coderlazar/Metta-Pet/Tervrajzok/3D összes/préselő mozgatás.png

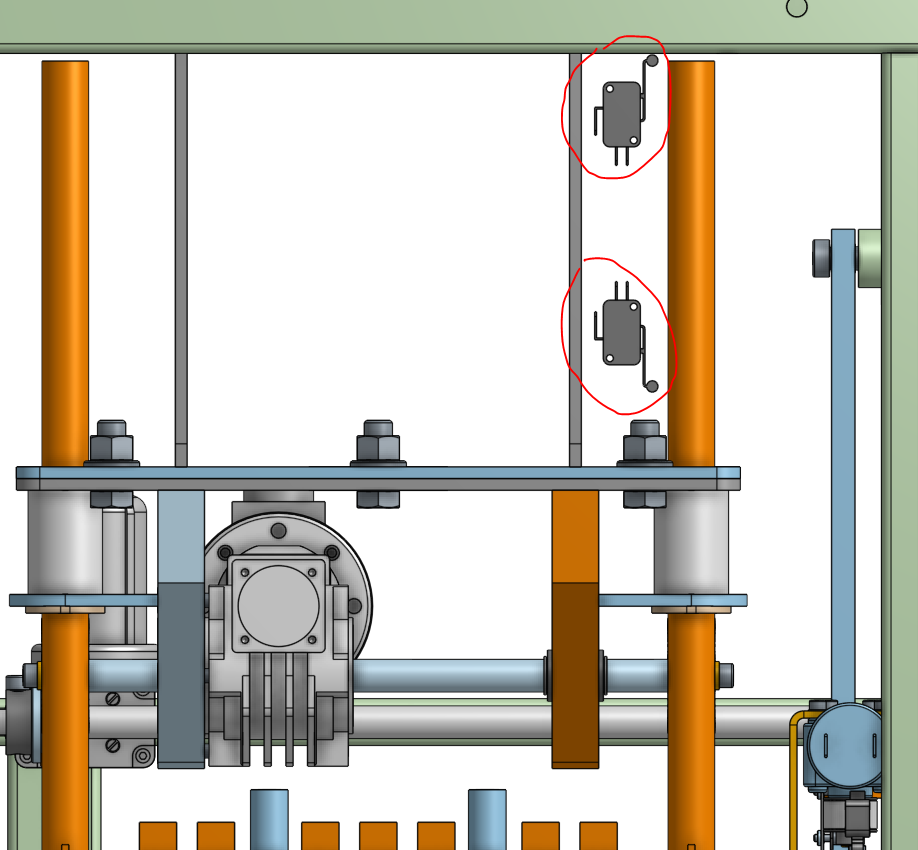
Tervrajzok/3D összes/préselő mozgatás.png
