coderlazar/Metta-Pet/Tervrajzok/külső desygn, animáció/Terv digitális modell.jpg

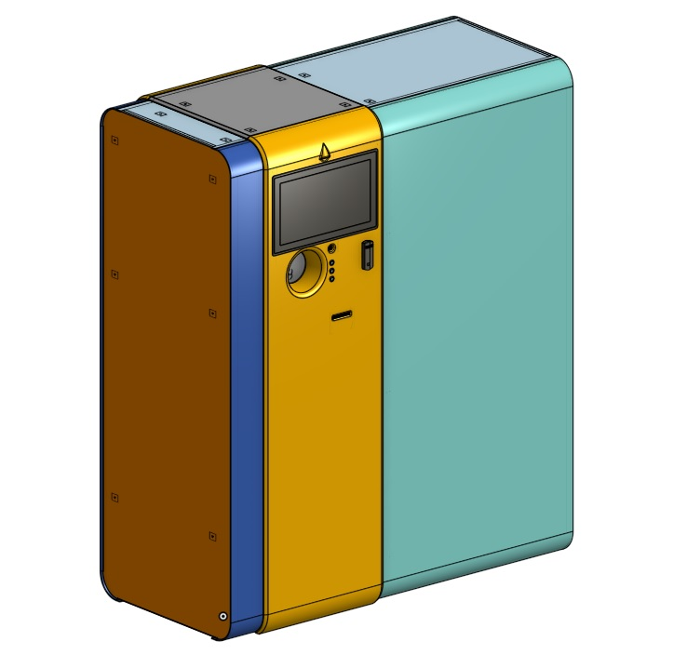
Tervrajzok/külső desygn, animáció/Terv digitális modell.jpg
