coderlazar/Metta-Pet/Tervrajzok/3D összes/petpalackátvevő berendezés digitális terv.docx

https://cad.onshape.com/documents/b69a13354509ceb9c475daa1/v/0fe93e5b4b65e45215f86a12/e/35e4c57dc199d21a8d1f46de
