coderlazar/Metta-Pet/Tervrajzok/módositások/prés perselyezés átdolgozás.pdf

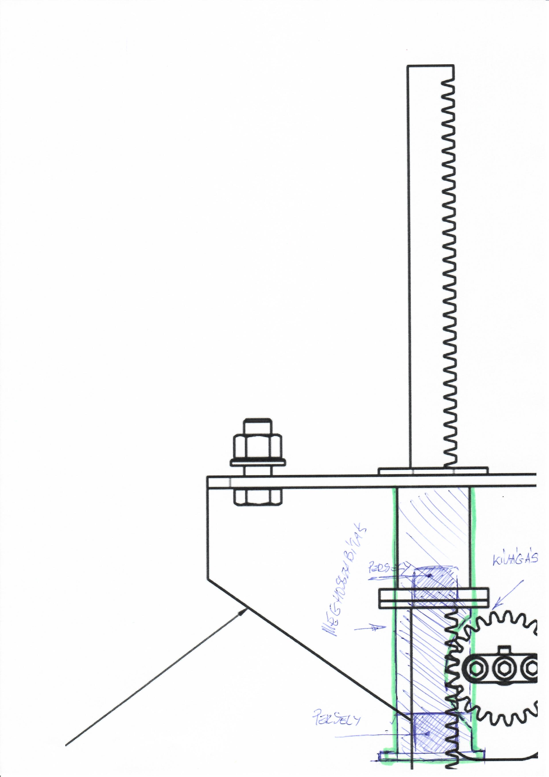
[picture p4: page 1]
