coderlazar/Metta-Pet/Tervrajzok/külső desygn, animáció/külső méretek lárványtervhez.pdf

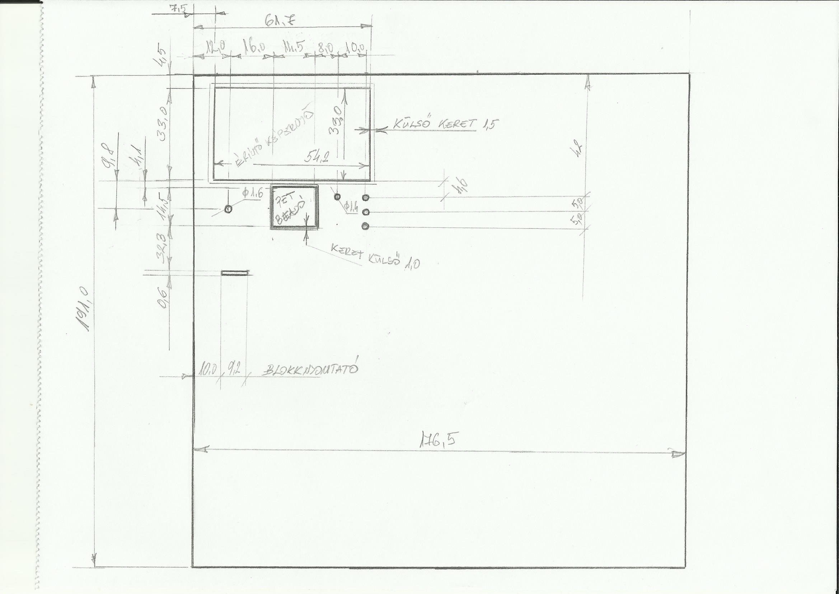
[picture p5: page 1]
