coderlazar/Metta-Pet/Tervrajzok/külső desygn, animáció/mettapet_valtozatok logo és gépmegjelenés.pdf

# METTA PET

# logo + grakai megjelenés

# logo változat 01

metta pet | metta pet | metta pet

metta pet | metta pet | metta pet

metta pet | metta pet | metta pet

# metta p e t

# metta p e t

# metta p e t

e | e | e | e | e | e

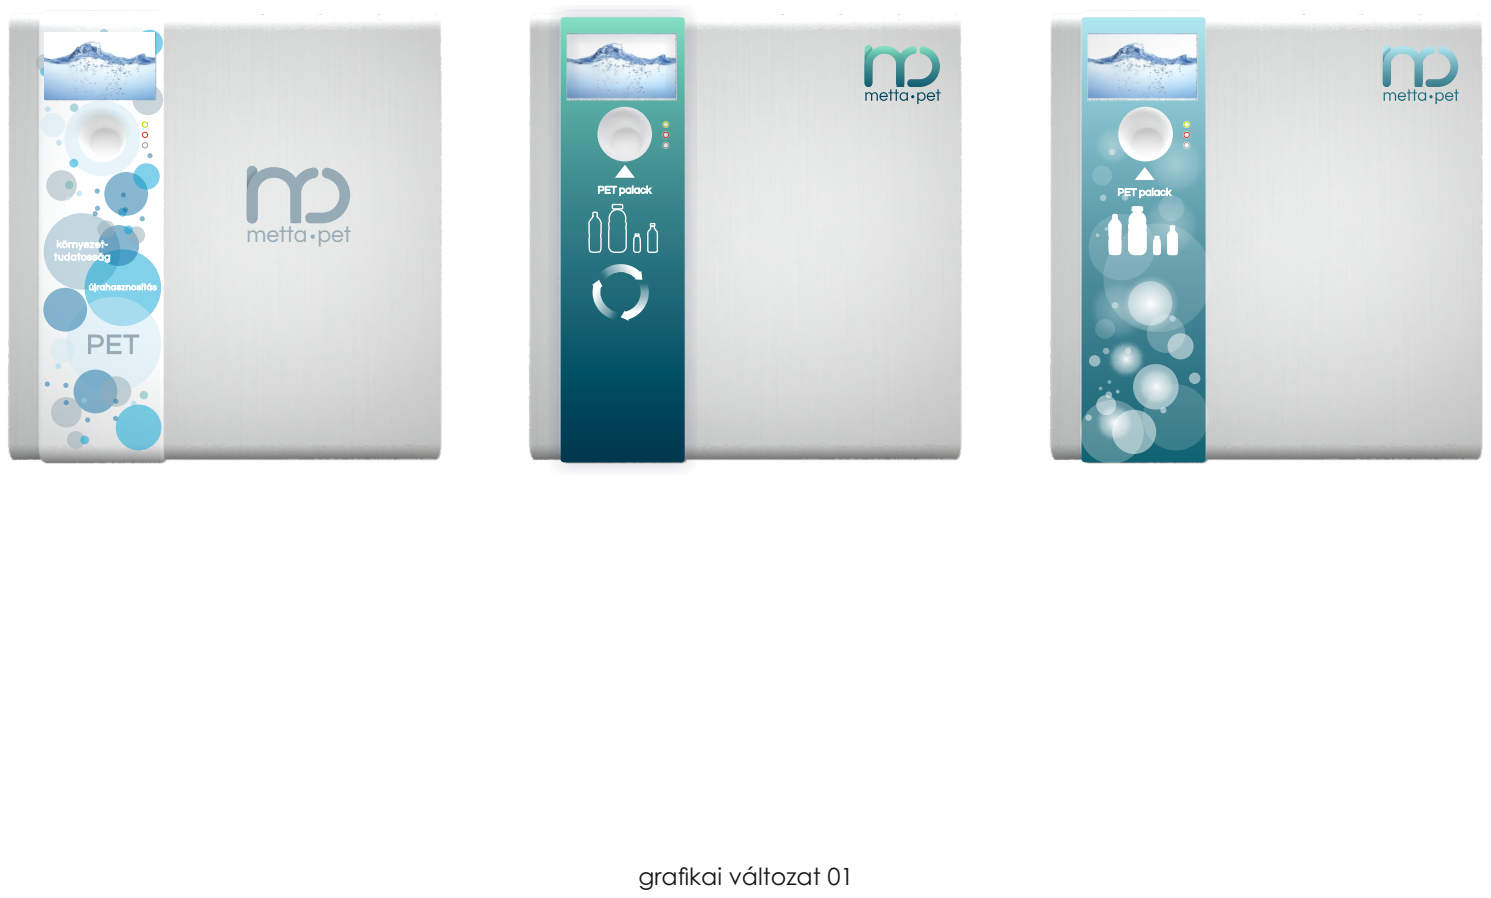
[picture p6: page 7]
PET palack; újrahasznosítás; PET; környezet- tudatosság; metta pet

grakai változat 01

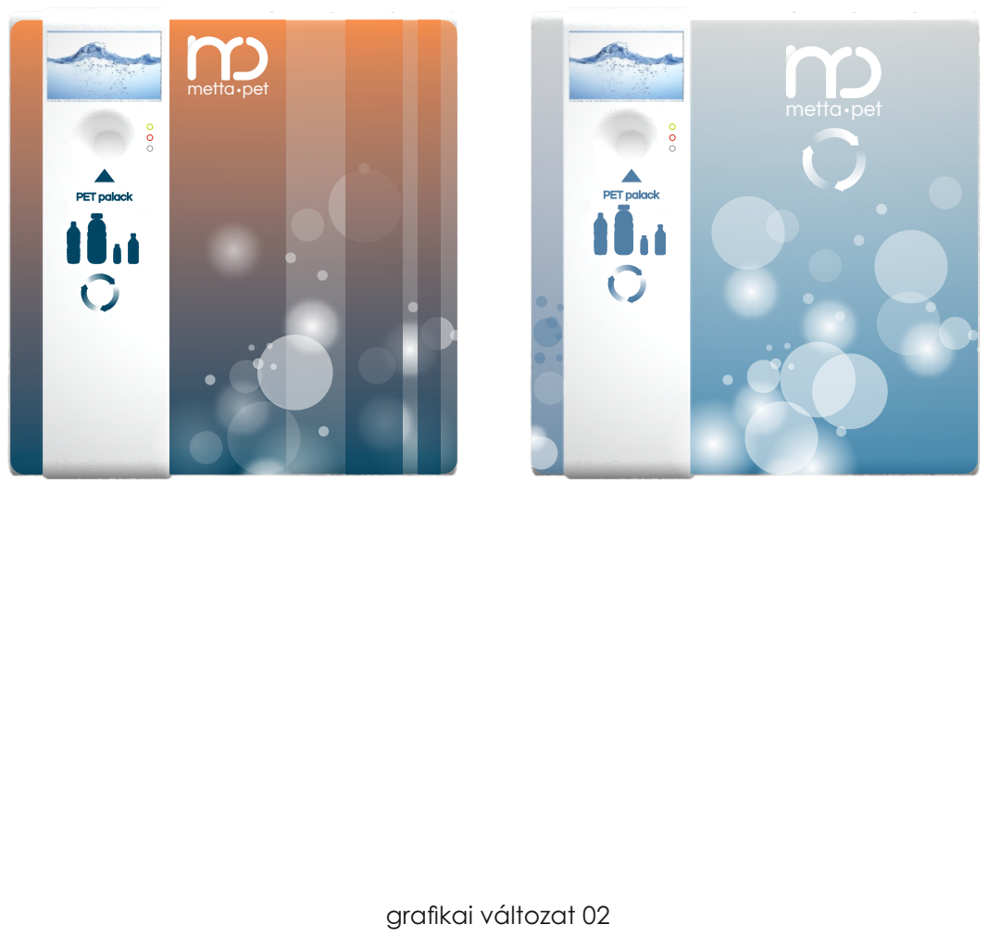
[picture p7: page 8]
PET palack; metta pet

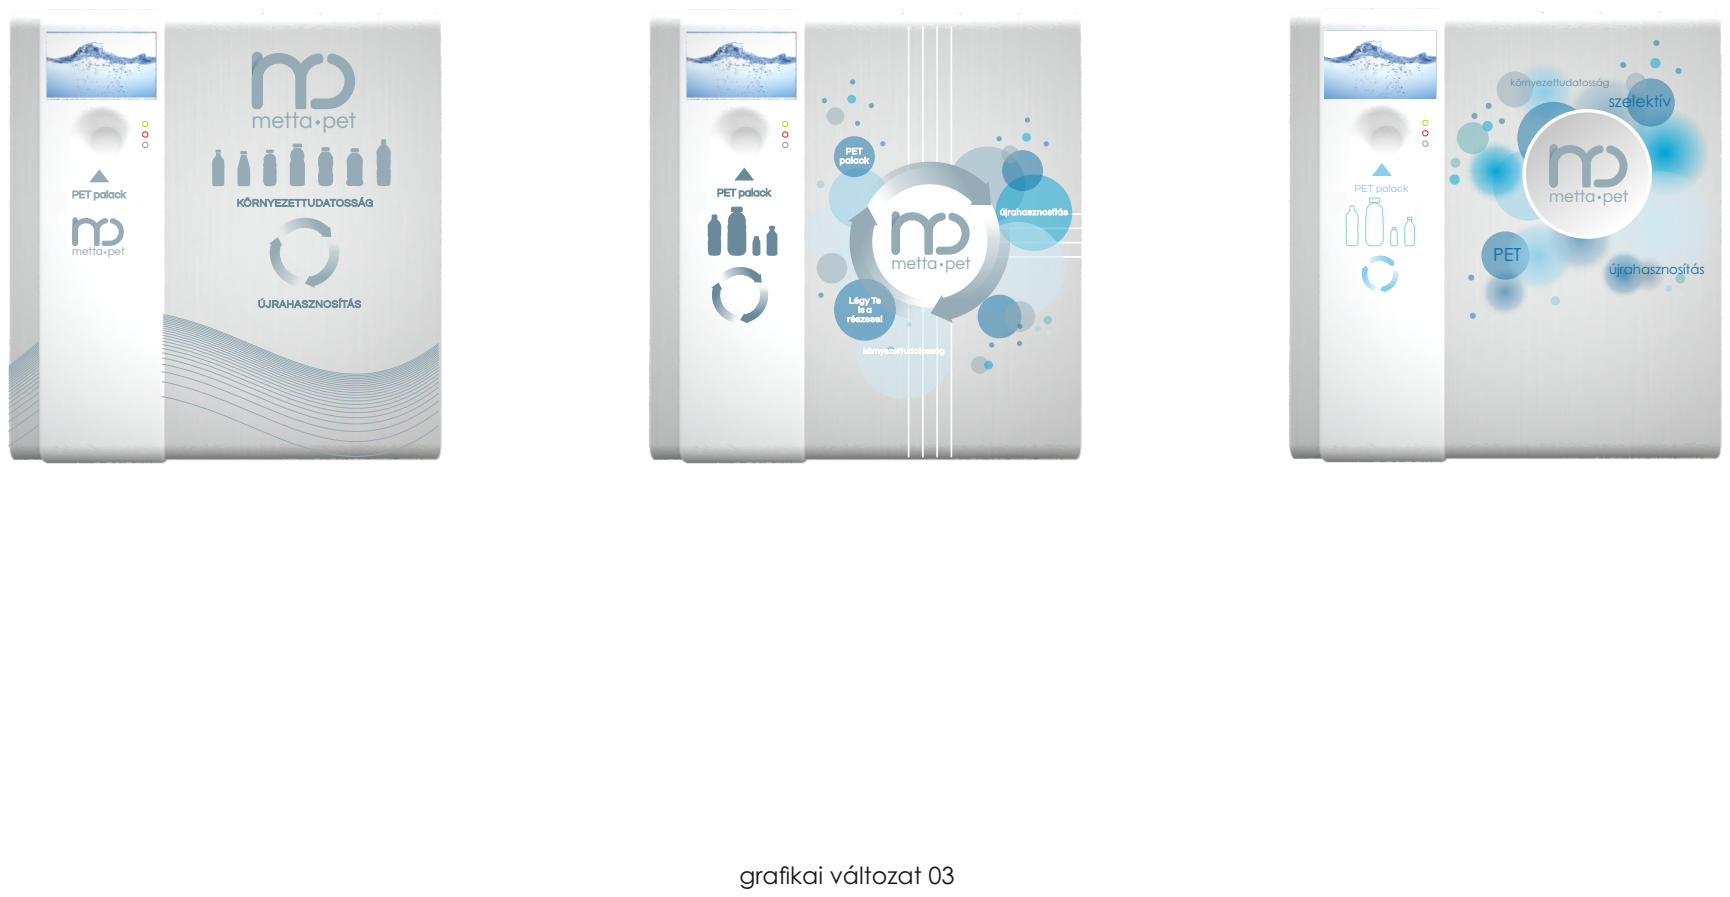
[picture p8: page 9]
KÖRNYEZETTUDATOSSÁG; ÚJRAHASZNOSÍTÁS; metta pet; PET palack; újrahasznosítás; környezettudatosság; Légy Te is a részese!; metta; pet; PET; környezettudatosság szelektív

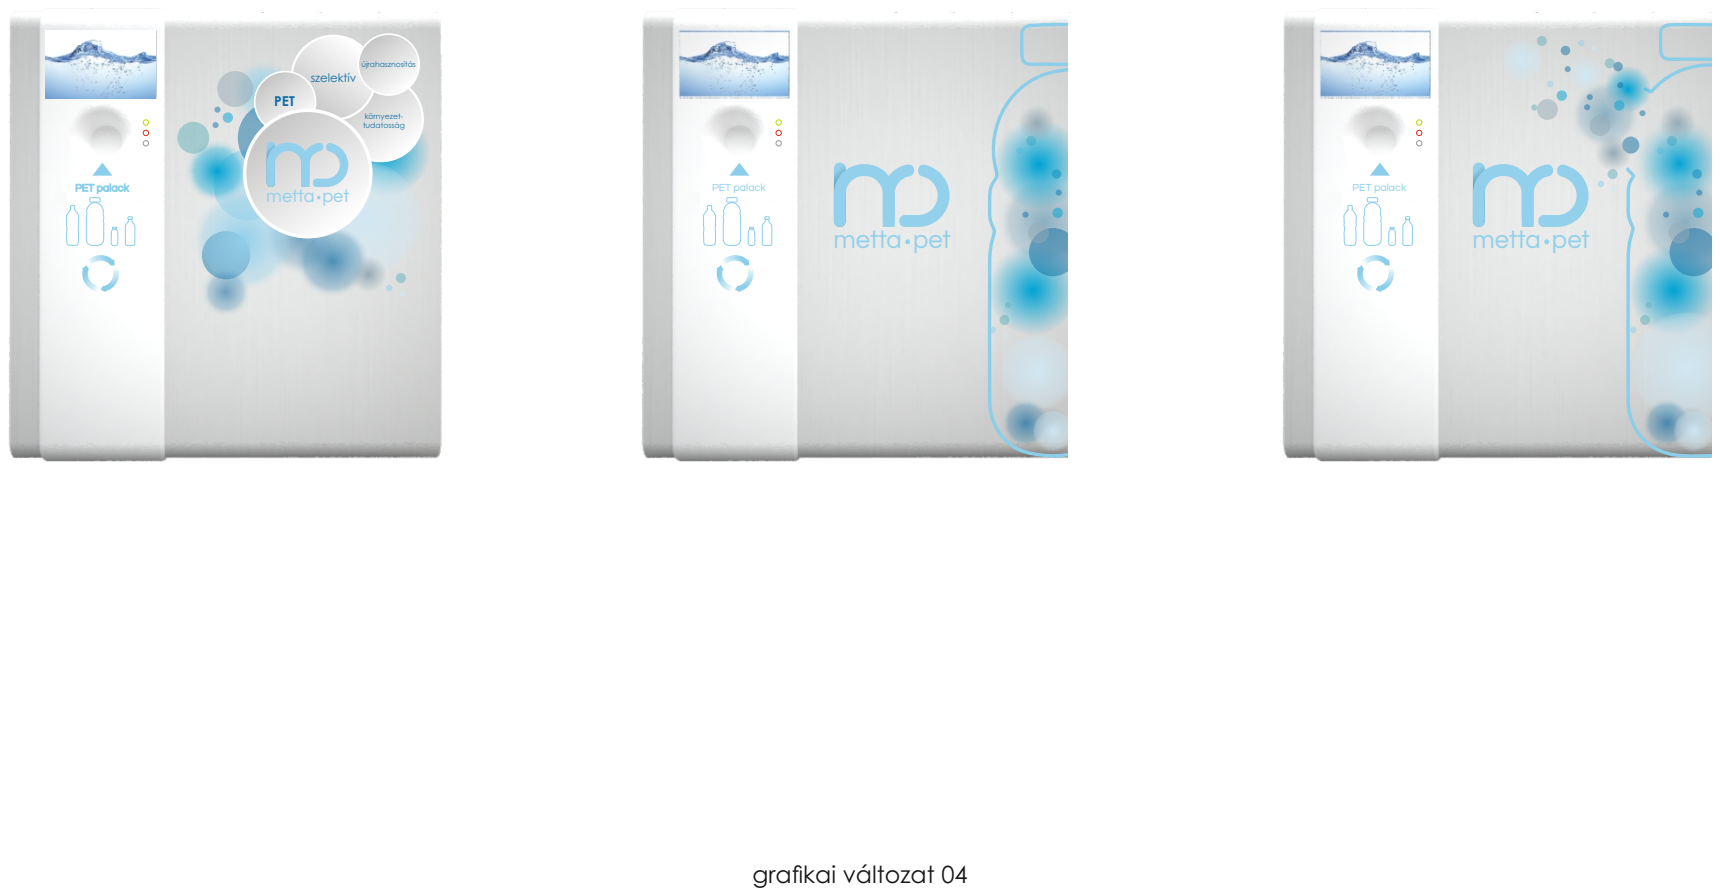
[picture p9: page 10]
PET palack; metta pet; újrahasznosítás; PET; környezet- tudatosság; szelektív

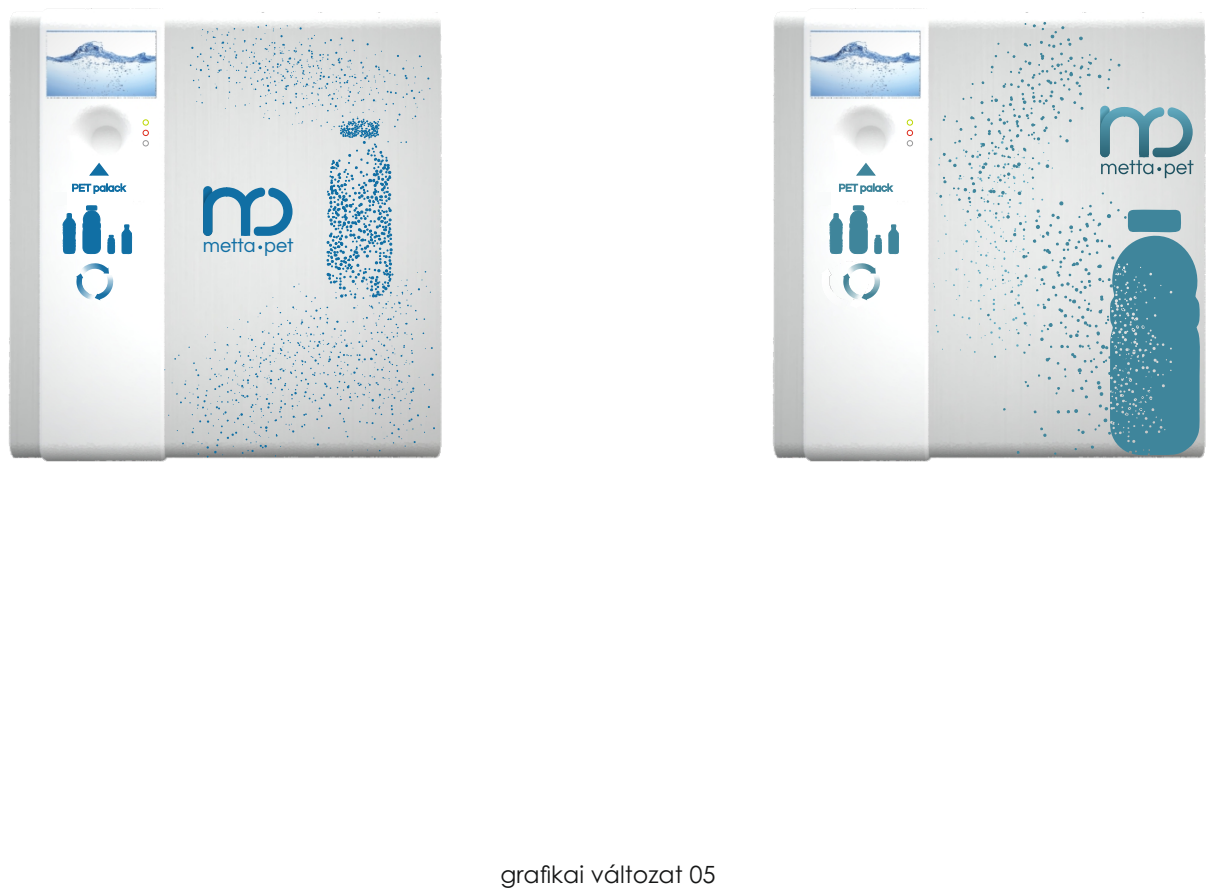
[picture p10: page 11]
metta pet; PET palack
