coderlazar/Metta-Pet/Tervrajzok/00 tervrajzok burkolatok/minta_gepuzemnaplo.png

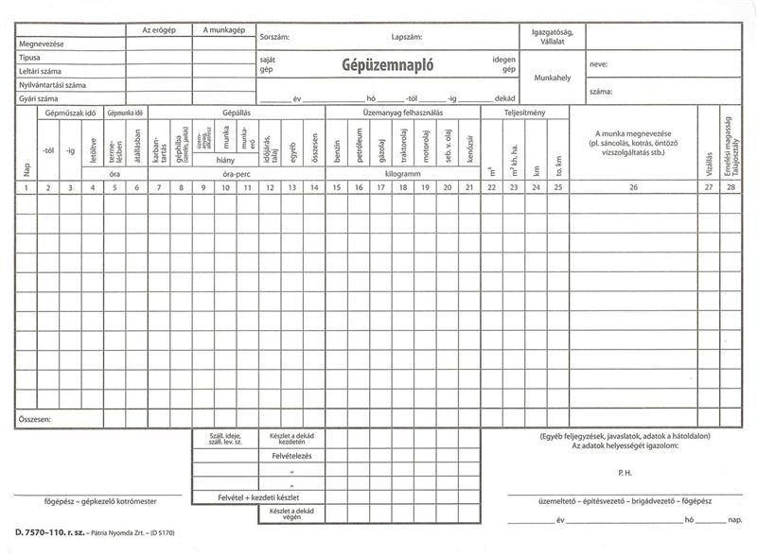
Tervrajzok/00 tervrajzok burkolatok/minta_gepuzemnaplo.png
