coderlazar/Metta-Pet/Tervrajzok/3D összes/A préselő talp ellenállásait így kellene elosztani a felületen.png

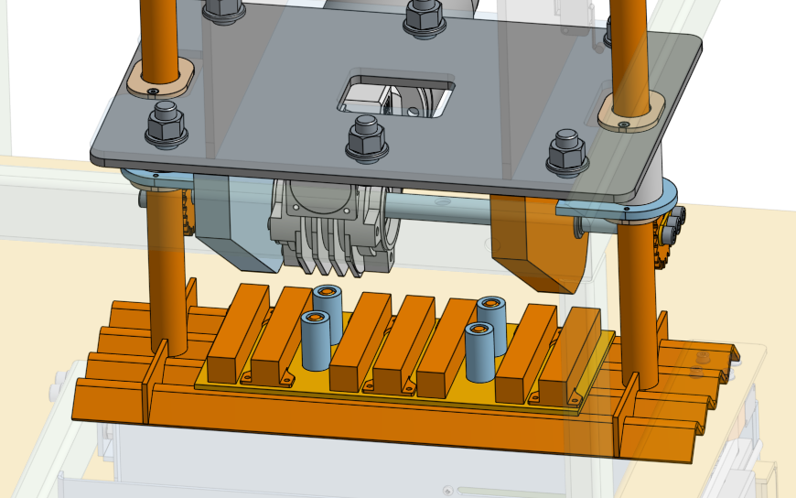
Tervrajzok/3D összes/A préselő talp ellenállásait így kellene elosztani a felületen.png
