coderlazar/Metta-Pet/Tervrajzok/3D összes/ajtó mozgatás.png

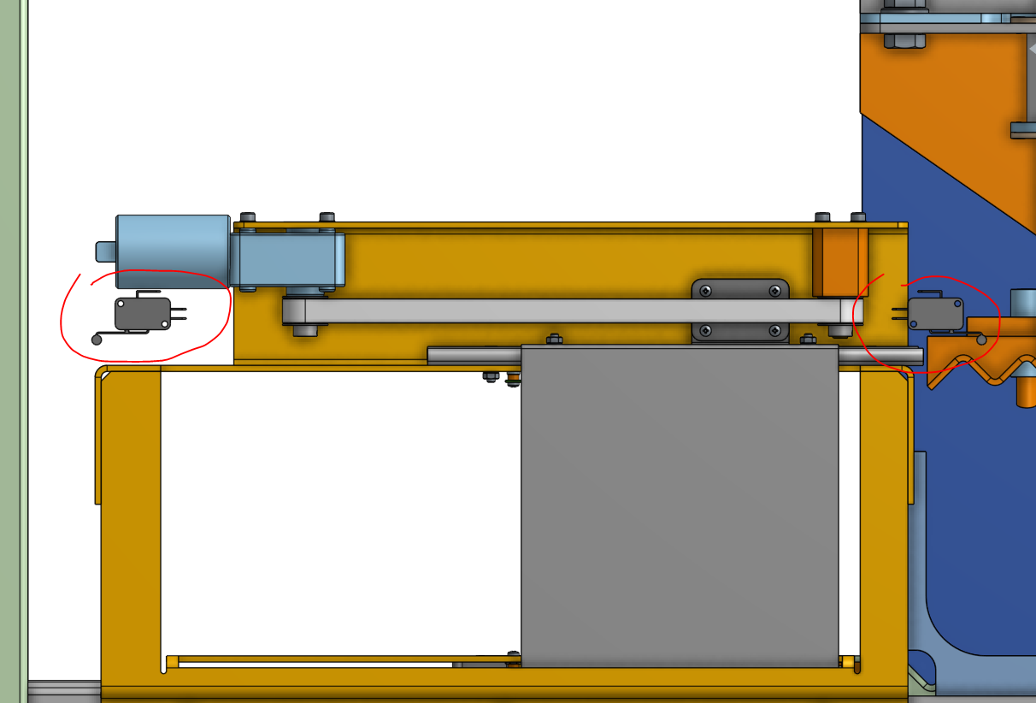
Tervrajzok/3D összes/ajtó mozgatás.png
