coderlazar/Metta-Pet/Tervrajzok/3D összes/beadó ajtó körüli végálláskapcsolós konzol.png

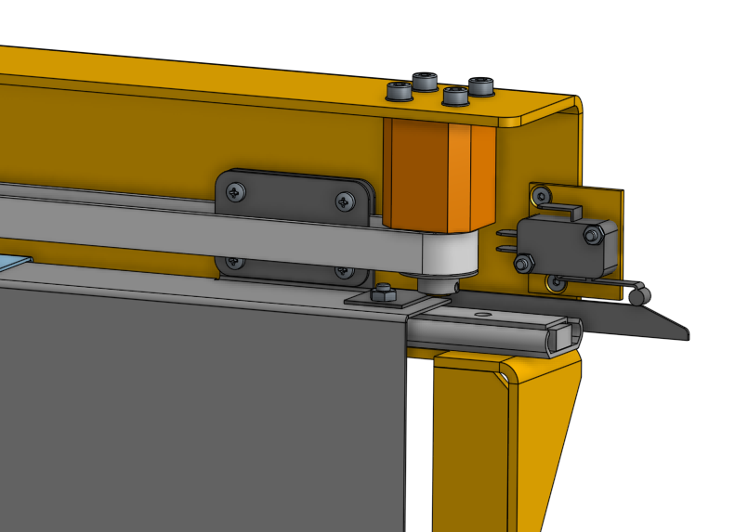
Tervrajzok/3D összes/beadó ajtó körüli végálláskapcsolós konzol.png
