coderlazar/Metta-Pet/Tervrajzok/3D összes/mikrokapcsolók elhelyezése.png

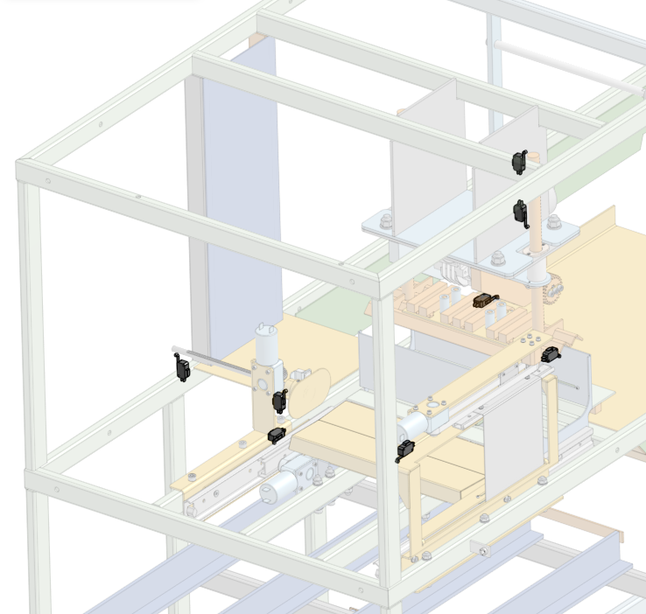
Tervrajzok/3D összes/mikrokapcsolók elhelyezése.png
