coderlazar/Metta-Pet/Tervrajzok/3D összes/palack hossz és sulymérő.png

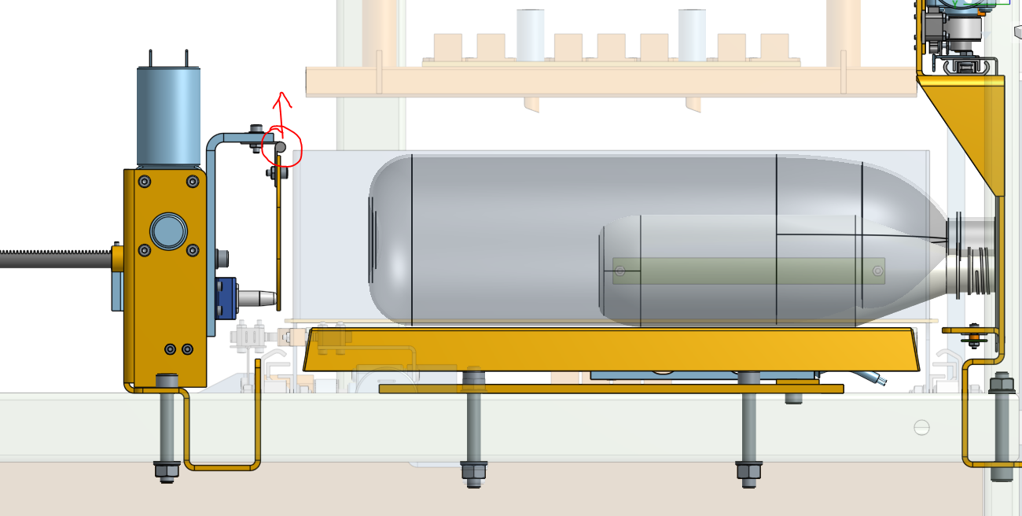
Tervrajzok/3D összes/palack hossz és sulymérő.png
