coderlazar/Metta-Pet/Tervrajzok/3D összes/palack mozgató kocsi előlnézet.png

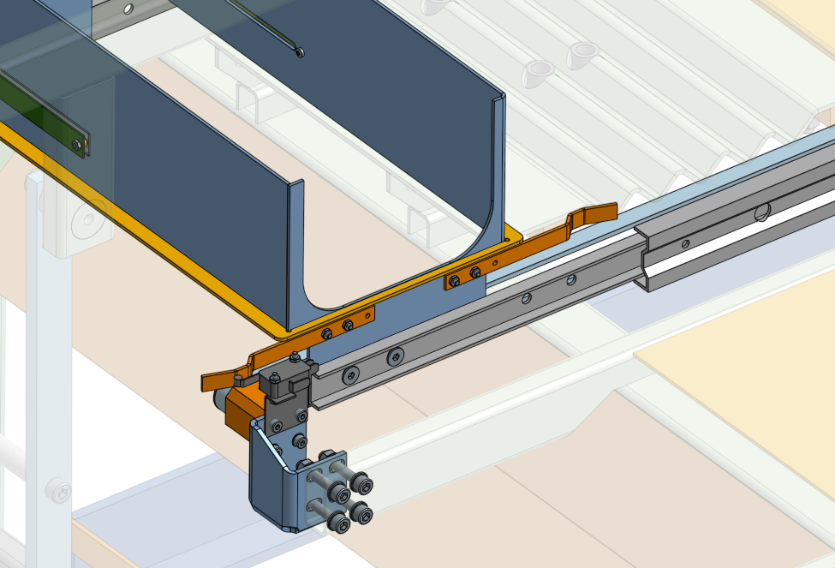
Tervrajzok/3D összes/palack mozgató kocsi előlnézet.png
