coderlazar/Metta-Pet/Tervrajzok/3D összes/palack mozgató kocsi sinek kialakítása.png

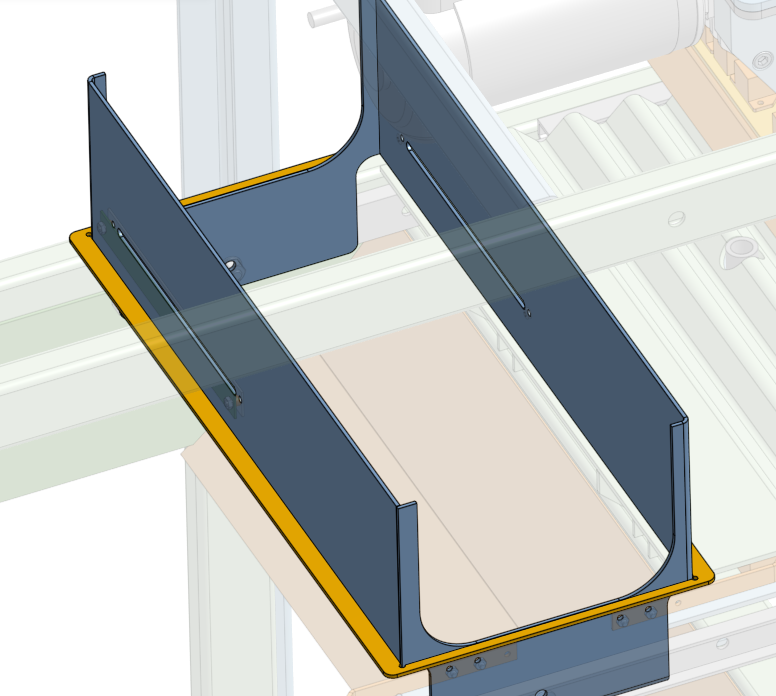
Tervrajzok/3D összes/palack mozgató kocsi sinek kialakítása.png
