coderlazar/Metta-Pet/Tervrajzok/3D összes/palack mozgató kocsi.png

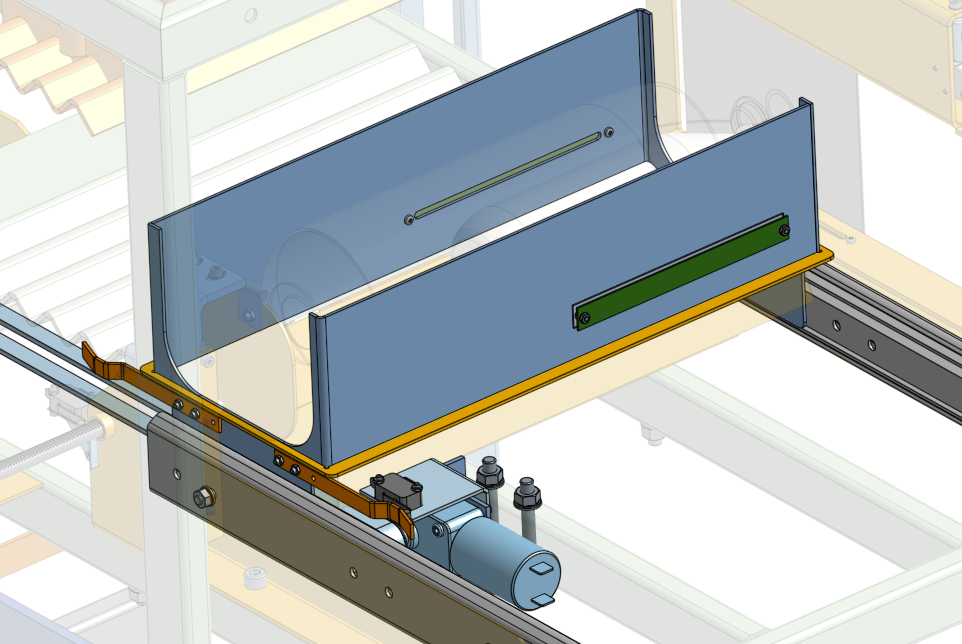
Tervrajzok/3D összes/palack mozgató kocsi.png
