coderlazar/Metta-Pet/Tervrajzok/3D összes/palackhossz mérés mozgatás.png

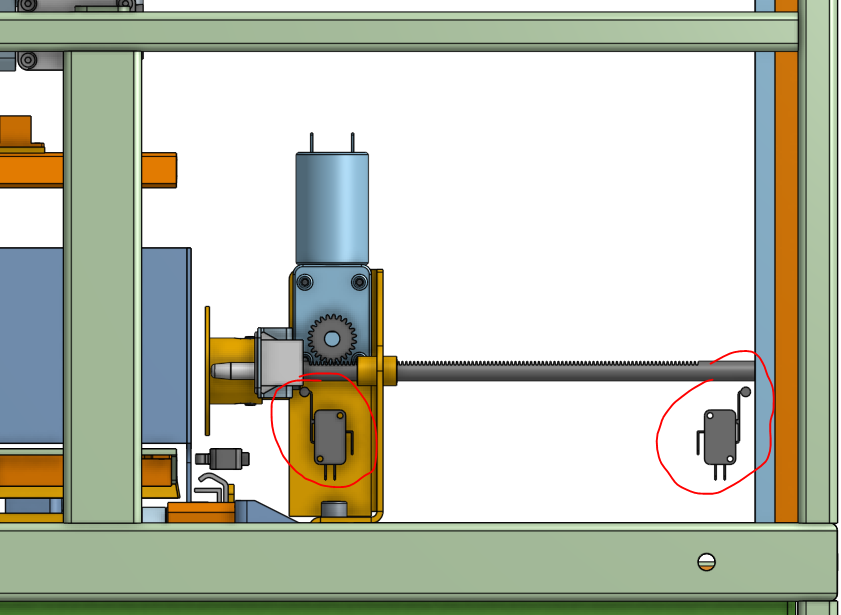
Tervrajzok/3D összes/palackhossz mérés mozgatás.png
