coderlazar/Metta-Pet/Tervrajzok/3D összes/palackhossz mérő egység.png

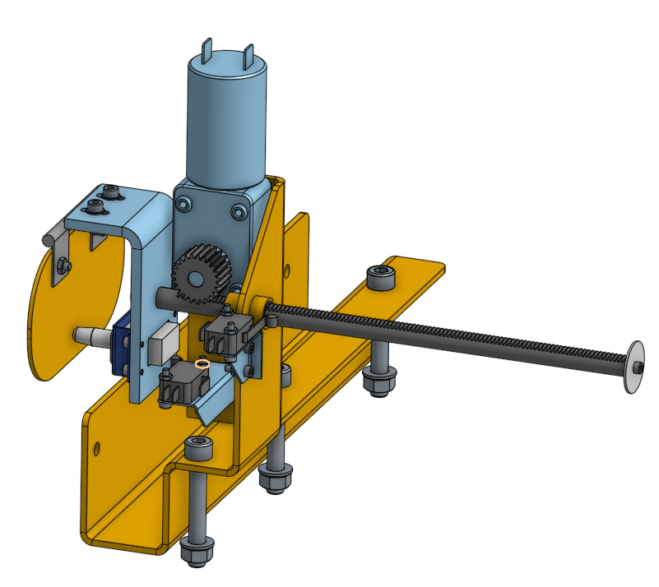
Tervrajzok/3D összes/palackhossz mérő egység.png
