coderlazar/Metta-Pet/Tervrajzok/3D összes/préselő egységhez szükséges végálláskapcsolók konzolját.png

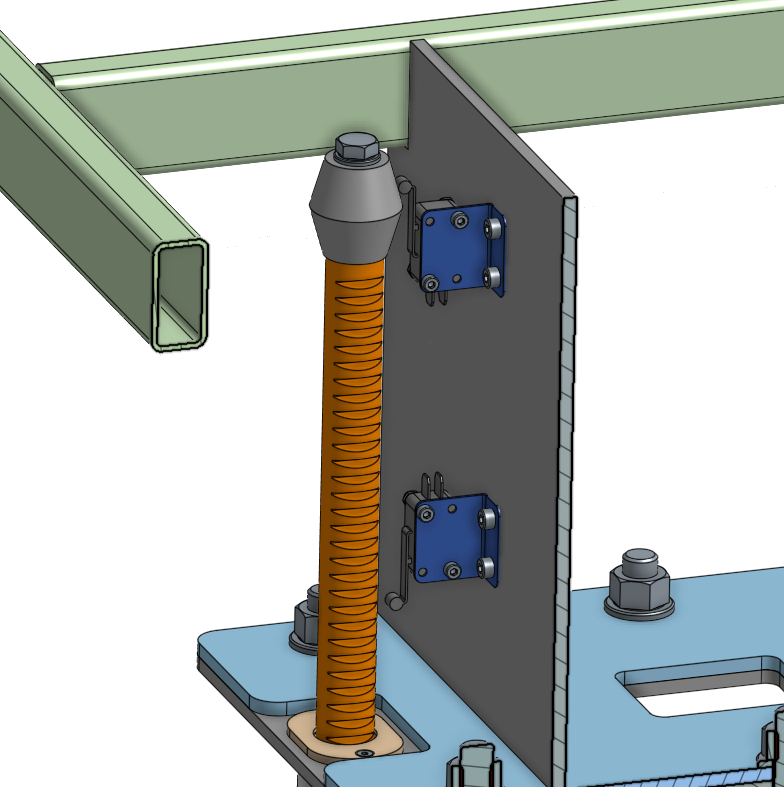
Tervrajzok/3D összes/préselő egységhez szükséges végálláskapcsolók konzolját.png
