coderlazar/Metta-Pet/Tervrajzok/3D összes/tálca mozgatás.png

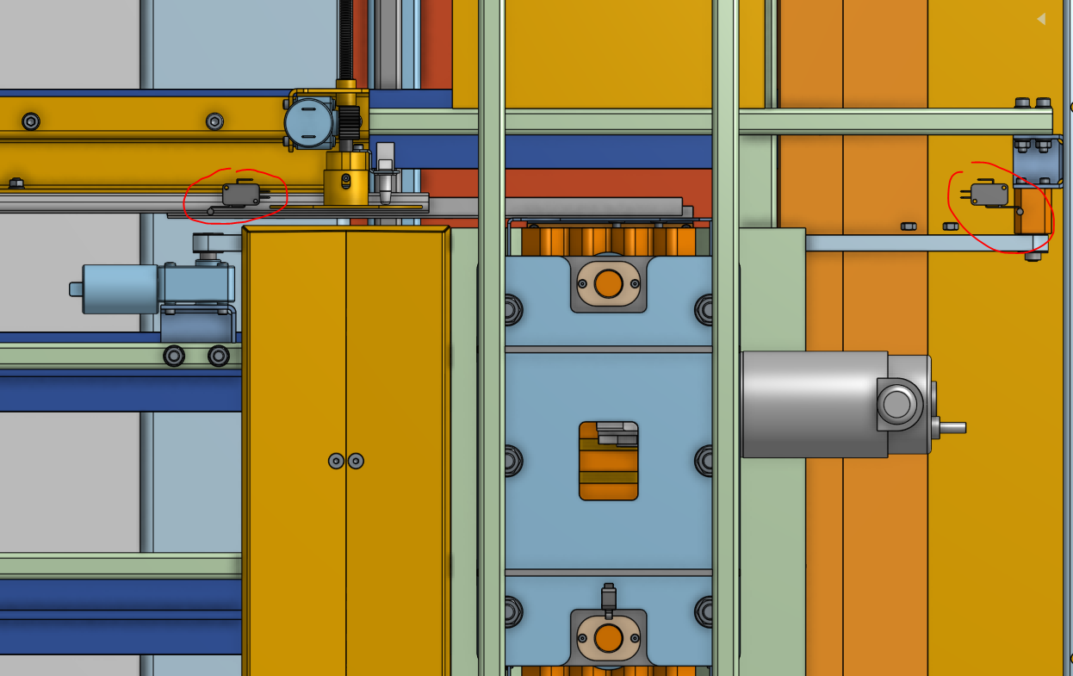
Tervrajzok/3D összes/tálca mozgatás.png
