coderlazar/Metta-Pet/Tervrajzok/külső desygn, animáció/mevalósult kinézet külső váz.jpg

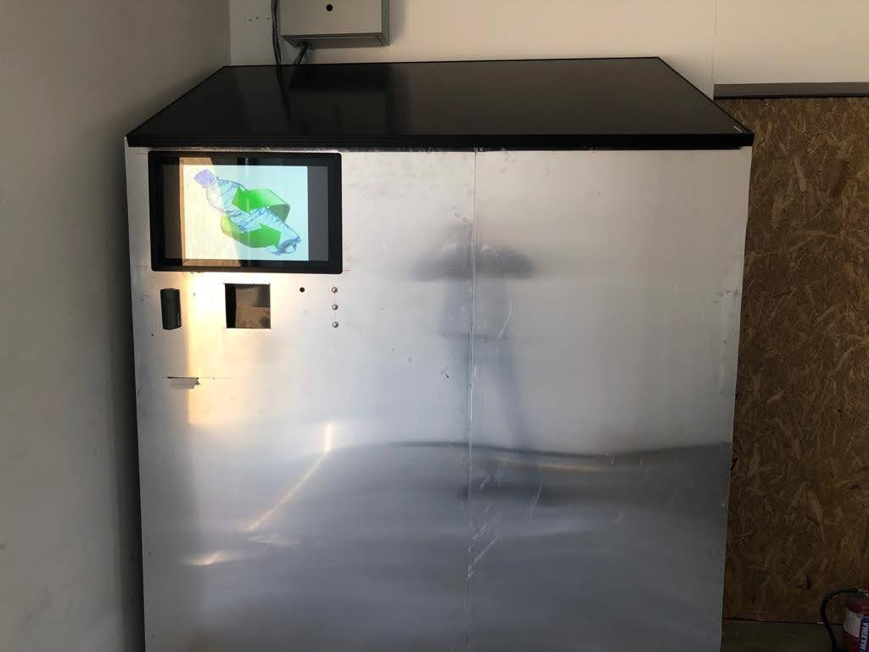
Tervrajzok/külső desygn, animáció/mevalósult kinézet külső váz.jpg
