coderlazar/Metta-Pet/Tervrajzok/külső desygn, animáció/Terv digitális előnézet.jpg

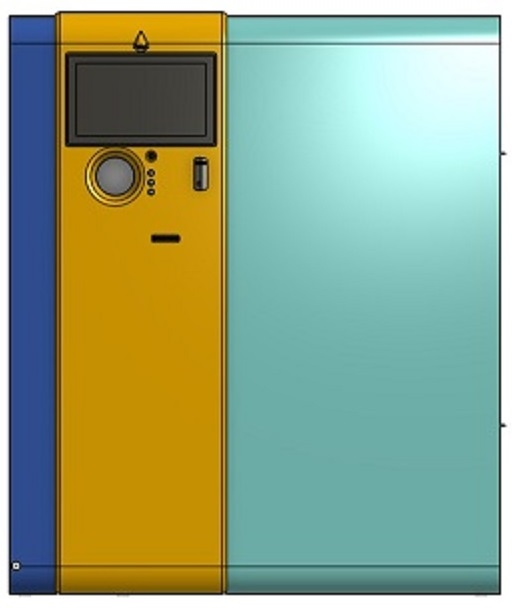
Tervrajzok/külső desygn, animáció/Terv digitális előnézet.jpg
