coderlazar/Metta-Pet/Tervrajzok/elhajlított alkatrészek/P18101-1120-001_hossz_ellenorzo_konzol_lemez.pdf

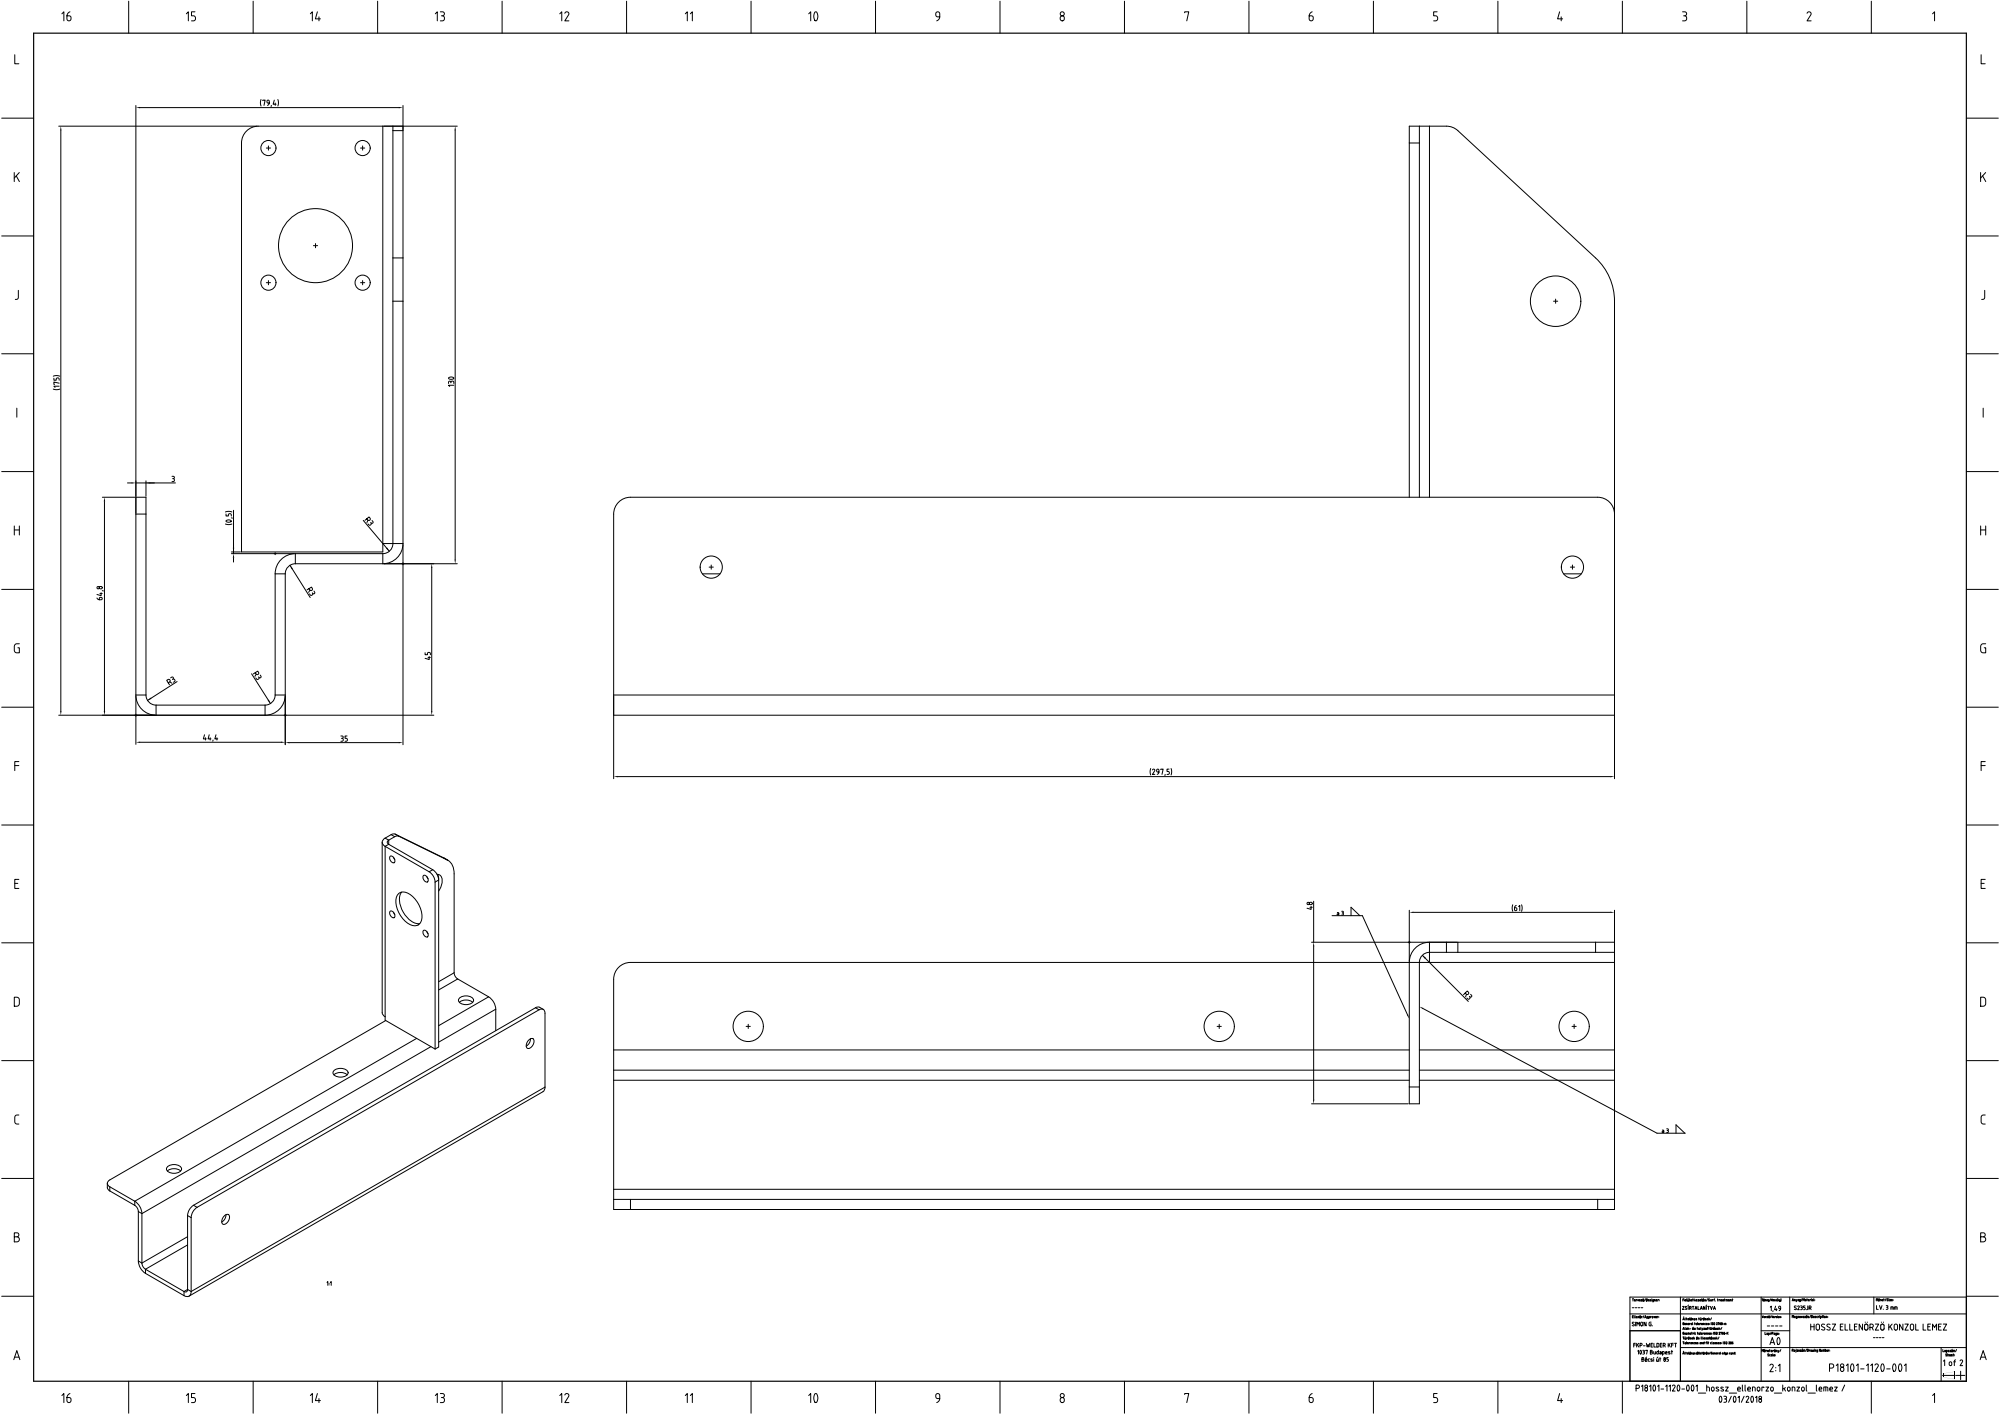
[picture p28: page 1]
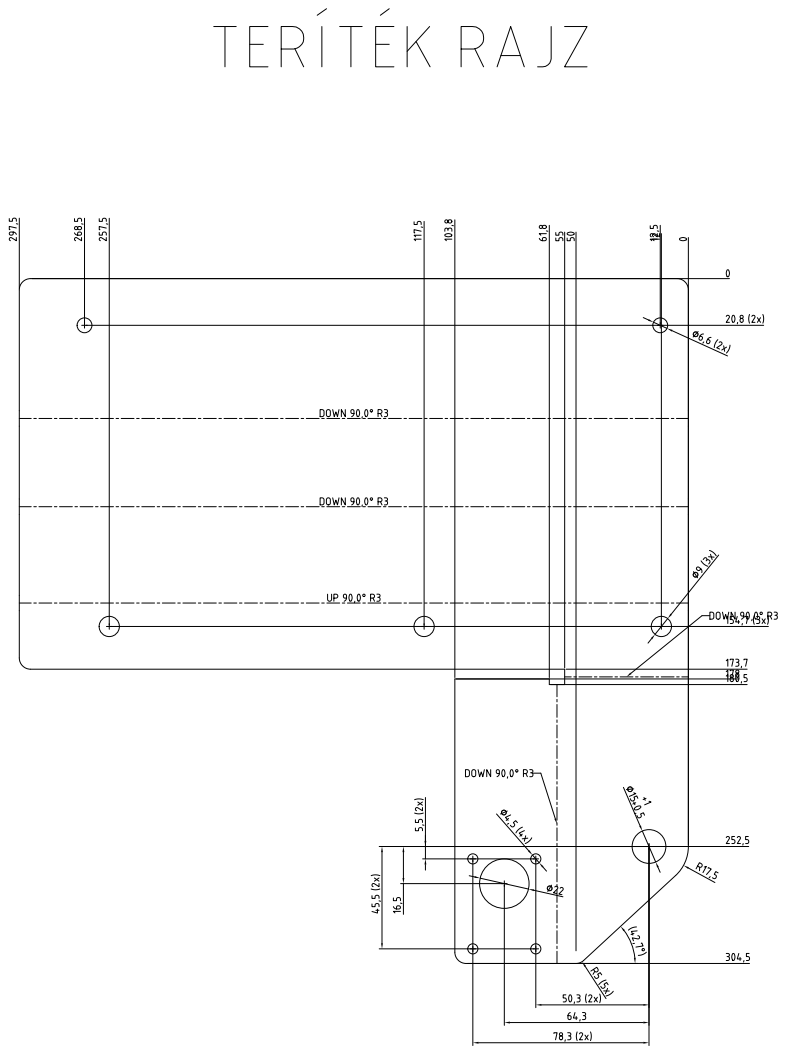
[picture p29: page 2]
