coderlazar/Metta-Pet/Tervrajzok/elhajlított alkatrészek/P18101-1310-001_beado_nyilas_also_resz.pdf

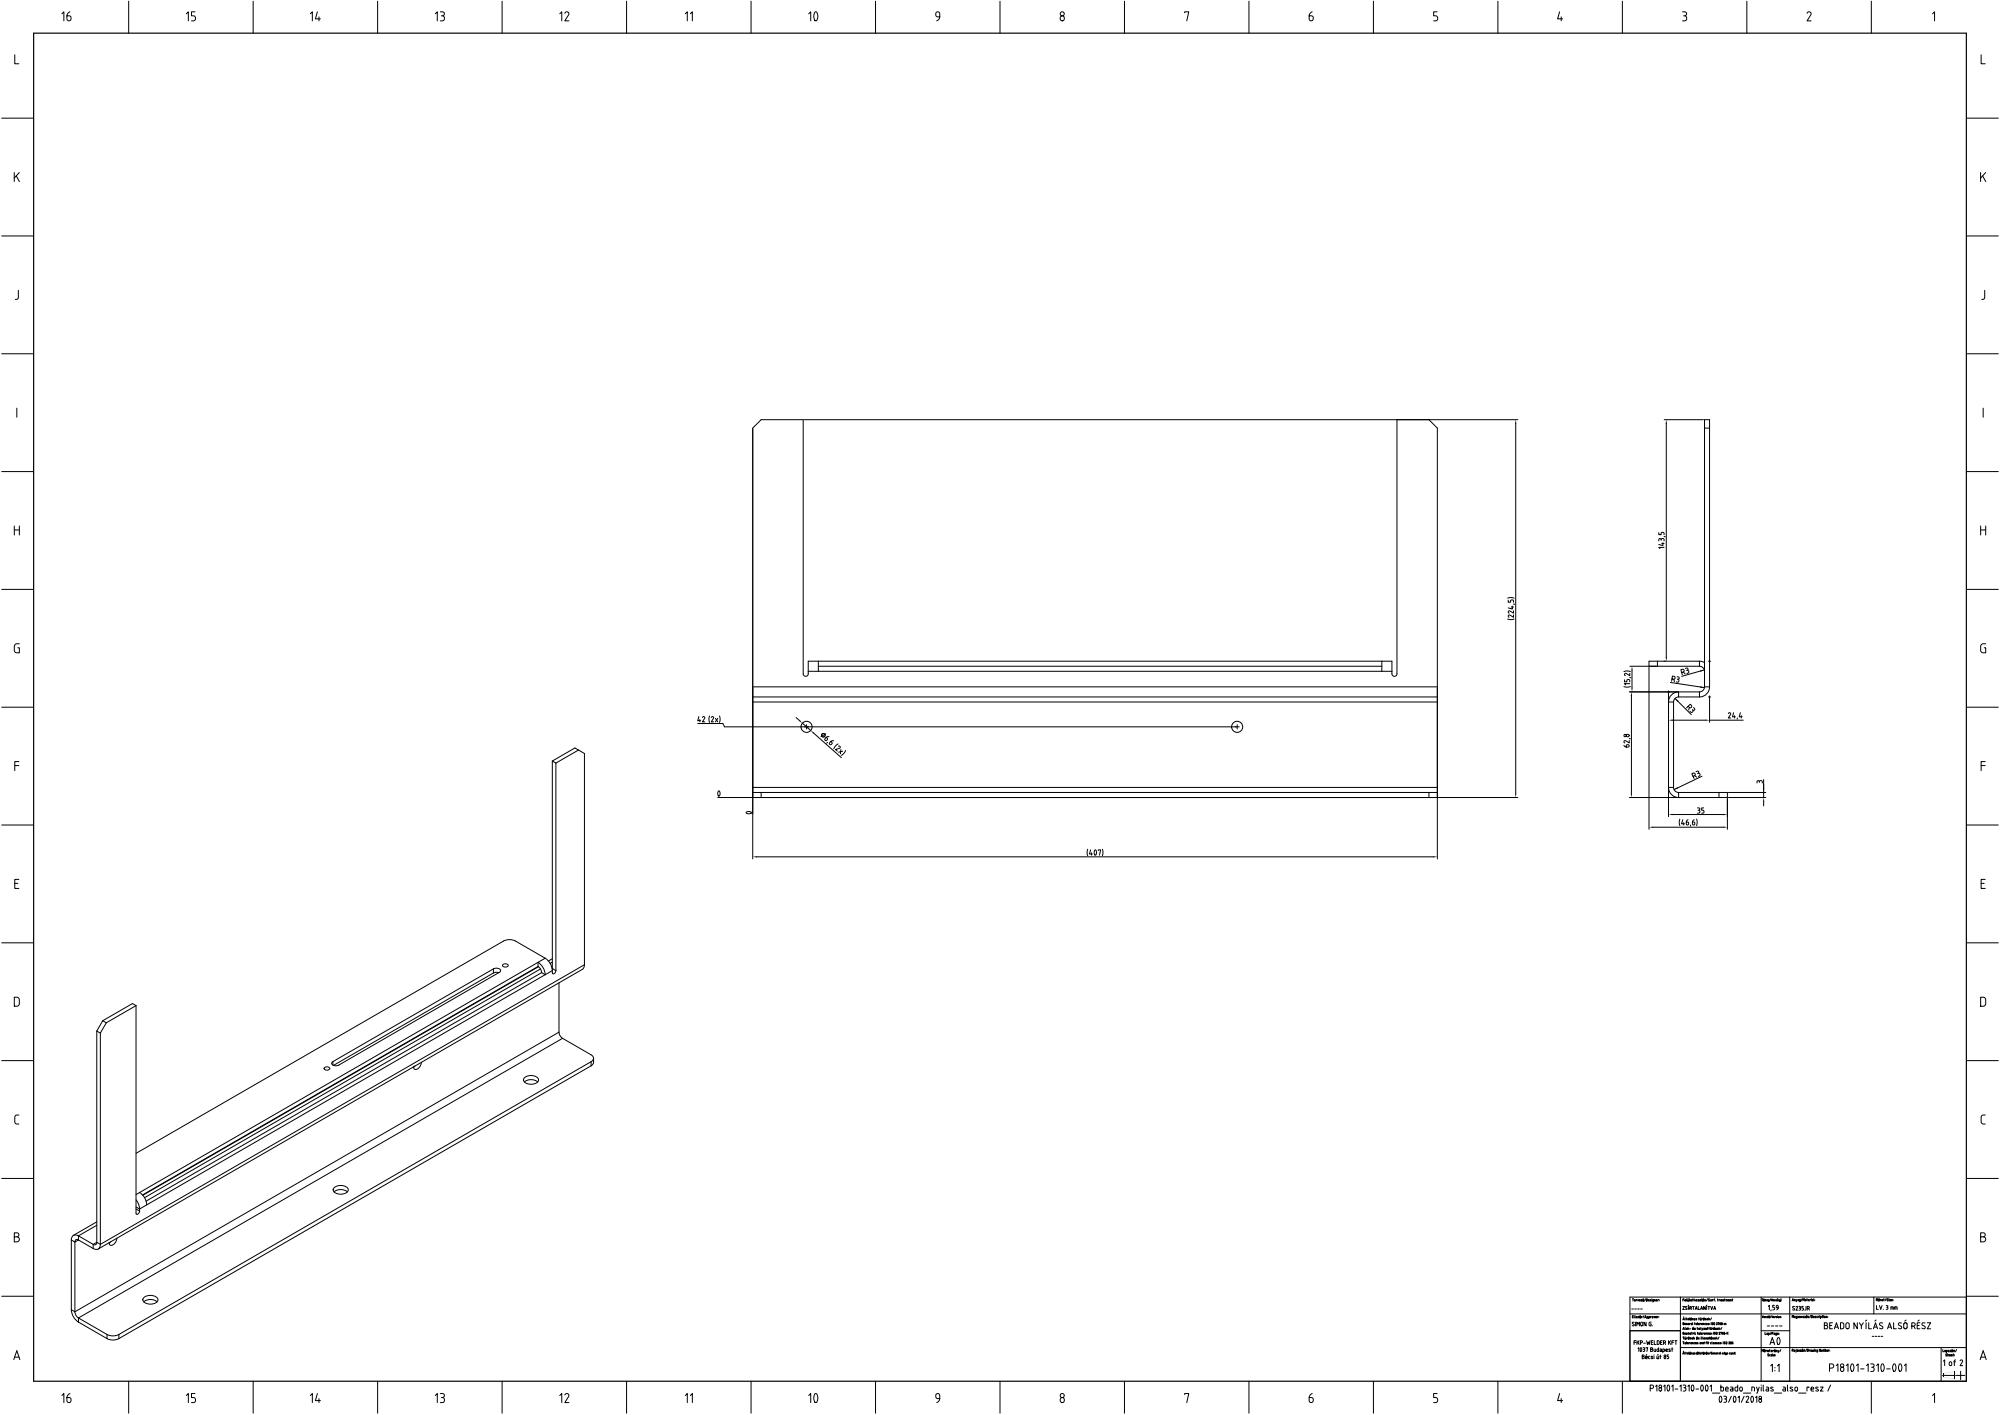
[picture p30: page 1]
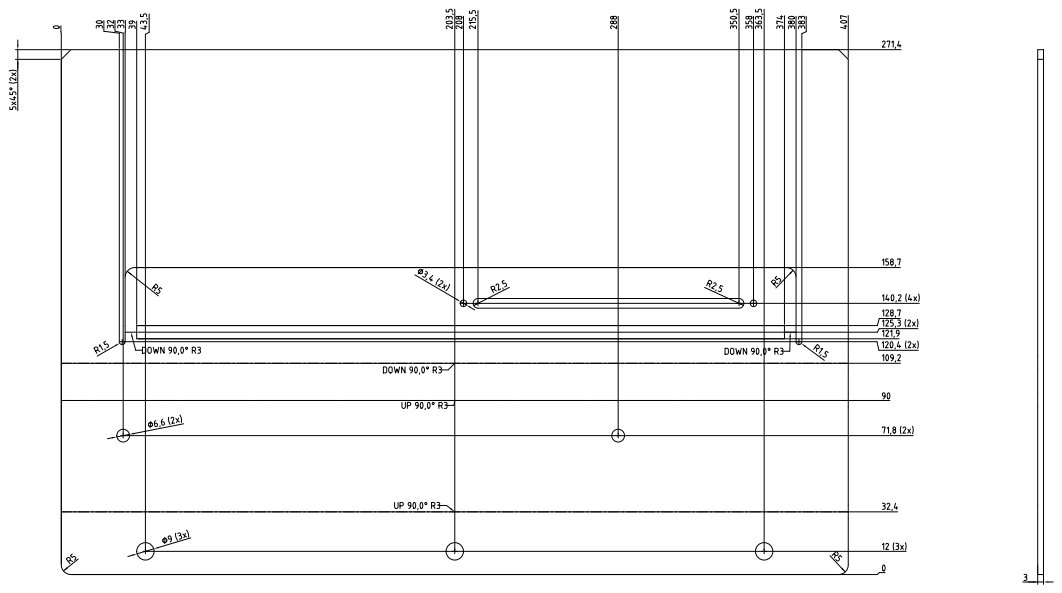
[picture p31: page 2]
