coderlazar/Metta-Pet/Tervrajzok/elhajlított alkatrészek/P18101-1310-002_beado_nyilas_felso_resz.pdf

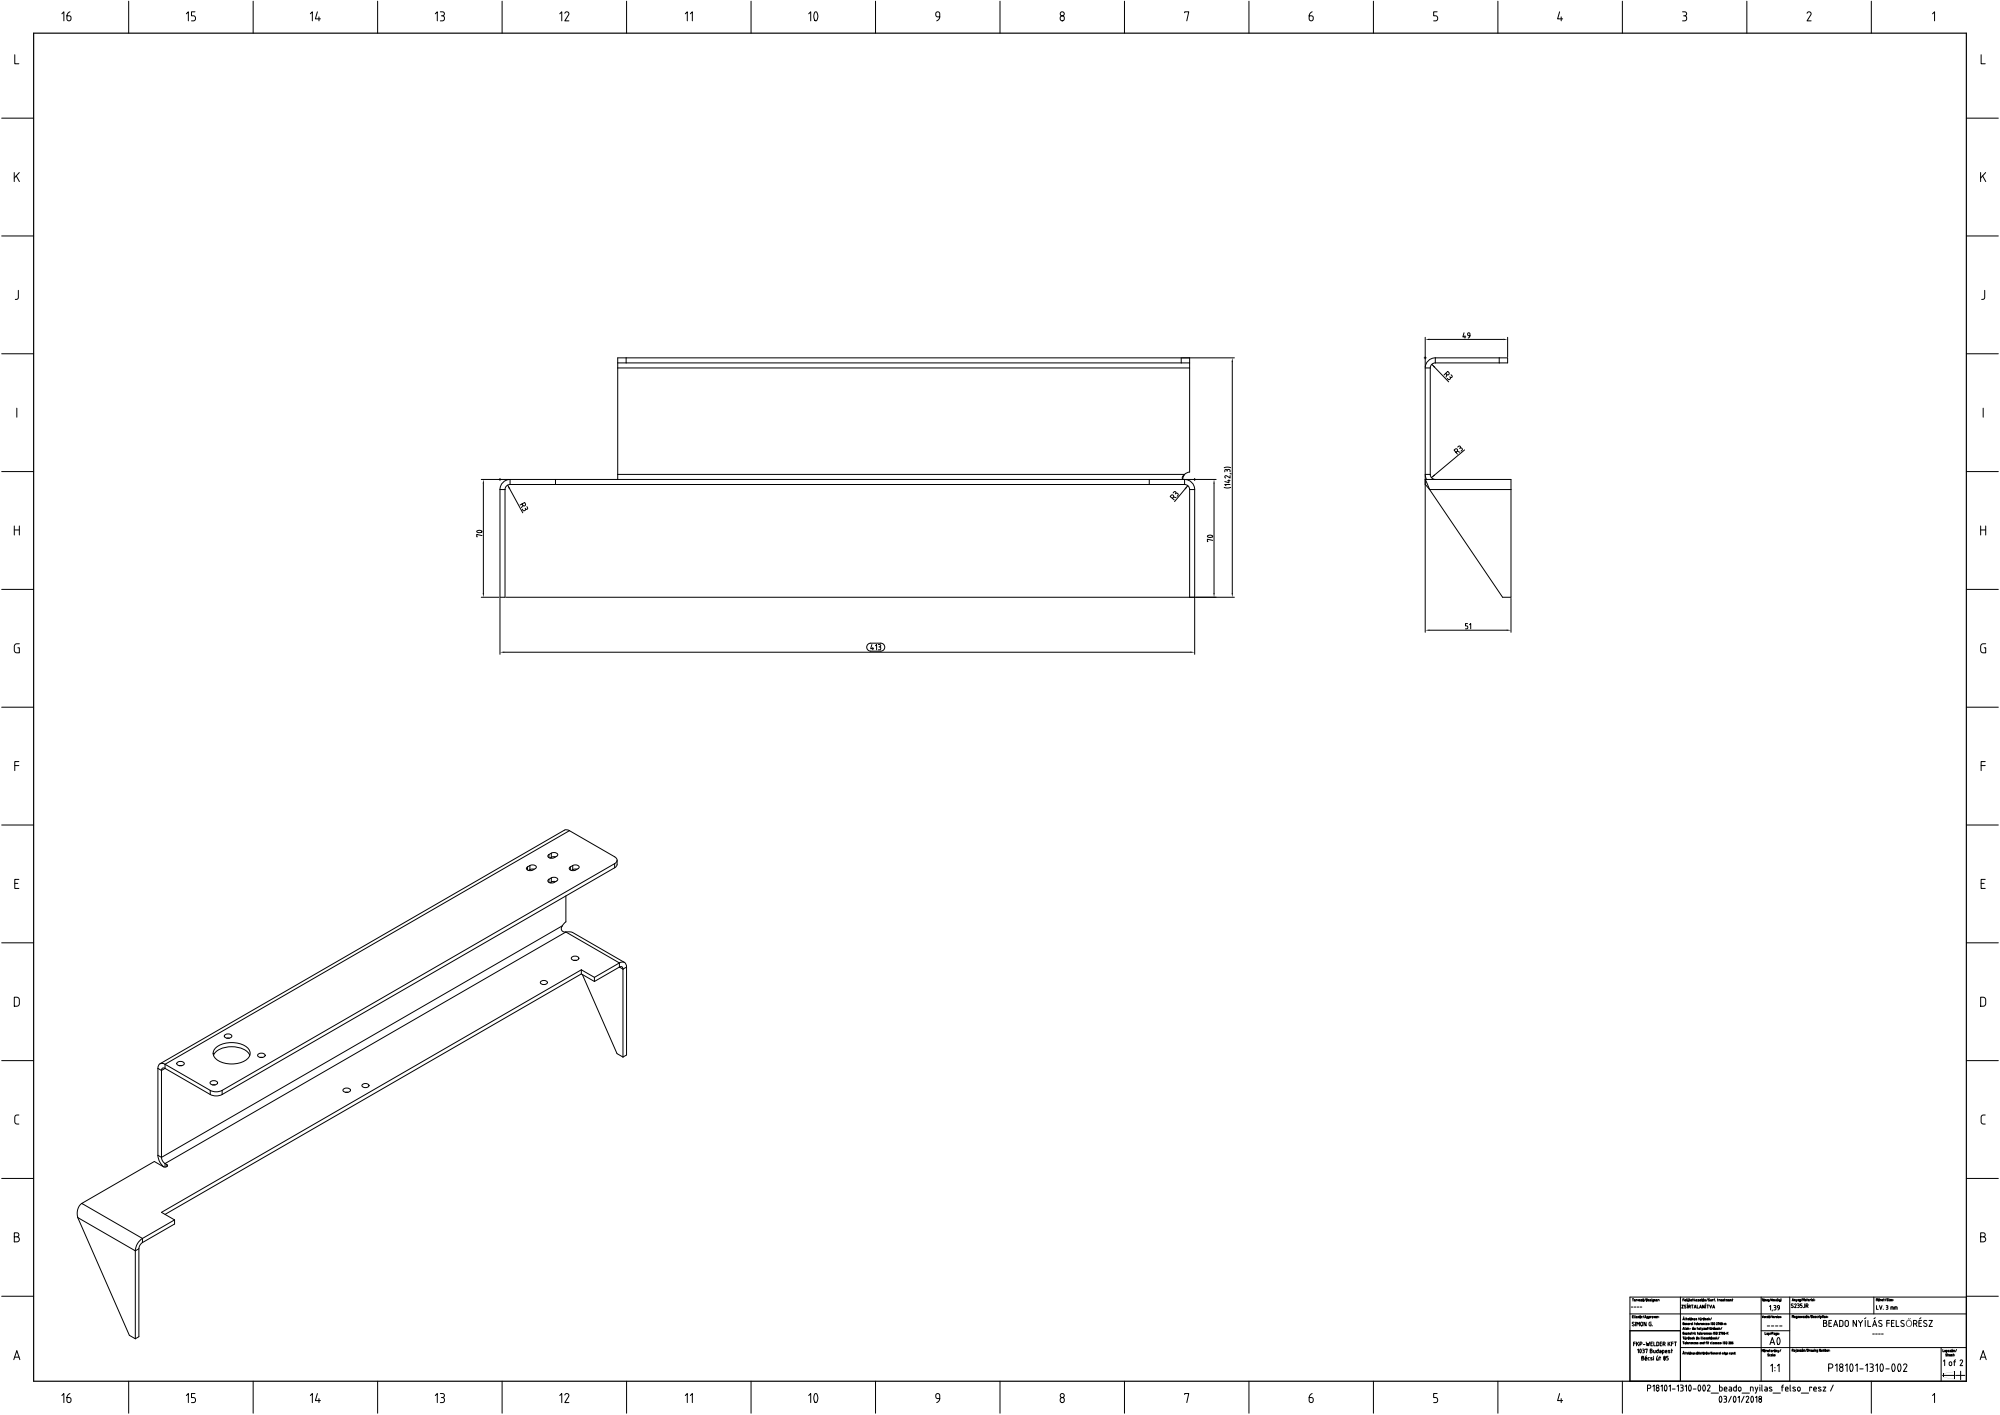
[picture p32: page 1]
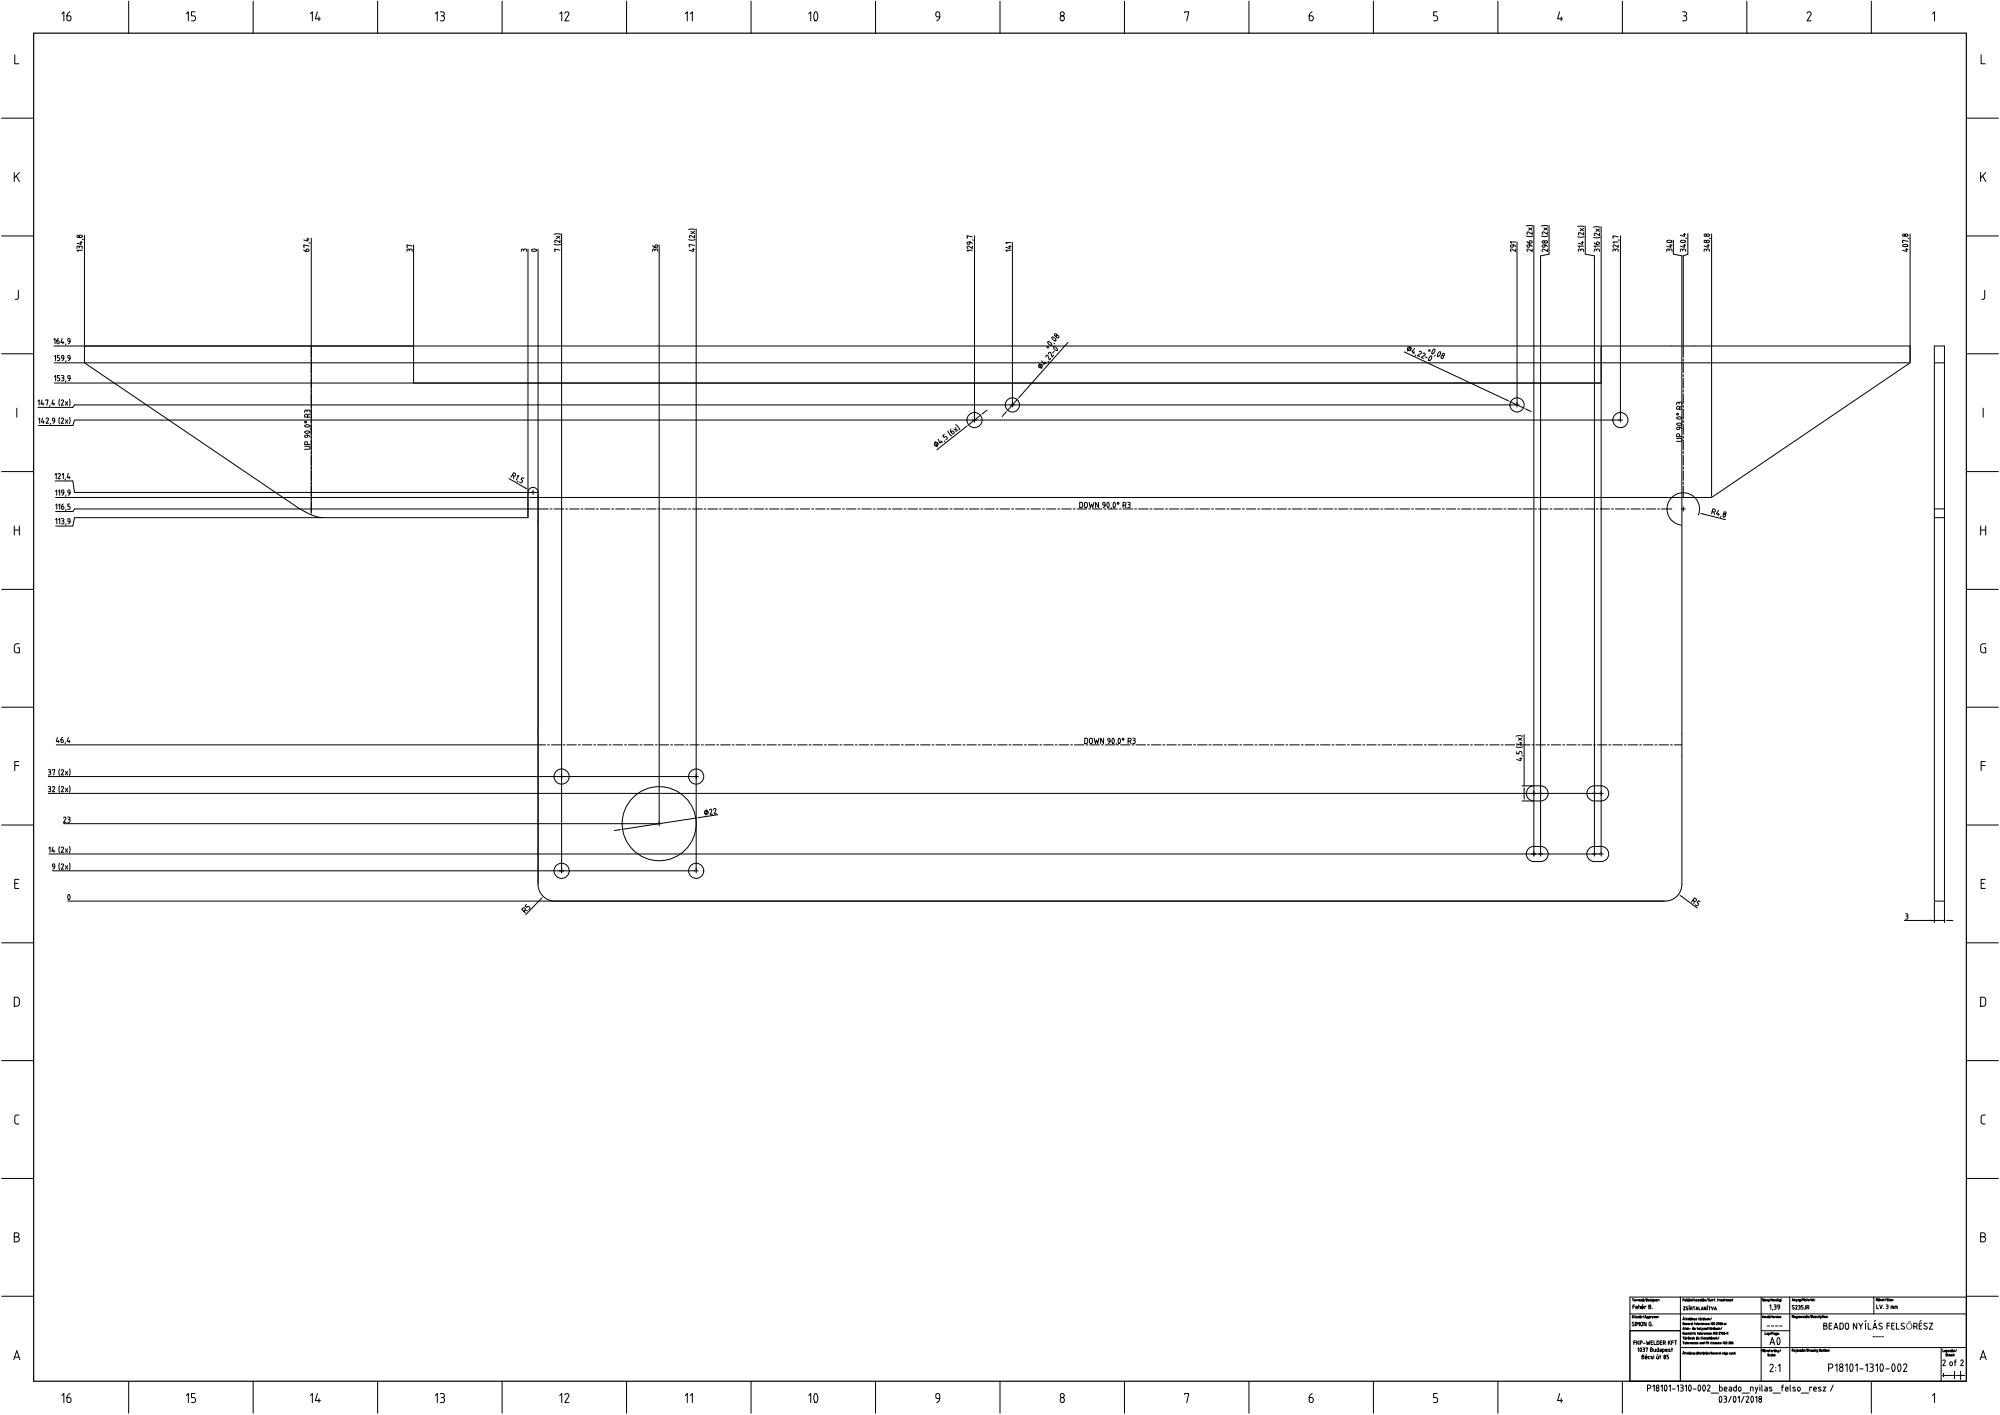
[picture p33: page 2]
