coderlazar/Metta-Pet/Tervrajzok/elhajlított alkatrészek/P18101-4200-005_Ledobo_tálca.pdf

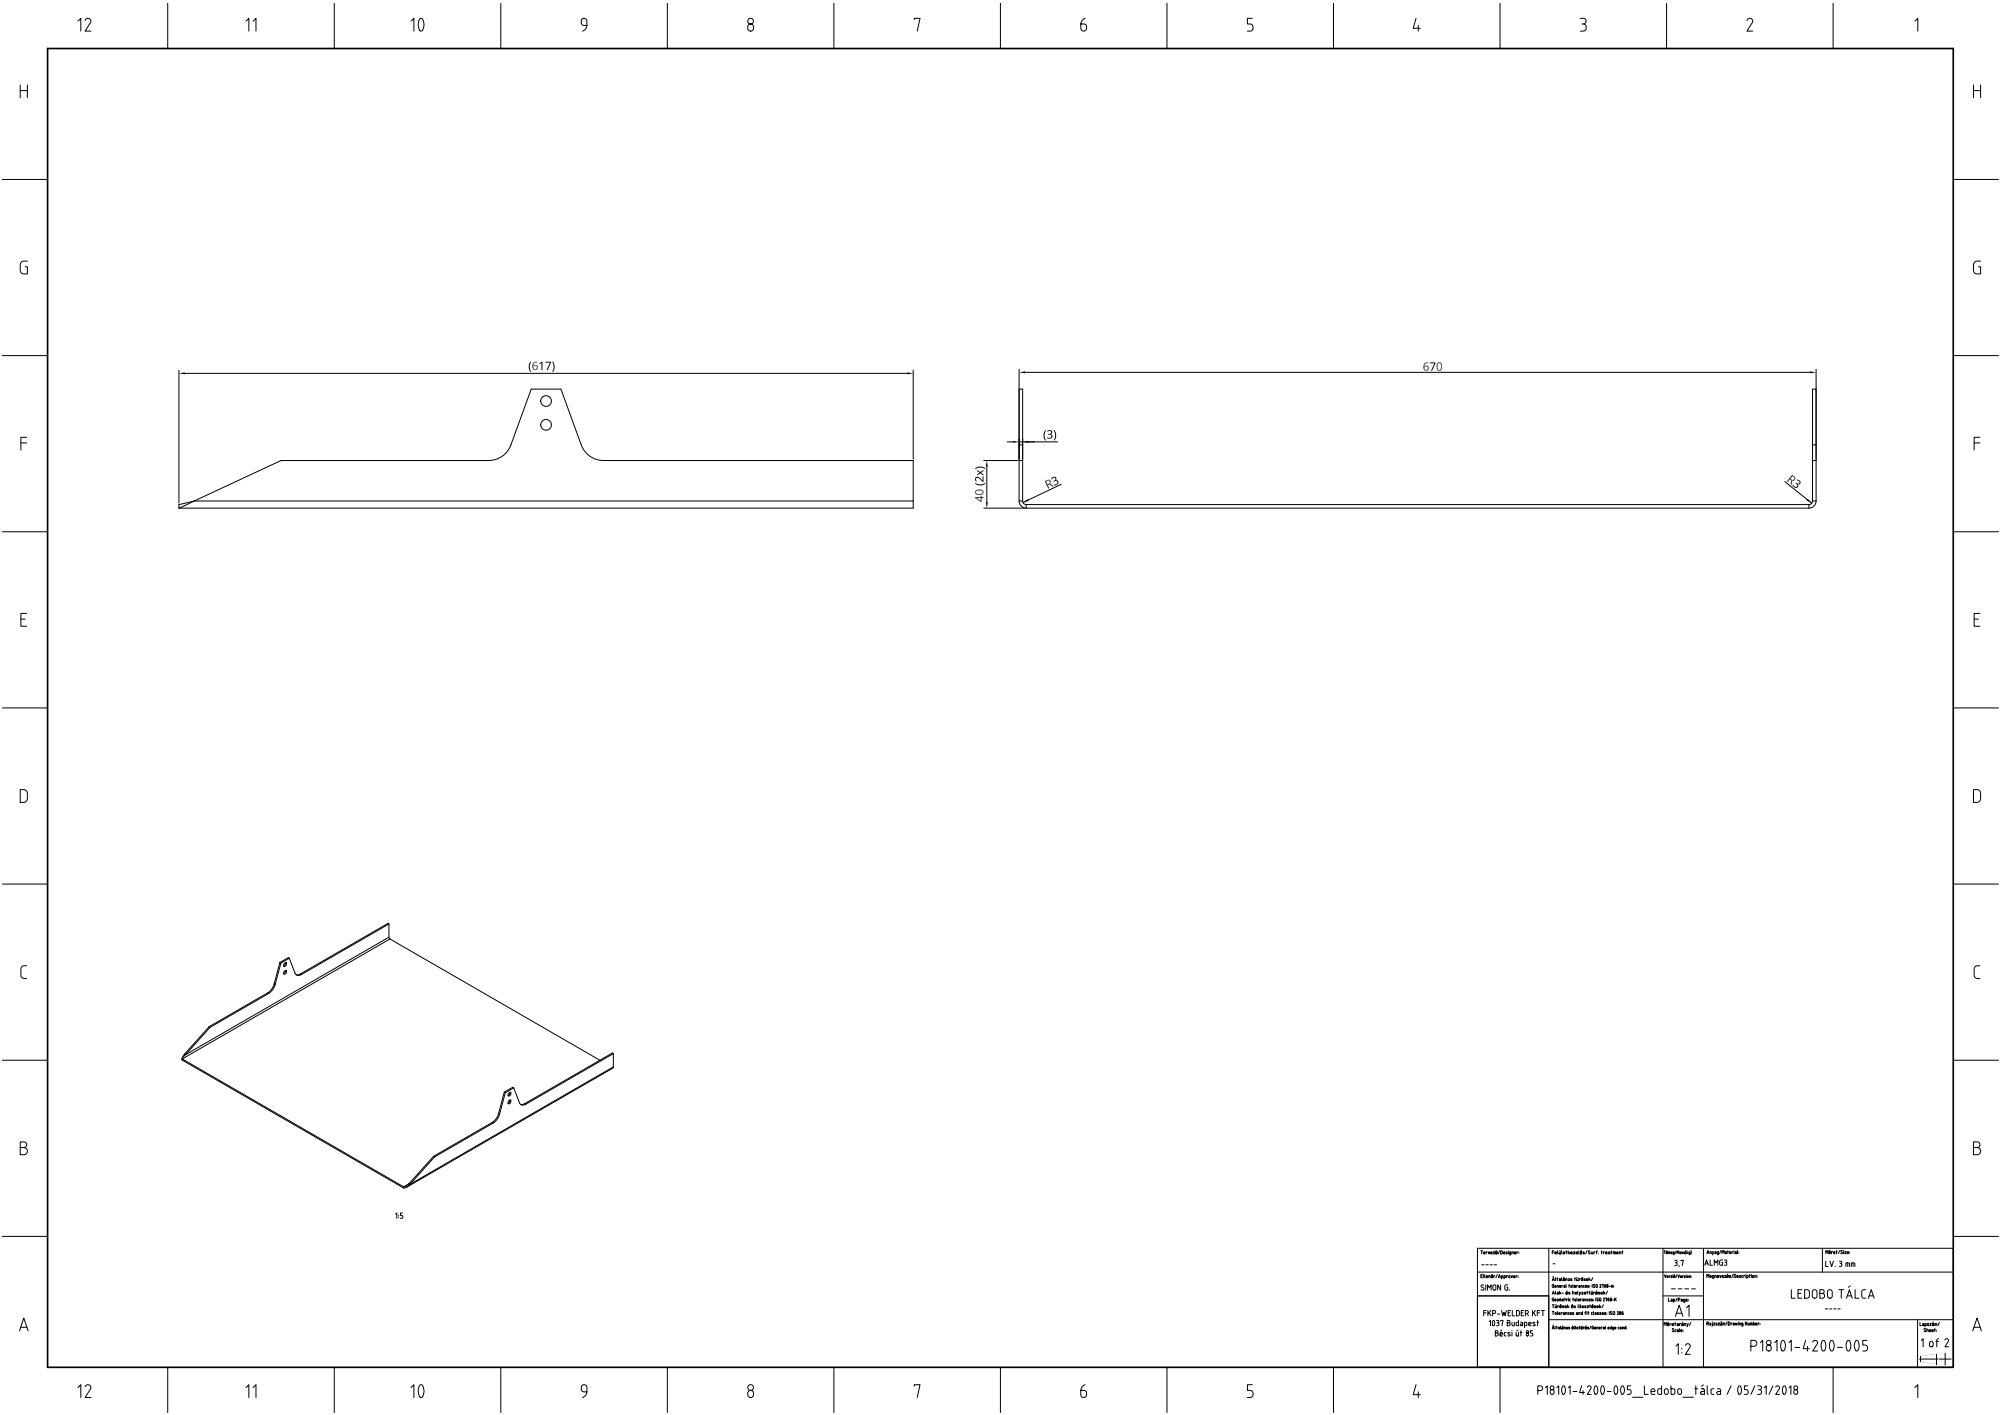
[picture p34: page 1]
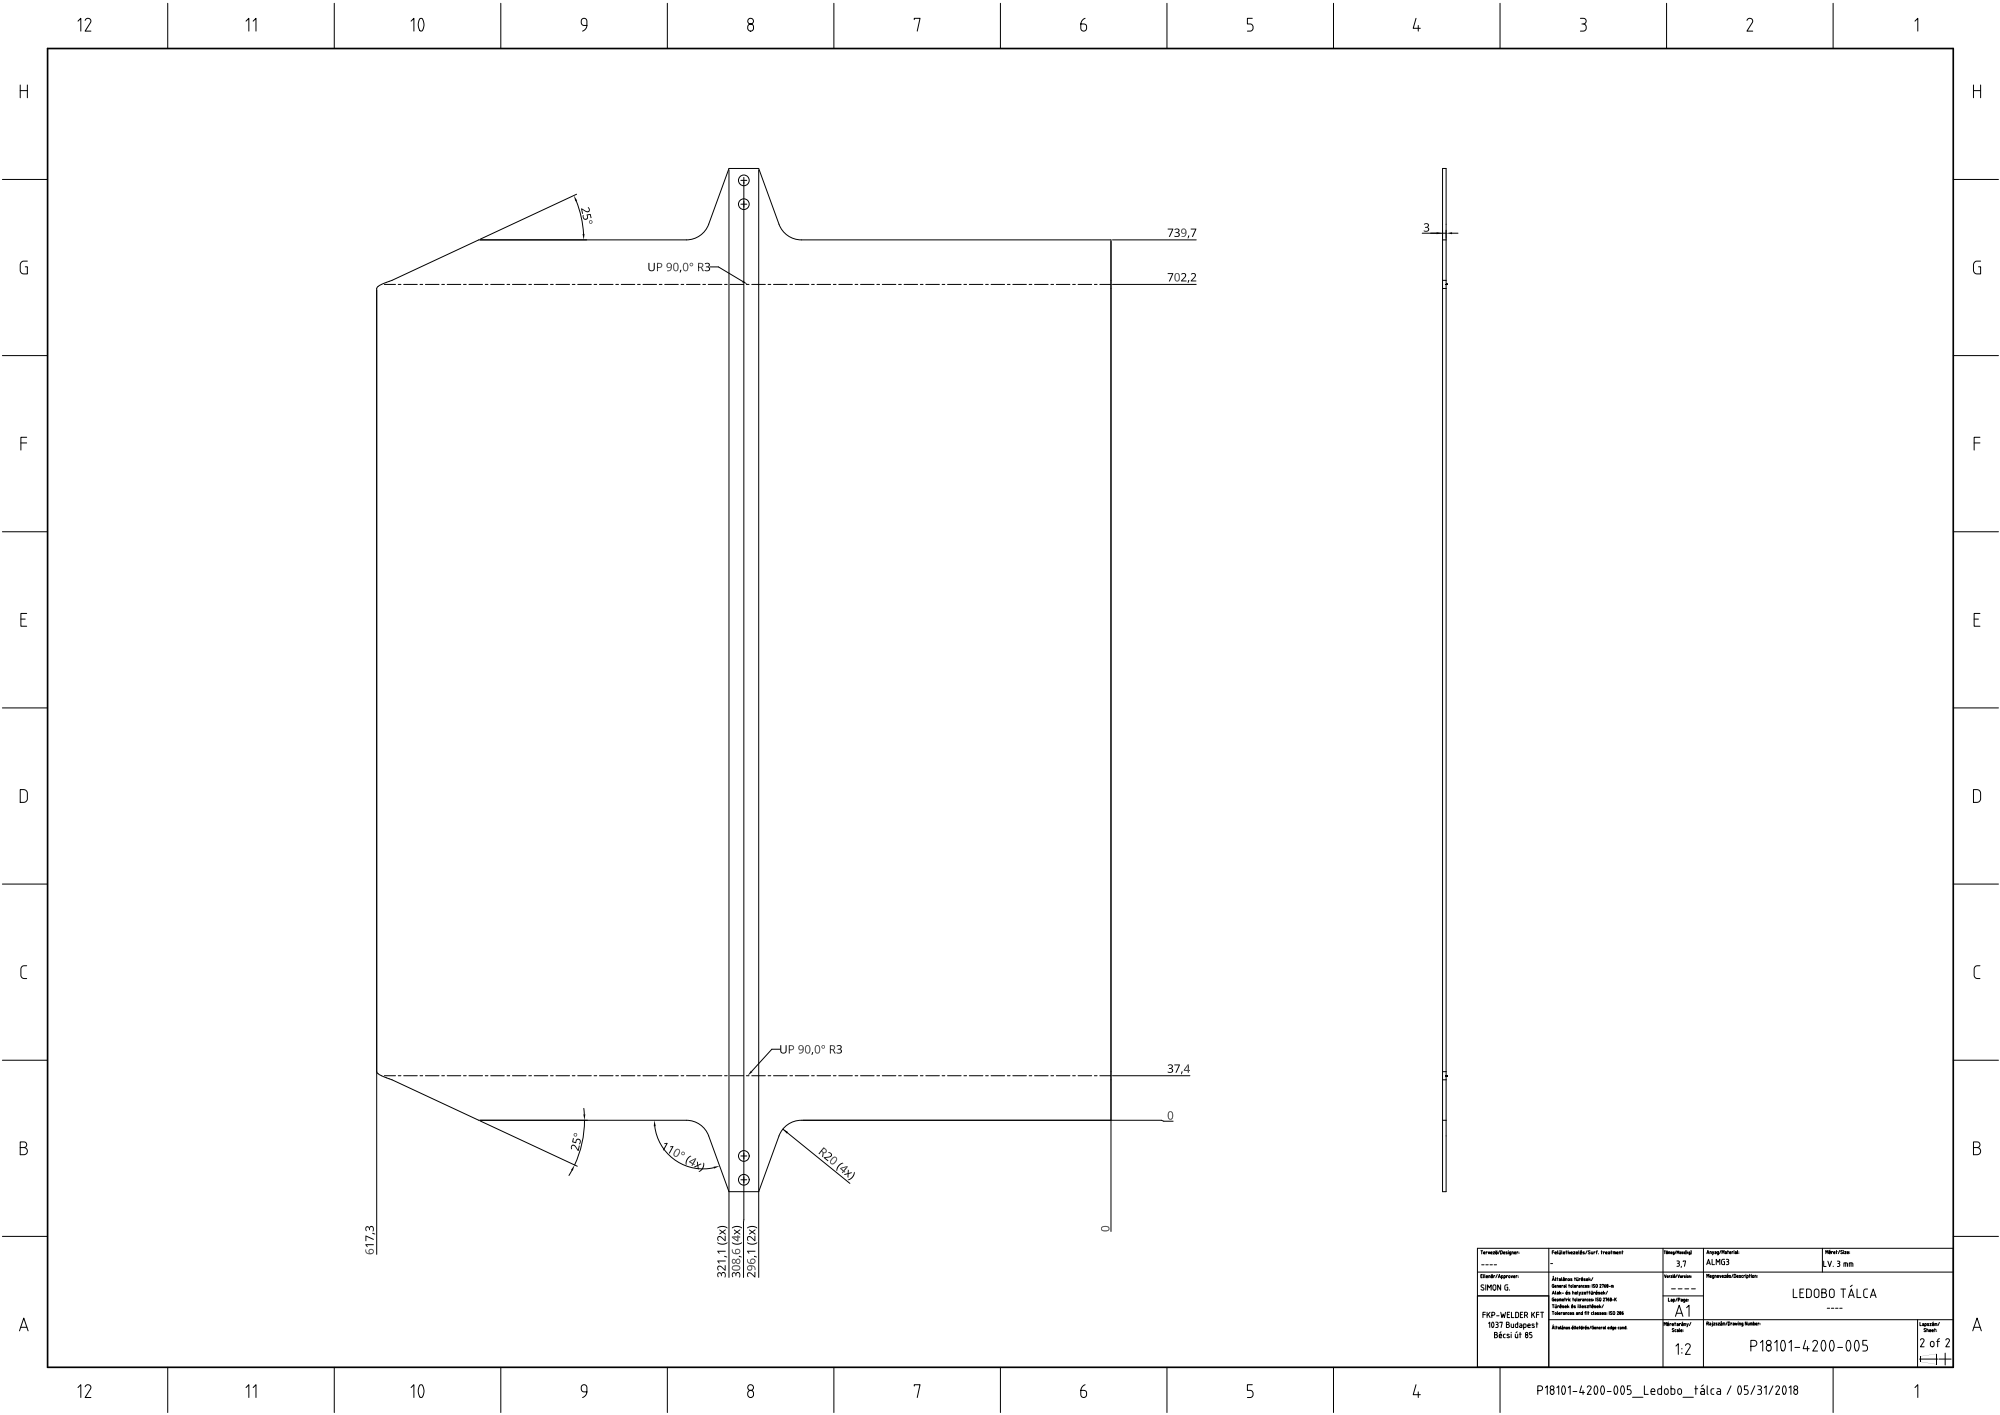
[picture p35: page 2]
