coderlazar/Metta-Pet/Tervrajzok/elhajlított alkatrészek/P18101-5000-013_Ledobás terelö lejtö.pdf

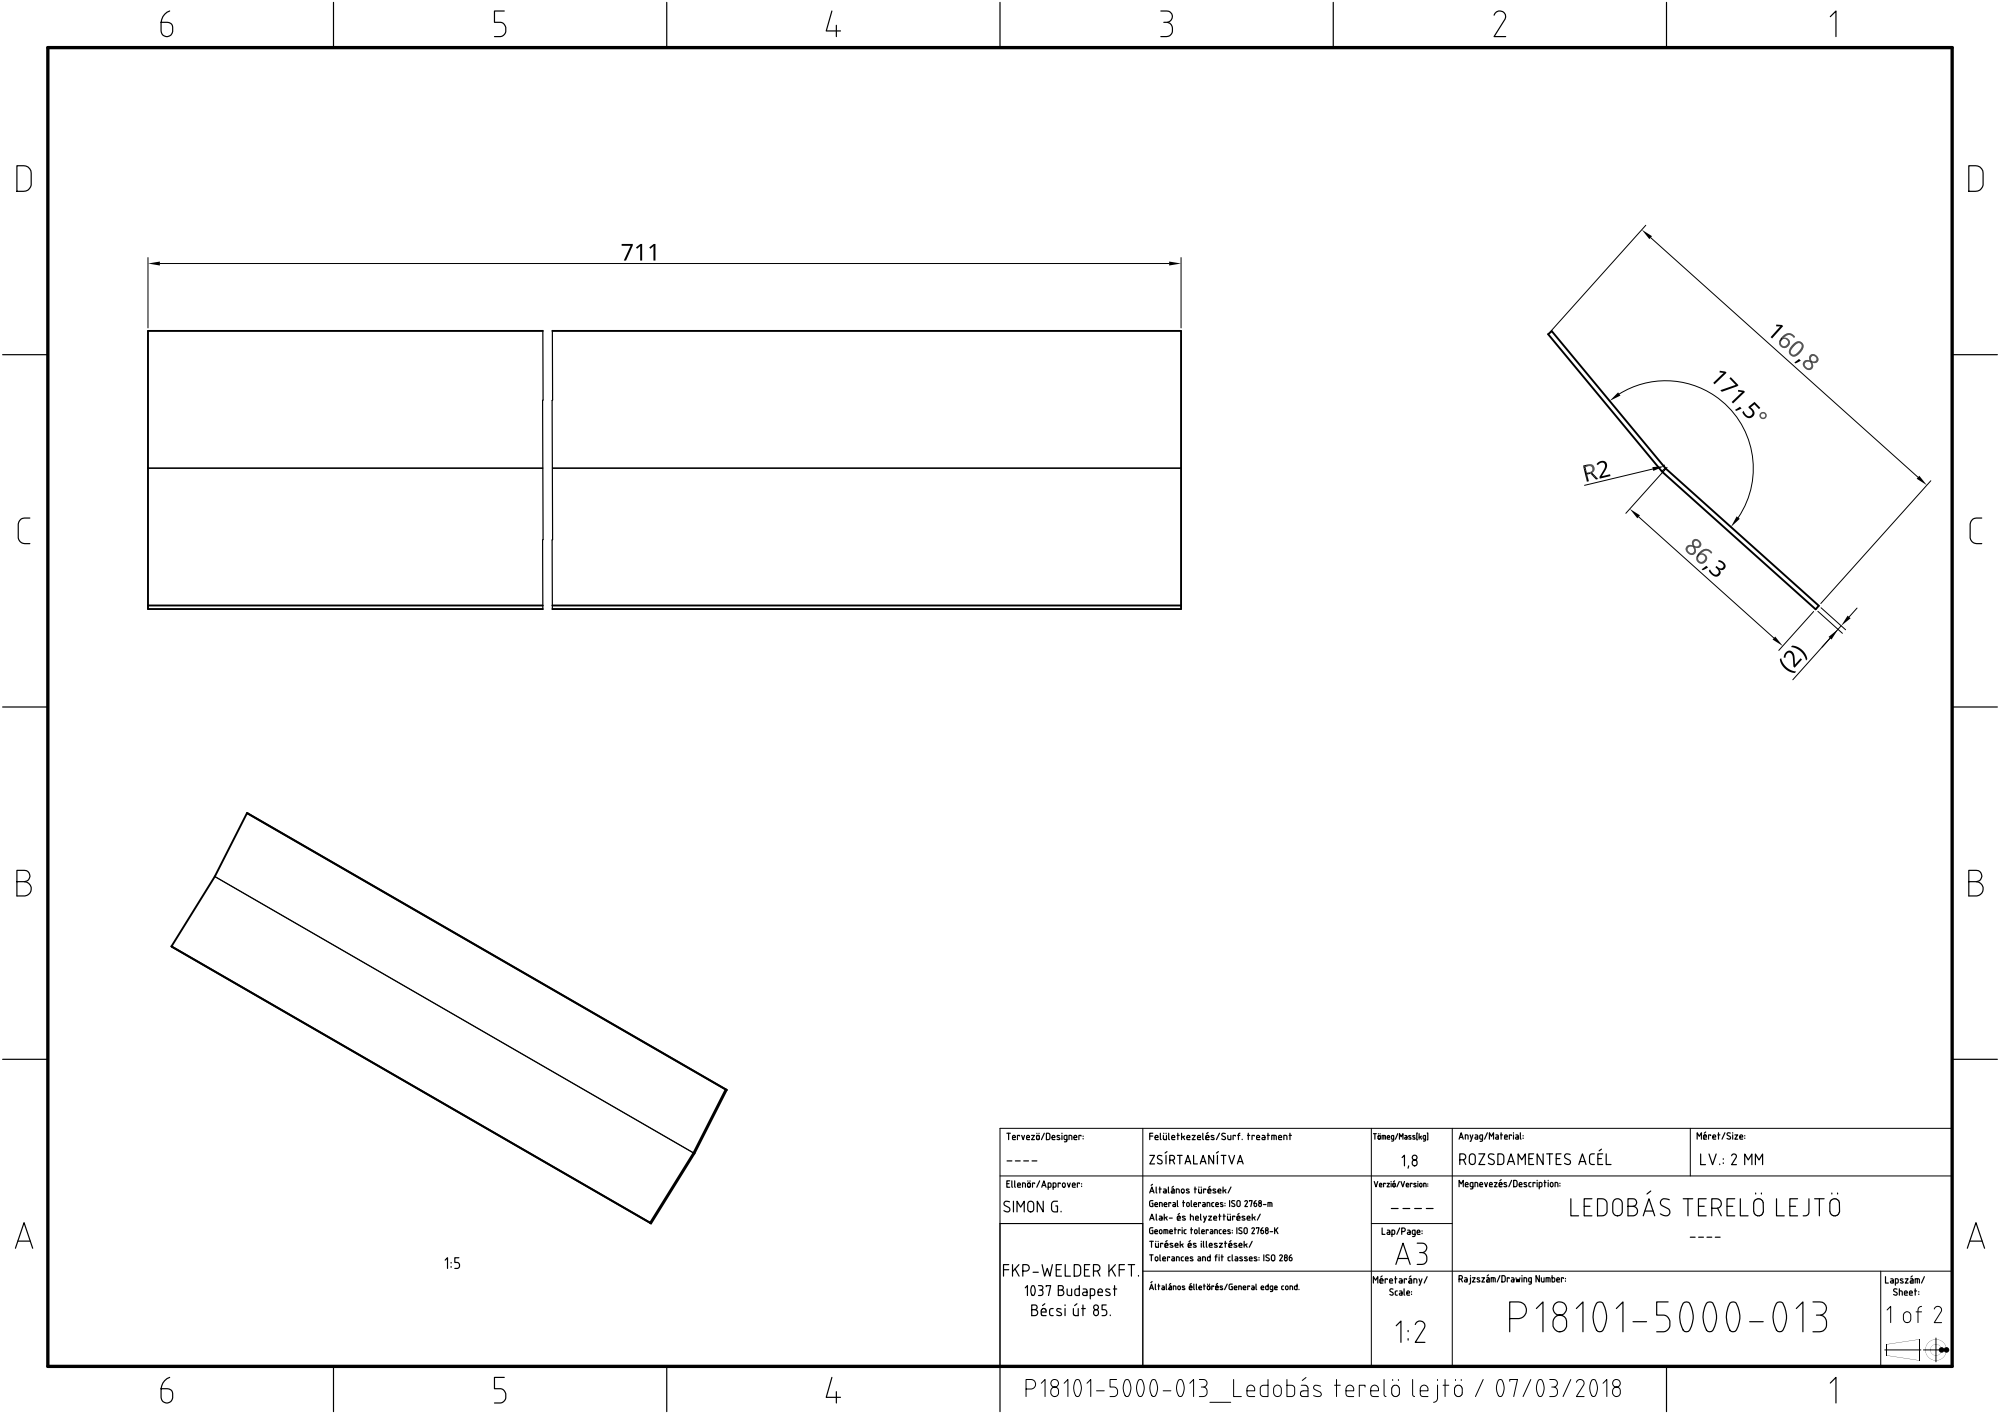
[picture p36: page 1]
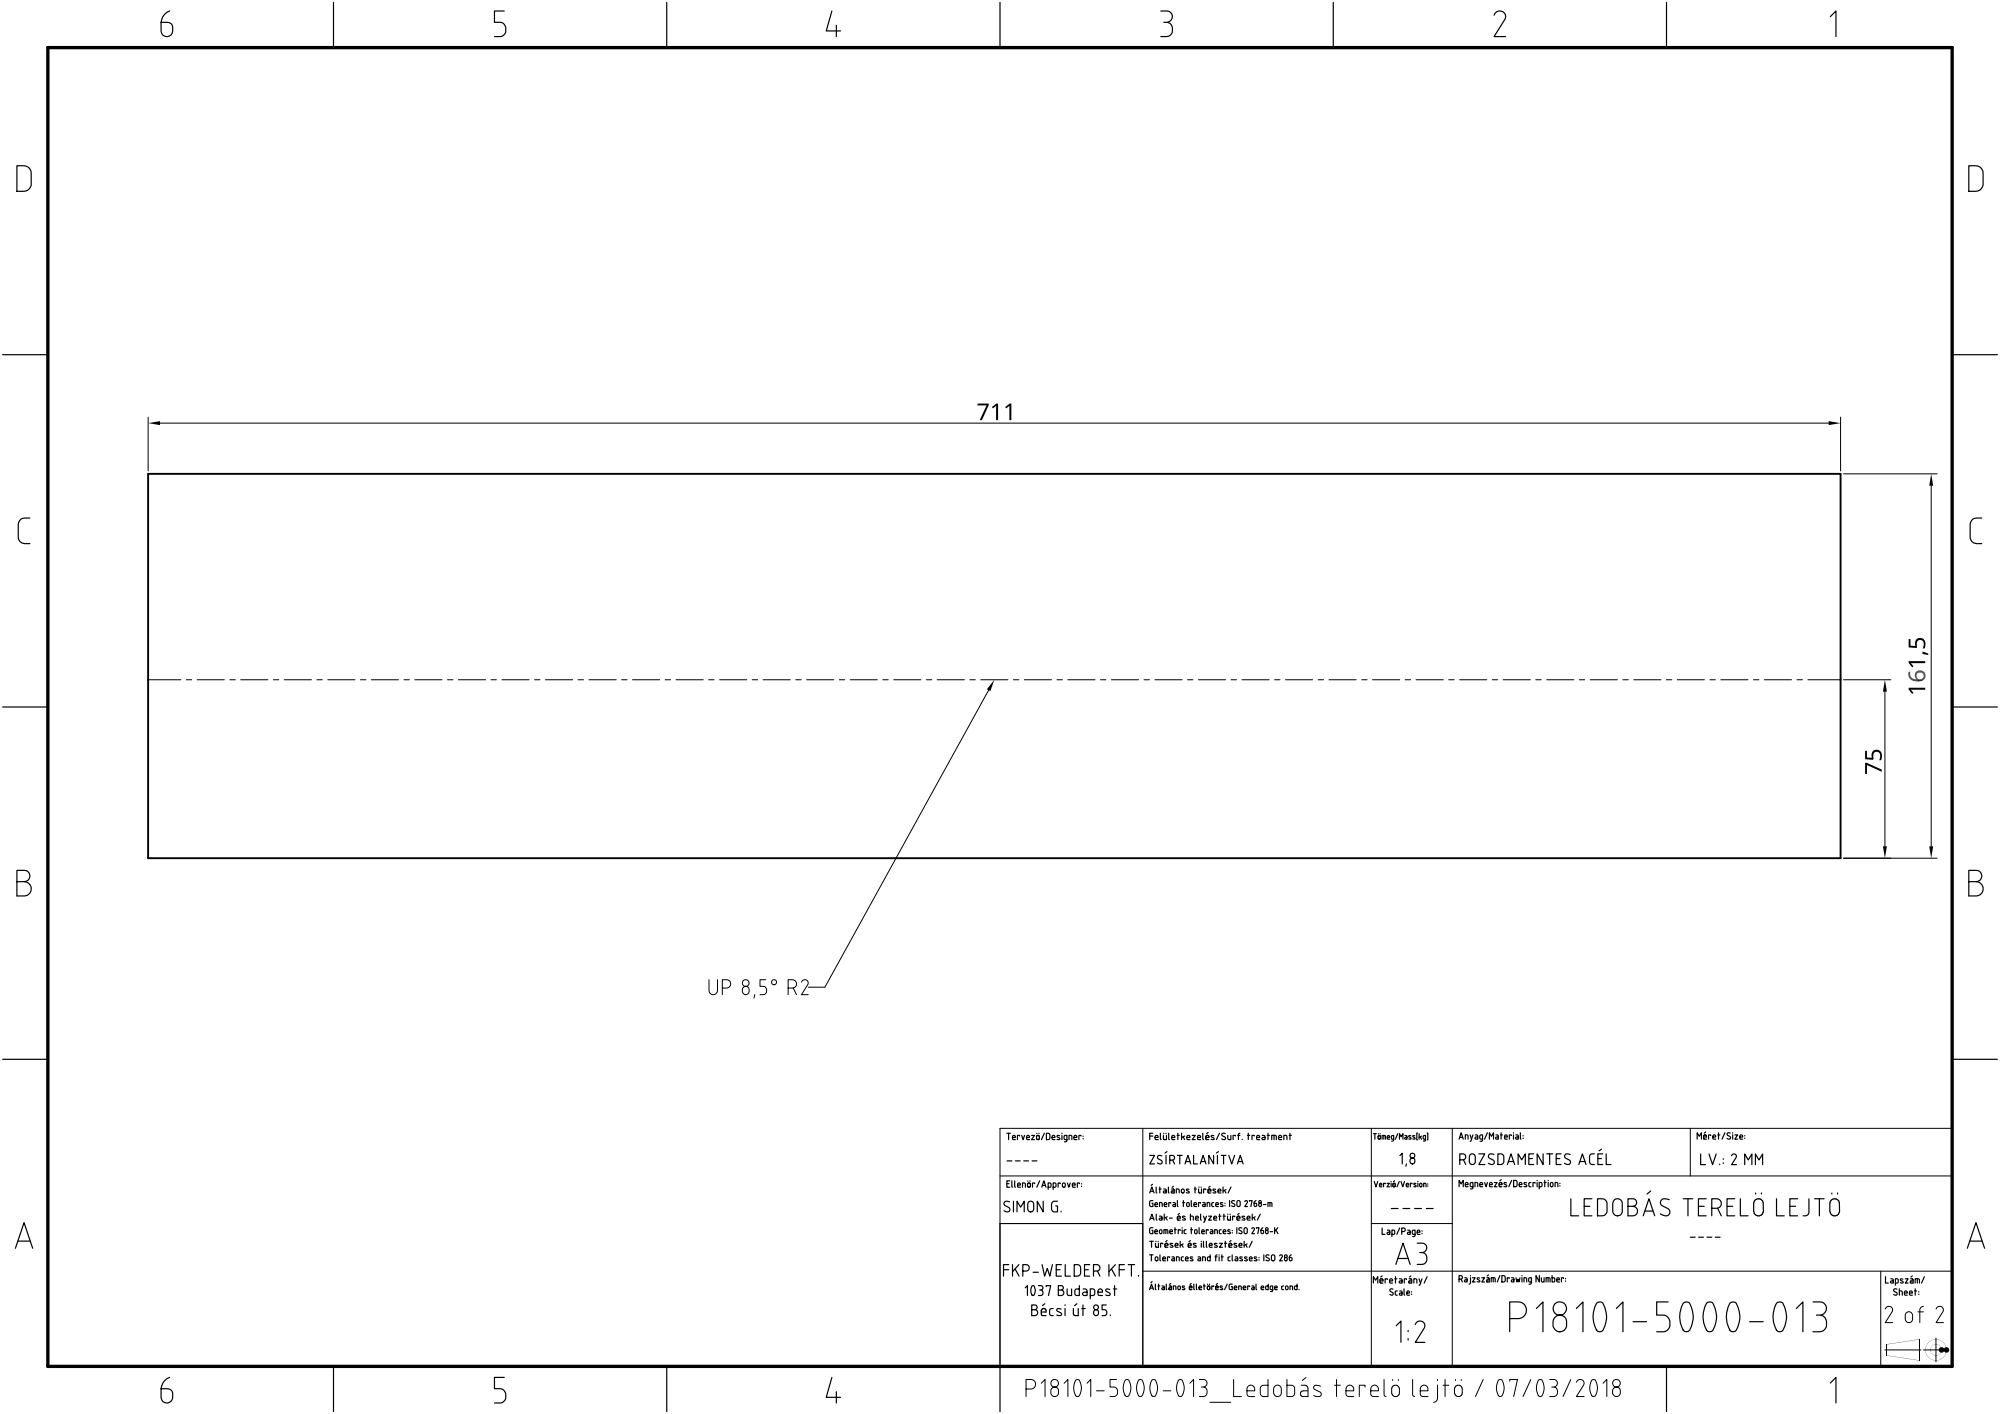
[picture p37: page 2]
