coderlazar/Metta-Pet/Tervrajzok/elhajlított alkatrészek/P18101-6100-001_kijelzö_tartó_konzol.pdf

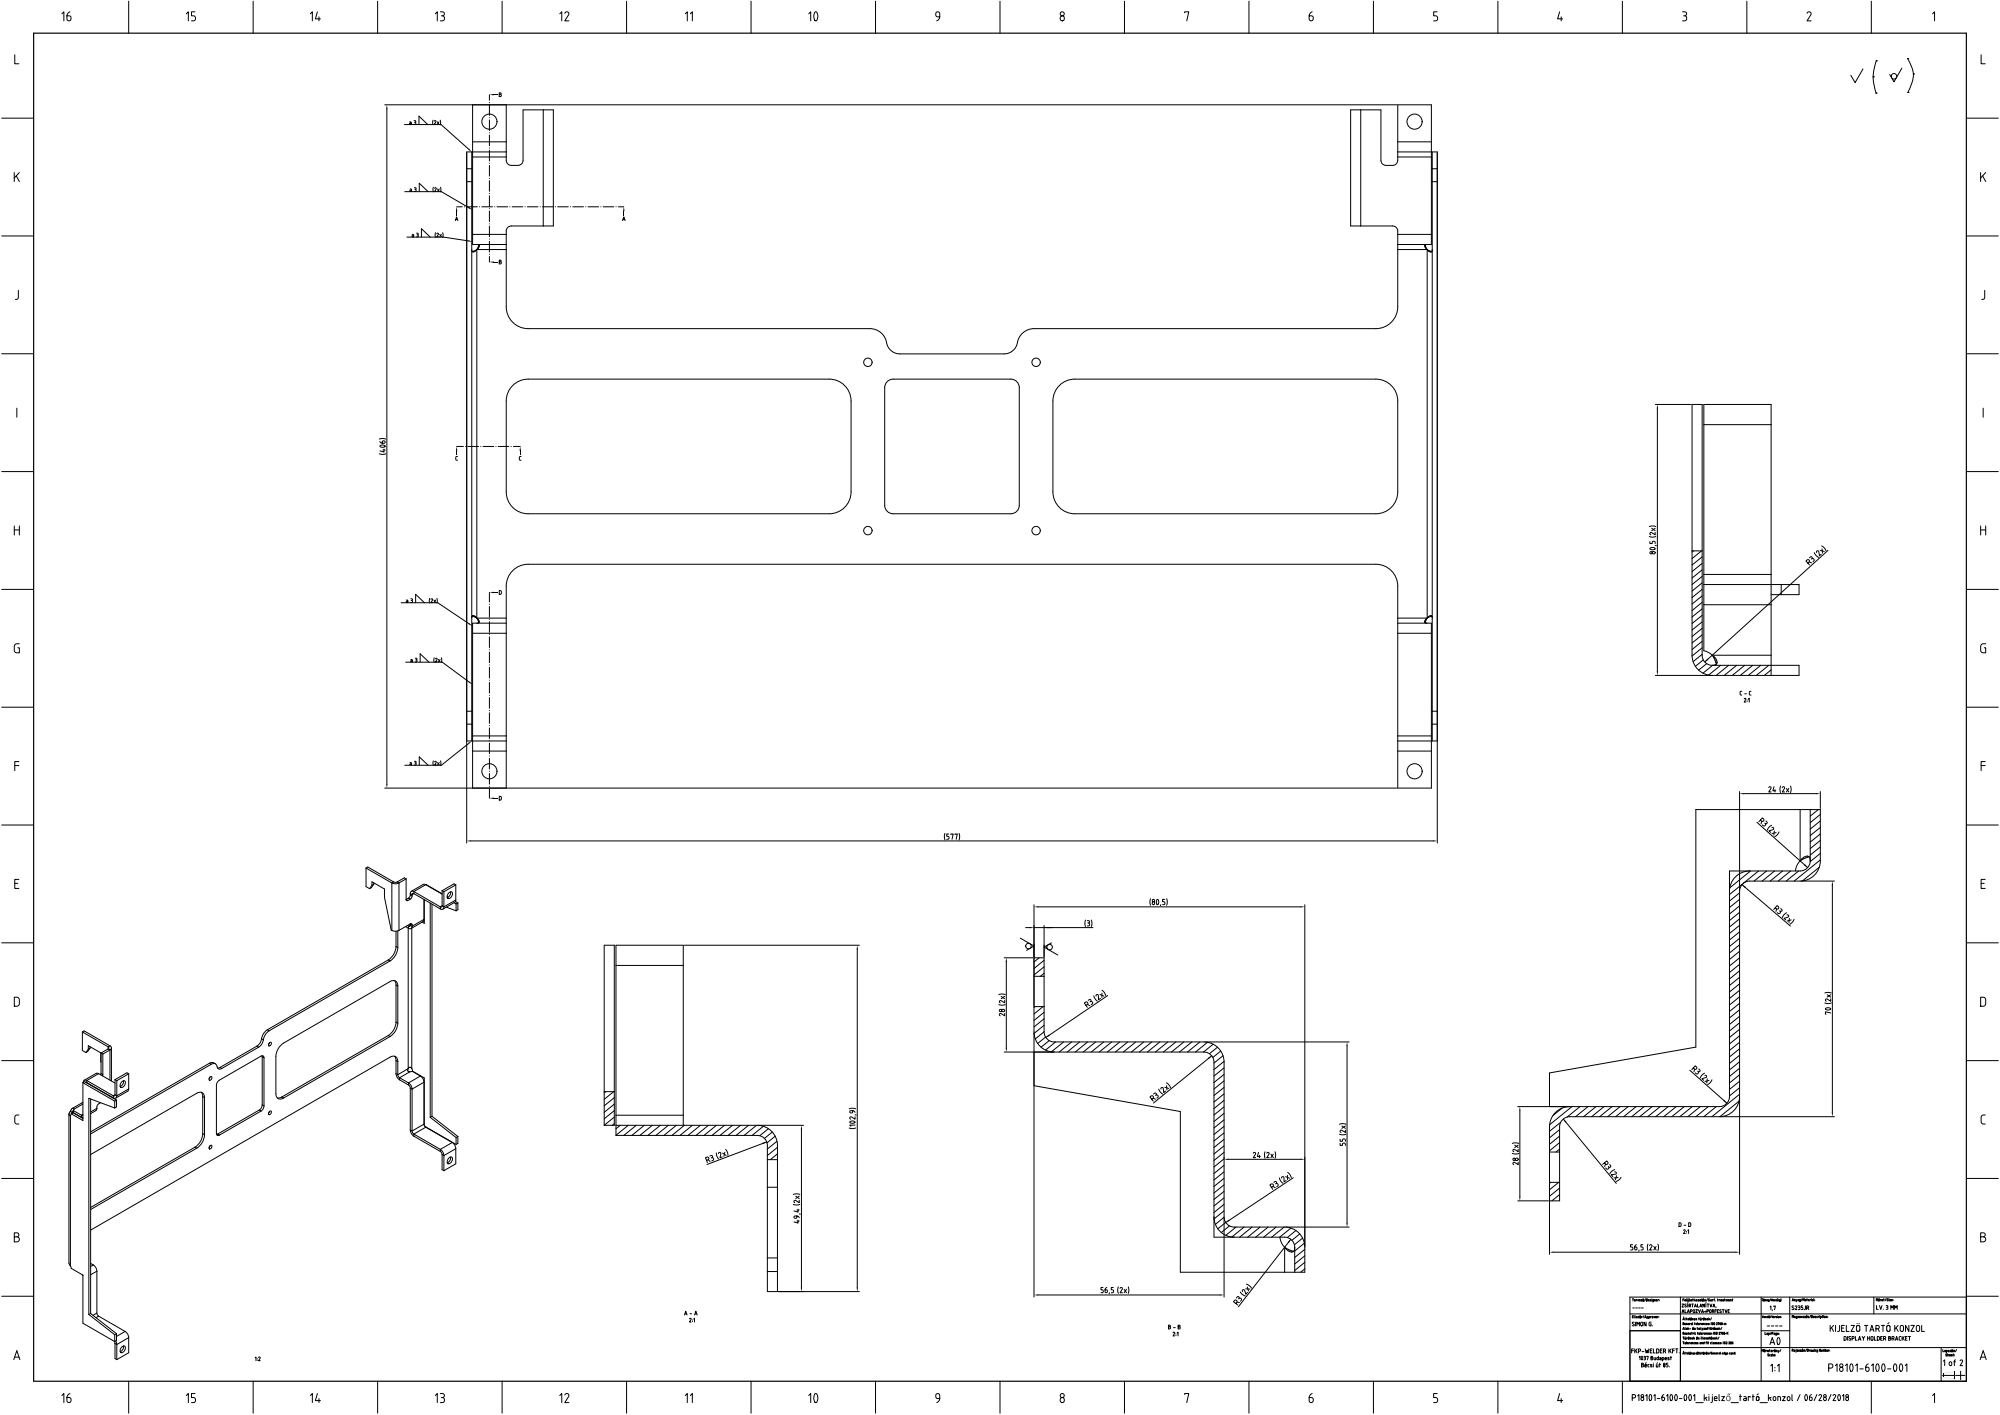
[picture p38: page 1]
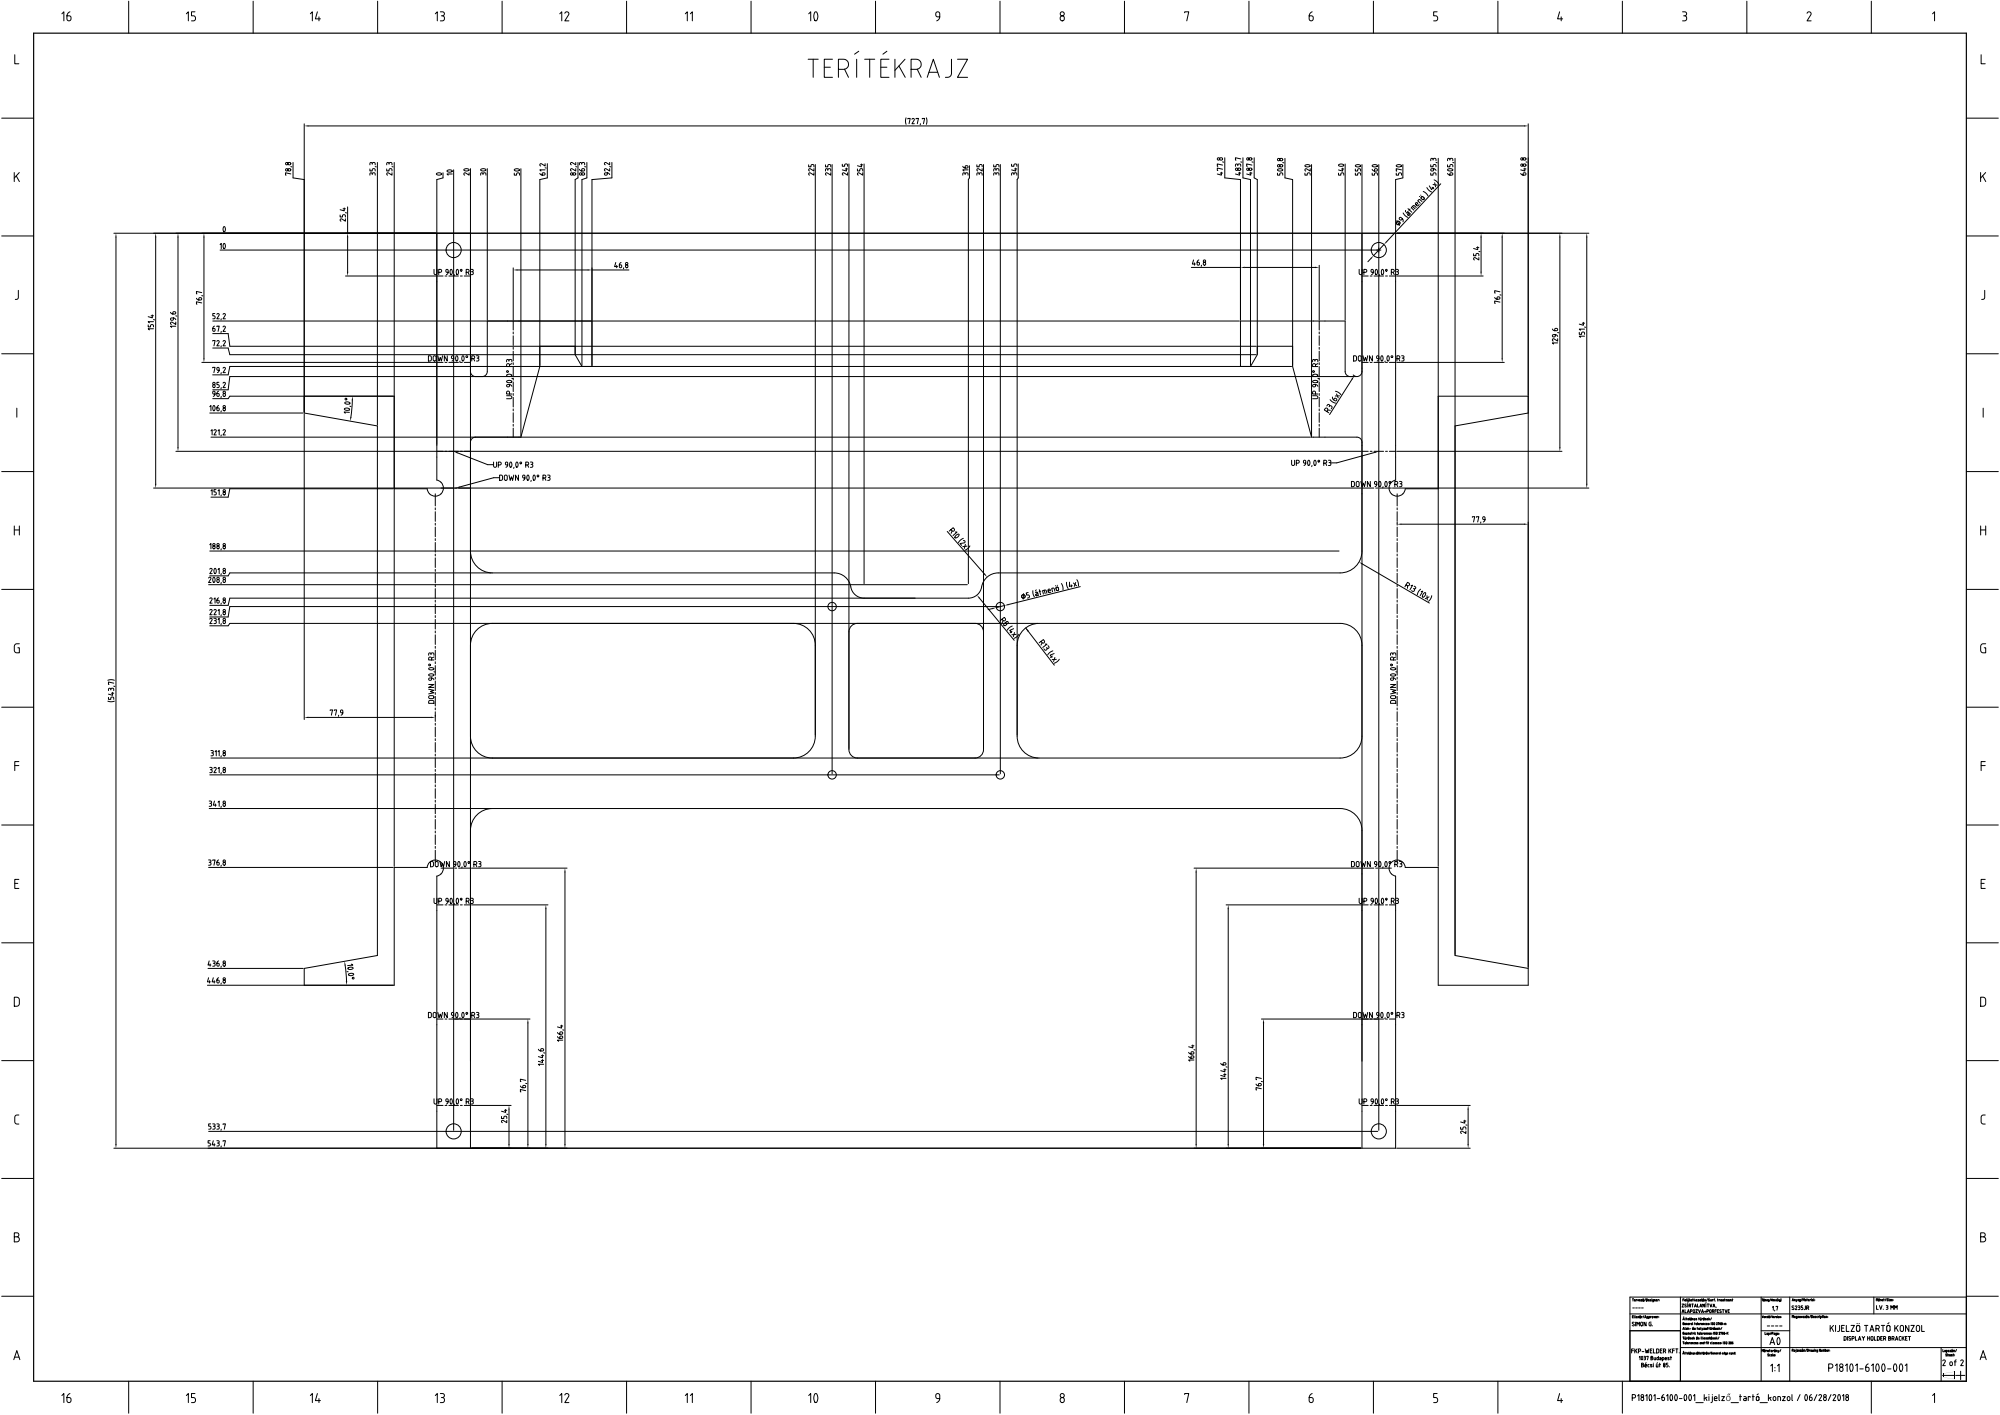
[picture p39: page 2]
