coderlazar/Metta-Pet/Tervrajzok/elhajlított alkatrészek/P18101-6100-003_kamera_konzol.pdf

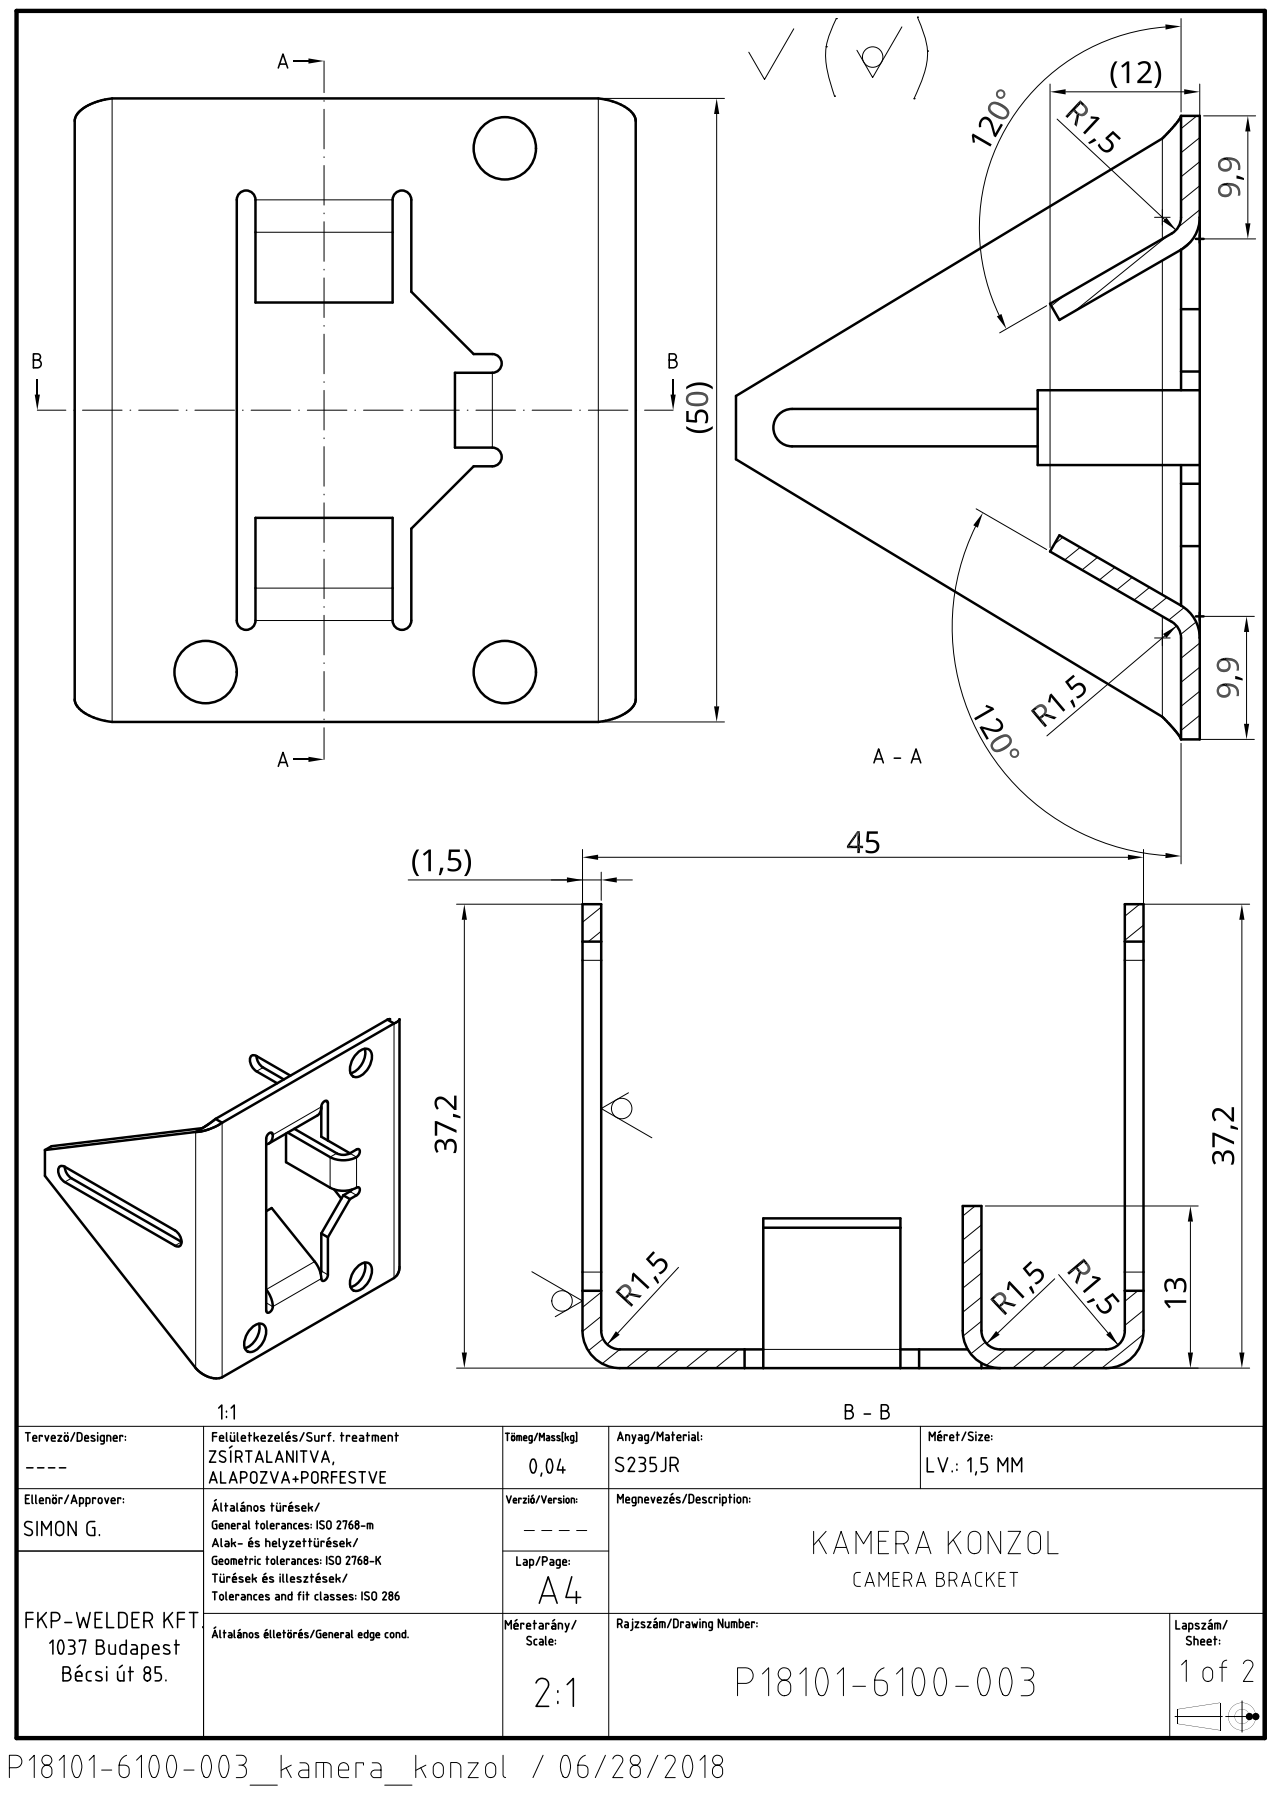
[picture p40: page 1]
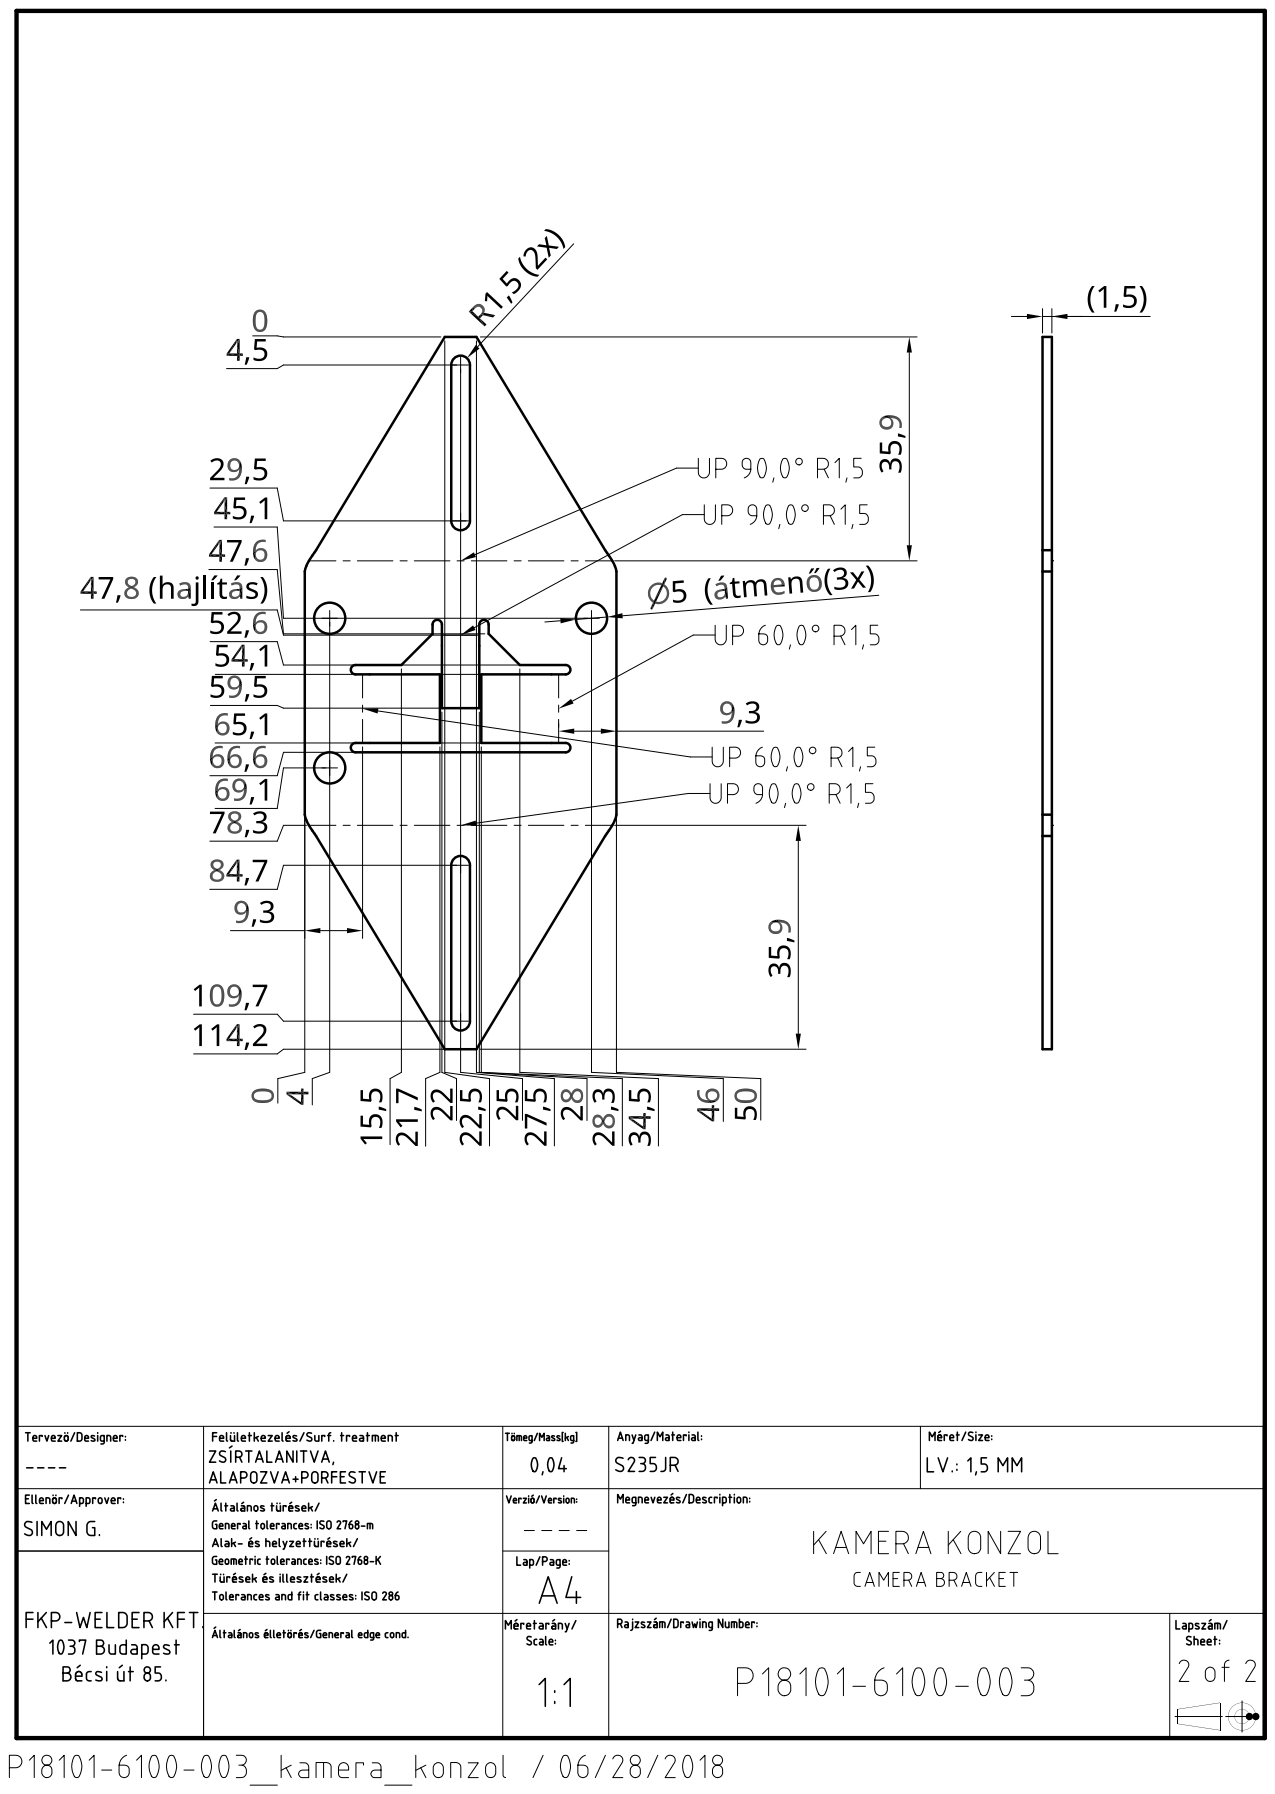
[picture p41: page 2]
