coderlazar/Metta-Pet/Tervrajzok/elhajlított alkatrészek/P18101-6110-002_Elsö_középsö_burkolat_konzol.pdf

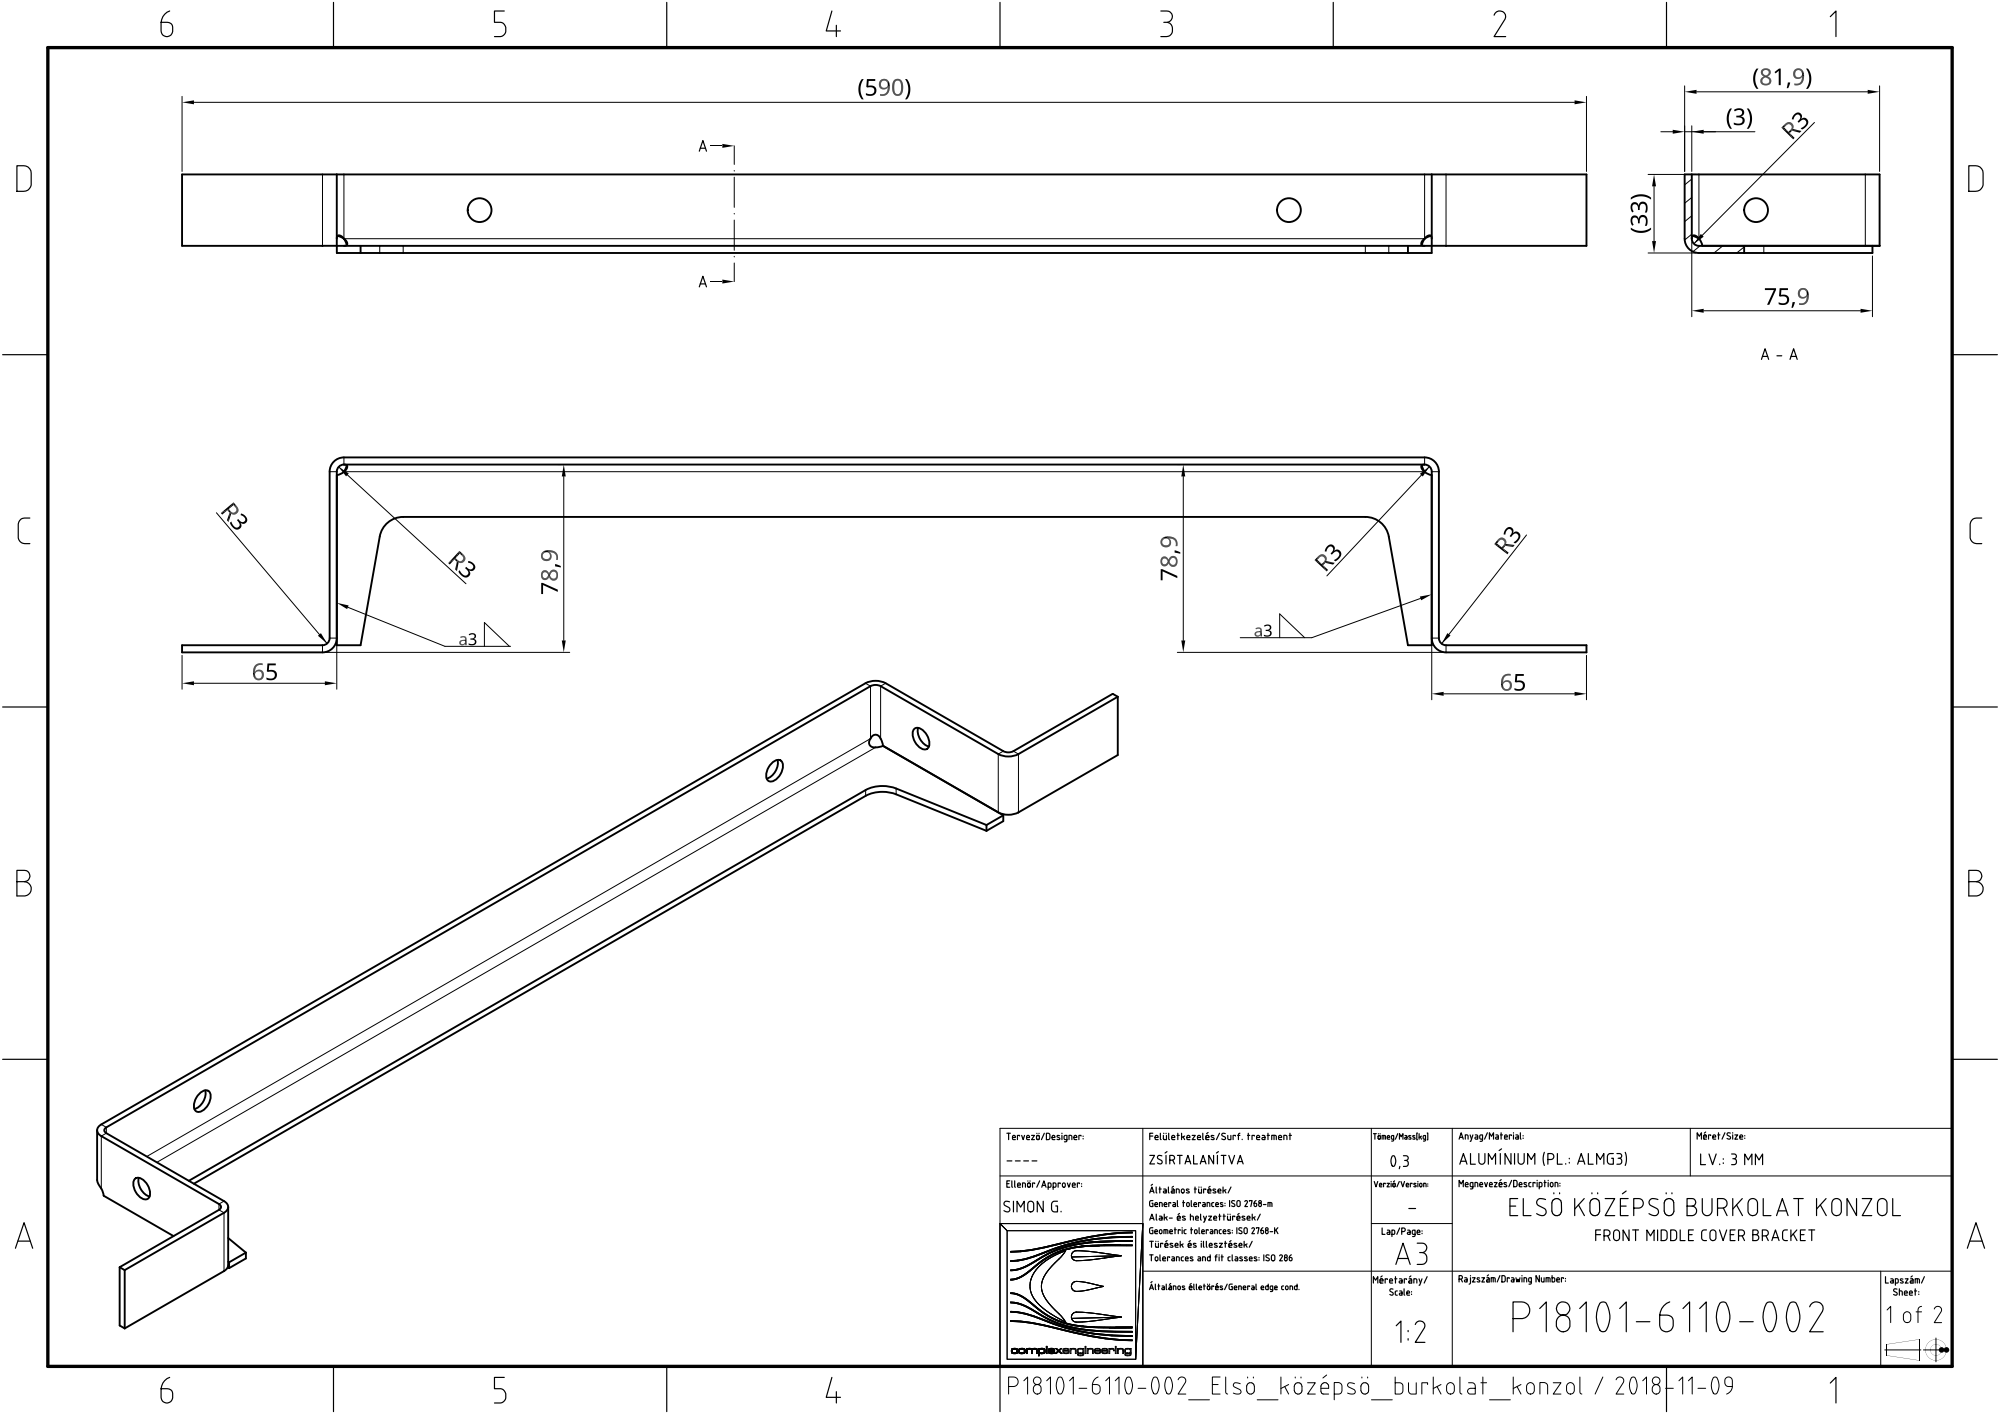
[picture p42: page 1]
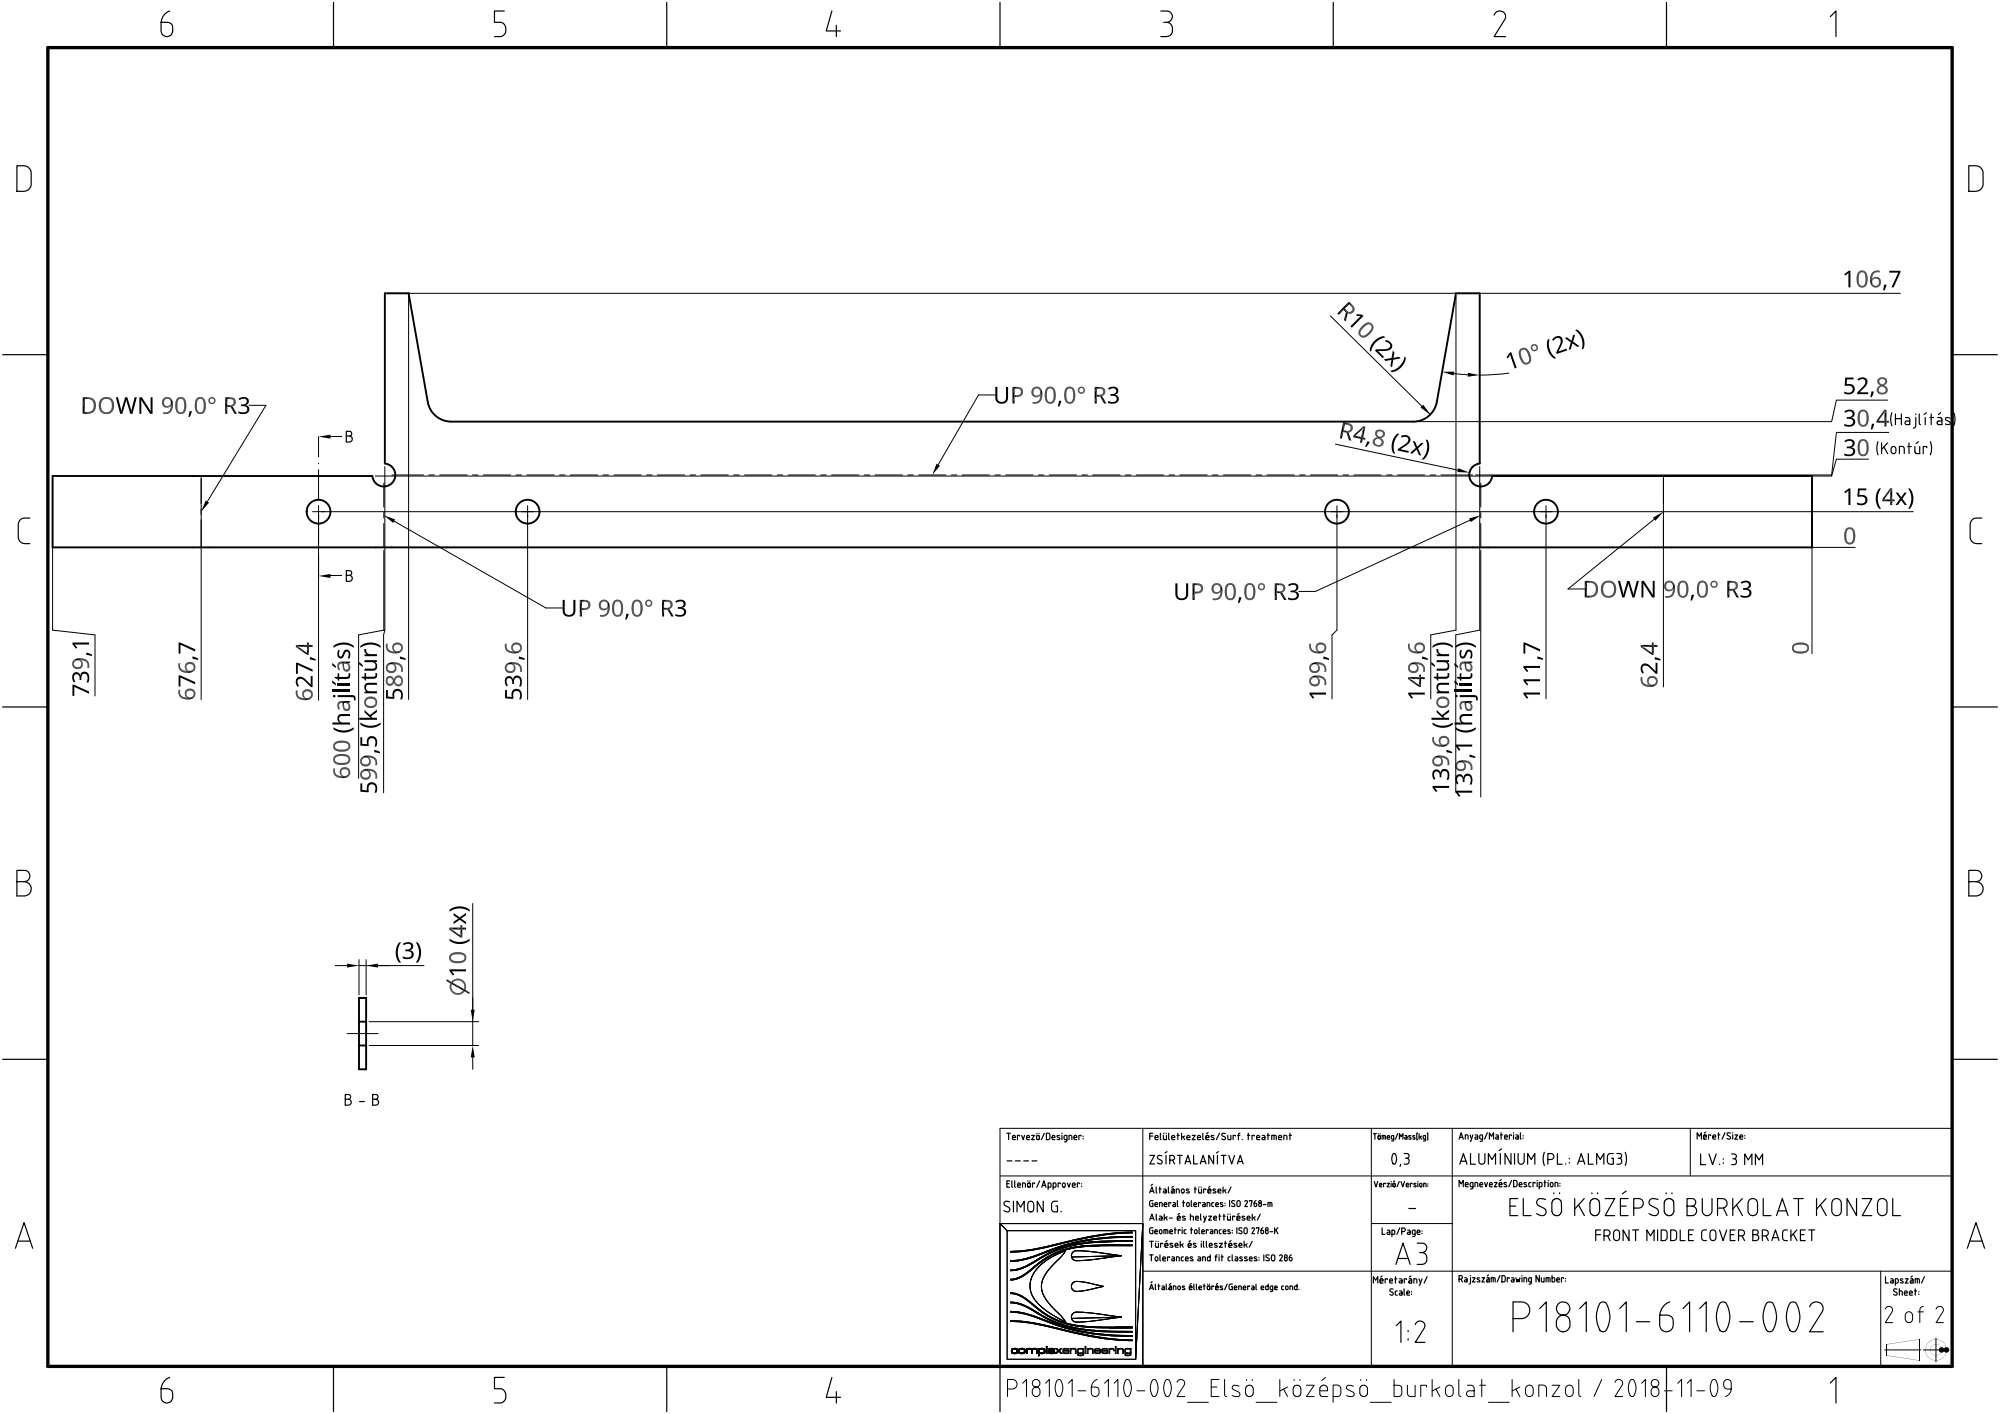
[picture p43: page 2]
