coderlazar/Metta-Pet/Tervrajzok/elhajlított alkatrészek/P18101-6110-008_Mozgásérzékelö szenzor konzol.pdf

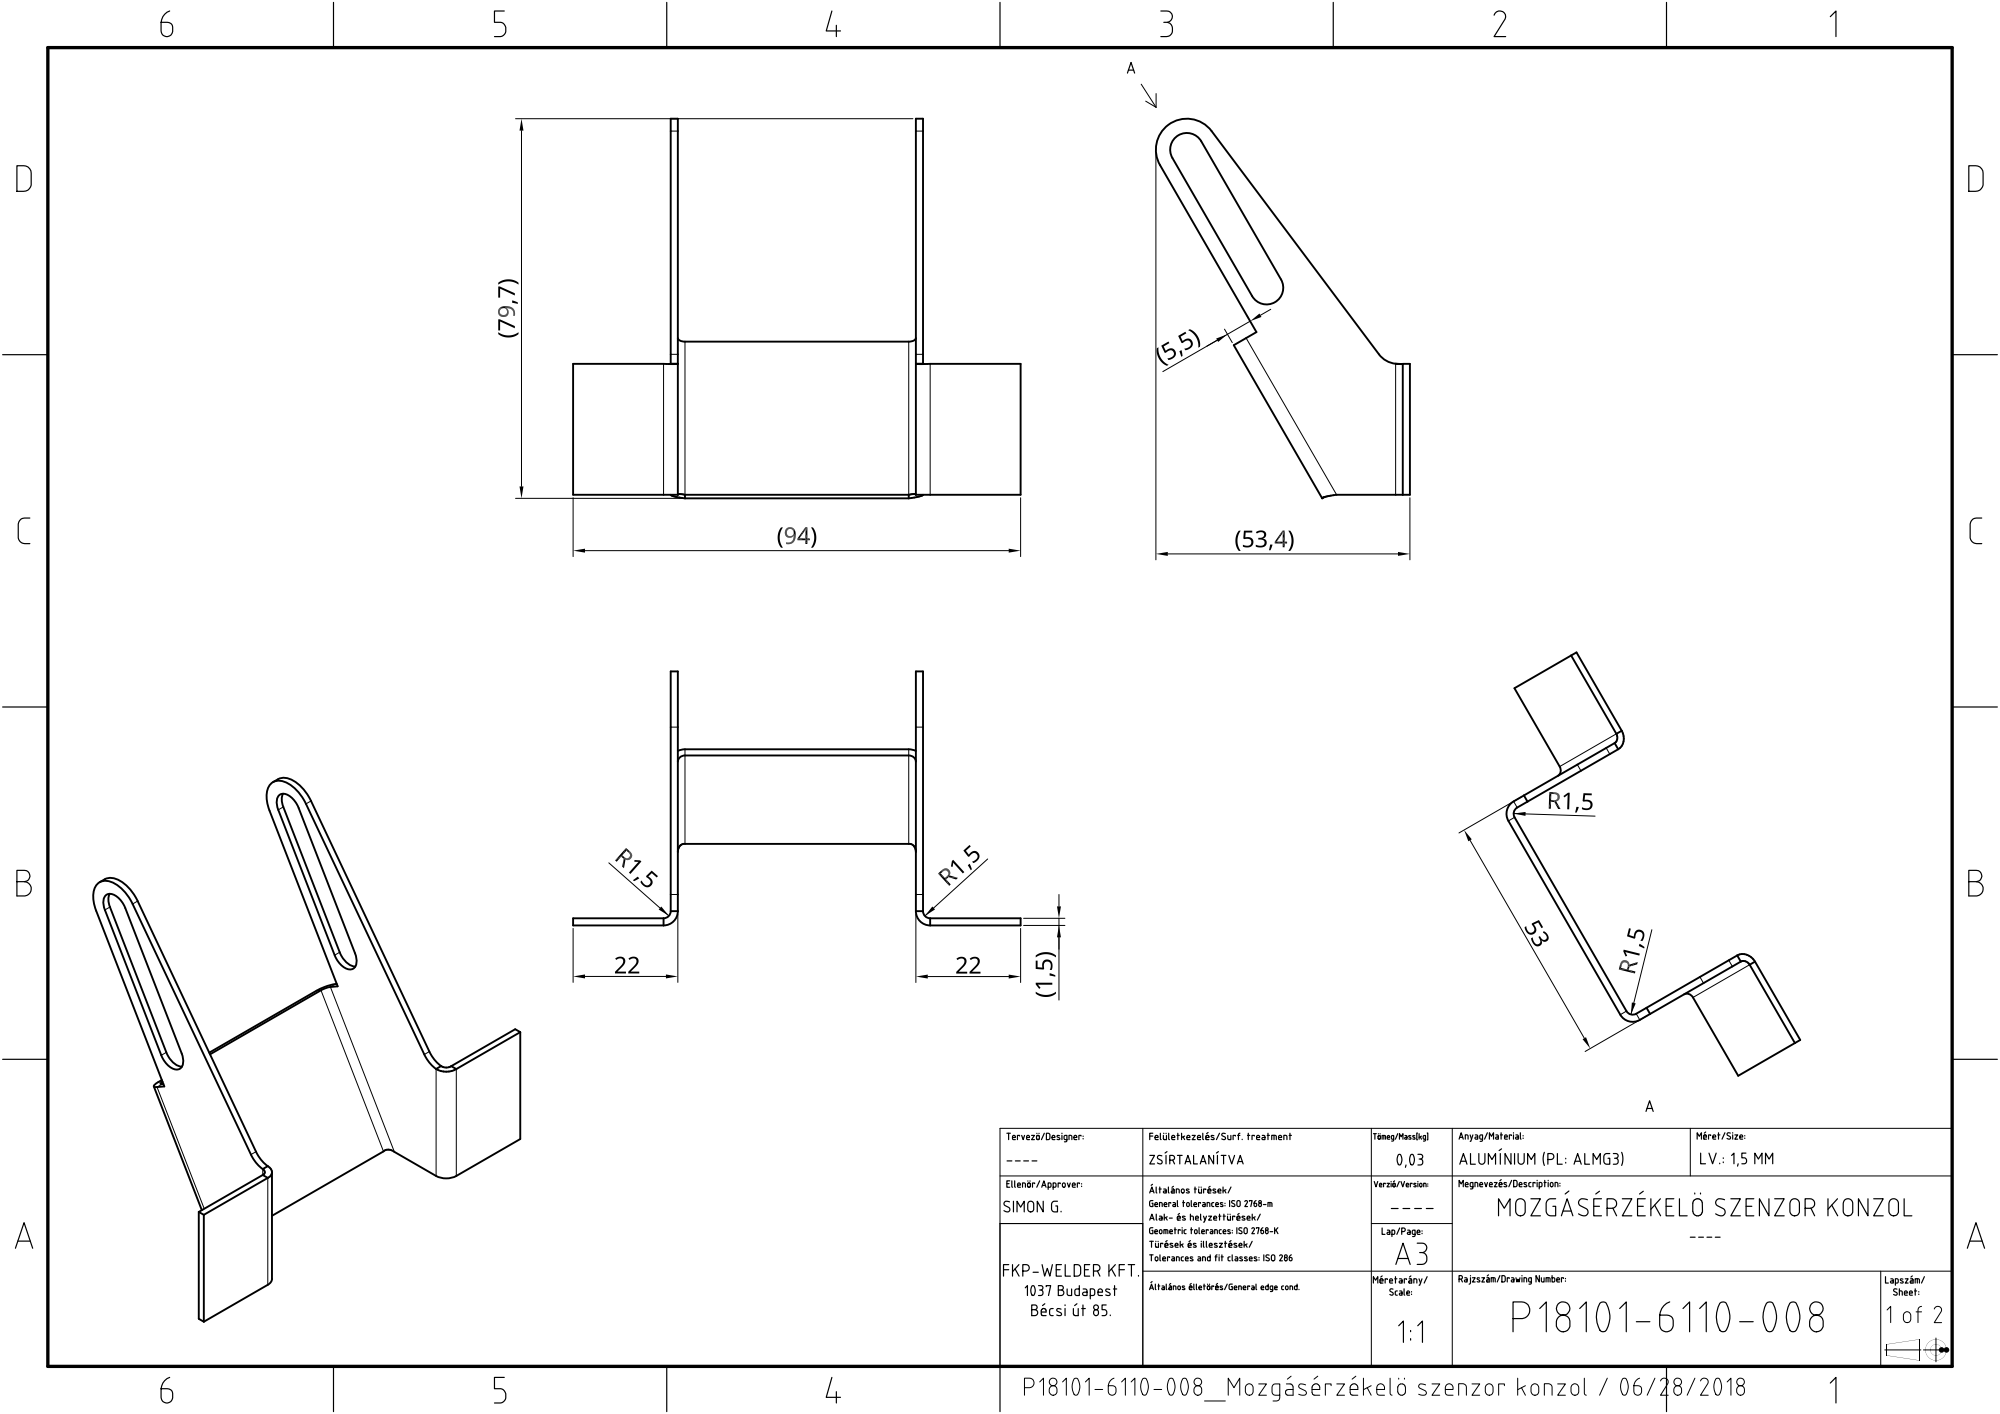
[picture p44: page 1]
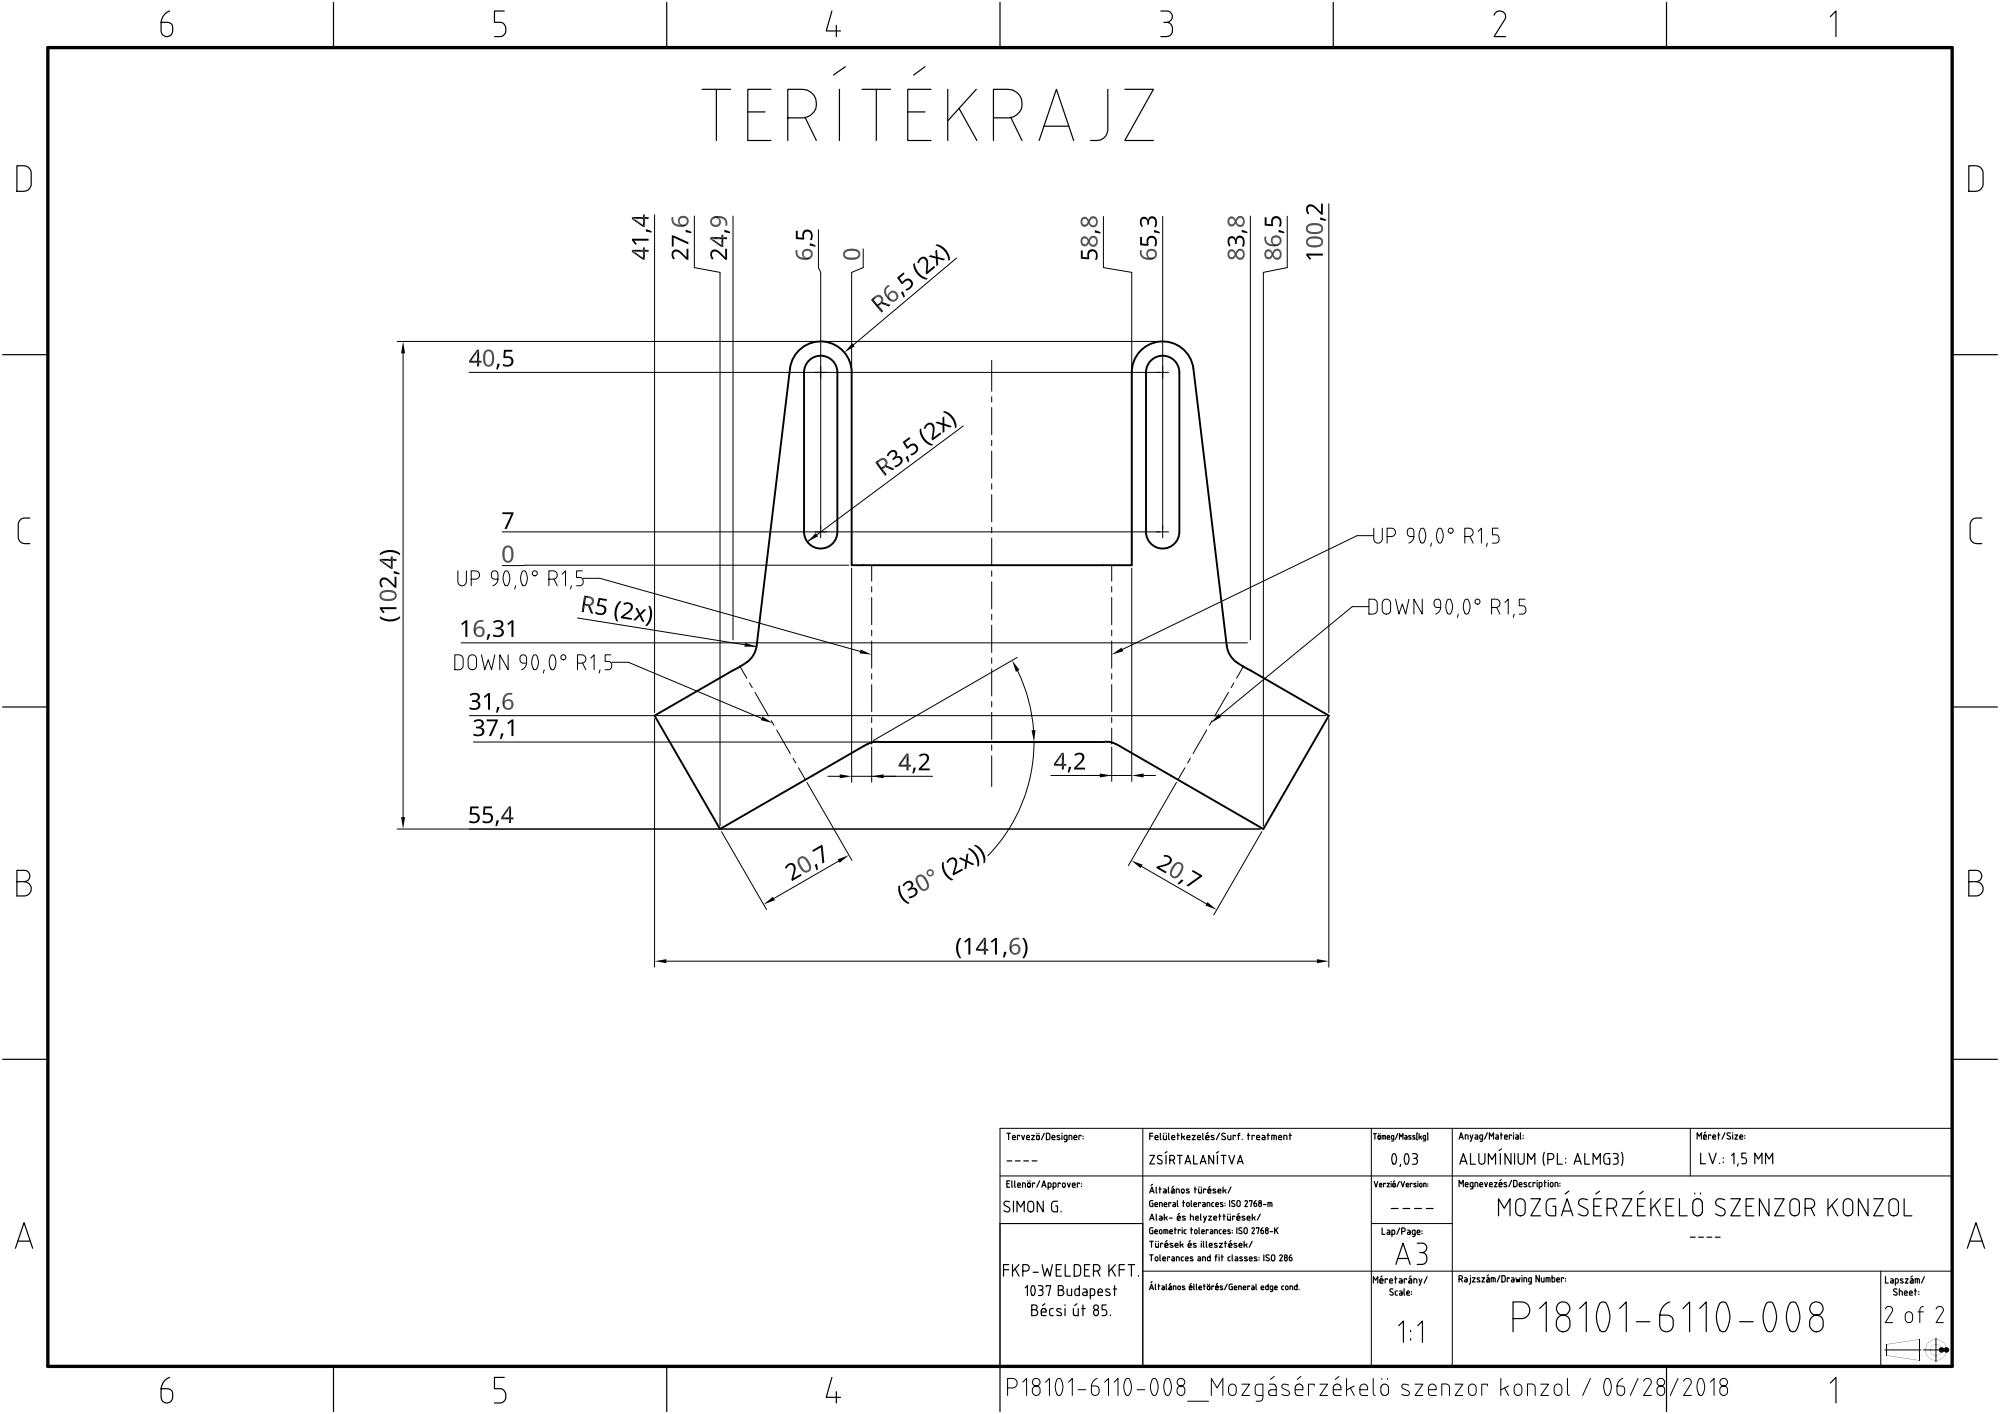
[picture p45: page 2]
