coderlazar/Metta-Pet/Tervrajzok/elhajlított alkatrészek/P18101-6210-001_Középsö felsö burkolat.pdf

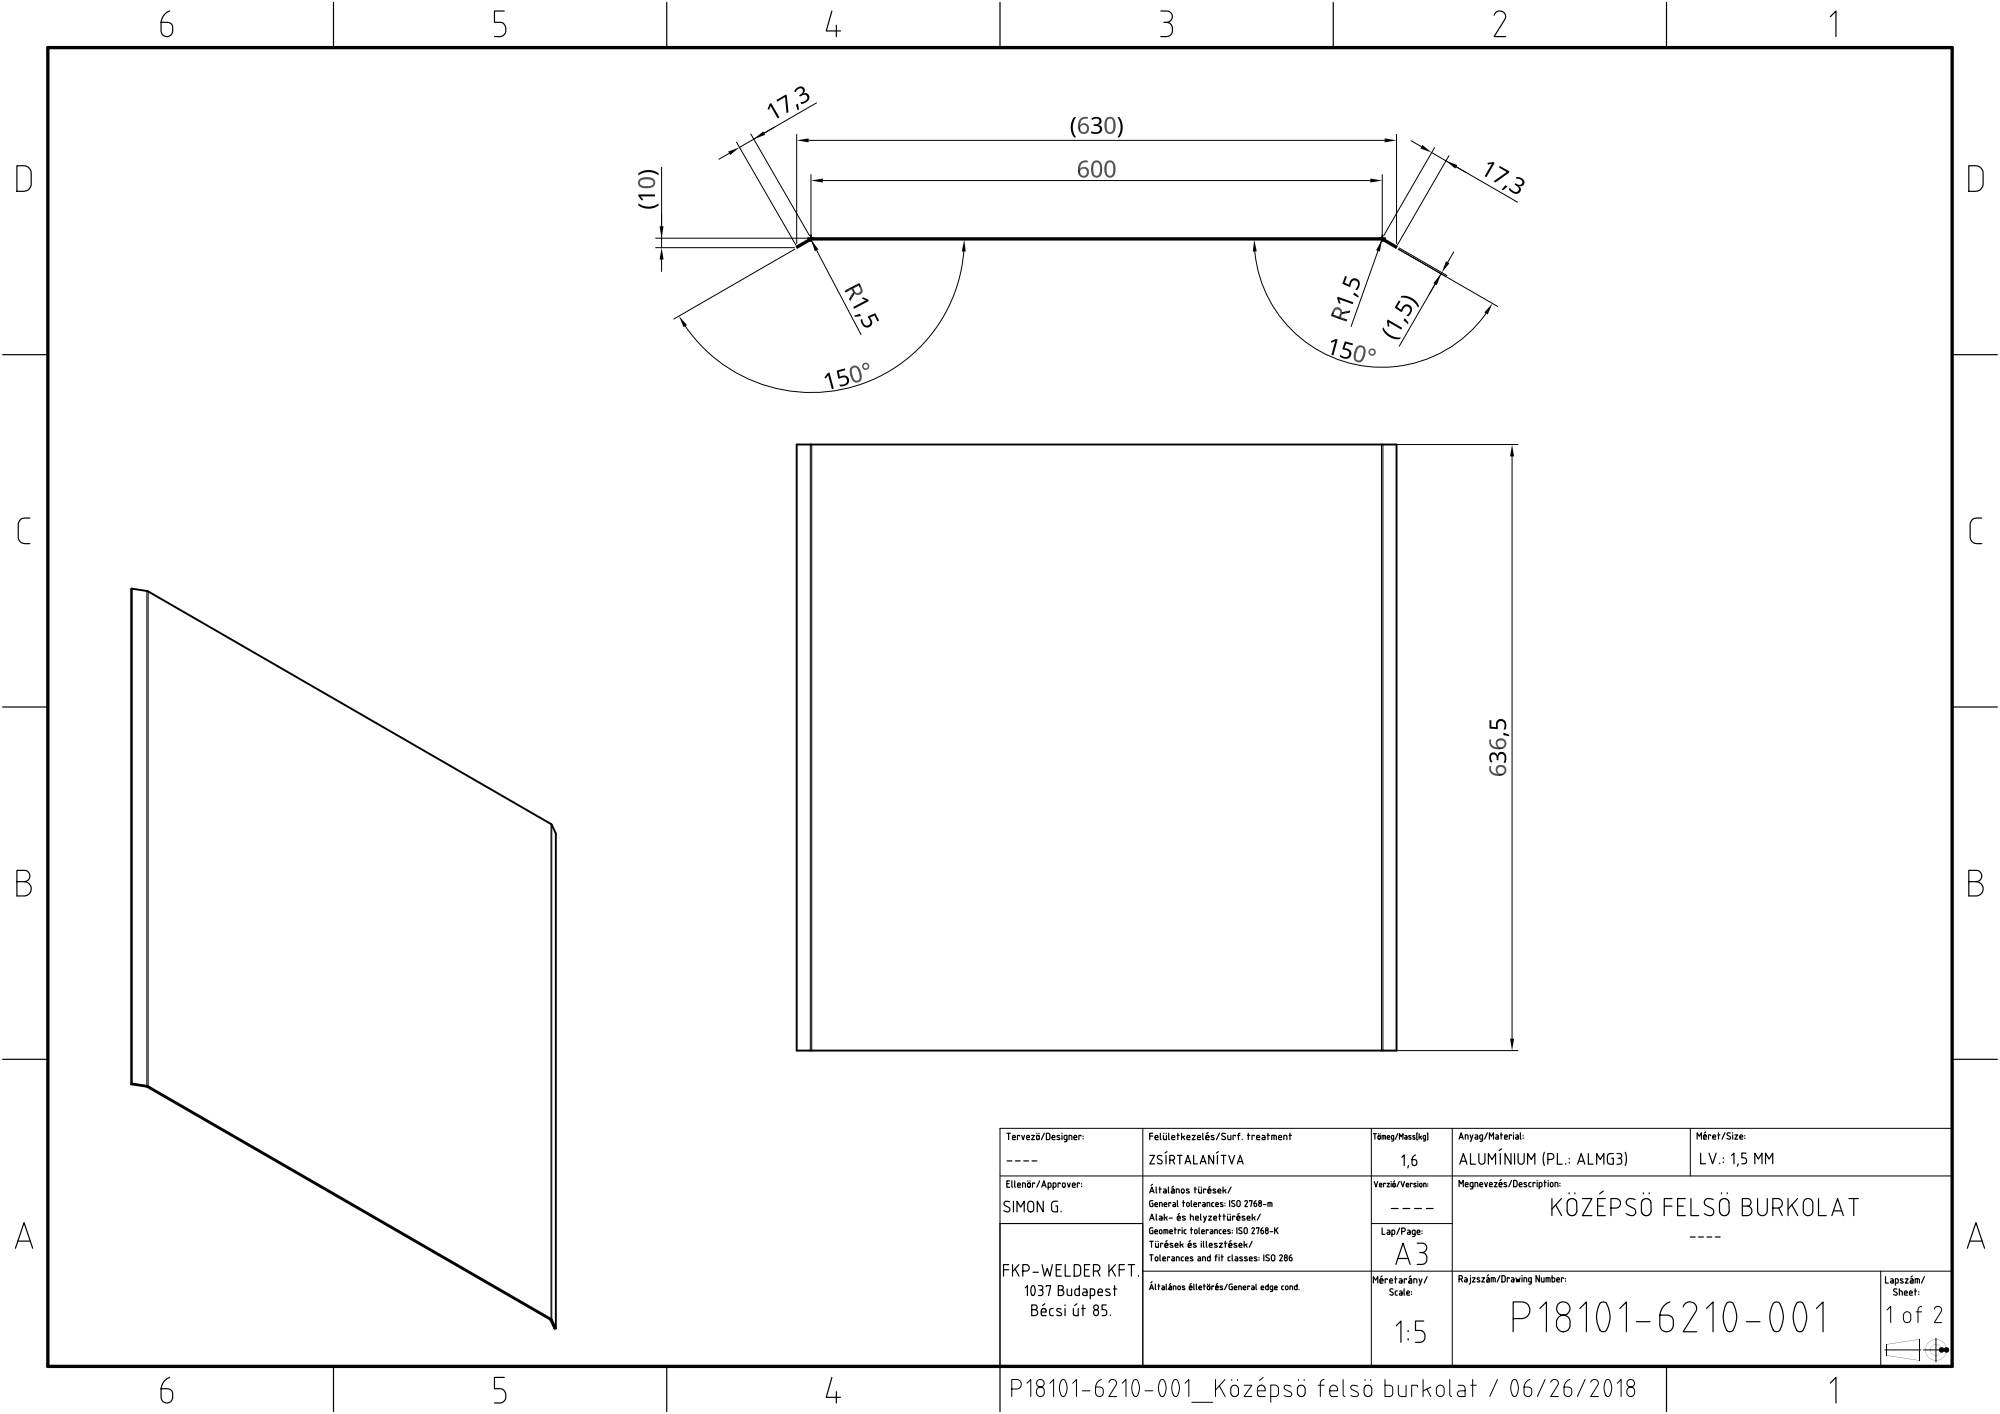
[picture p46: page 1]
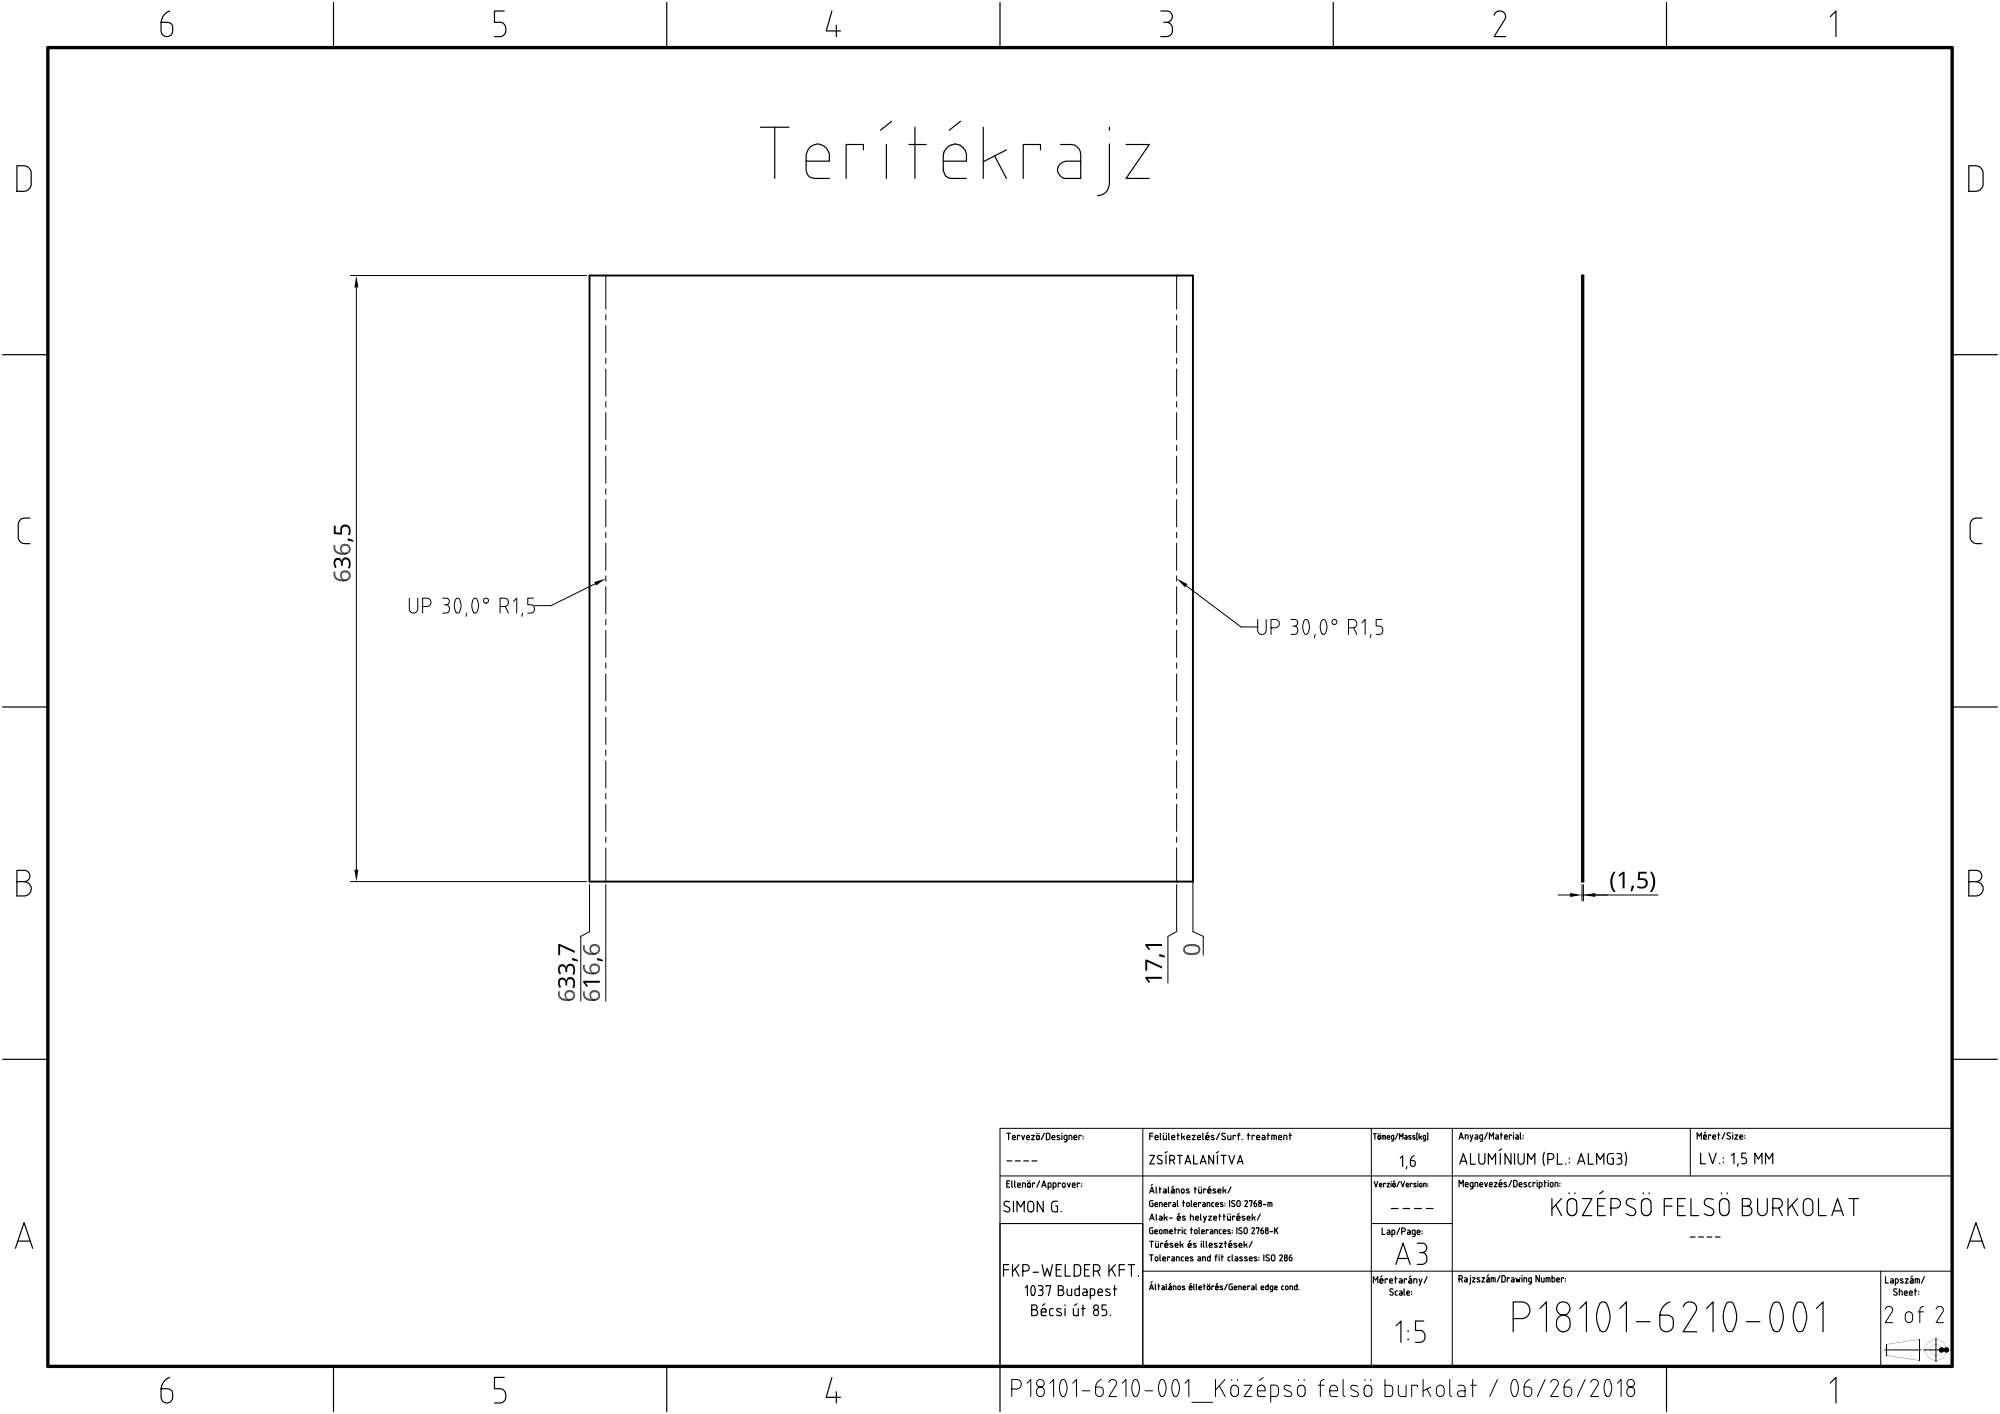
[picture p47: page 2]
