coderlazar/Metta-Pet/Tervrajzok/elhajlított alkatrészek/P18101-6300-002_Ajtó oldal lemez.pdf

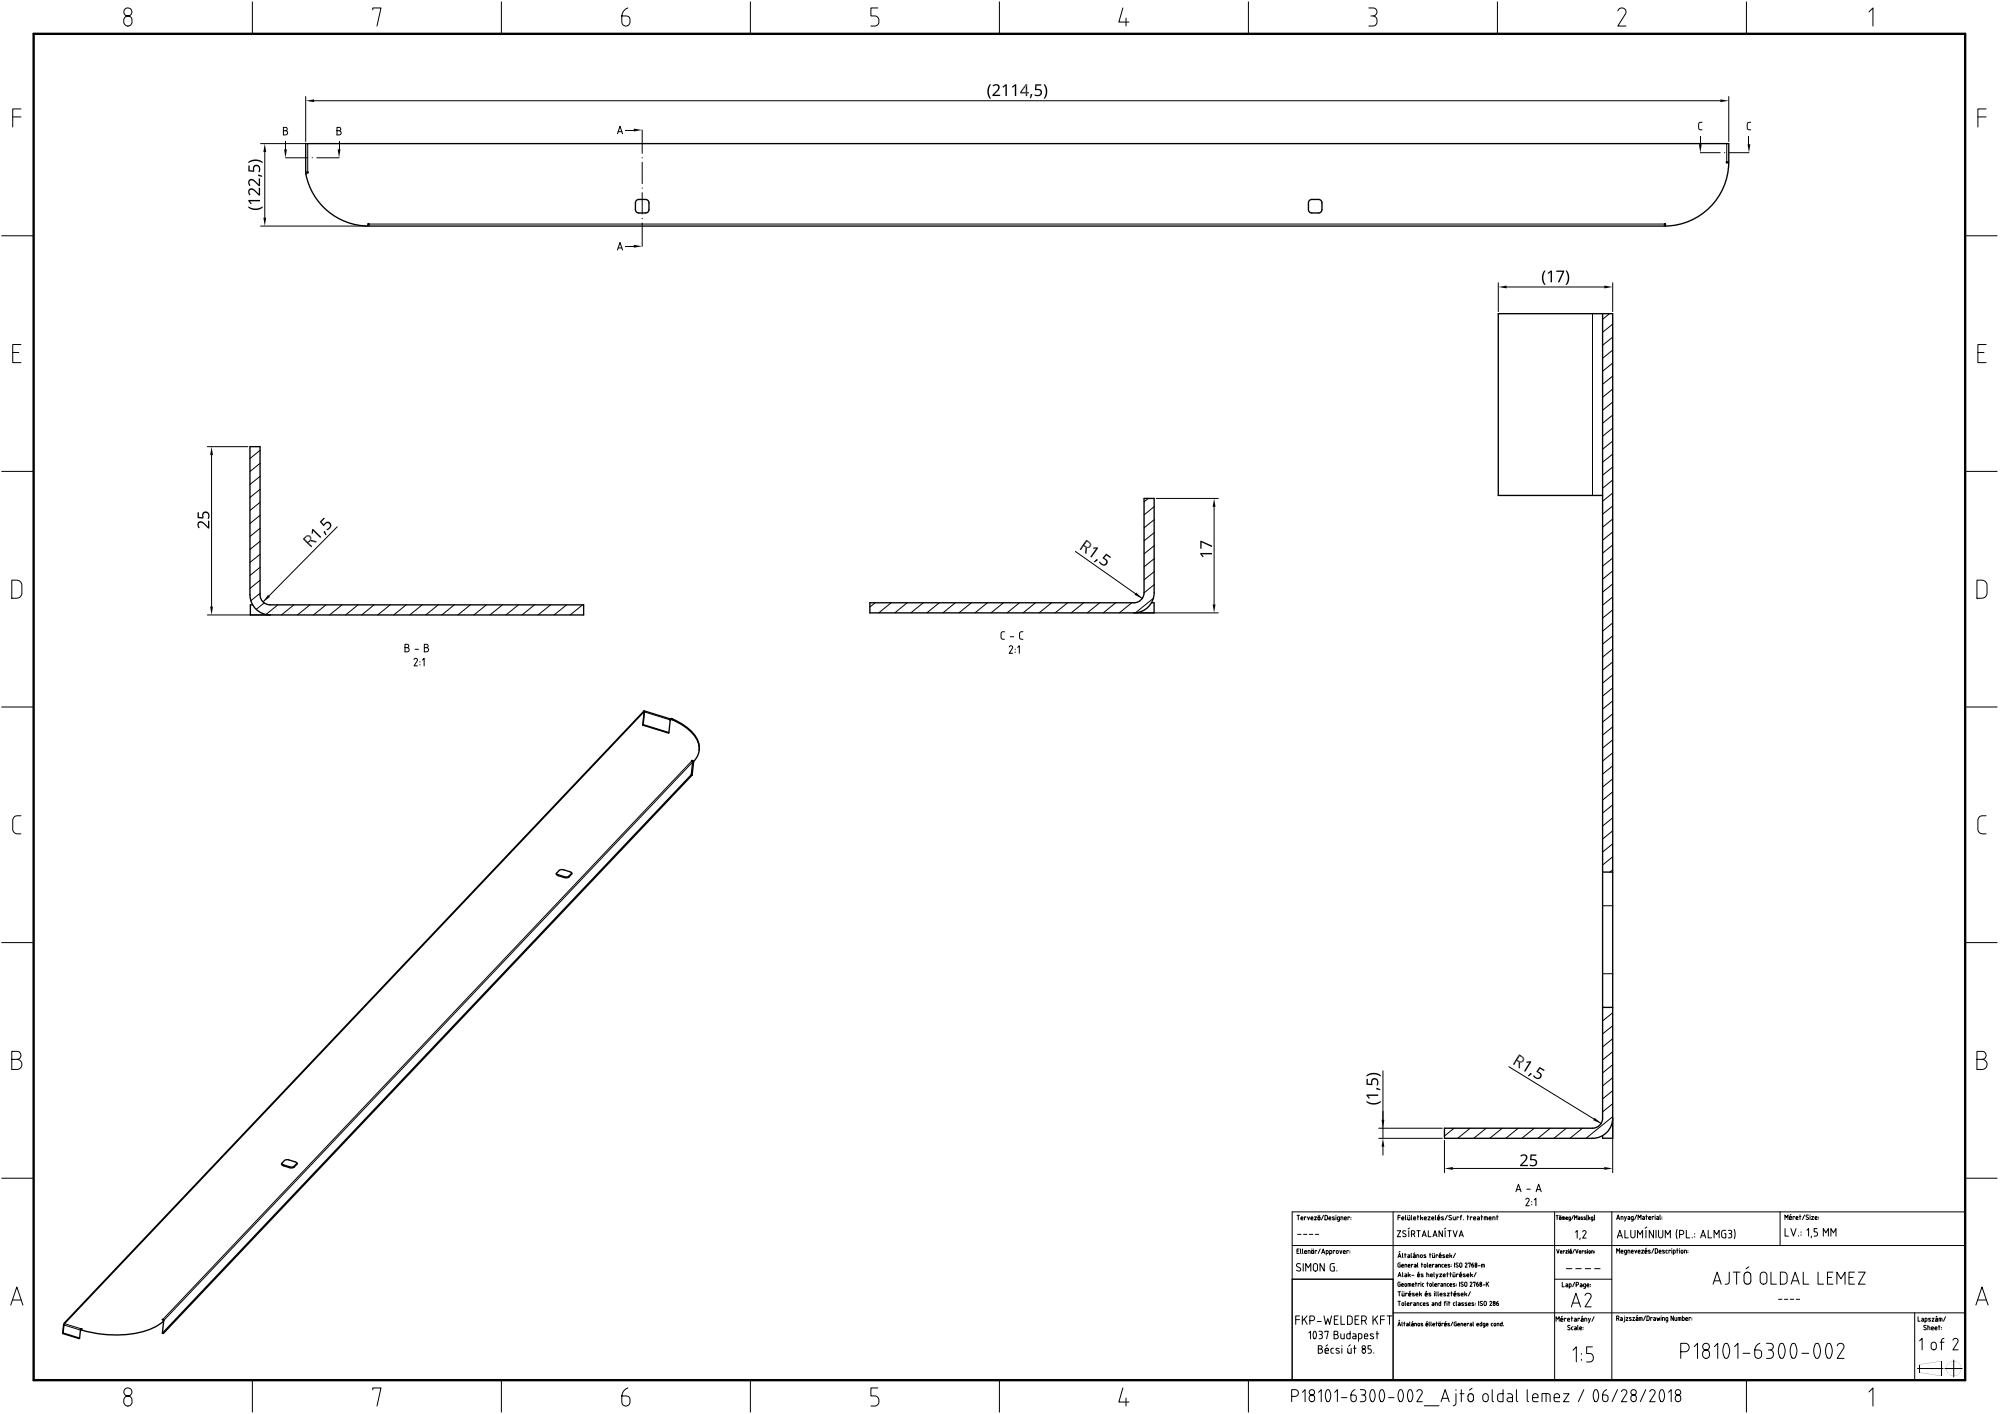
[picture p48: page 1]
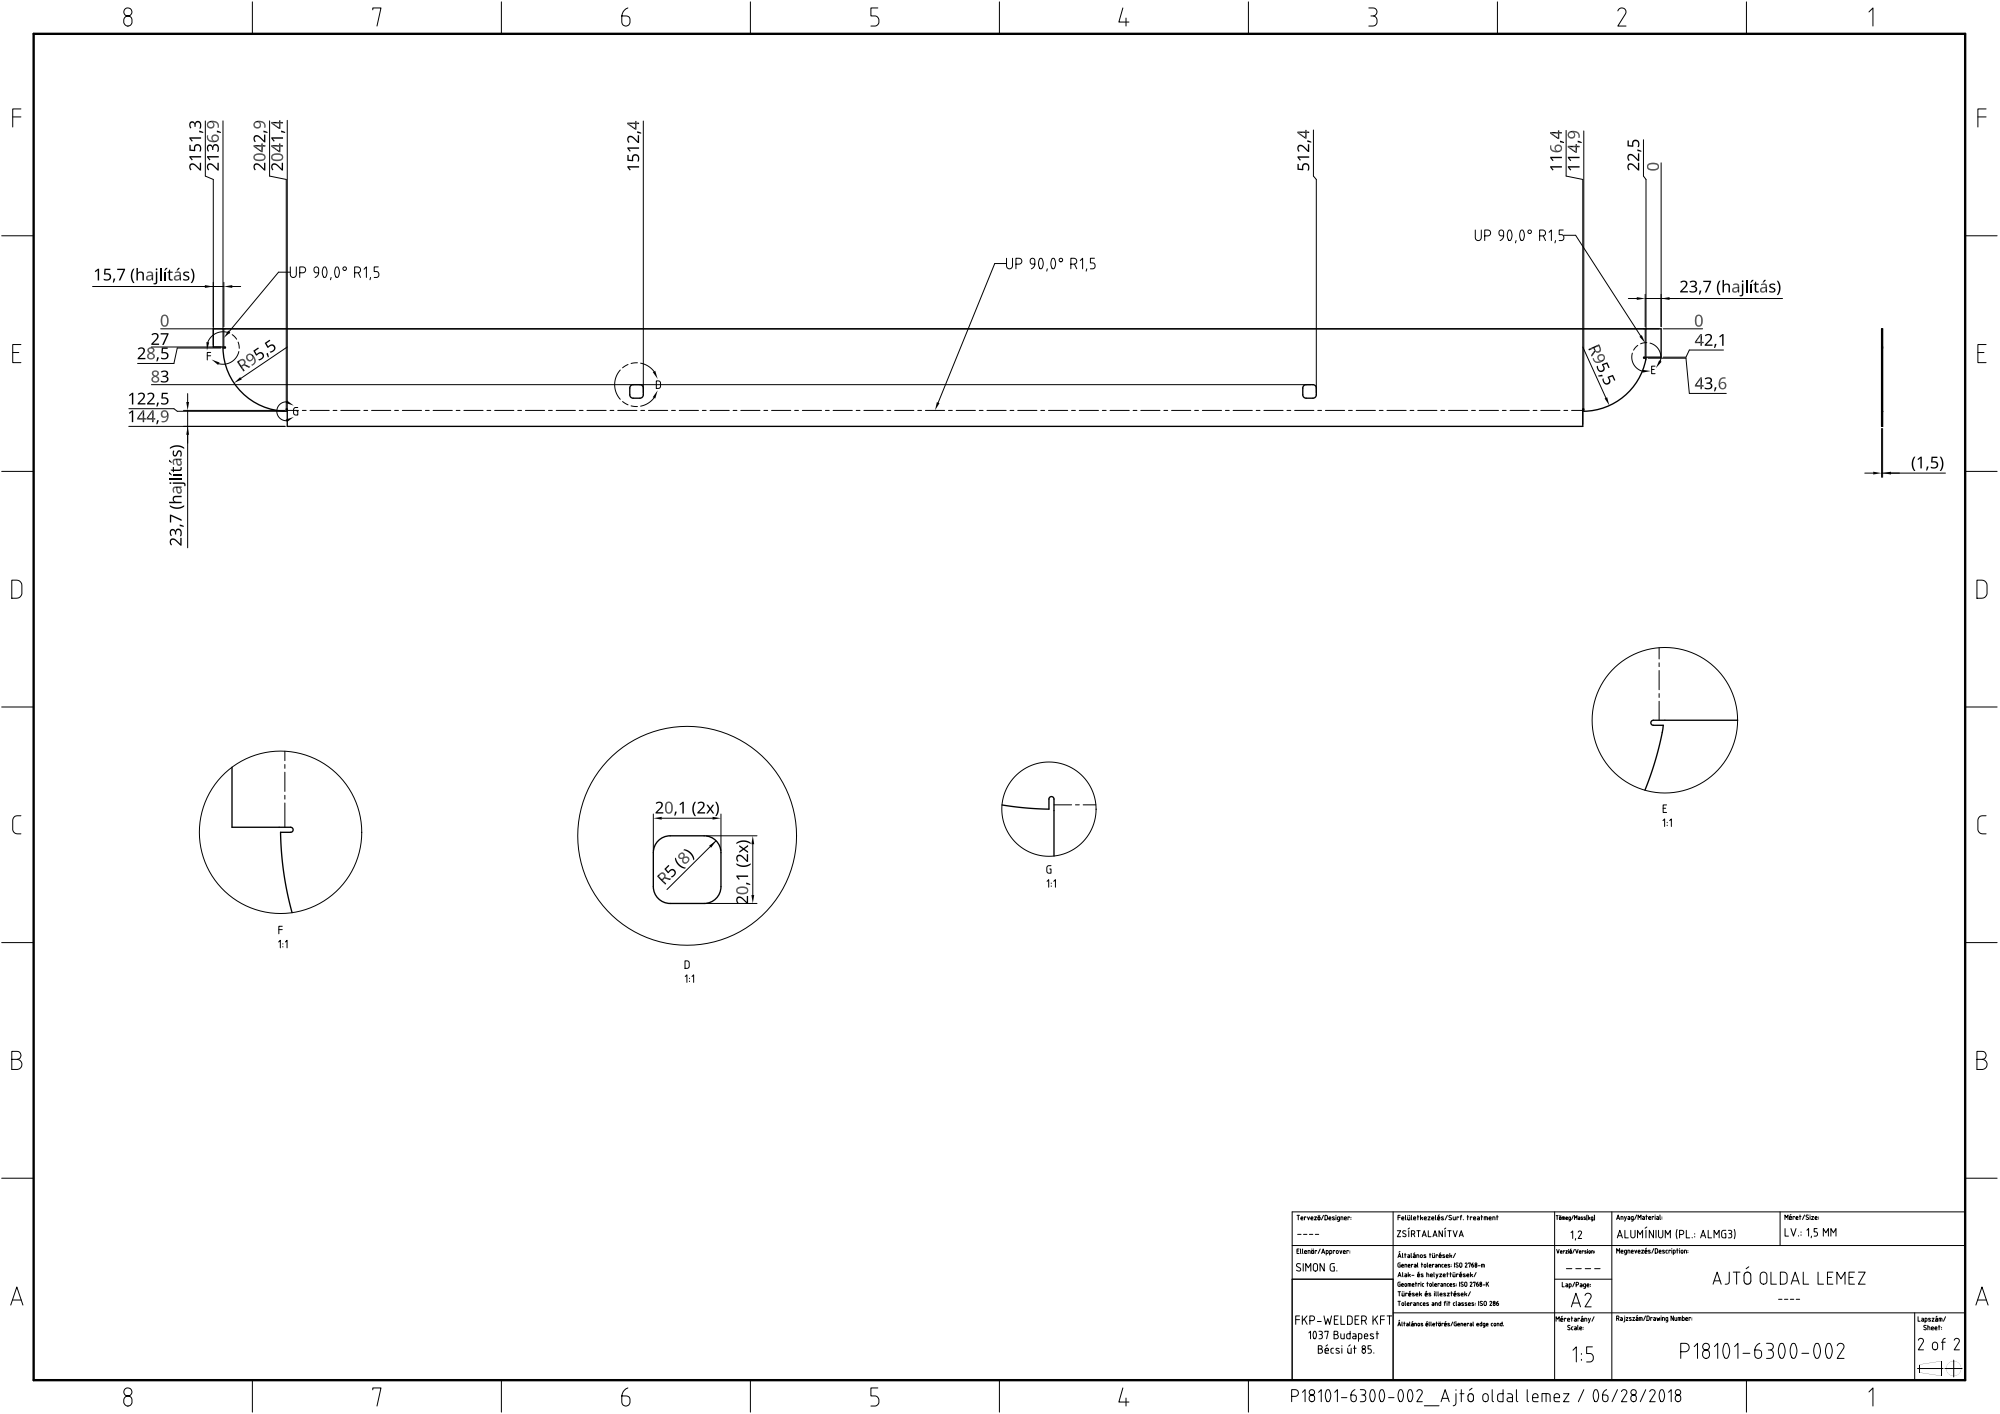
[picture p49: page 2]
