coderlazar/Metta-Pet/Tervrajzok/elhajlított alkatrészek/P18101-6410-001_Bal oldal lemez burkolat.pdf

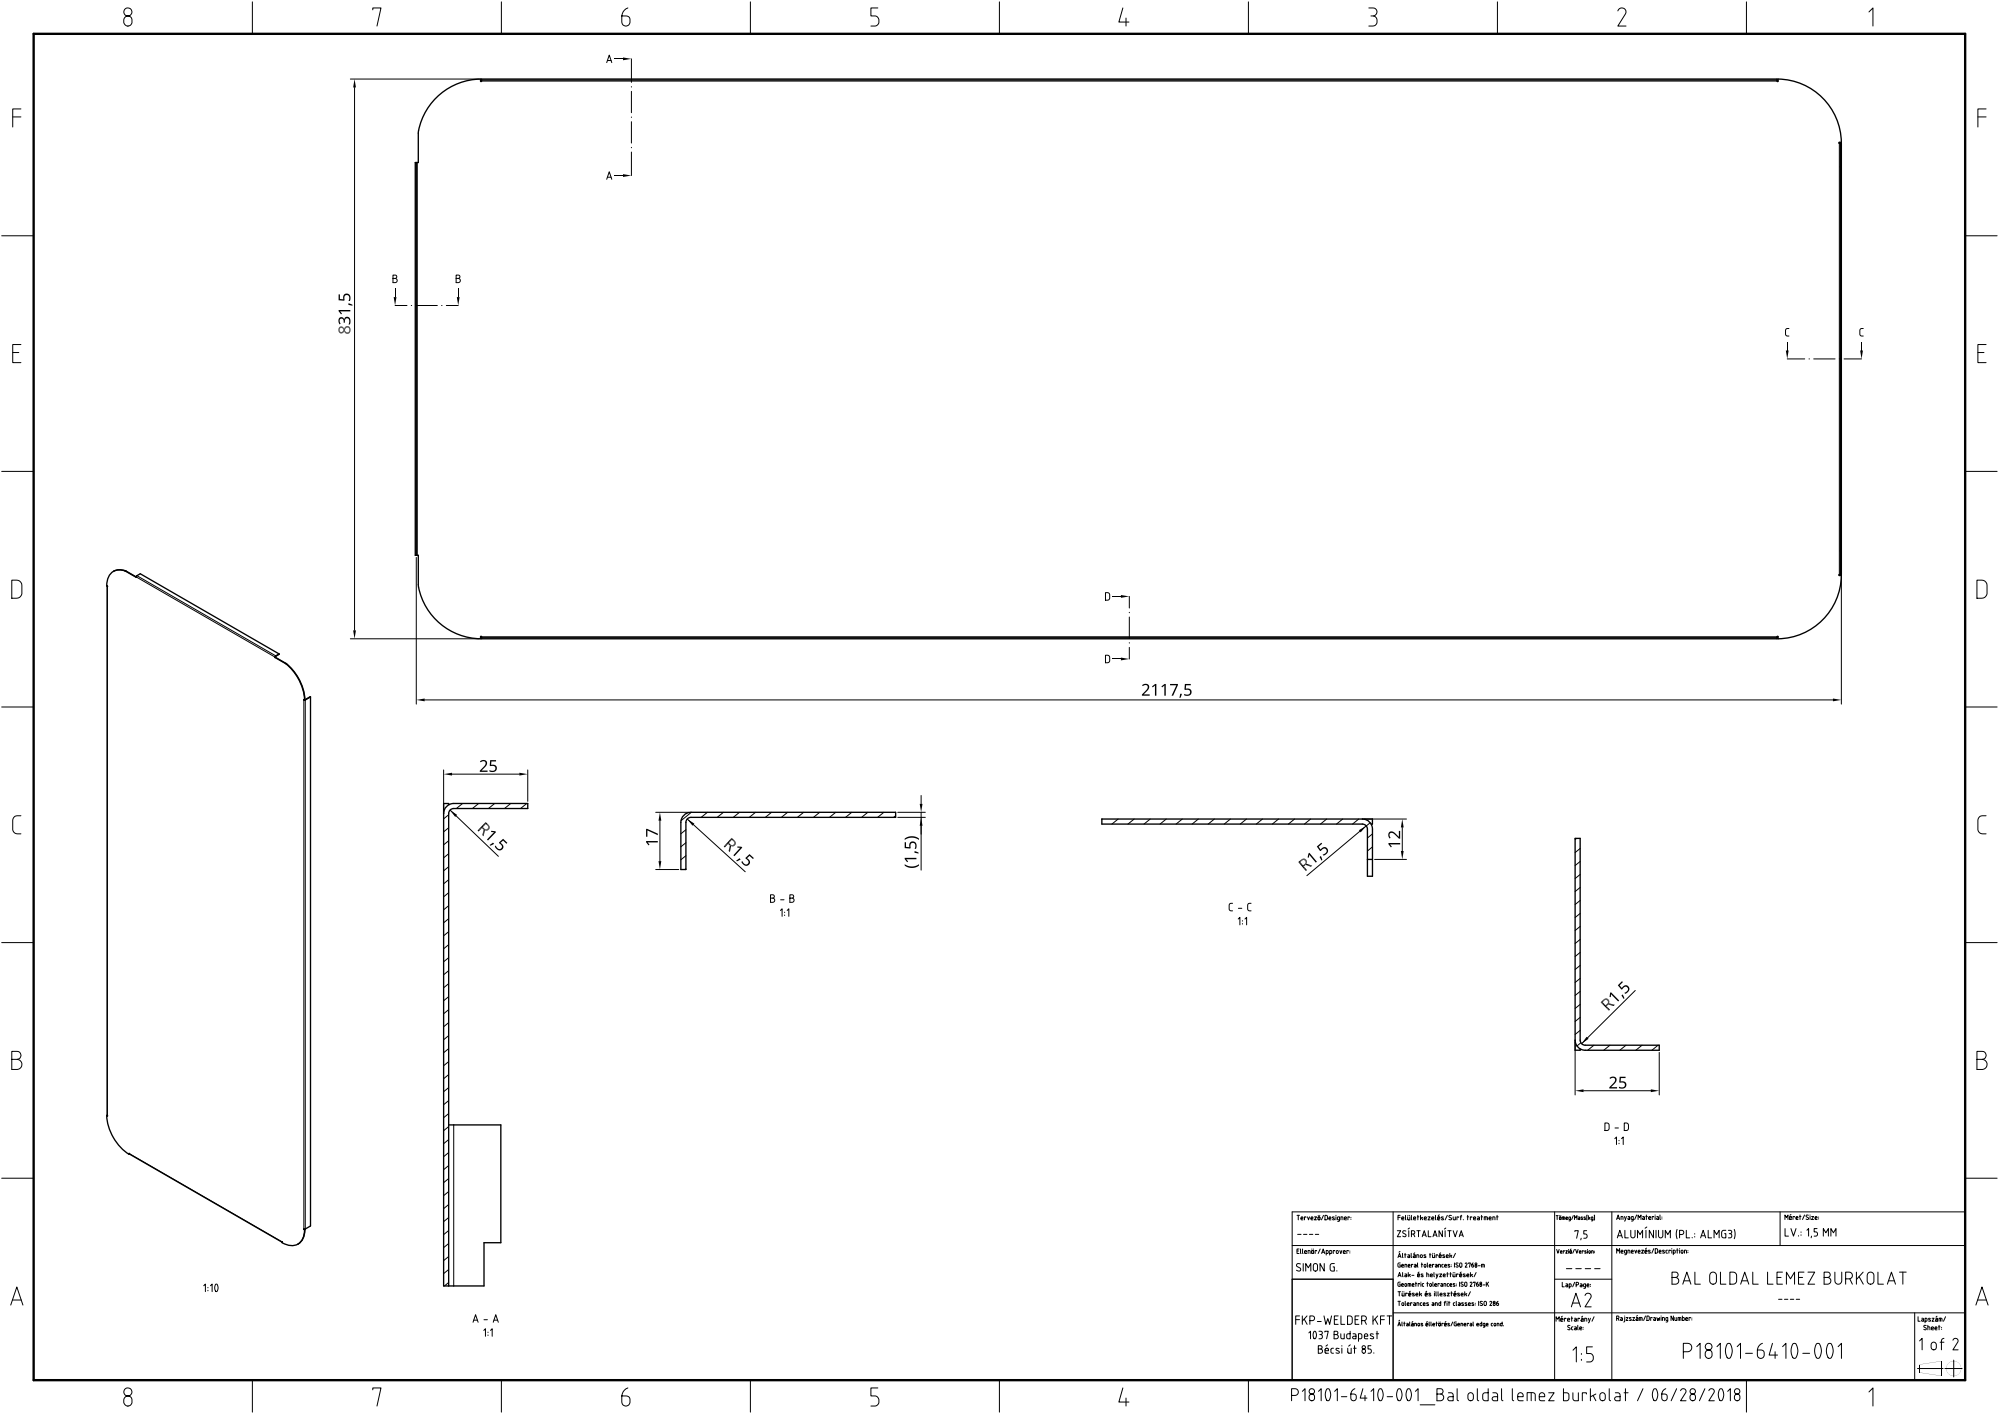
[picture p50: page 1]
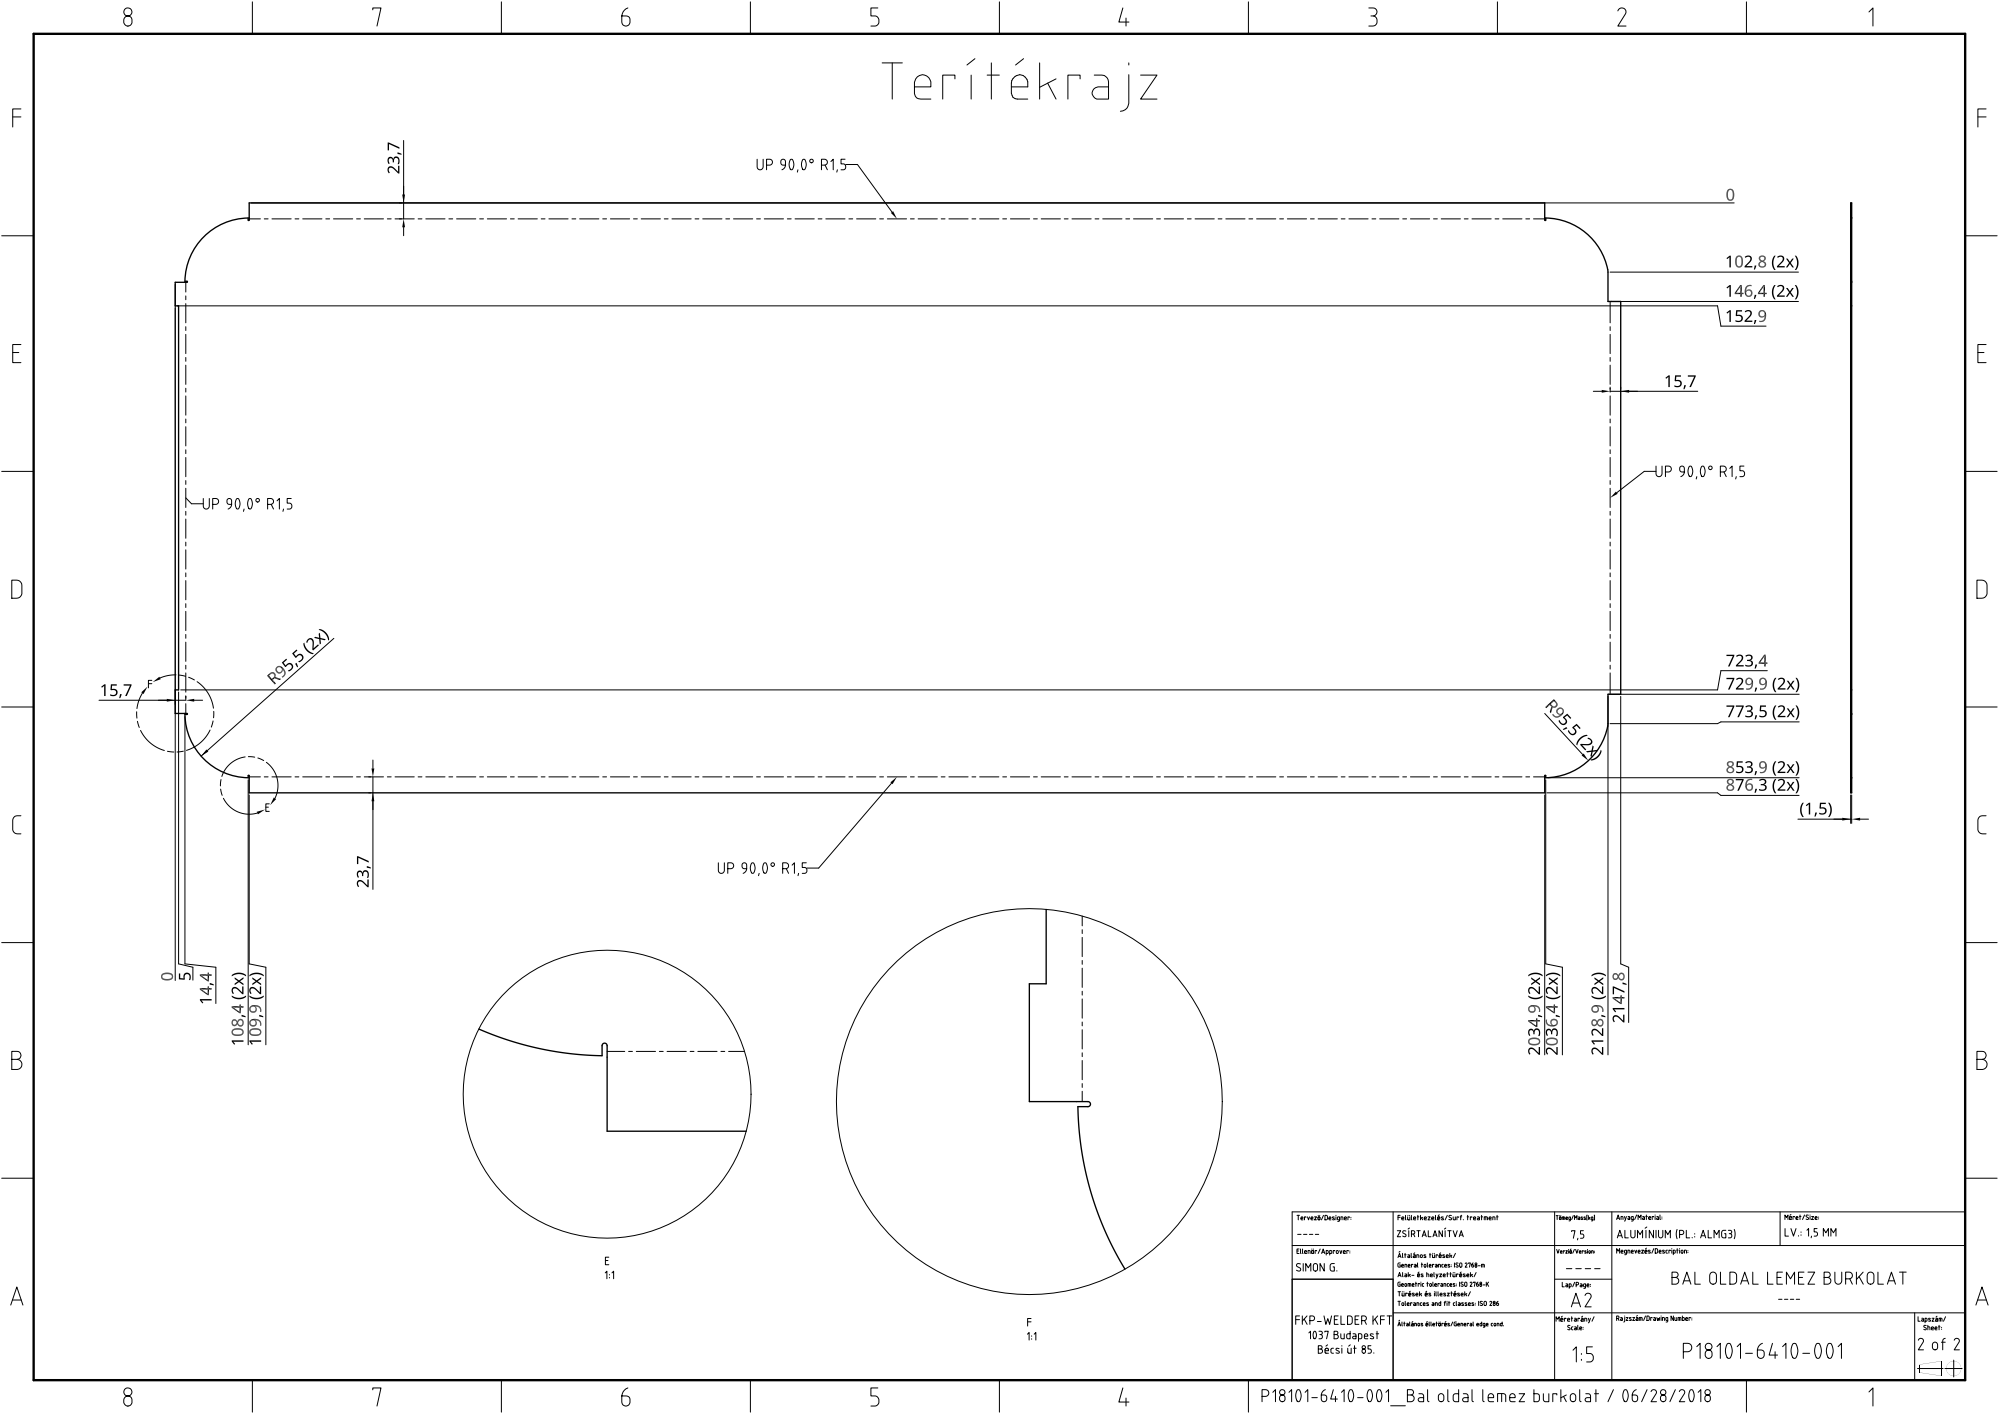
[picture p51: page 2]
