coderlazar/Metta-Pet/Tervrajzok/forgácsolt alkatrészek/P18101-1100-004_fogasrúd.pdf

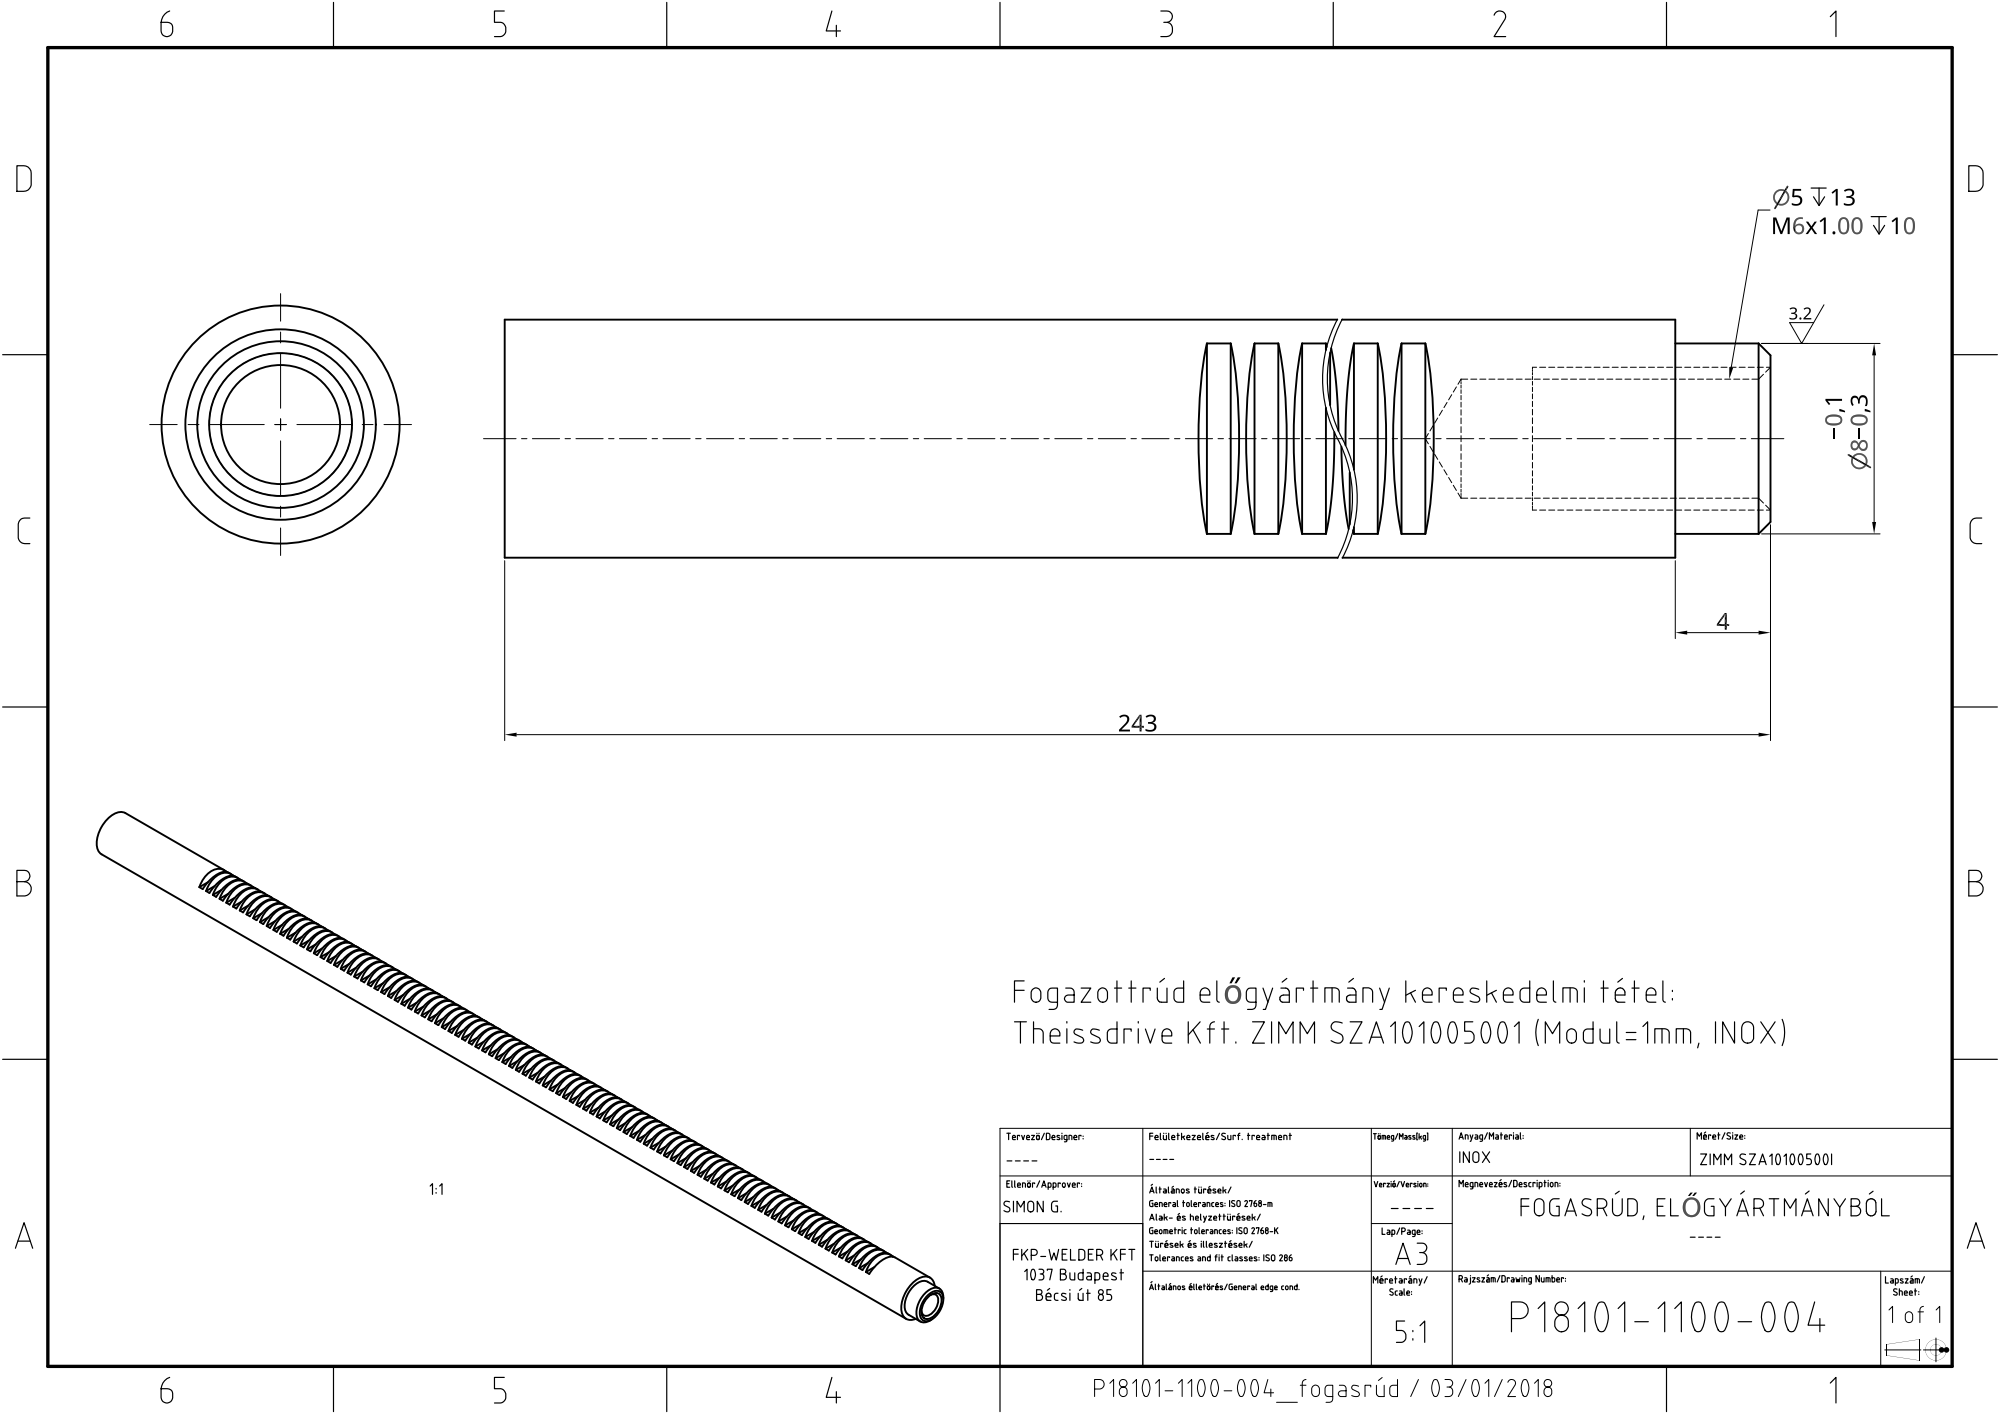
[picture p52: page 1]
