coderlazar/Metta-Pet/Tervrajzok/forgácsolt alkatrészek/P18101-4200-002_Ledobo_aktuátor_rögzitö_szem.pdf

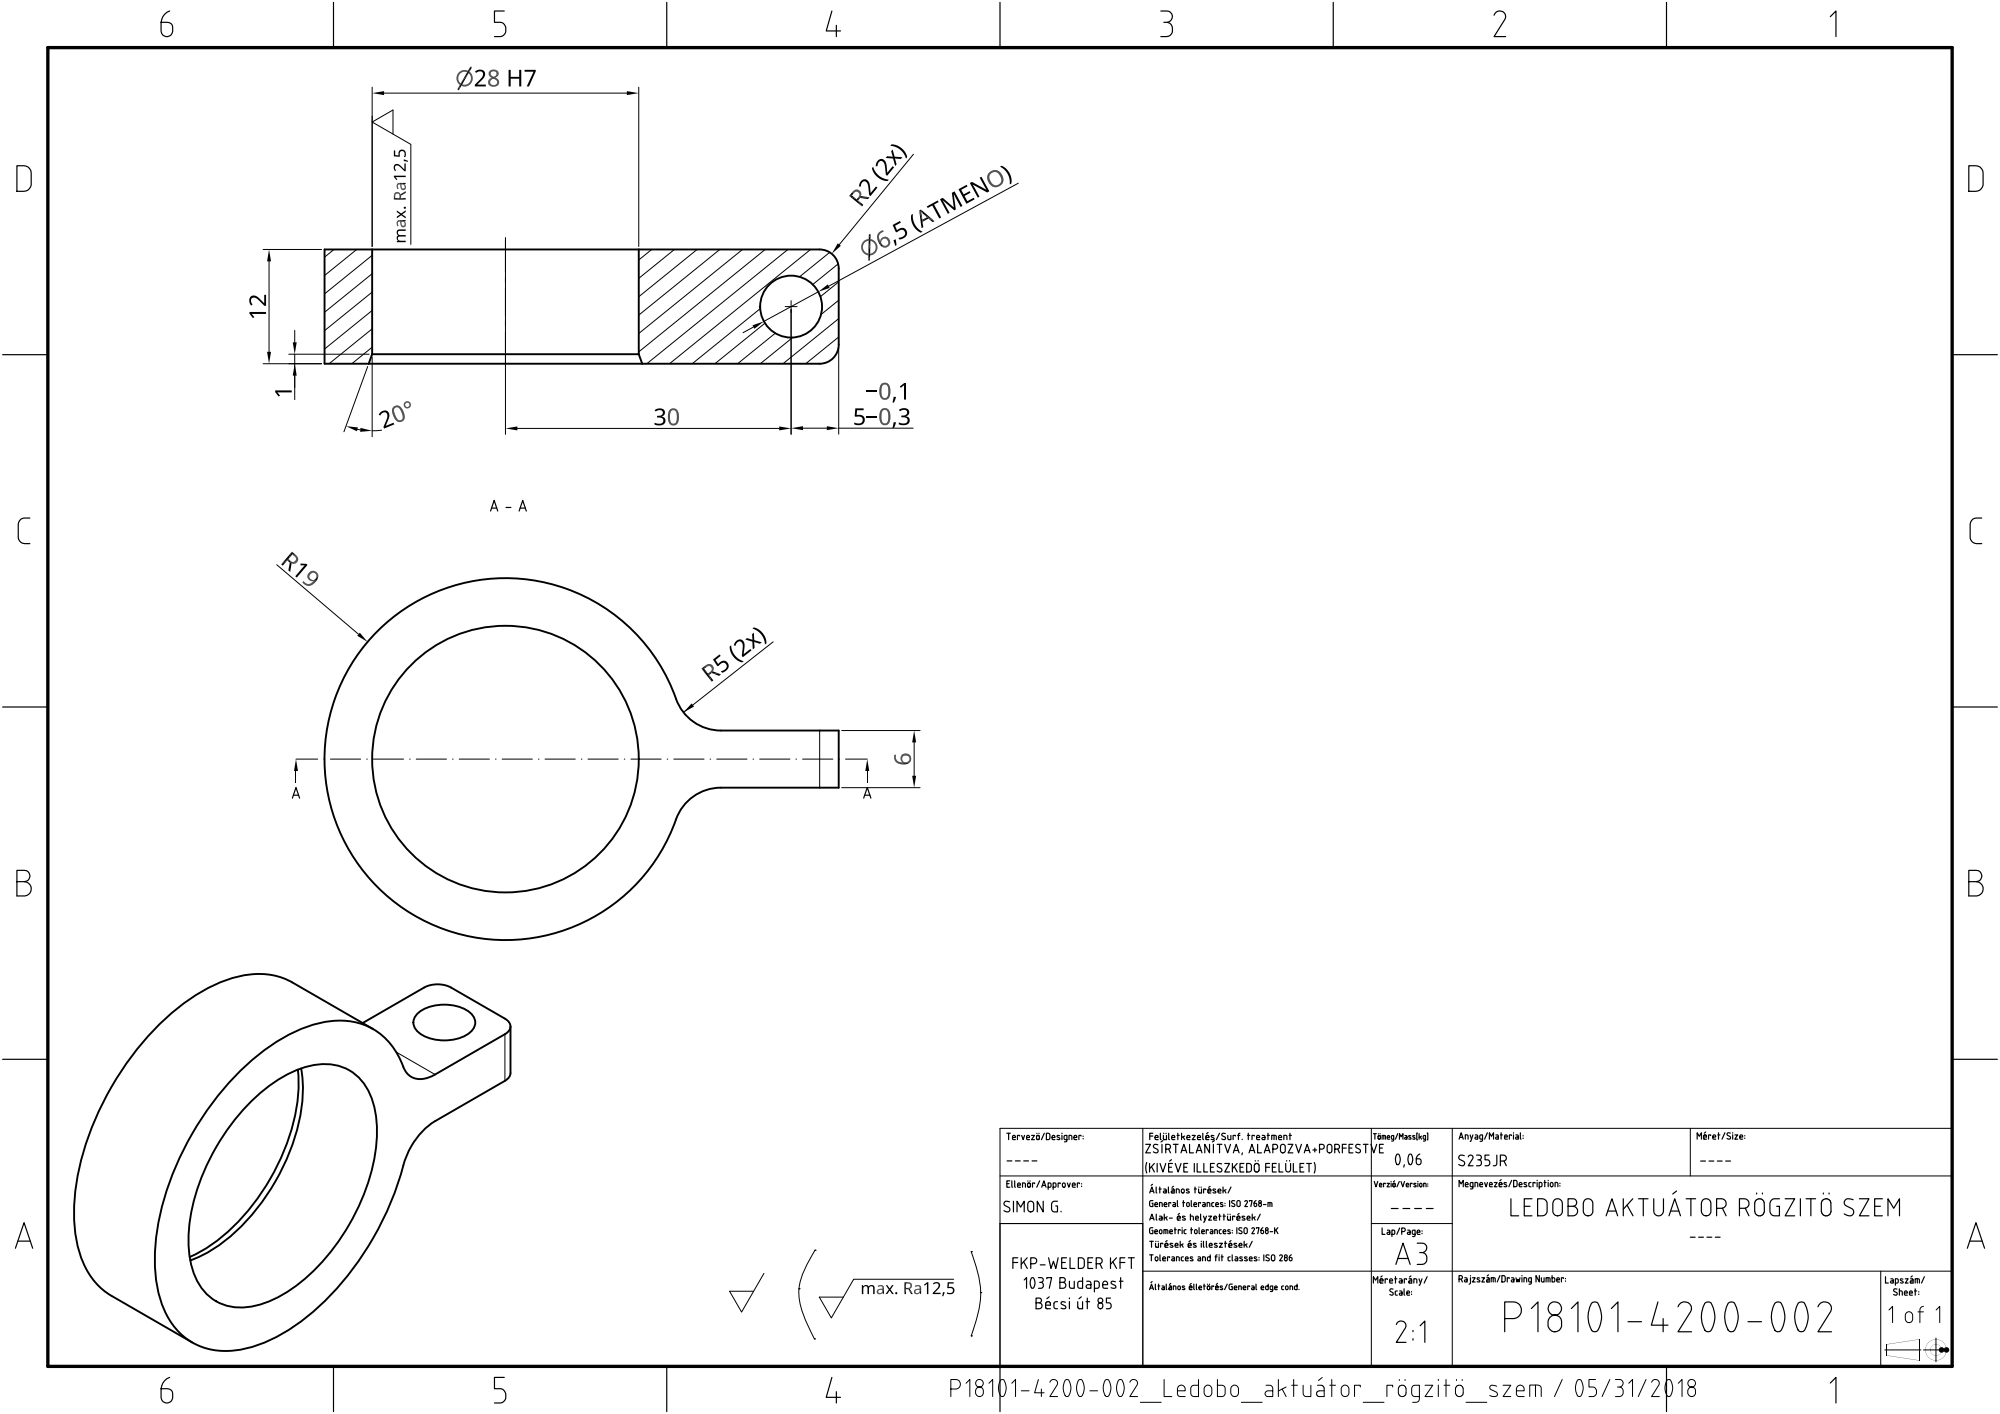
[picture p53: page 1]
