coderlazar/Metta-Pet/Tervrajzok/forgácsolt alkatrészek/P18101-4200-003_Ledobo_összekötö_rud.pdf

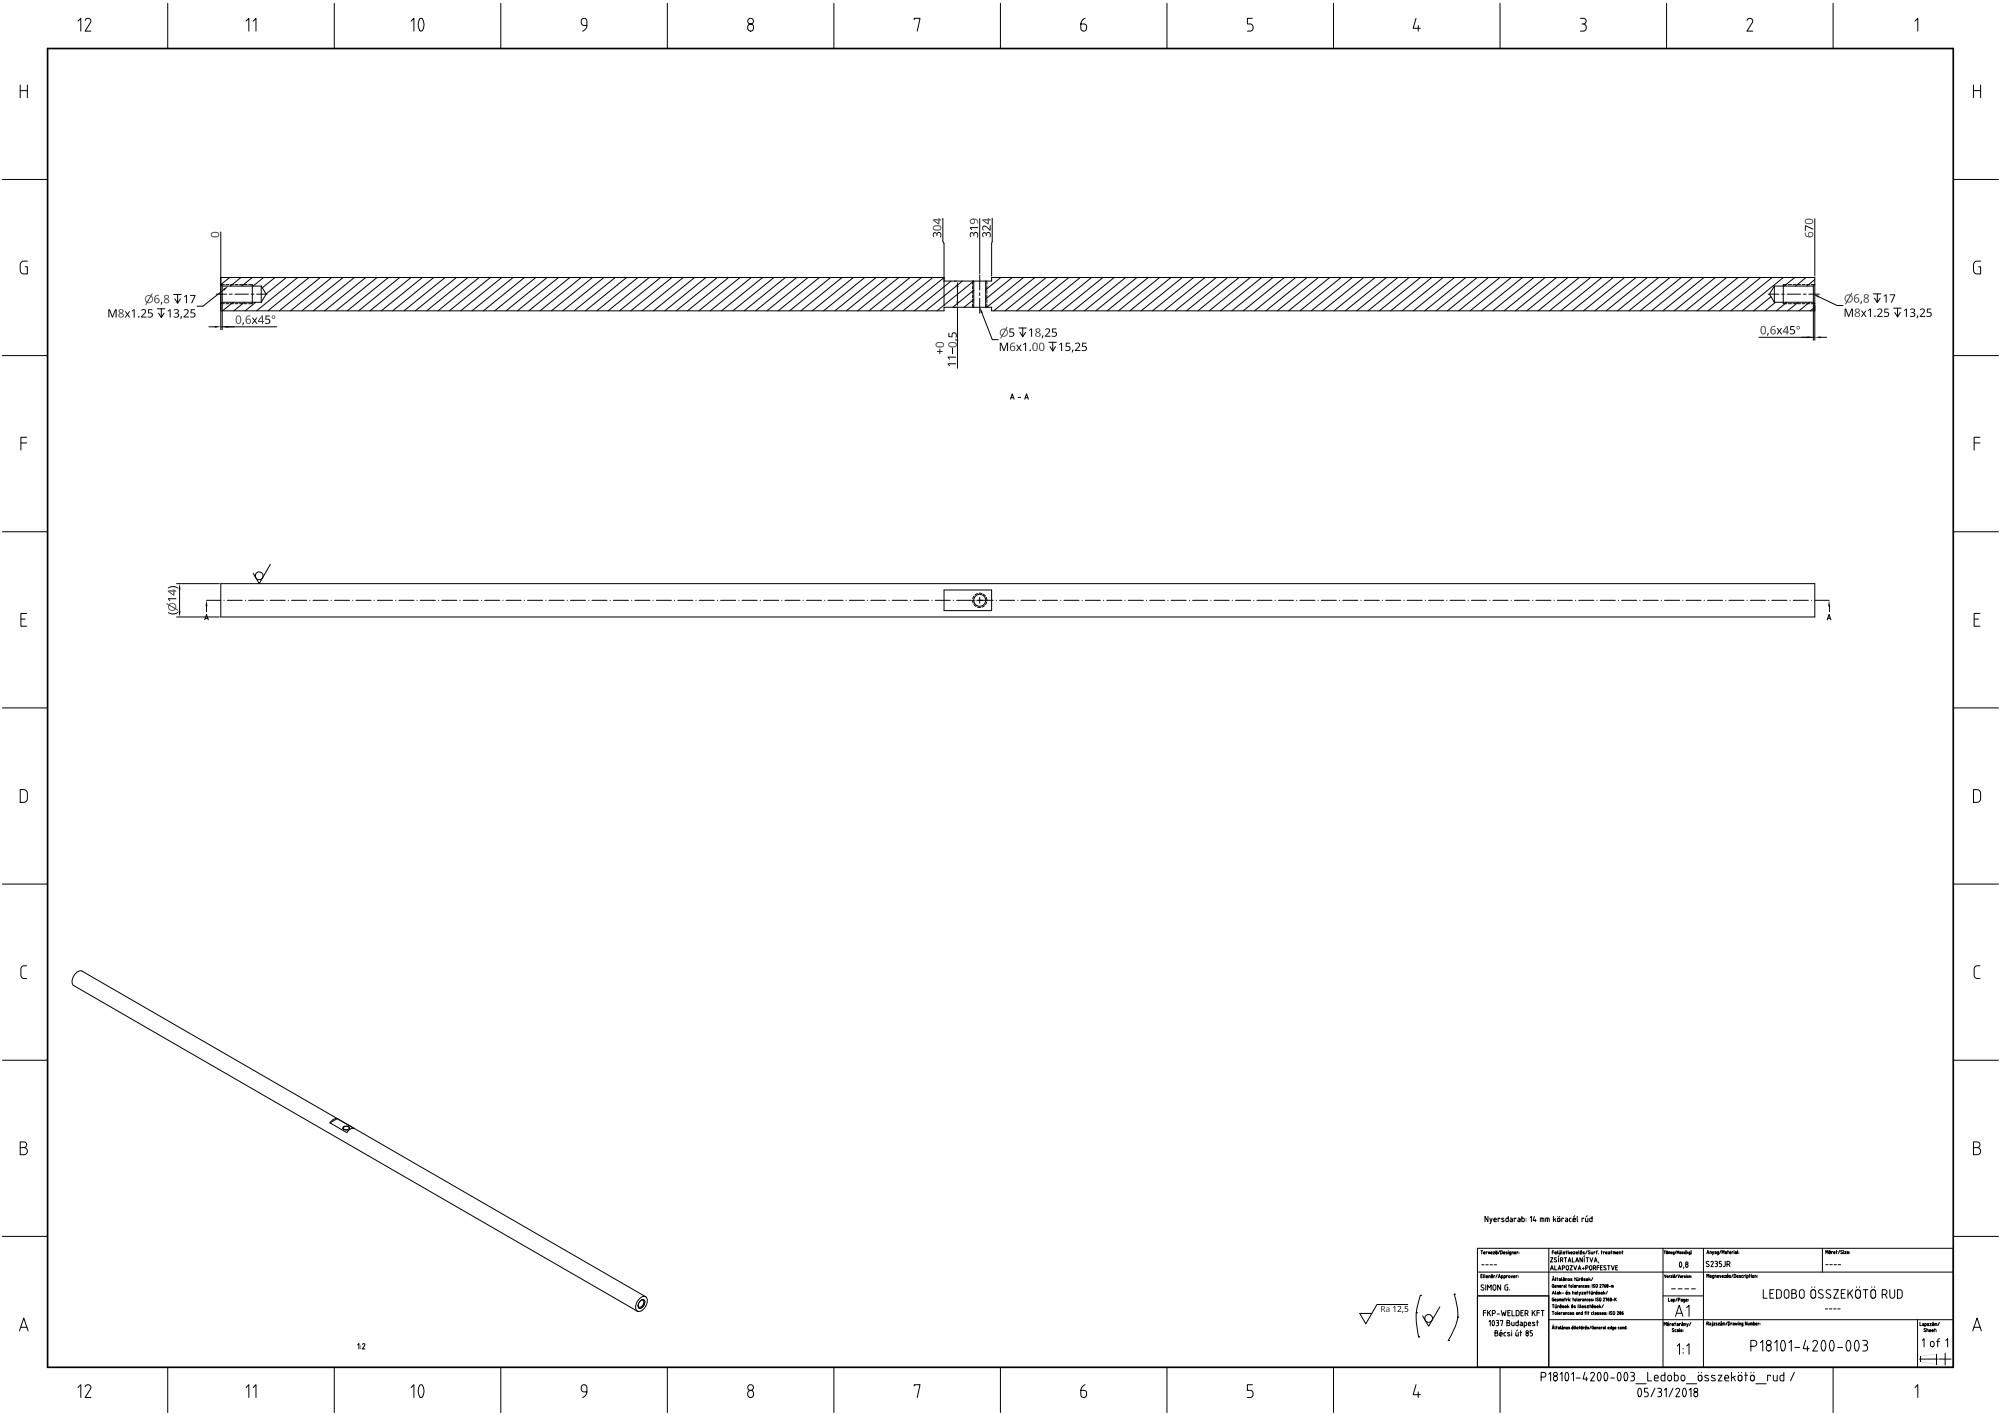
[picture p54: page 1]
