coderlazar/Metta-Pet/Tervrajzok/forgácsolt alkatrészek/P18101-4200-004_Ledobo_hüvely.pdf

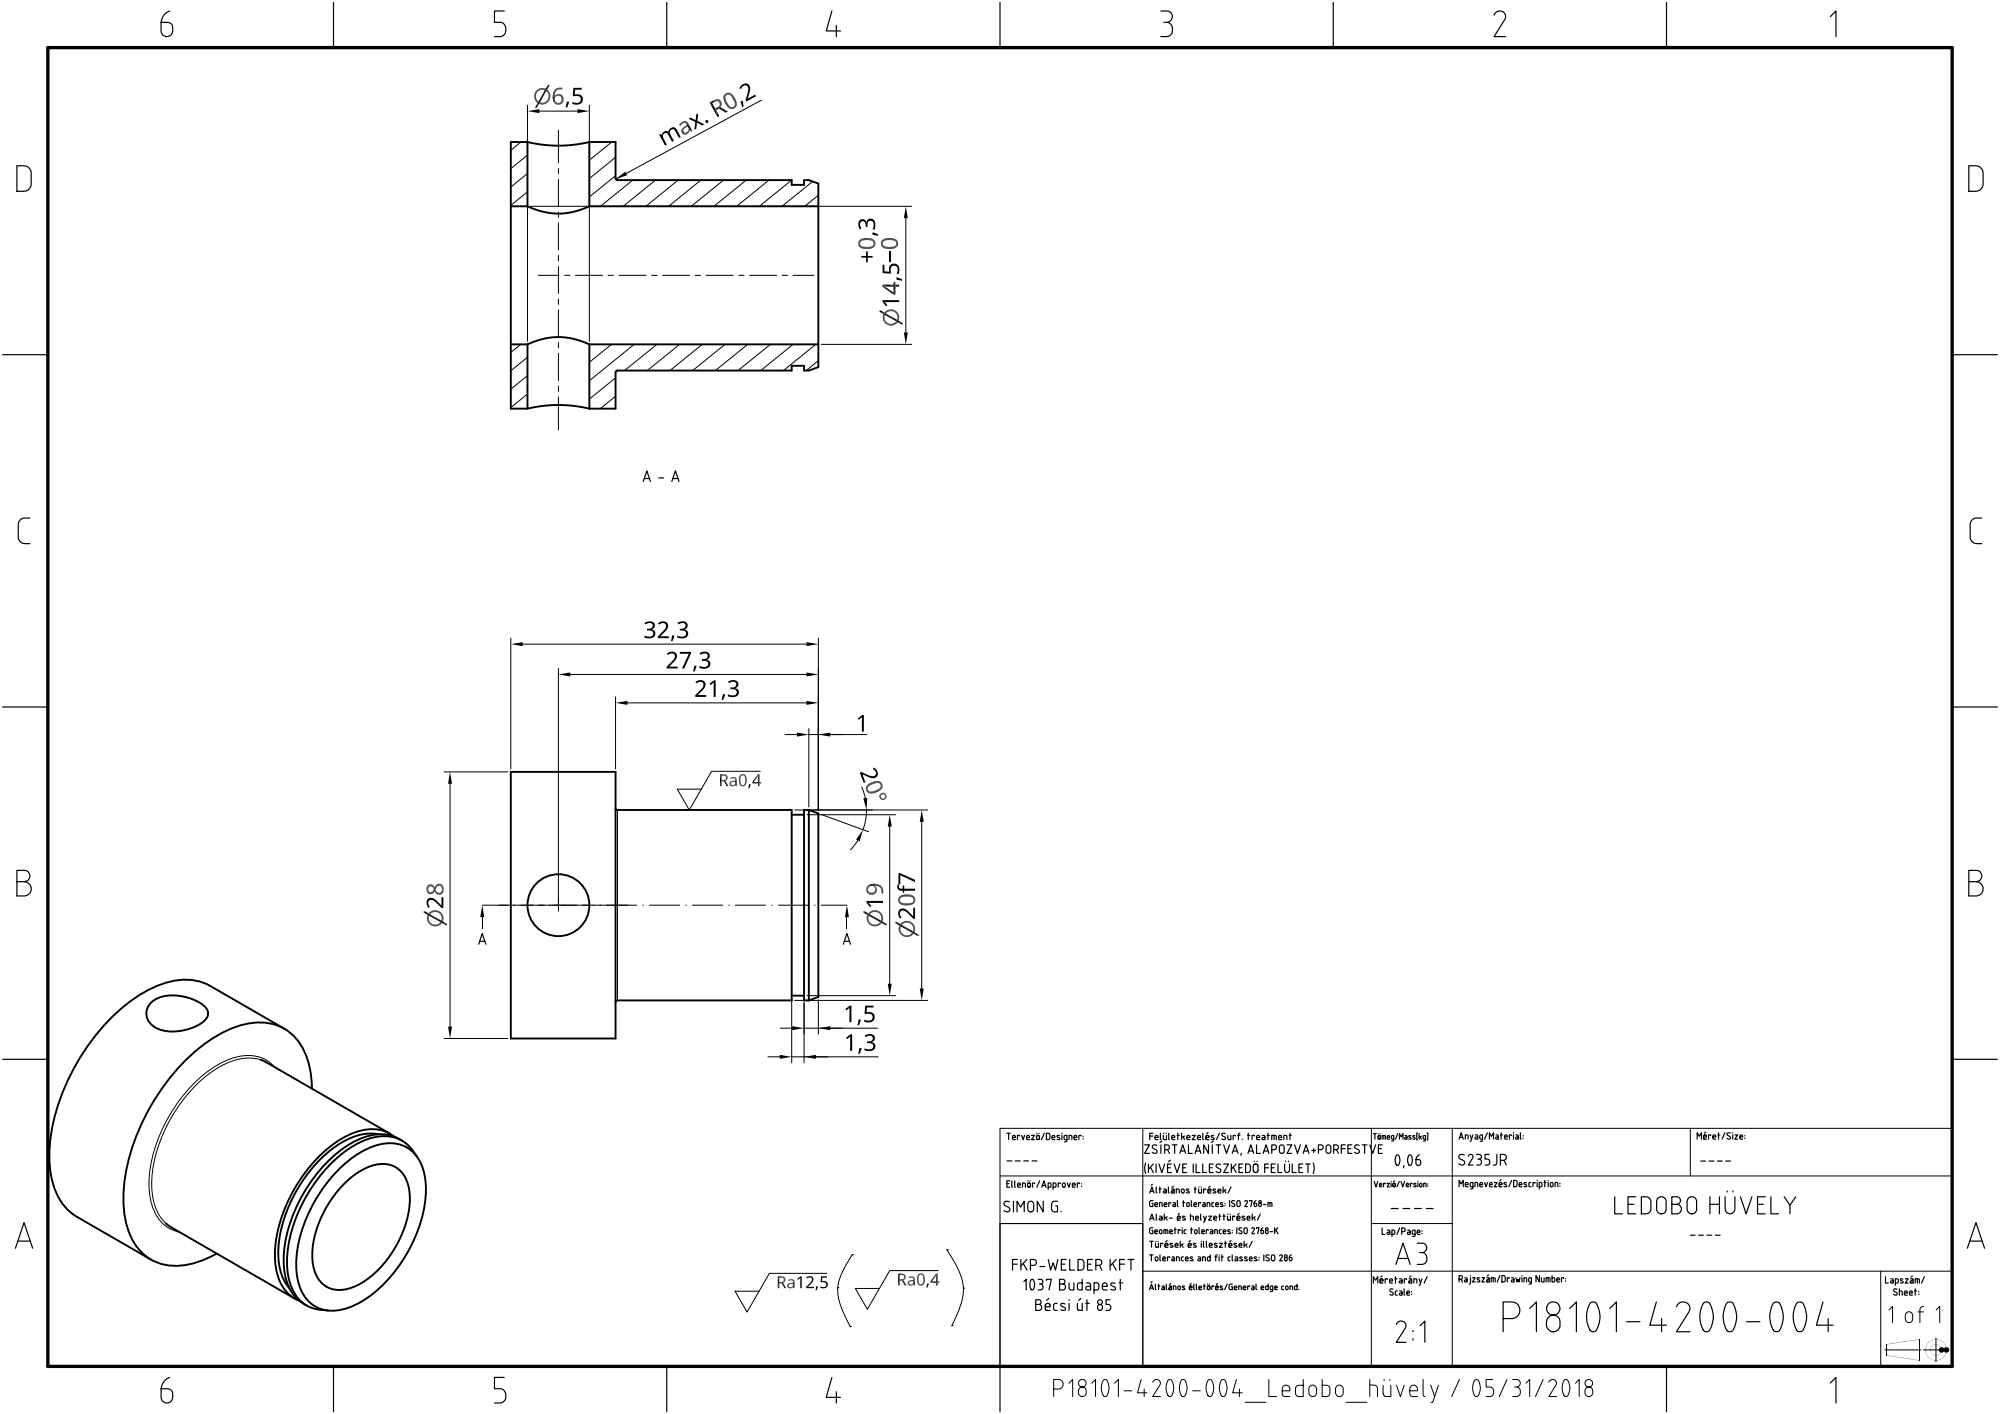
[picture p55: page 1]
