coderlazar/Metta-Pet/Tervrajzok/külső desygn, animáció/Külső megjelenés látványterv.pdf

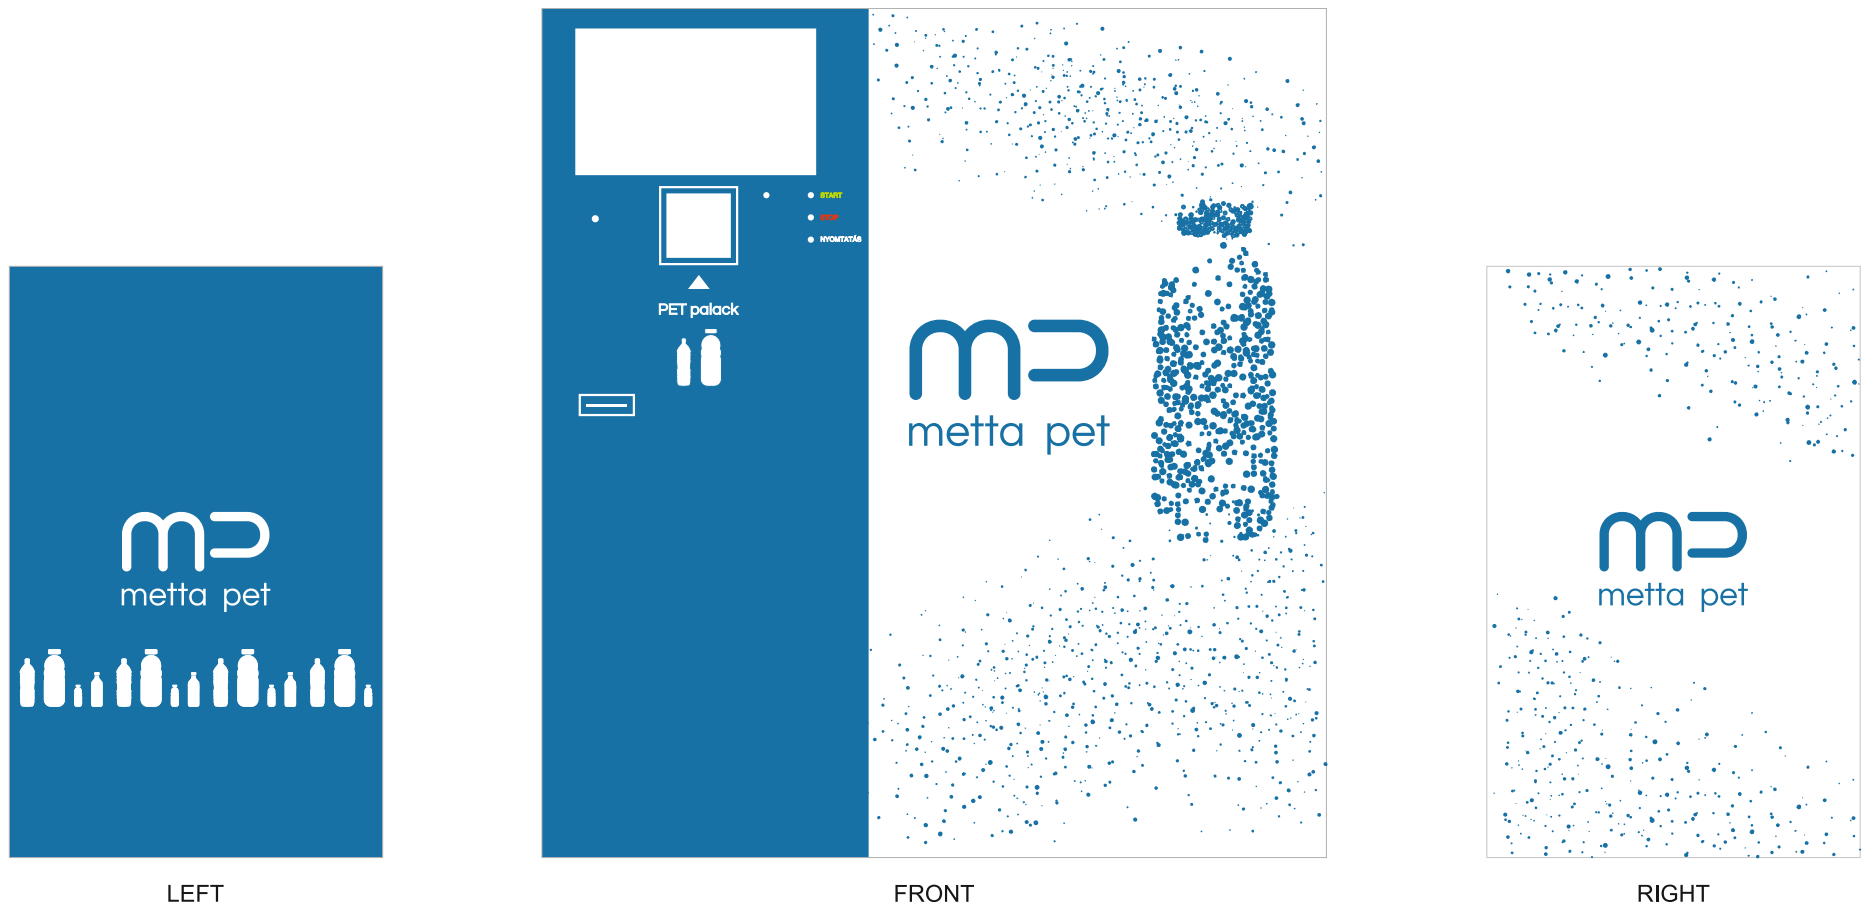
[picture p56: page 1]
