coderlazar/Metta-Pet/Tervrajzok/külső desygn, animáció/metta_pet_matrica_v2_kek módosítás.pdf

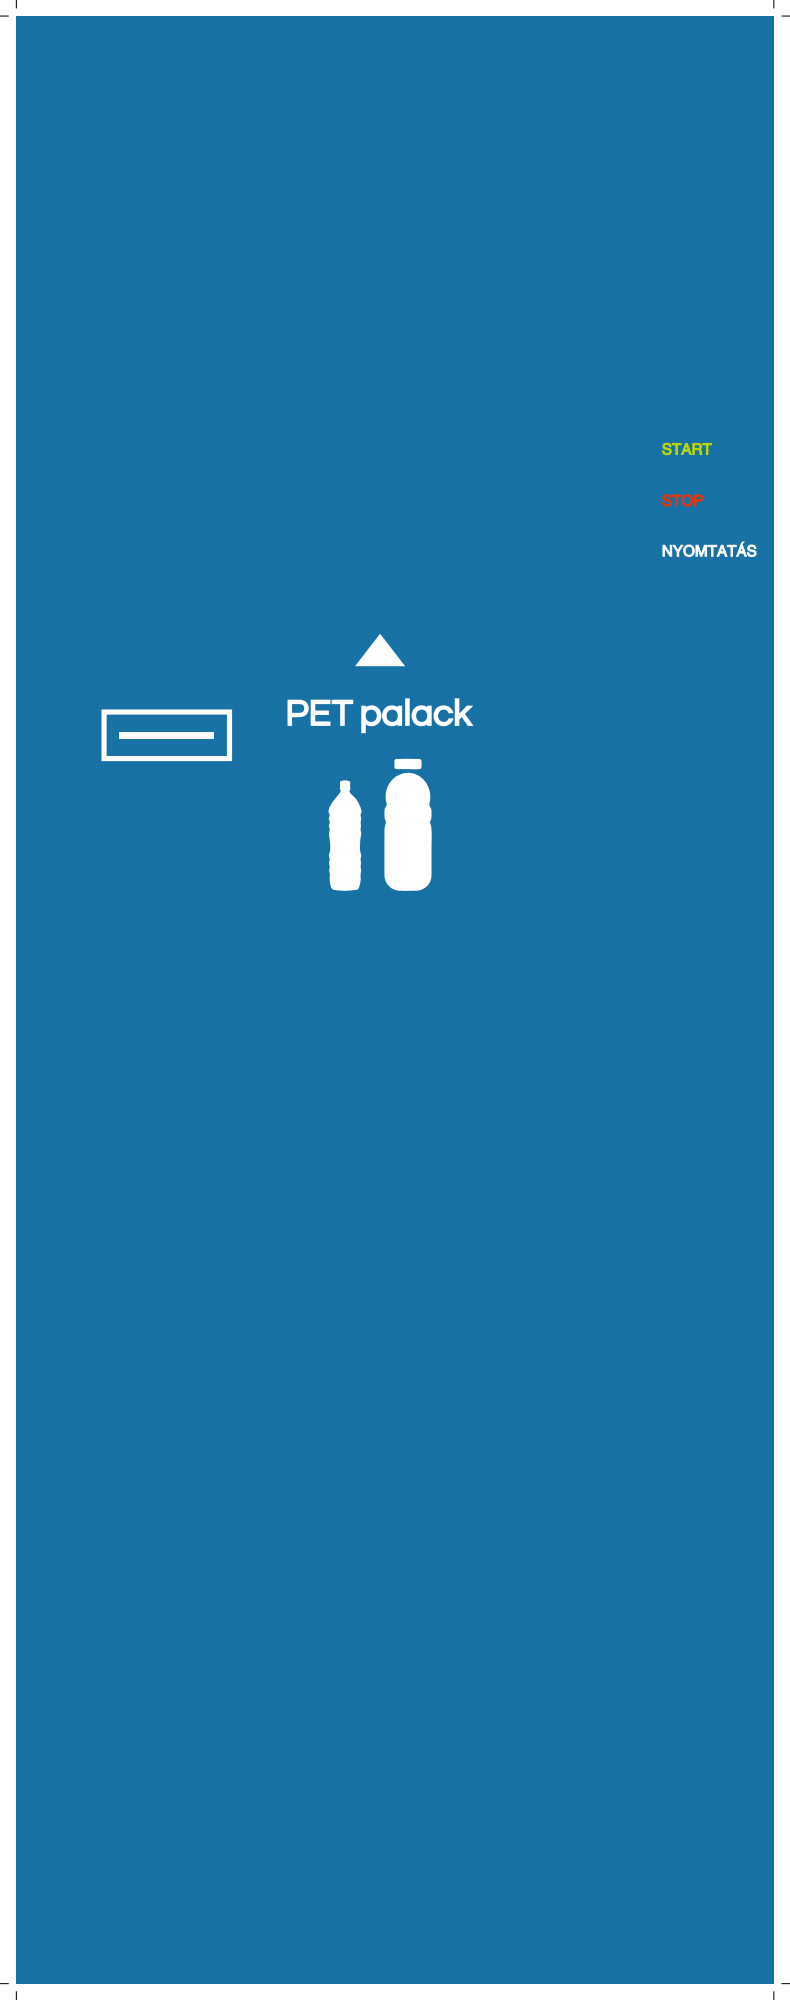
[picture p57: page 1]
