coderlazar/Metta-Pet/Tervrajzok/5000 - váz/P18101-5000-000_Váz egység.pdf

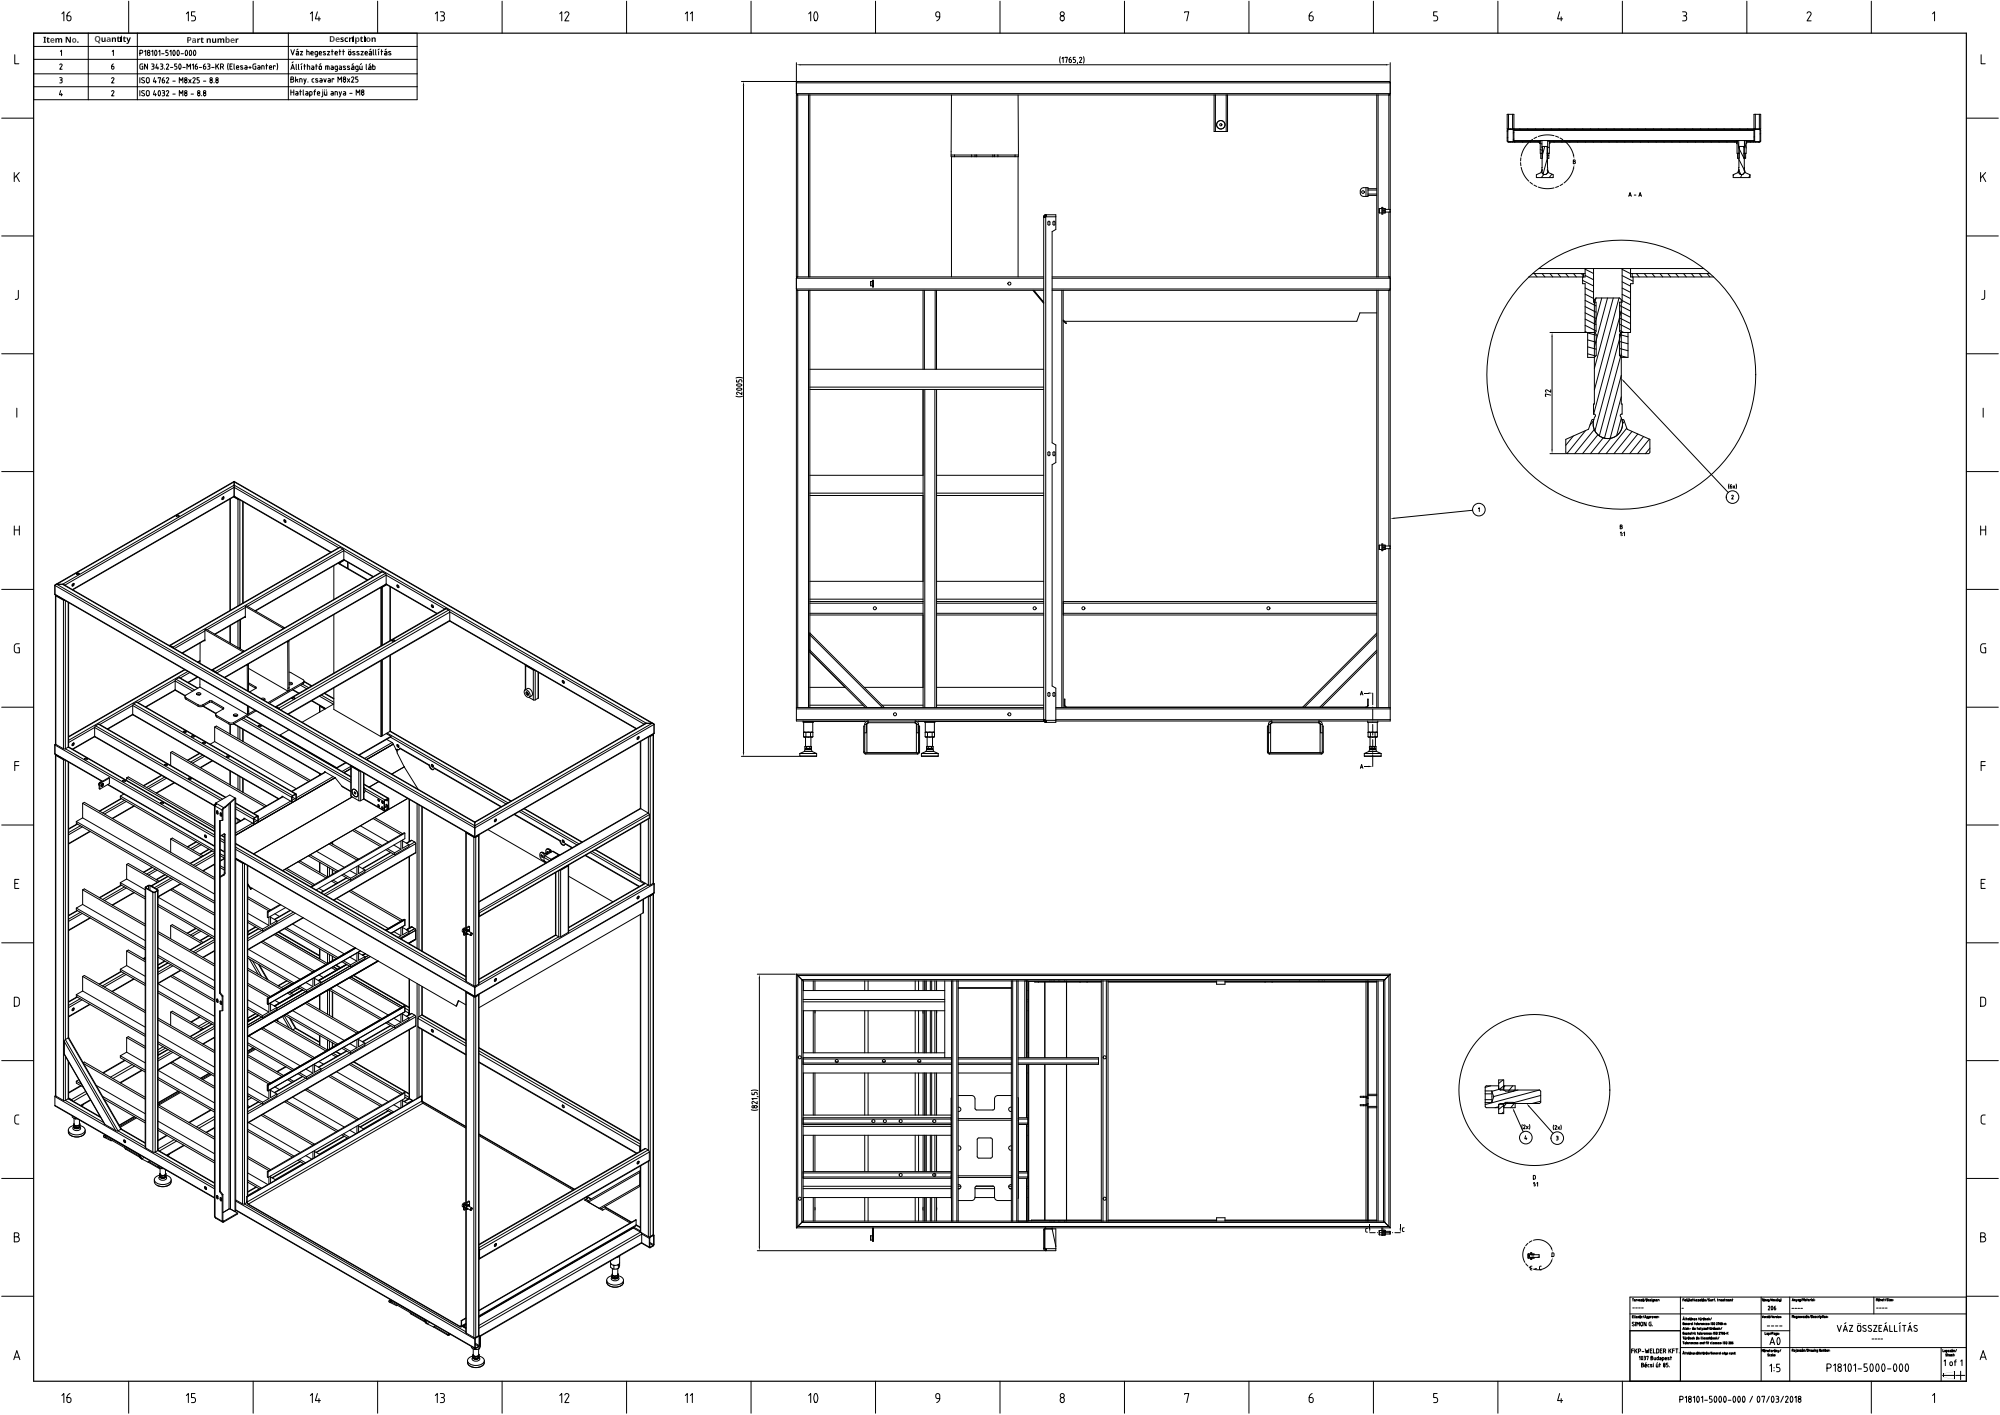
[picture p58: page 1]
