coderlazar/Metta-Pet/Tervrajzok/5000 - váz/P18101-5000-001_Emelö papucs elsö merevitöFLAT.pdf

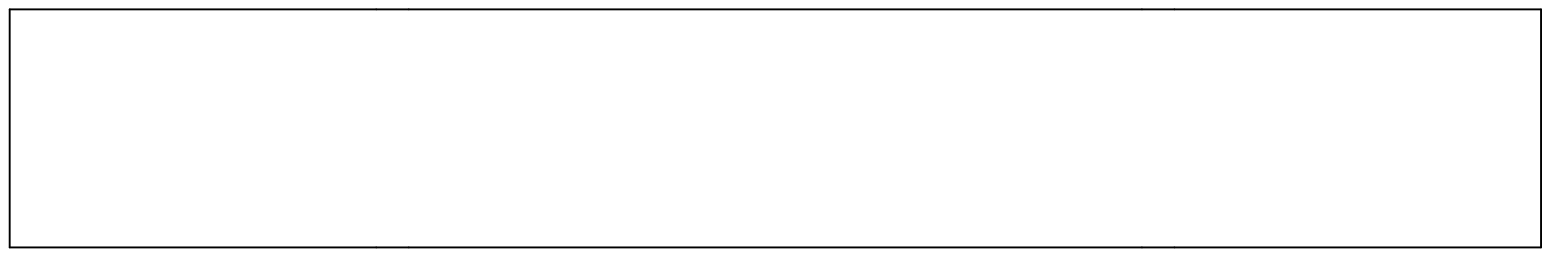
[picture p59: page 1]
