coderlazar/Metta-Pet/Tervrajzok/5000 - váz/P18101-5000-002_Emelö papucs hátsó merevitöFLAT.pdf

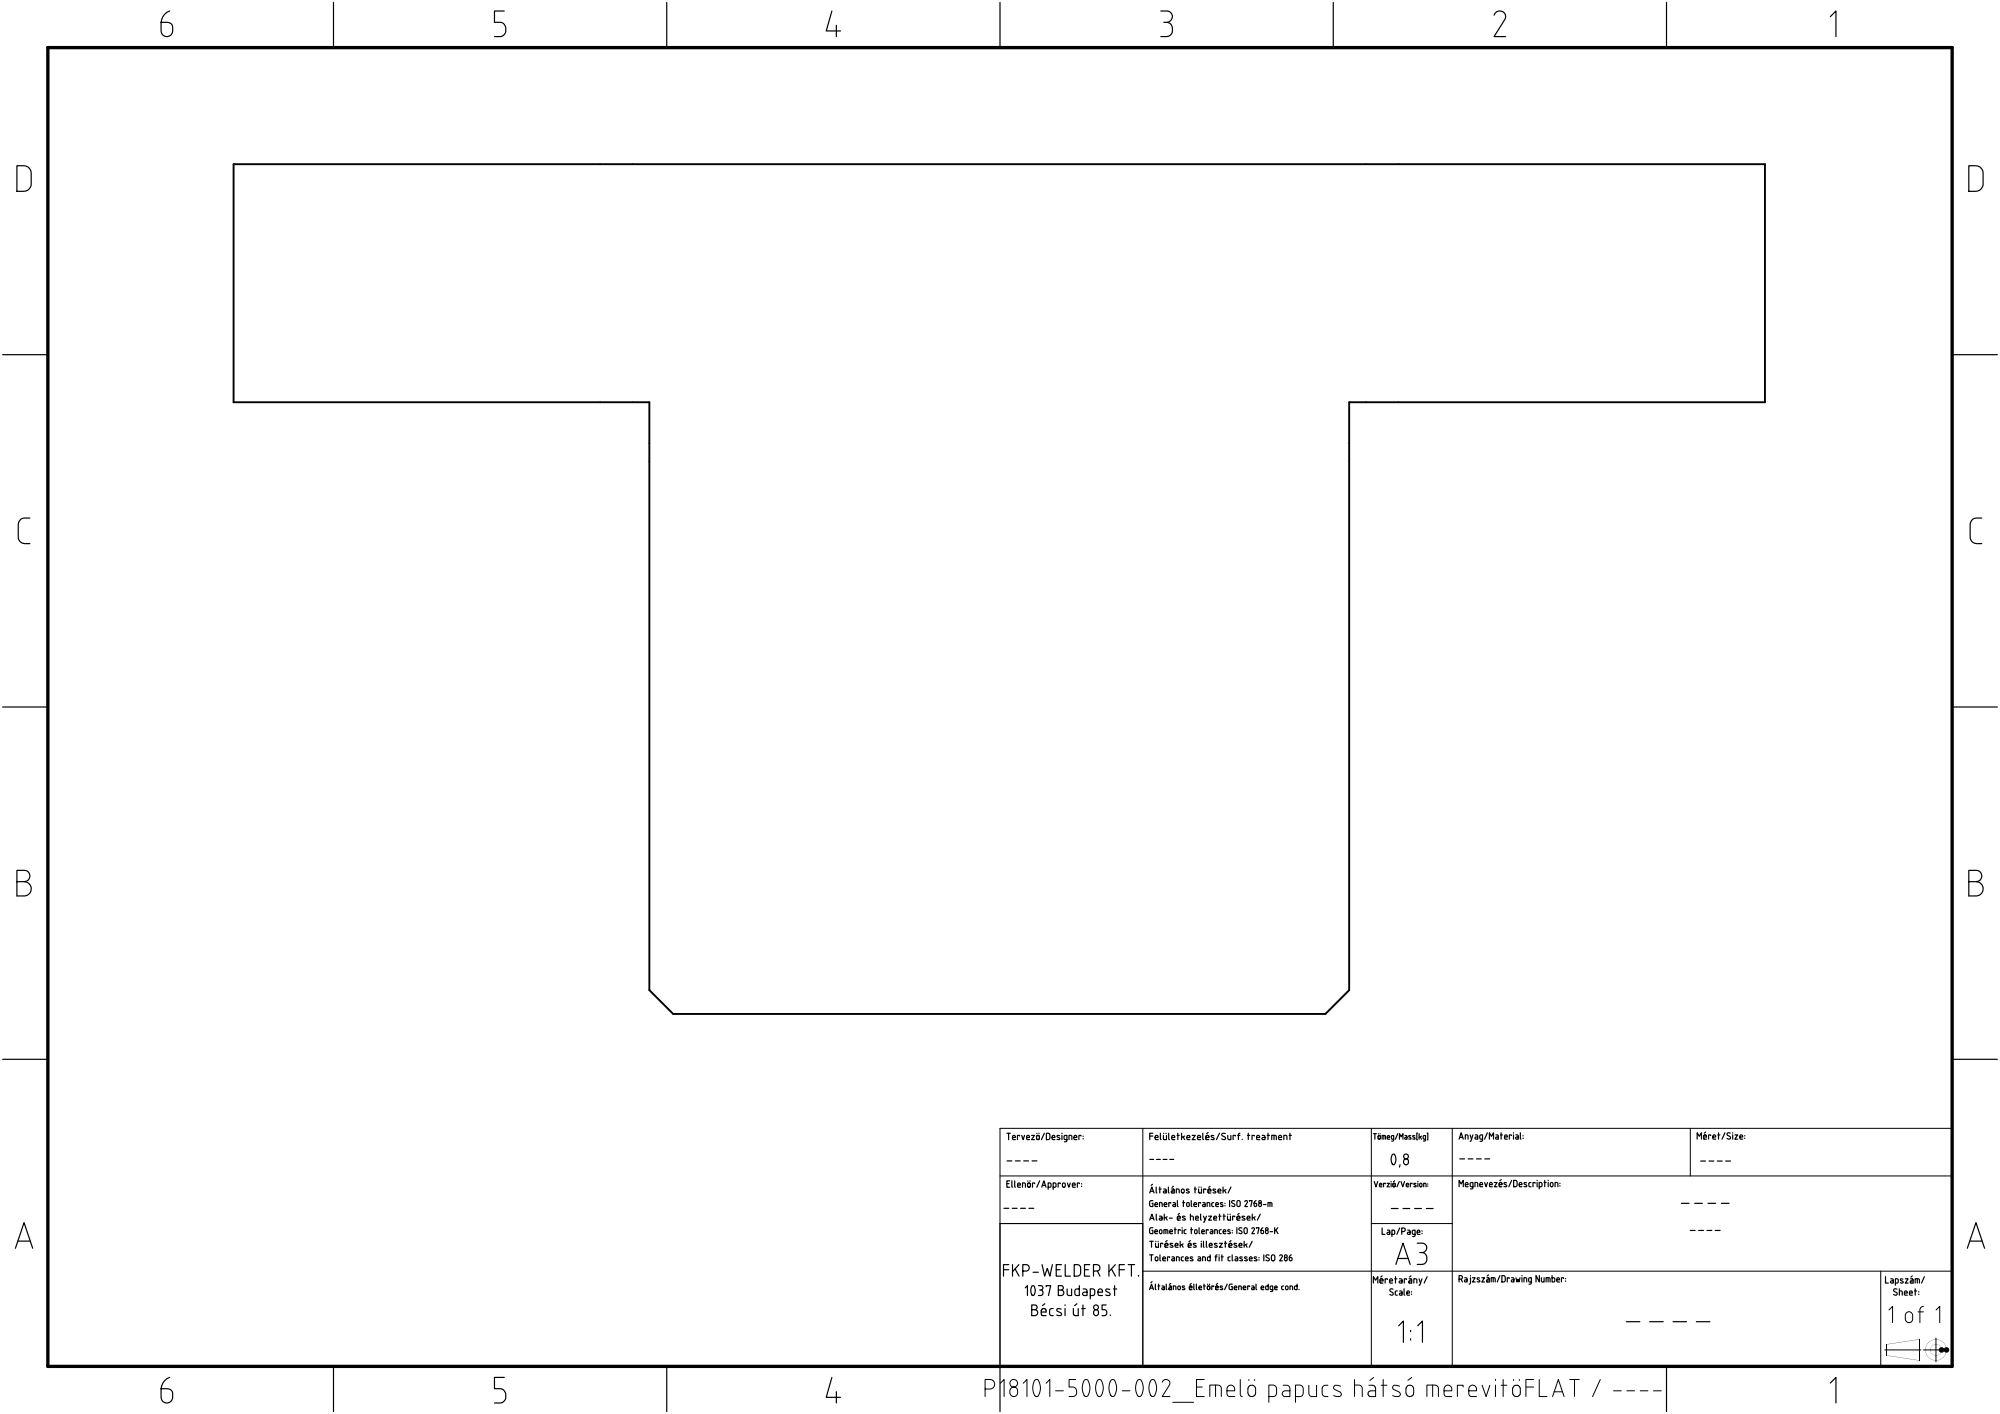
[picture p60: page 1]
