coderlazar/Metta-Pet/Tervrajzok/5000 - váz/P18101-5000-003_Padló lemez bal.pdf

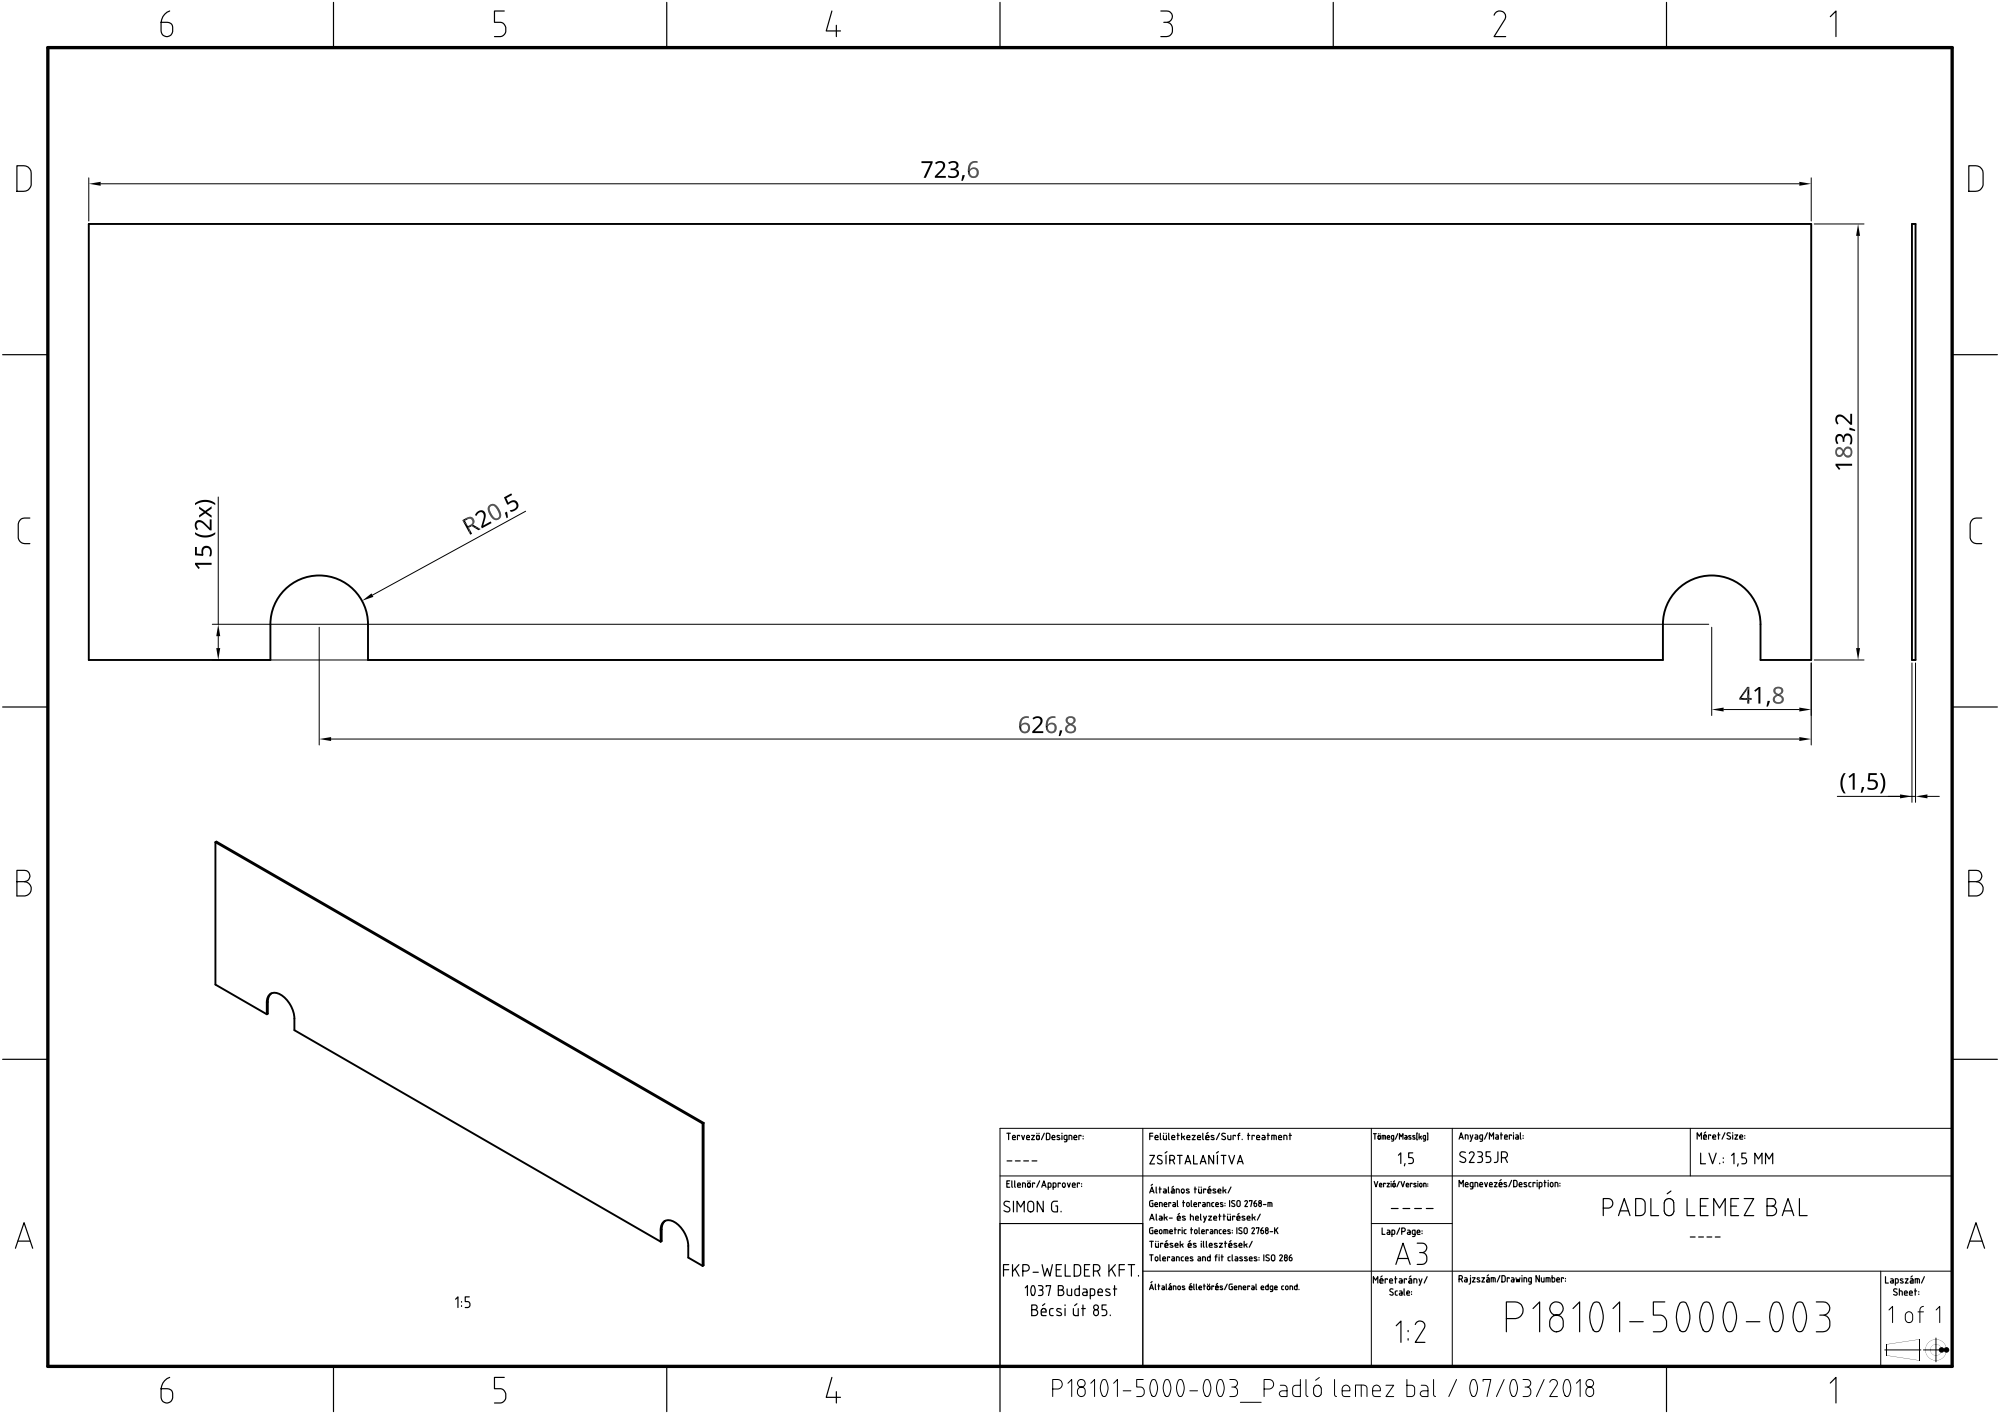
[picture p61: page 1]
