coderlazar/Metta-Pet/Tervrajzok/5000 - váz/P18101-5000-003_Padló lemez balFLAT.pdf

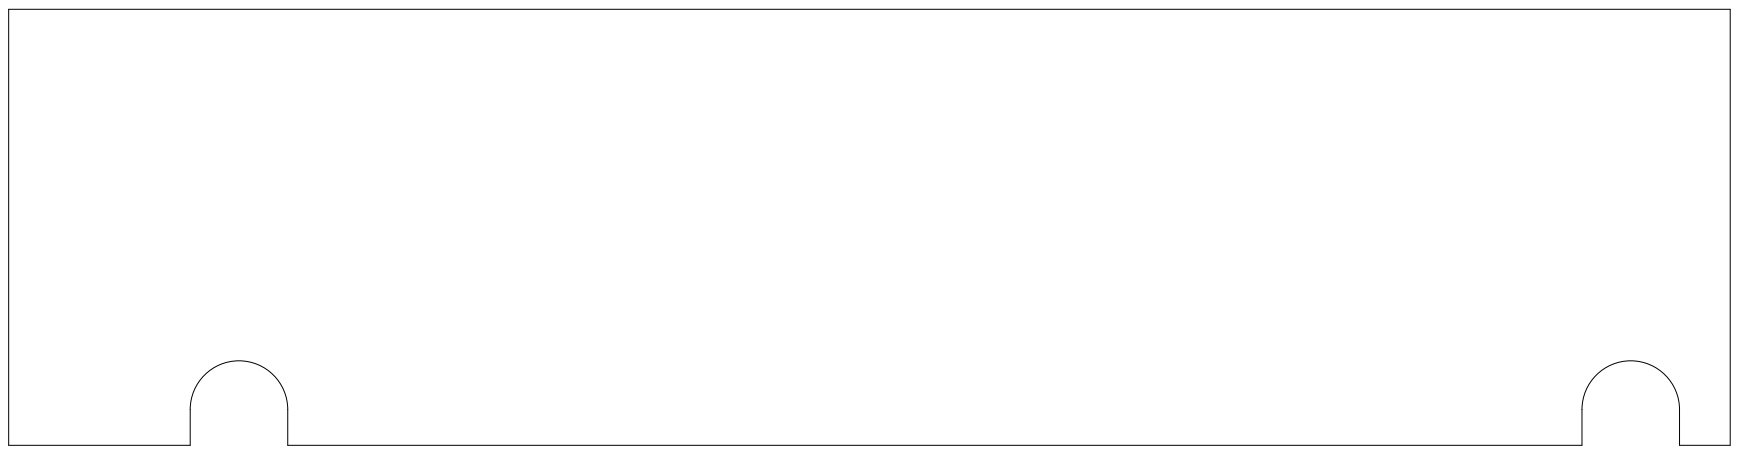
[picture p62: page 1]
