coderlazar/Metta-Pet/Tervrajzok/5000 - váz/P18101-5000-004_Padló lemez jobbFLAT.pdf

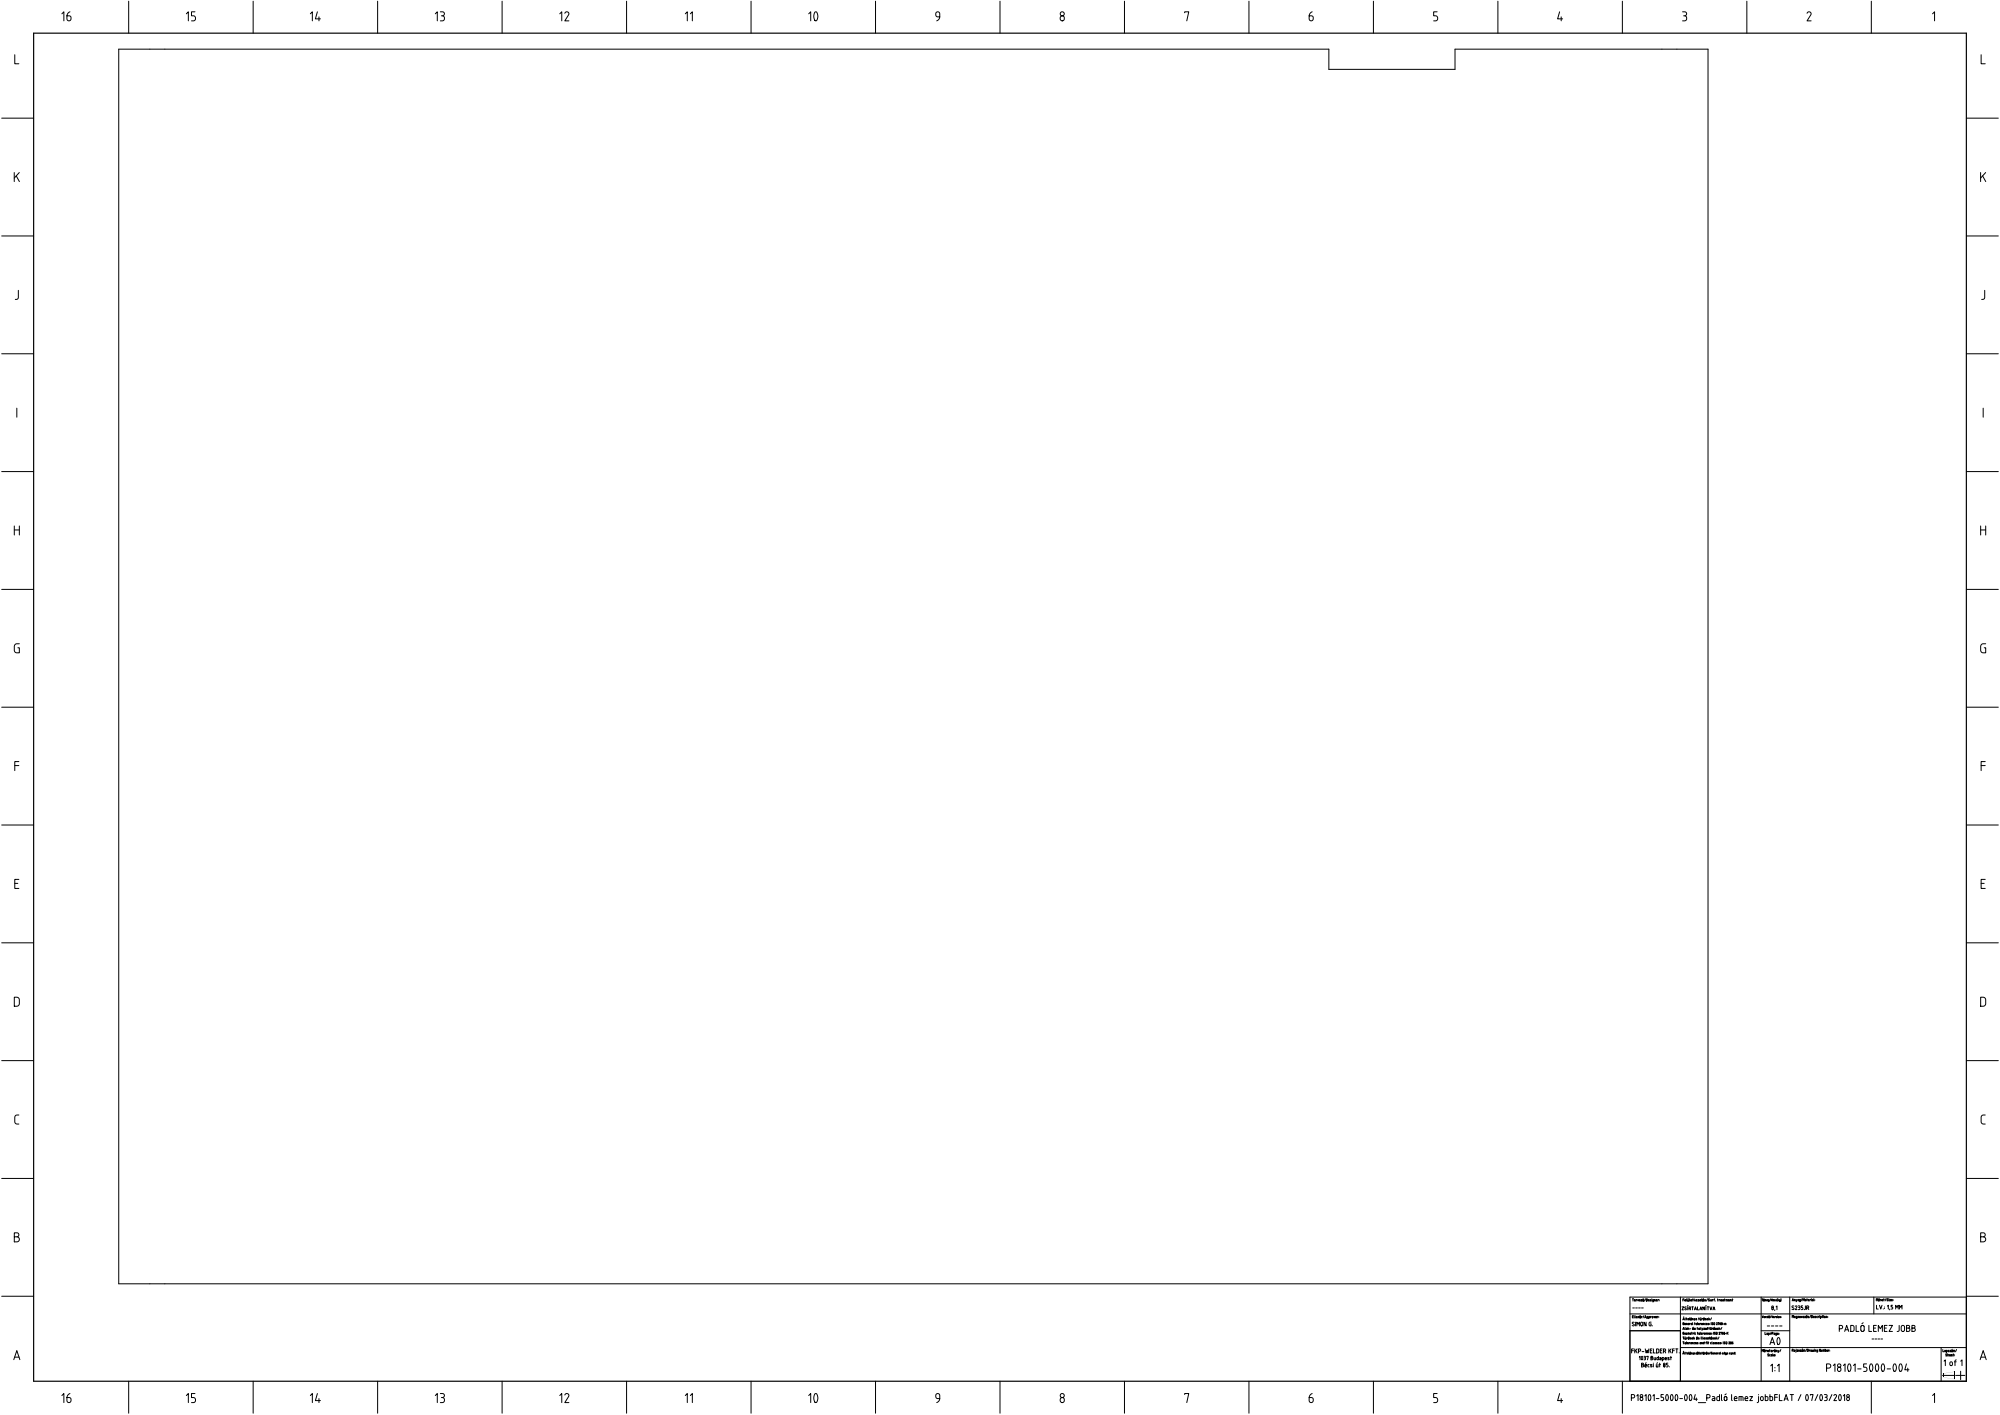
[picture p63: page 1]
