coderlazar/Metta-Pet/Tervrajzok/5000 - váz/P18101-5000-006_Emelö papucsFLAT.pdf

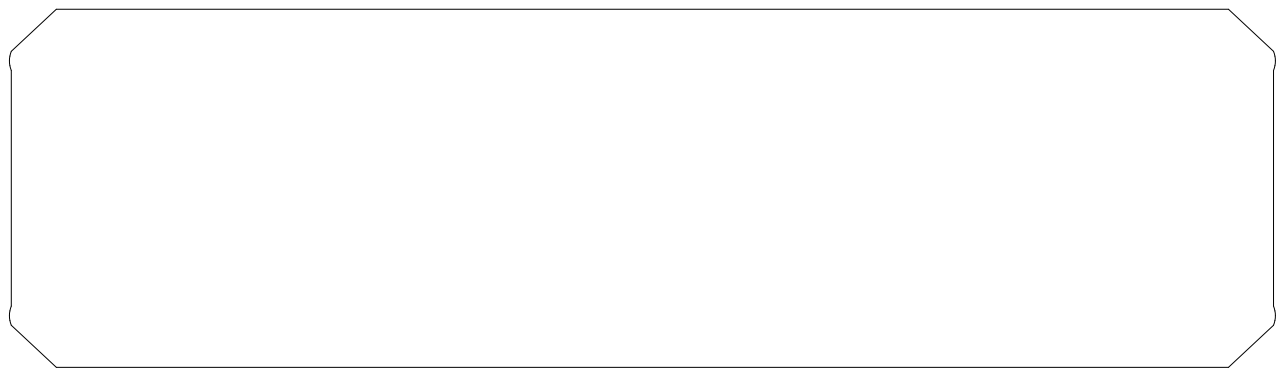
[picture p64: page 1]
