coderlazar/Metta-Pet/Tervrajzok/5000 - váz/P18101-5000-007_Padló lemez középsö.pdf

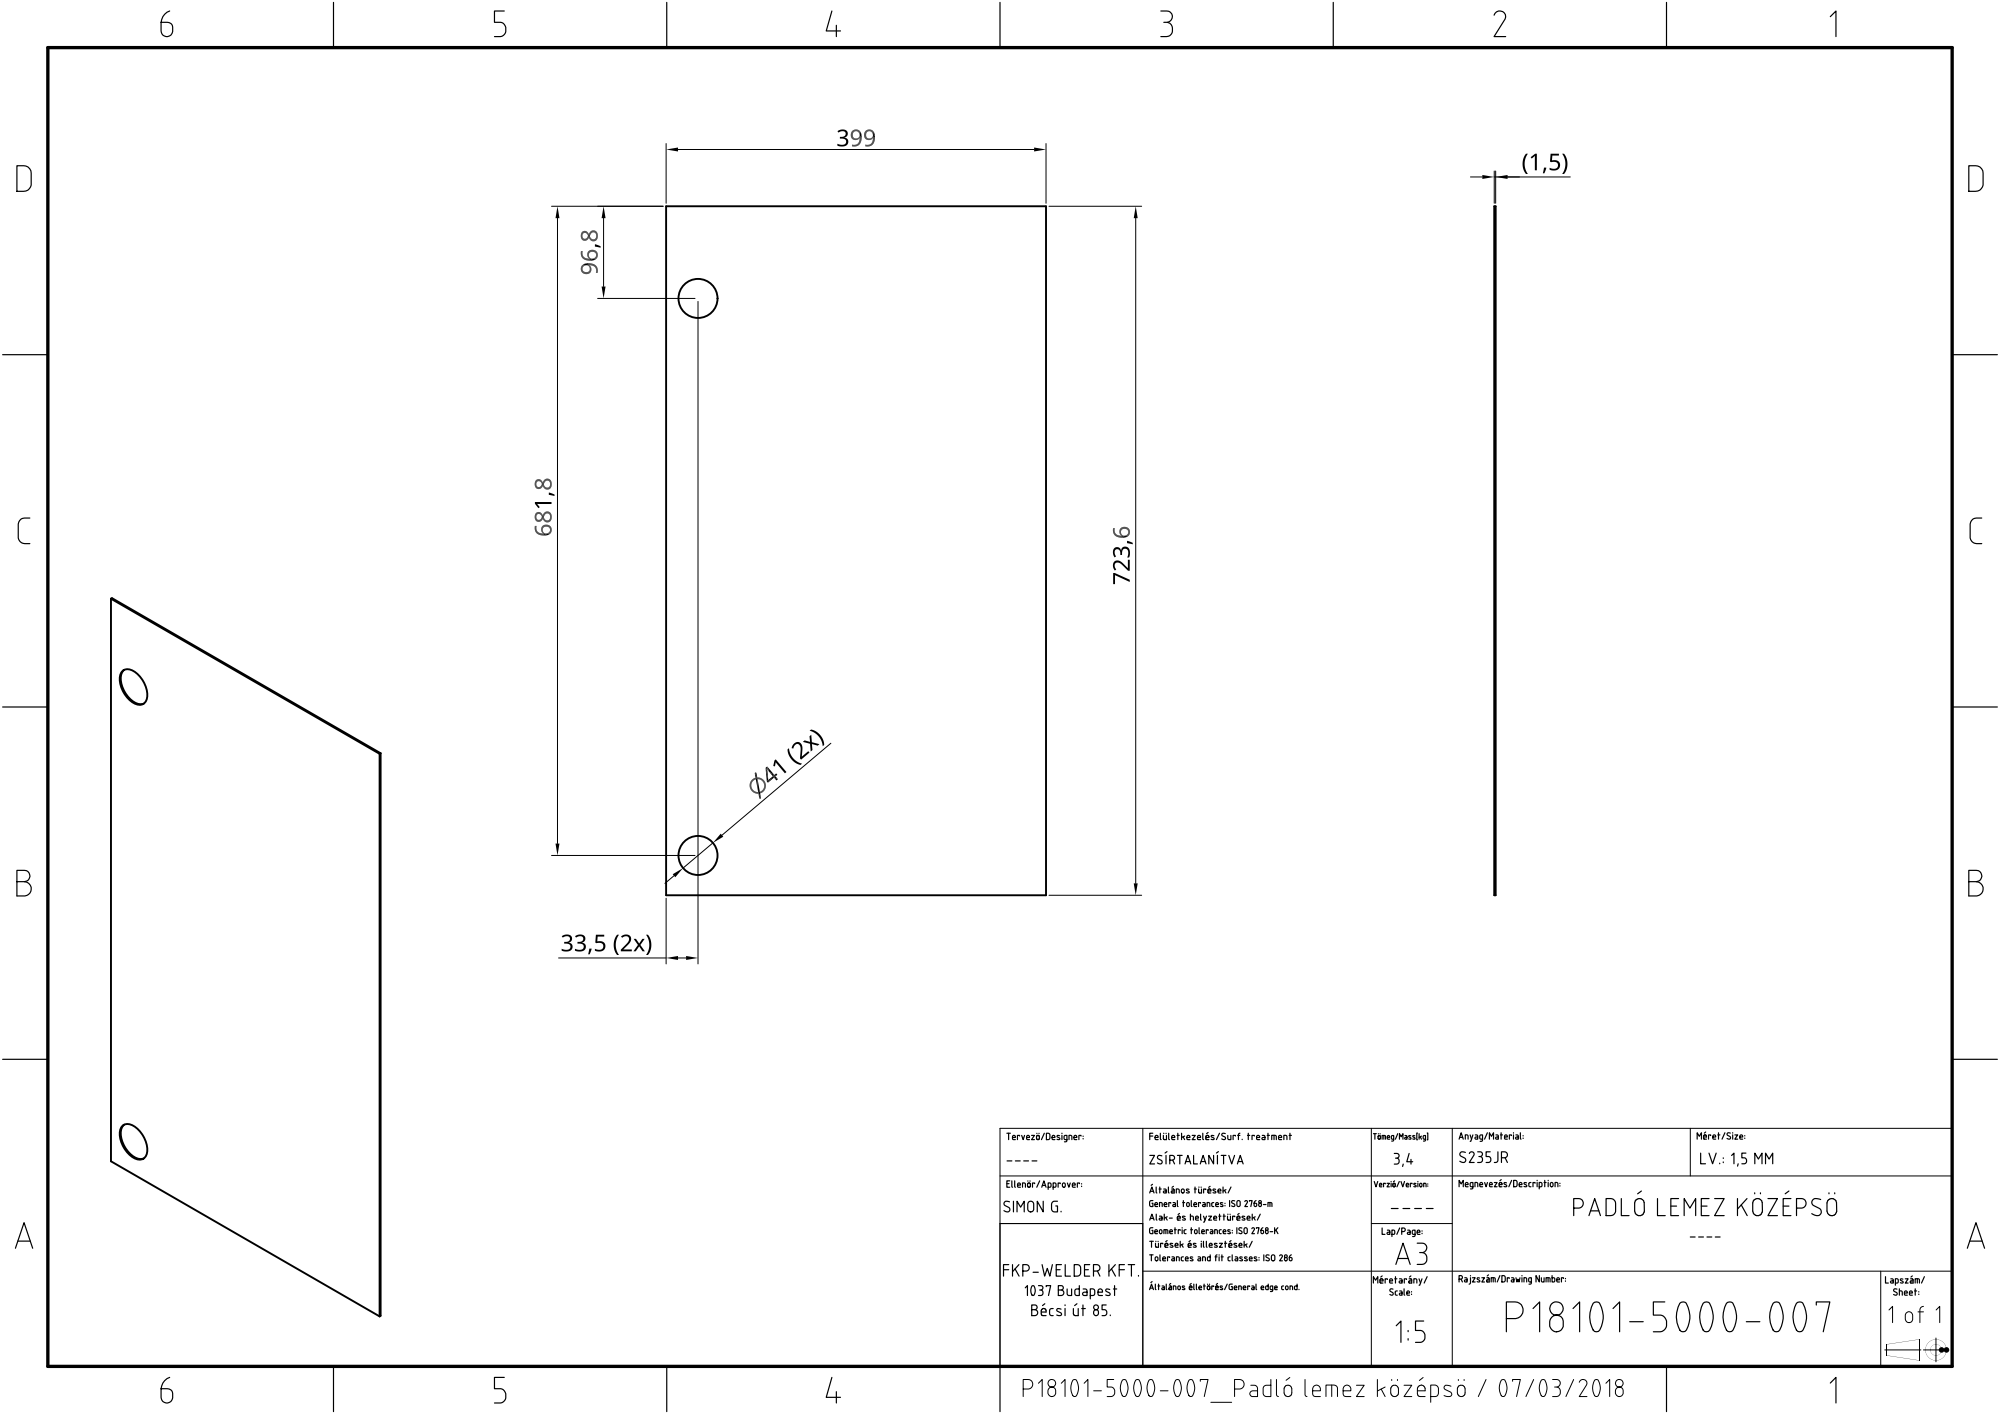
[picture p65: page 1]
