coderlazar/Metta-Pet/Tervrajzok/5000 - váz/P18101-5000-007_Préselö egység merevítö.pdf

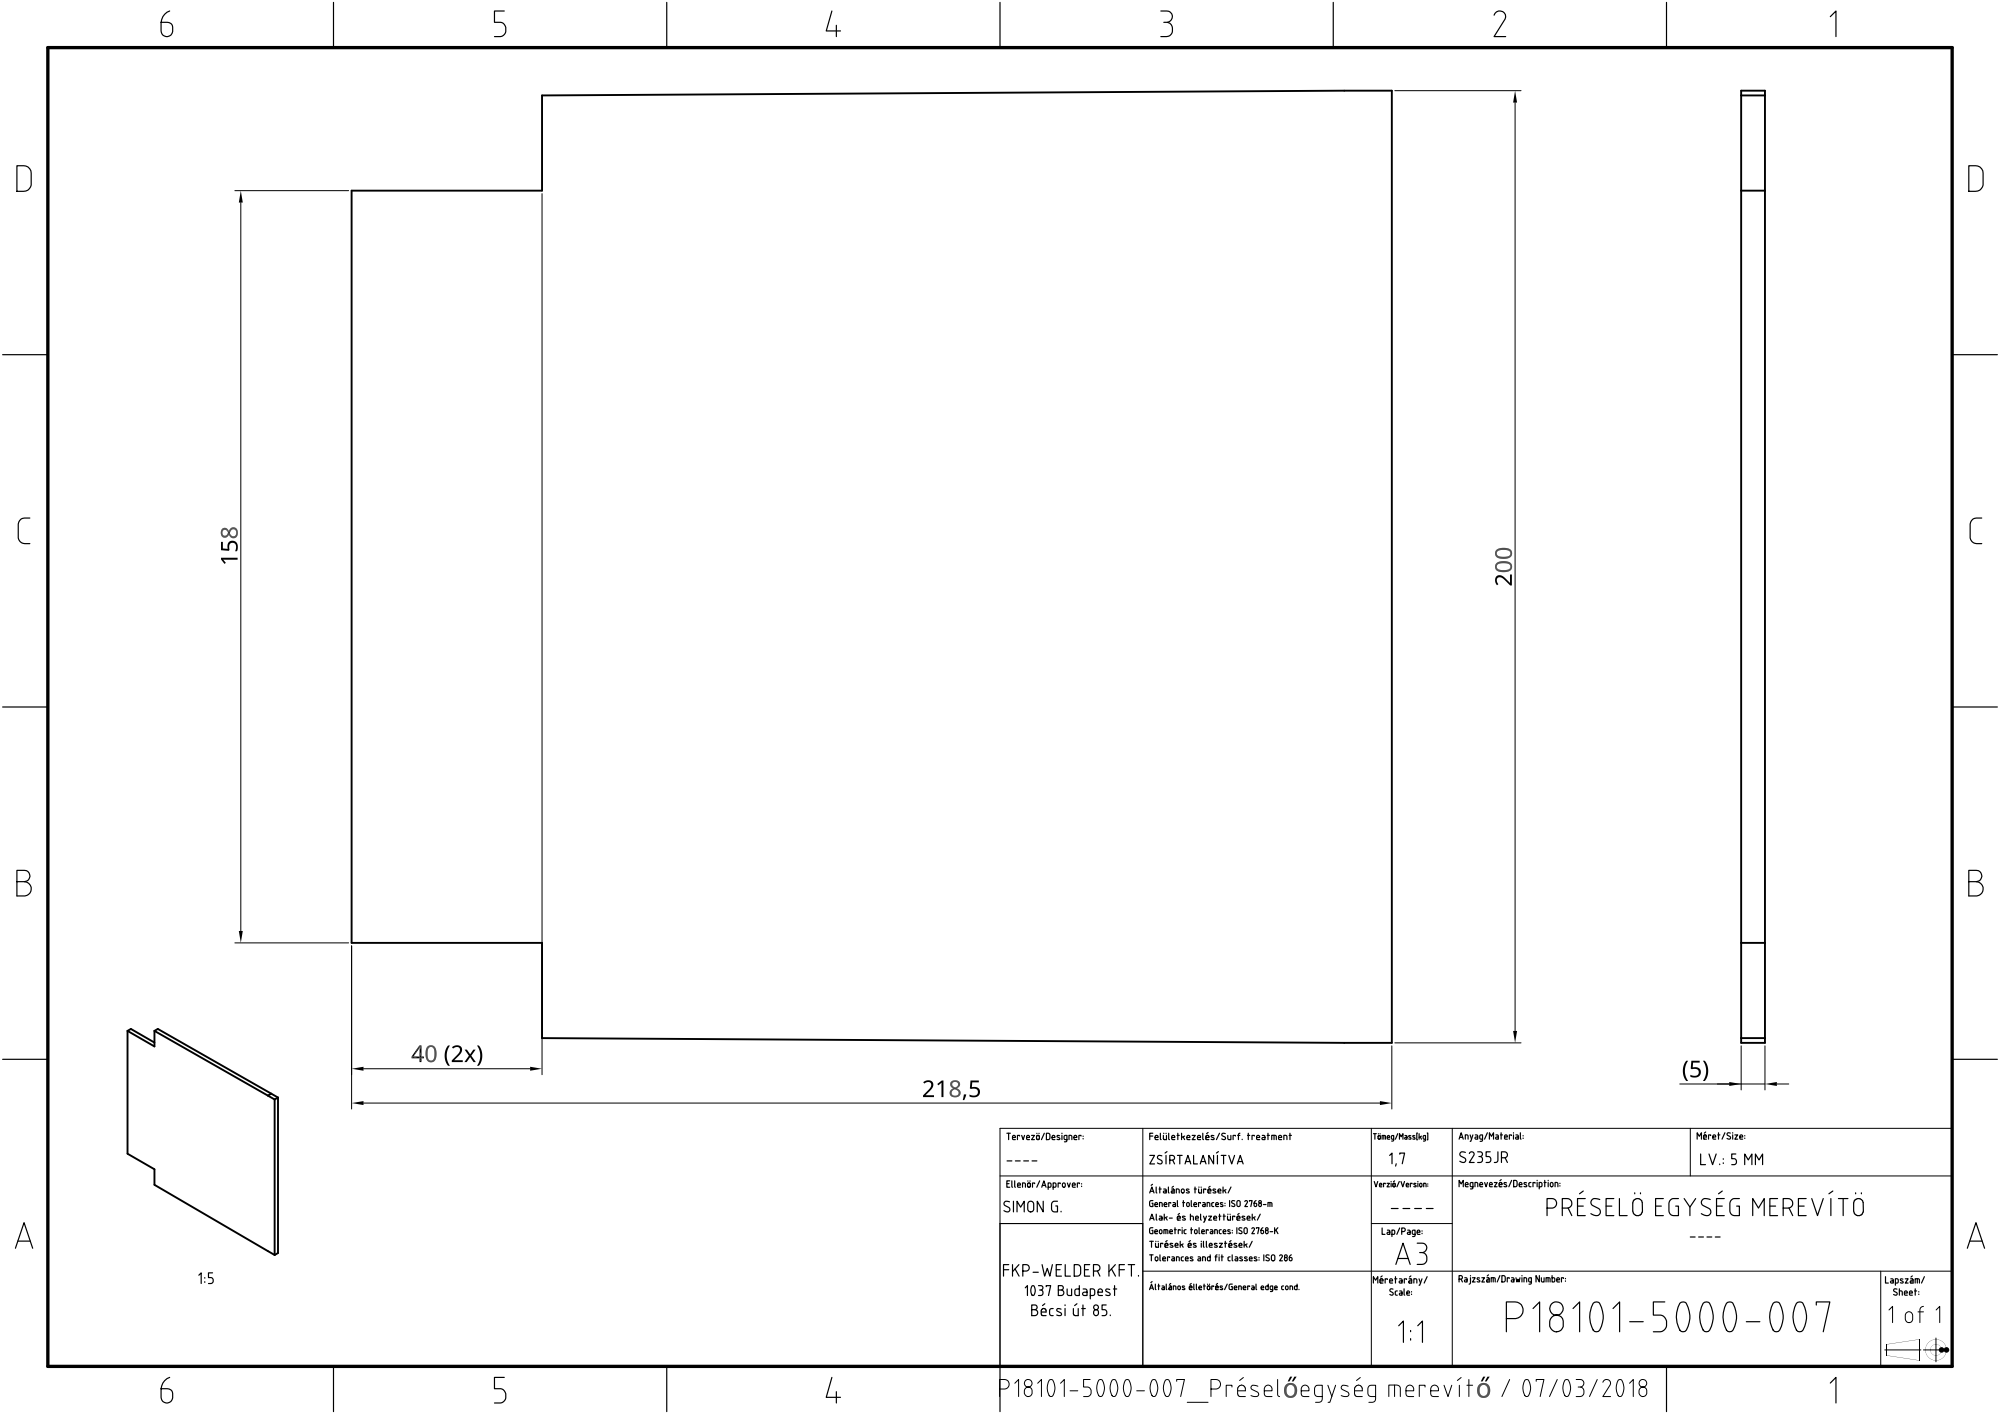
[picture p66: page 1]
