coderlazar/Metta-Pet/Tervrajzok/5000 - váz/P18101-5000-007_Préselö egység merevítöFLAT.pdf

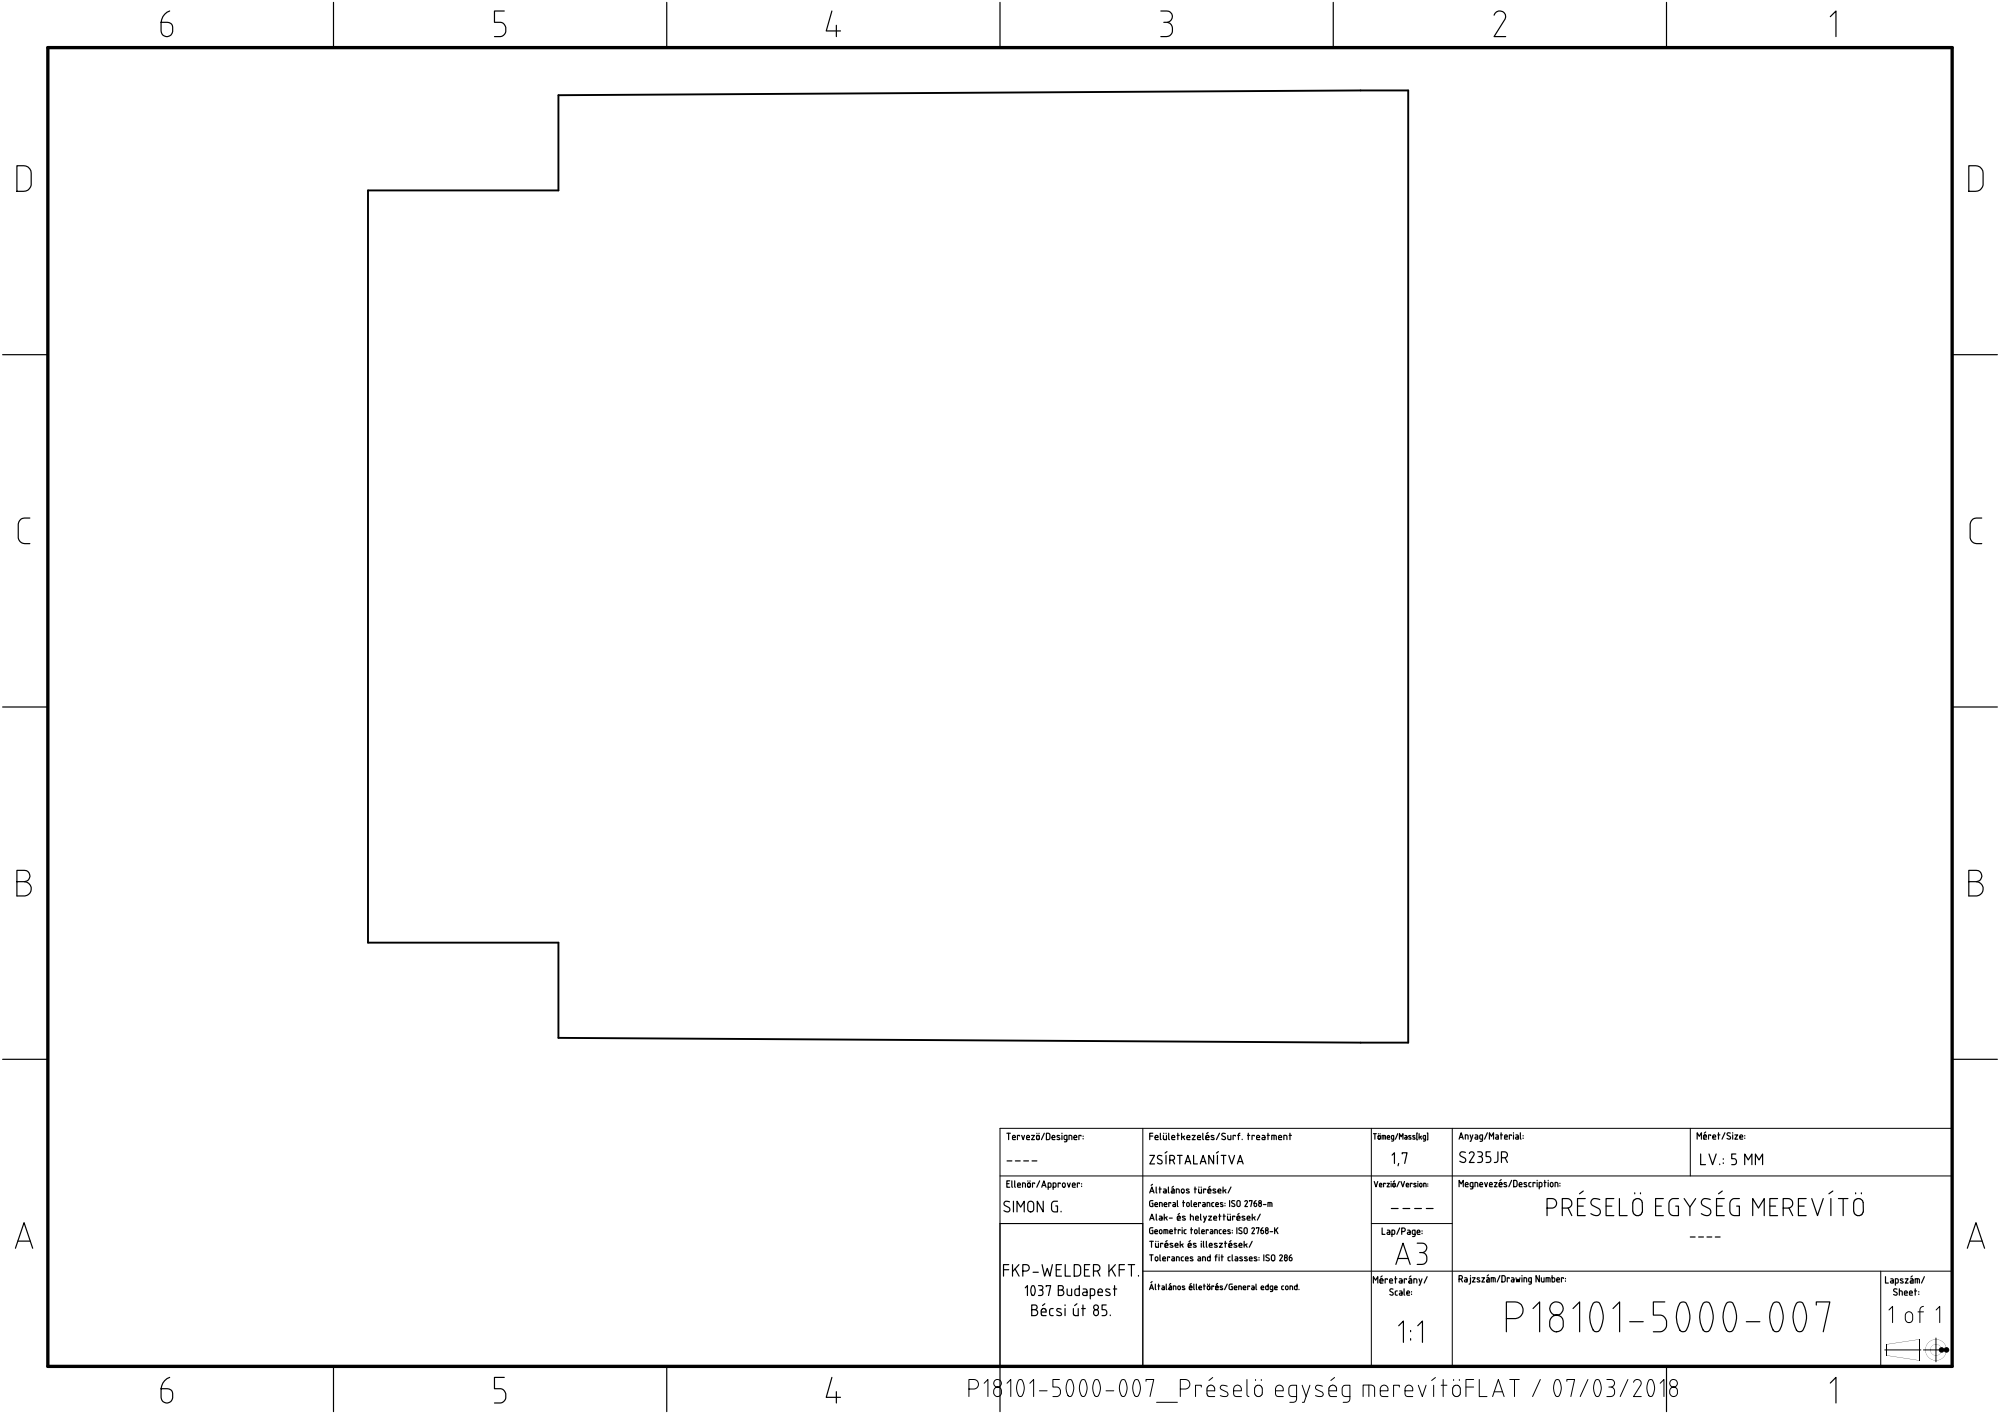
[picture p67: page 1]
