coderlazar/Metta-Pet/Tervrajzok/5000 - váz/P18101-5000-007_Préselő egység merevítő.pdf

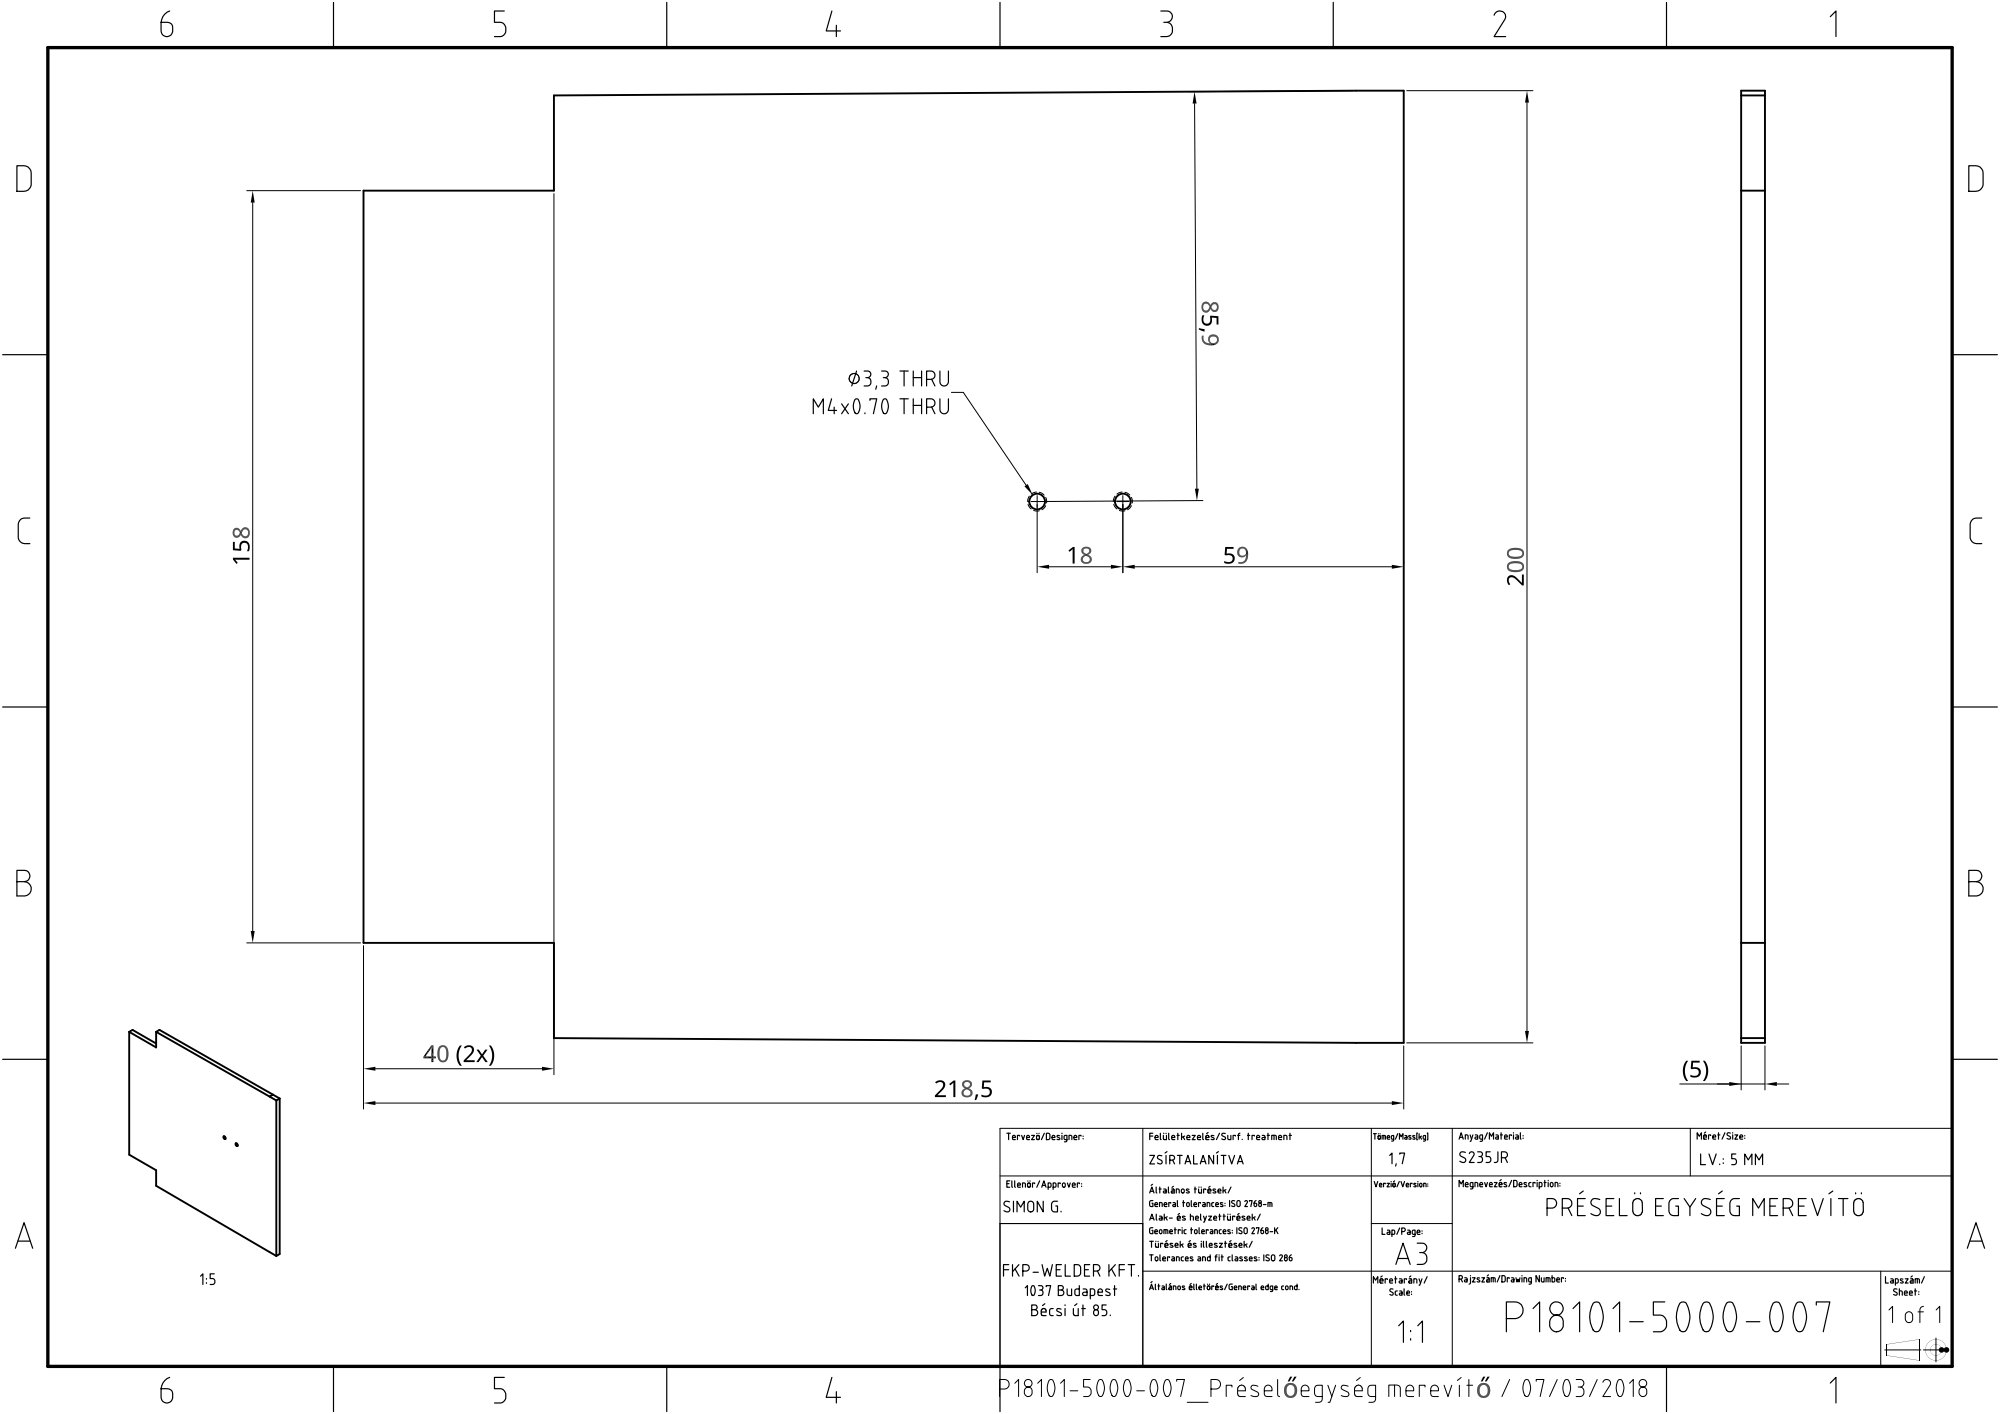
[picture p68: page 1]
