coderlazar/Metta-Pet/Tervrajzok/5000 - váz/P18101-5000-008_Préselö egység tartó.pdf

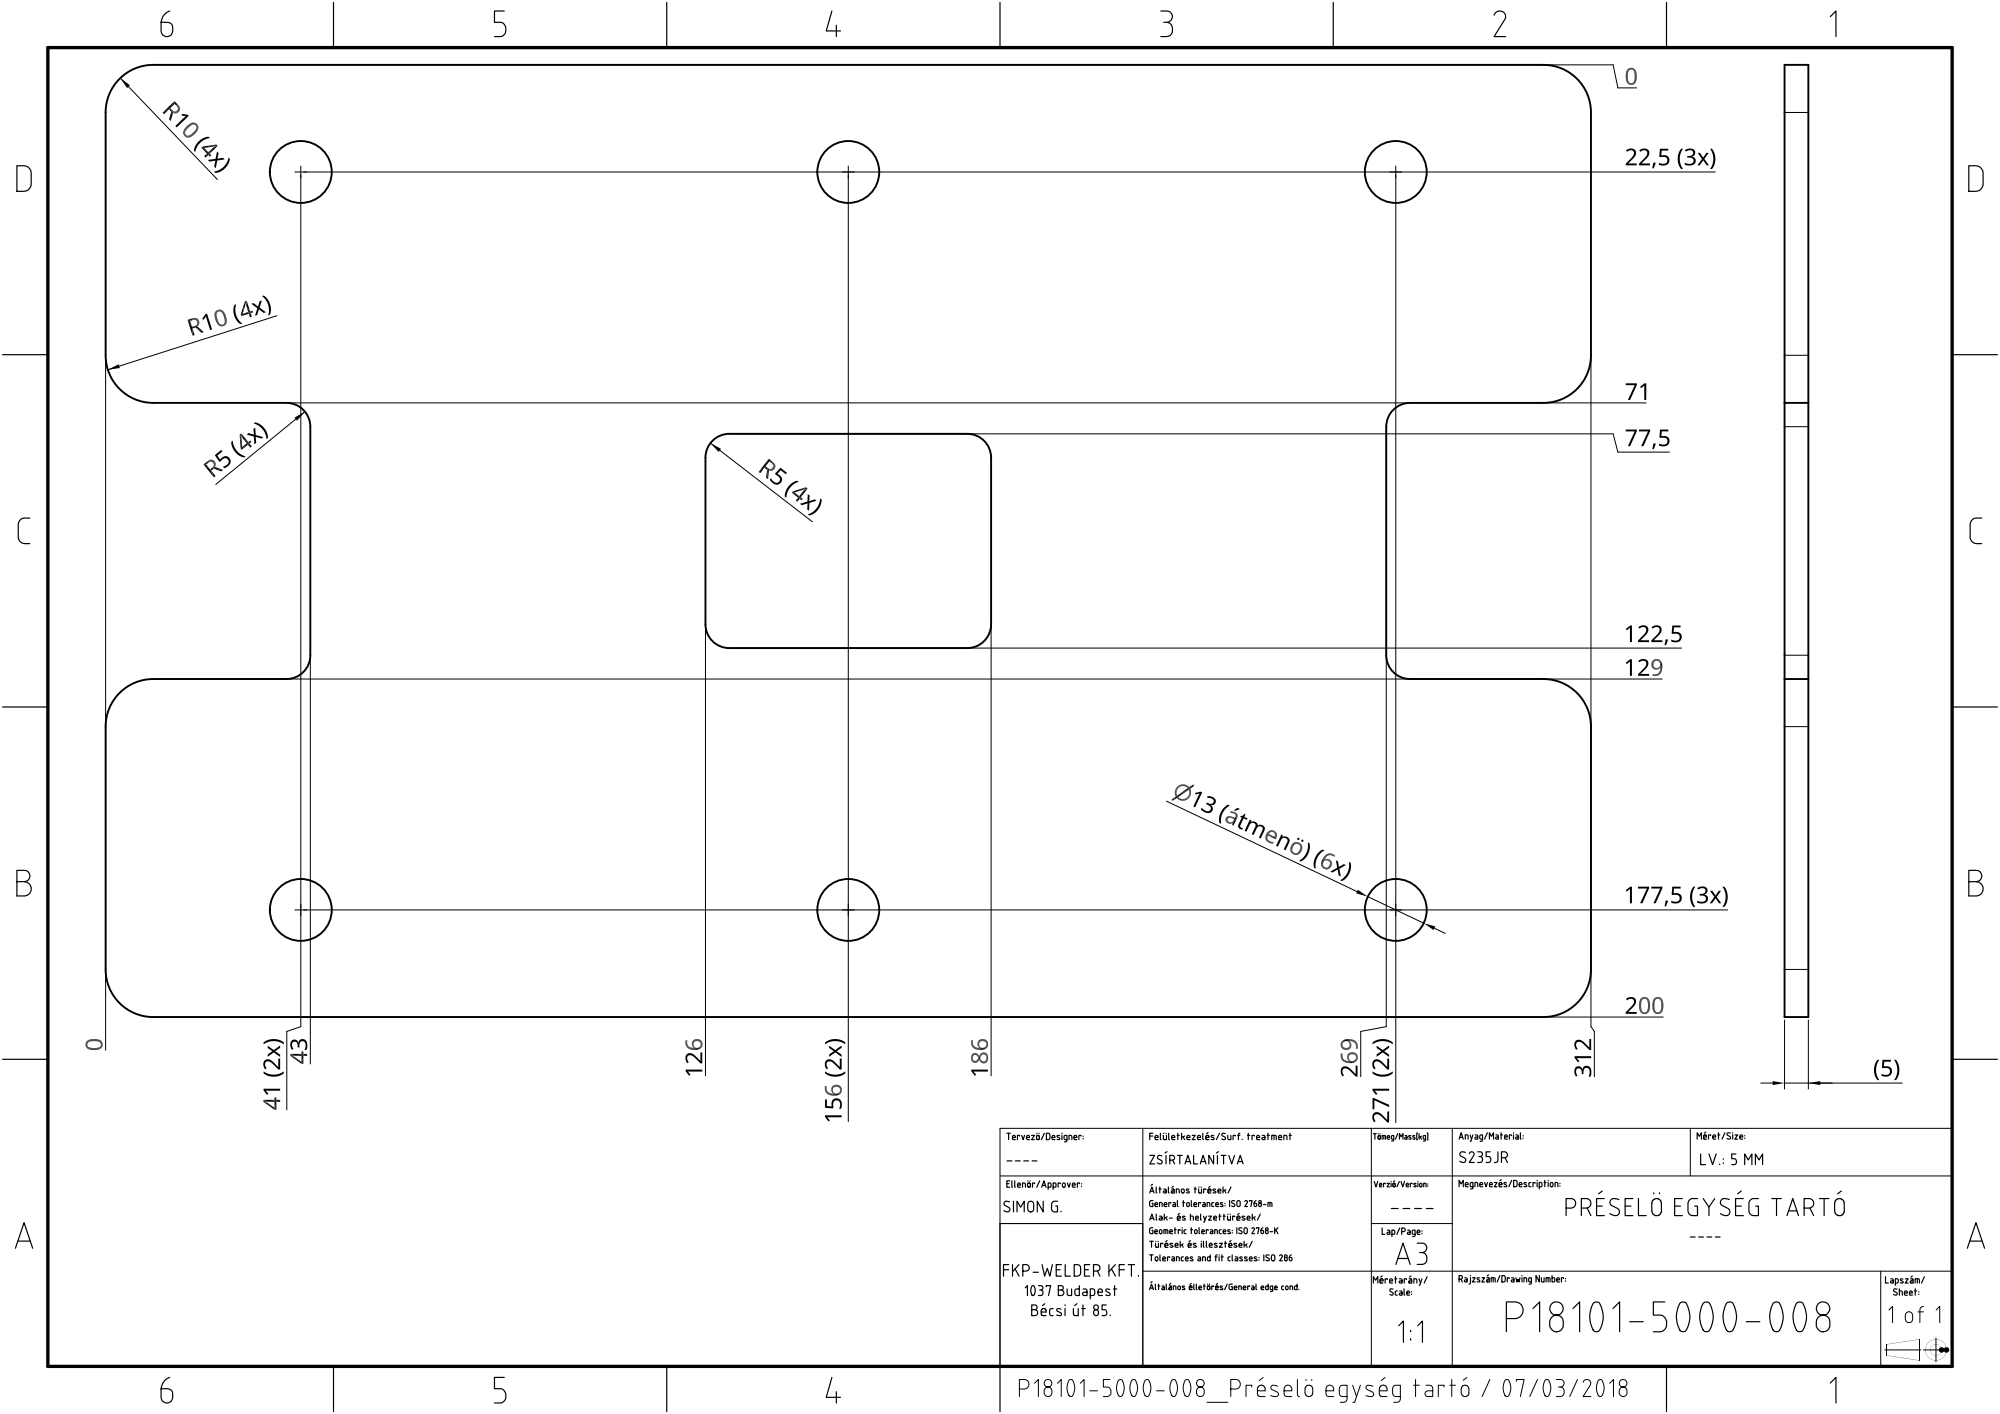
[picture p69: page 1]
