coderlazar/Metta-Pet/Tervrajzok/5000 - váz/P18101-5000-008_Préselö egység tartóFLAT.pdf

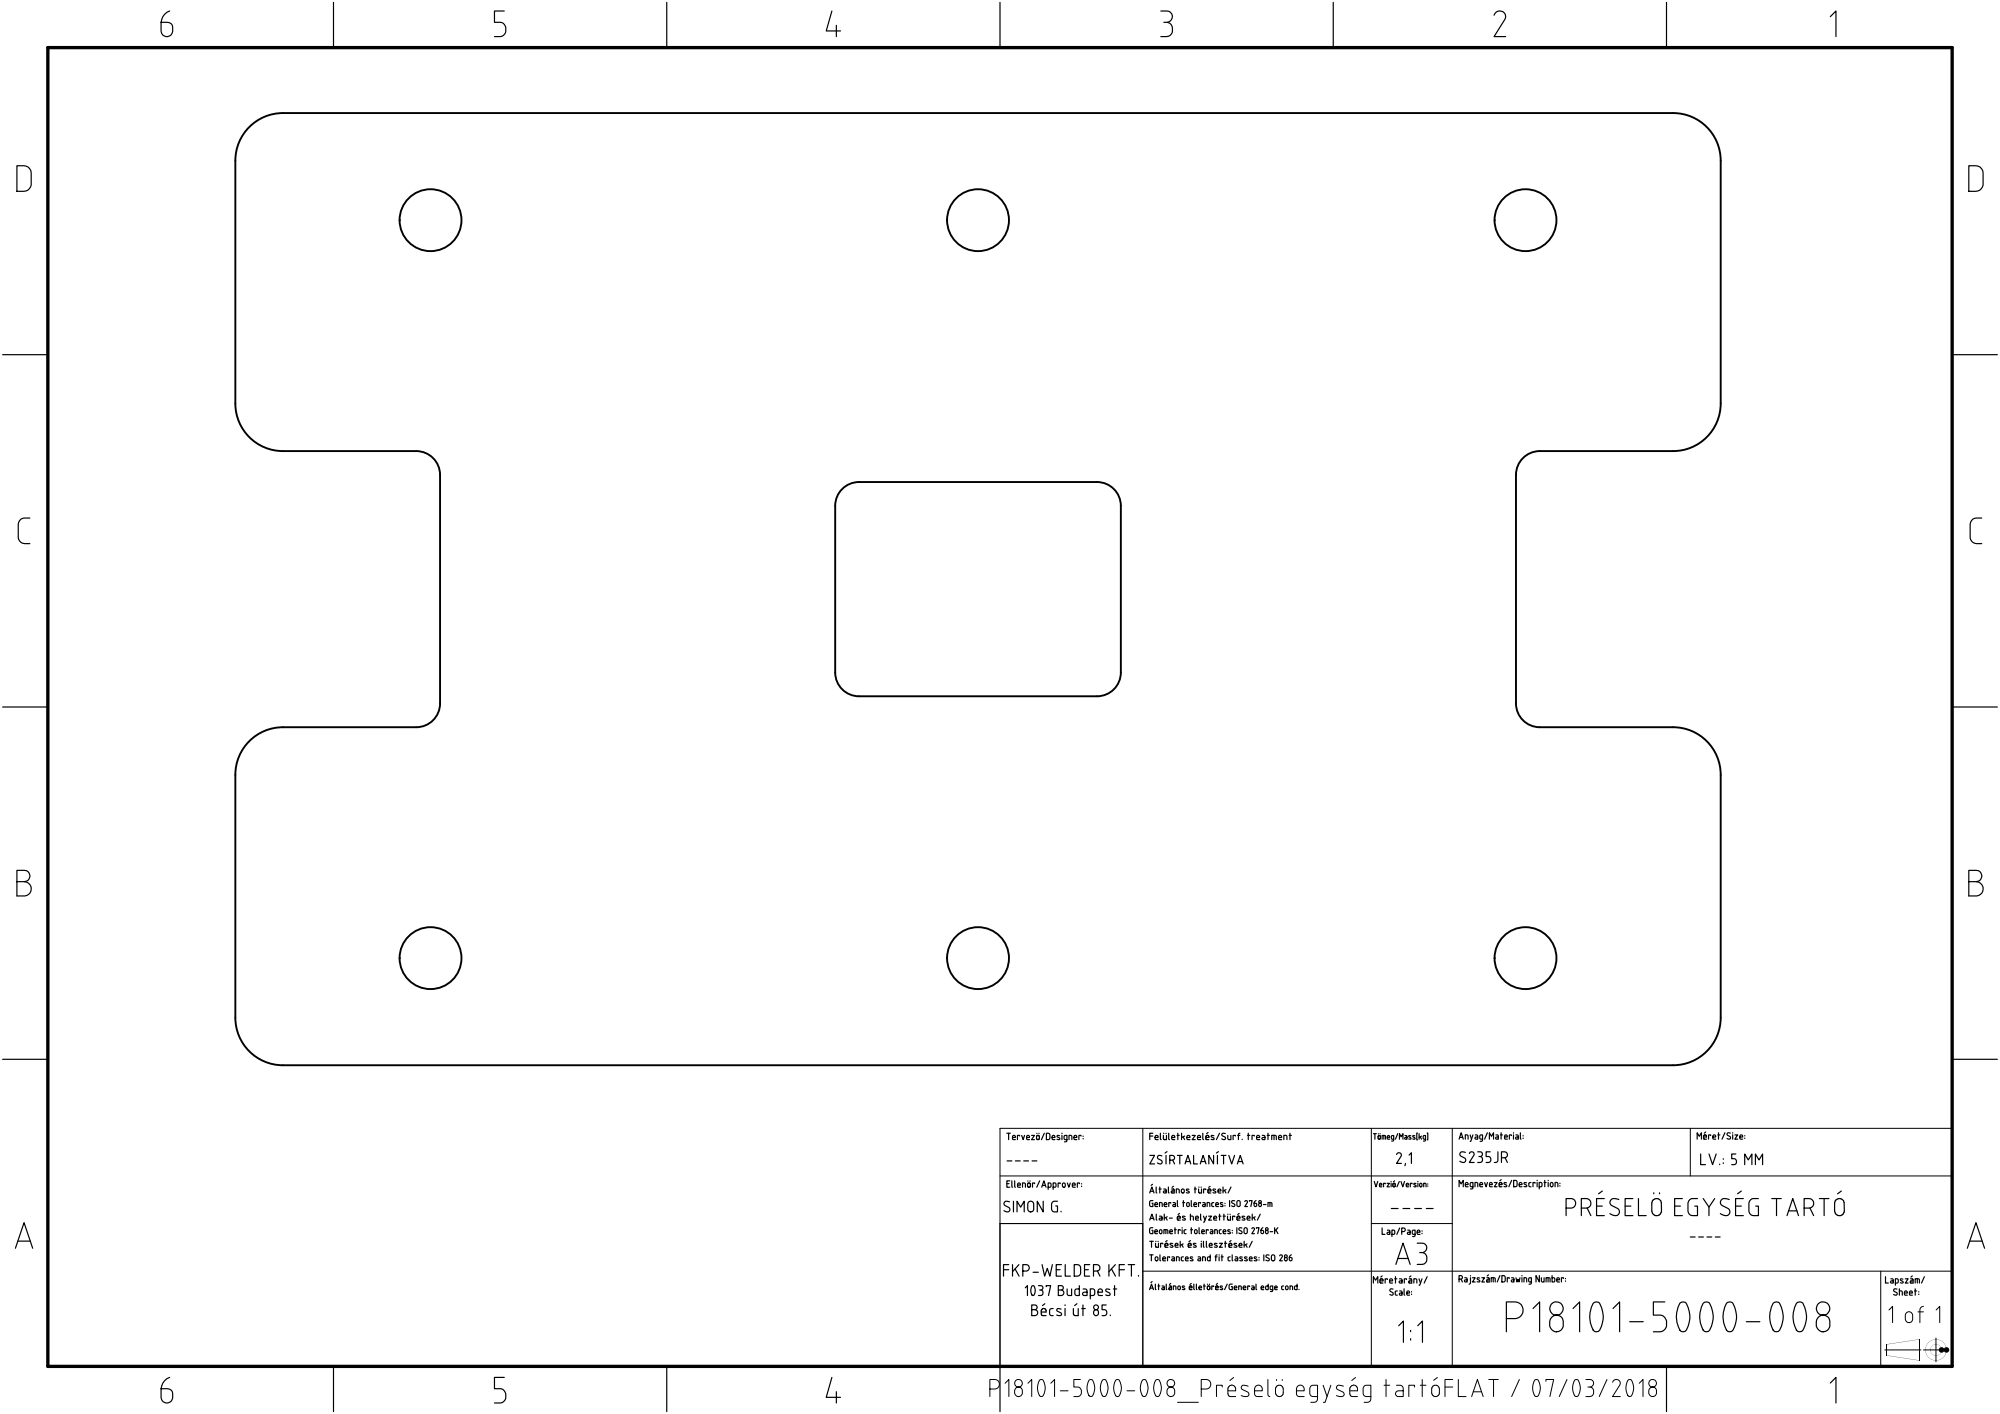
[picture p70: page 1]
