coderlazar/Metta-Pet/Tervrajzok/5000 - váz/P18101-5000-009_Elektronikai alaktrész tartó 1.pdf

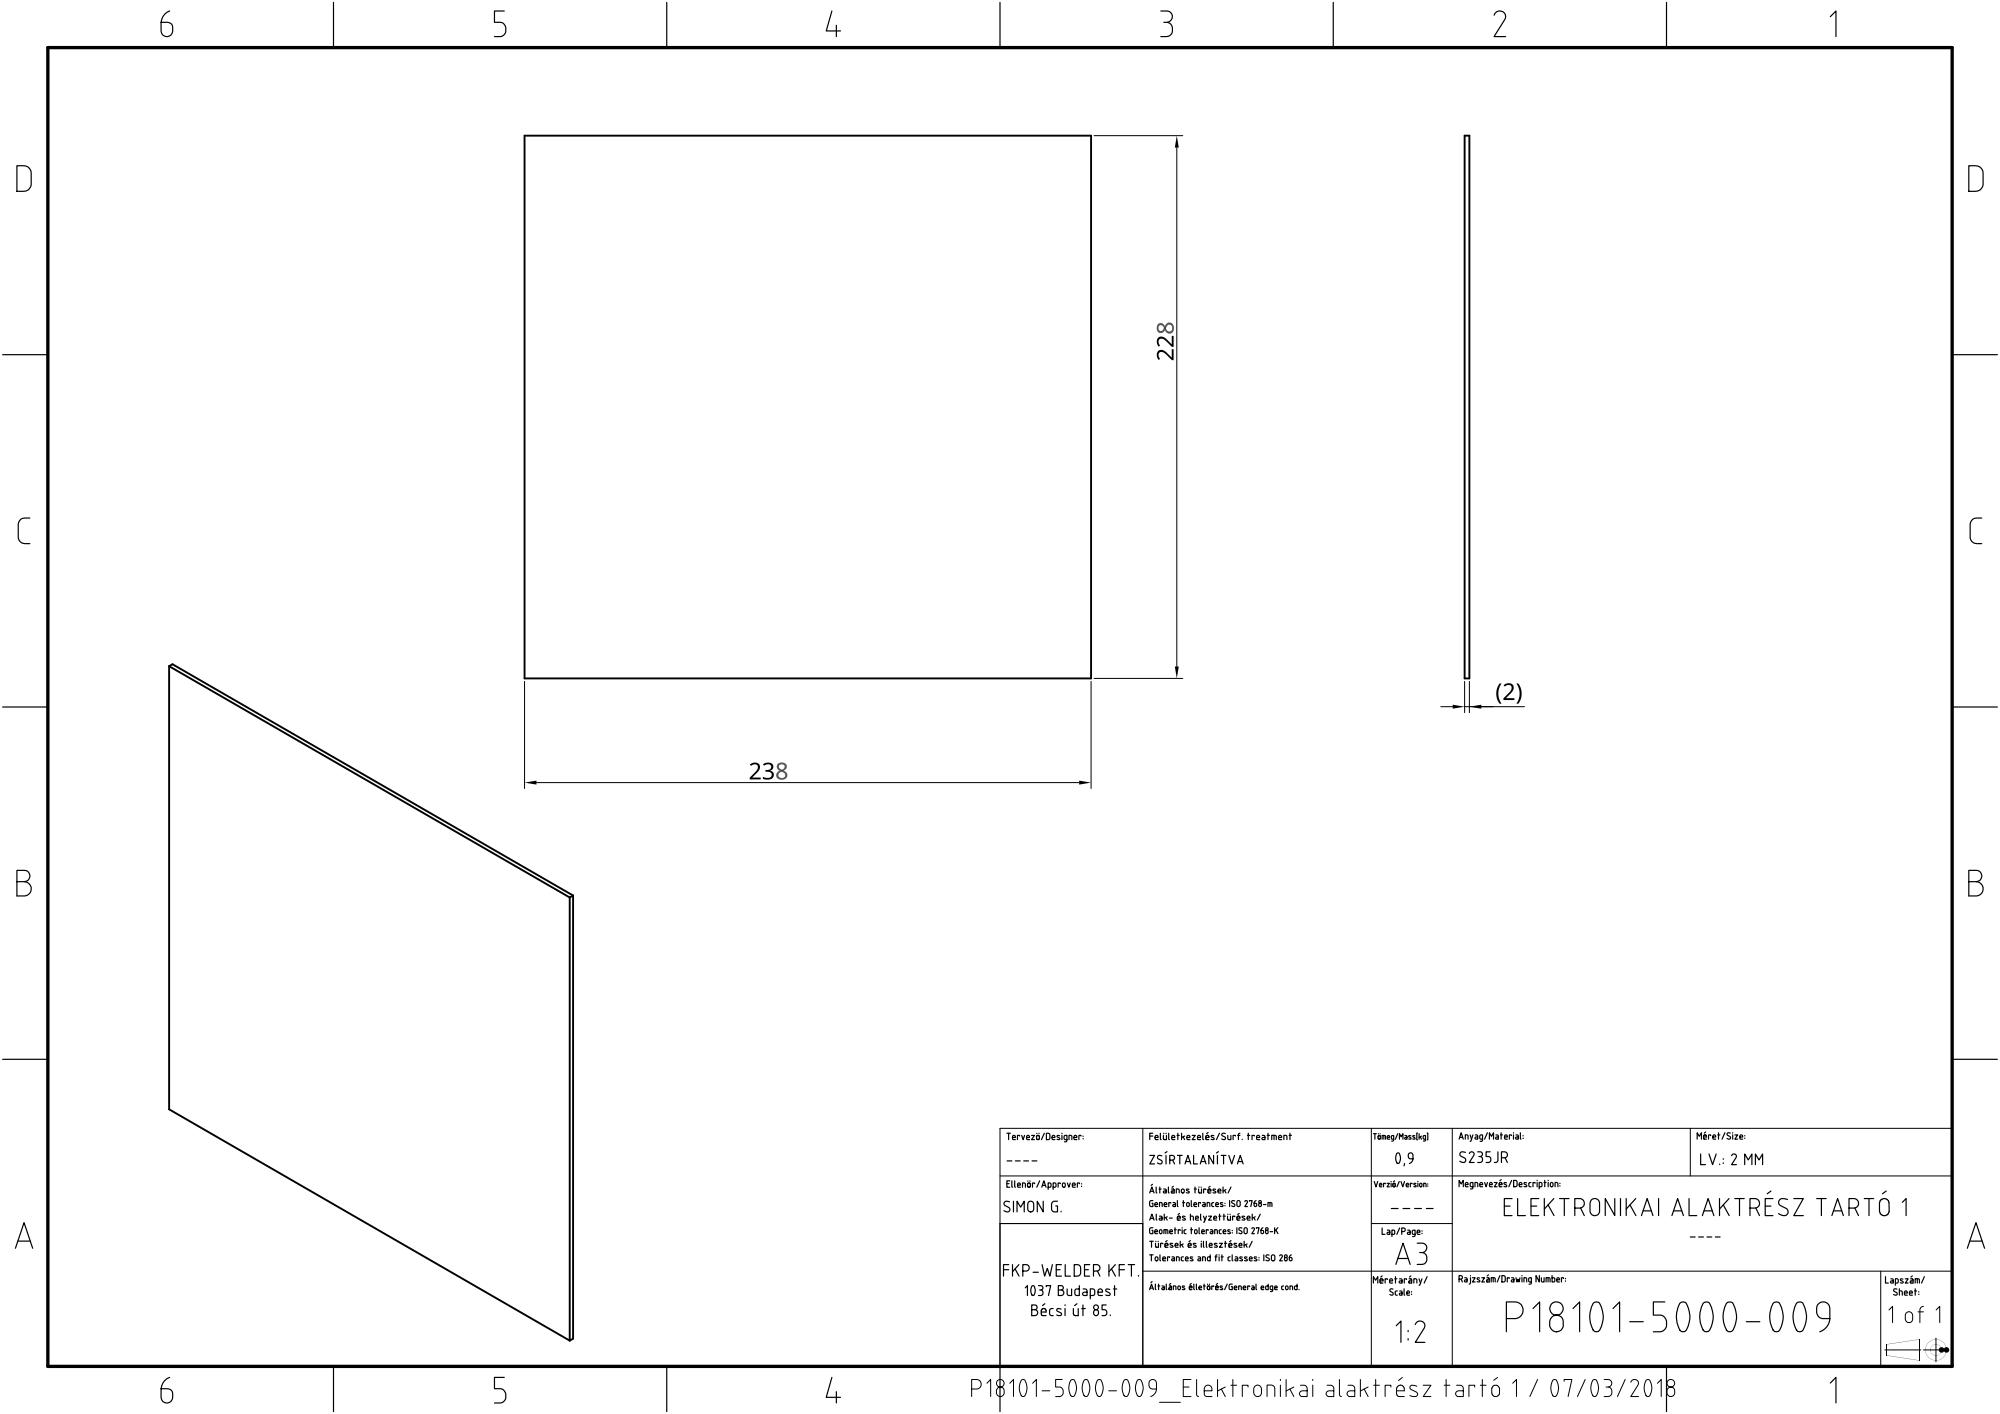
[picture p71: page 1]
