coderlazar/Metta-Pet/Tervrajzok/5000 - váz/P18101-5000-009_Elektronikai alaktrész tartó 1FLAT.pdf

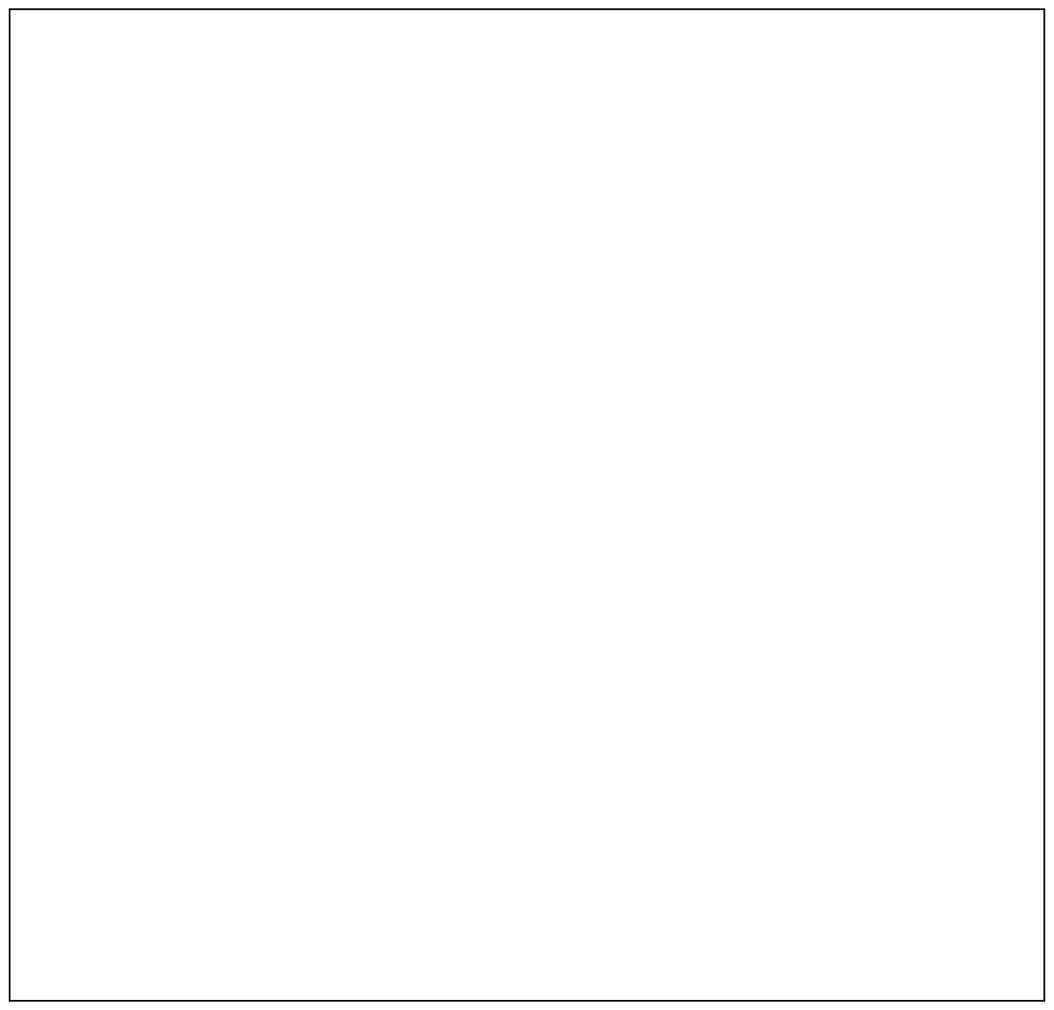
[picture p72: page 1]
