coderlazar/Metta-Pet/Tervrajzok/5000 - váz/P18101-5000-010_Elektronikai alaktrész tartó 2.pdf

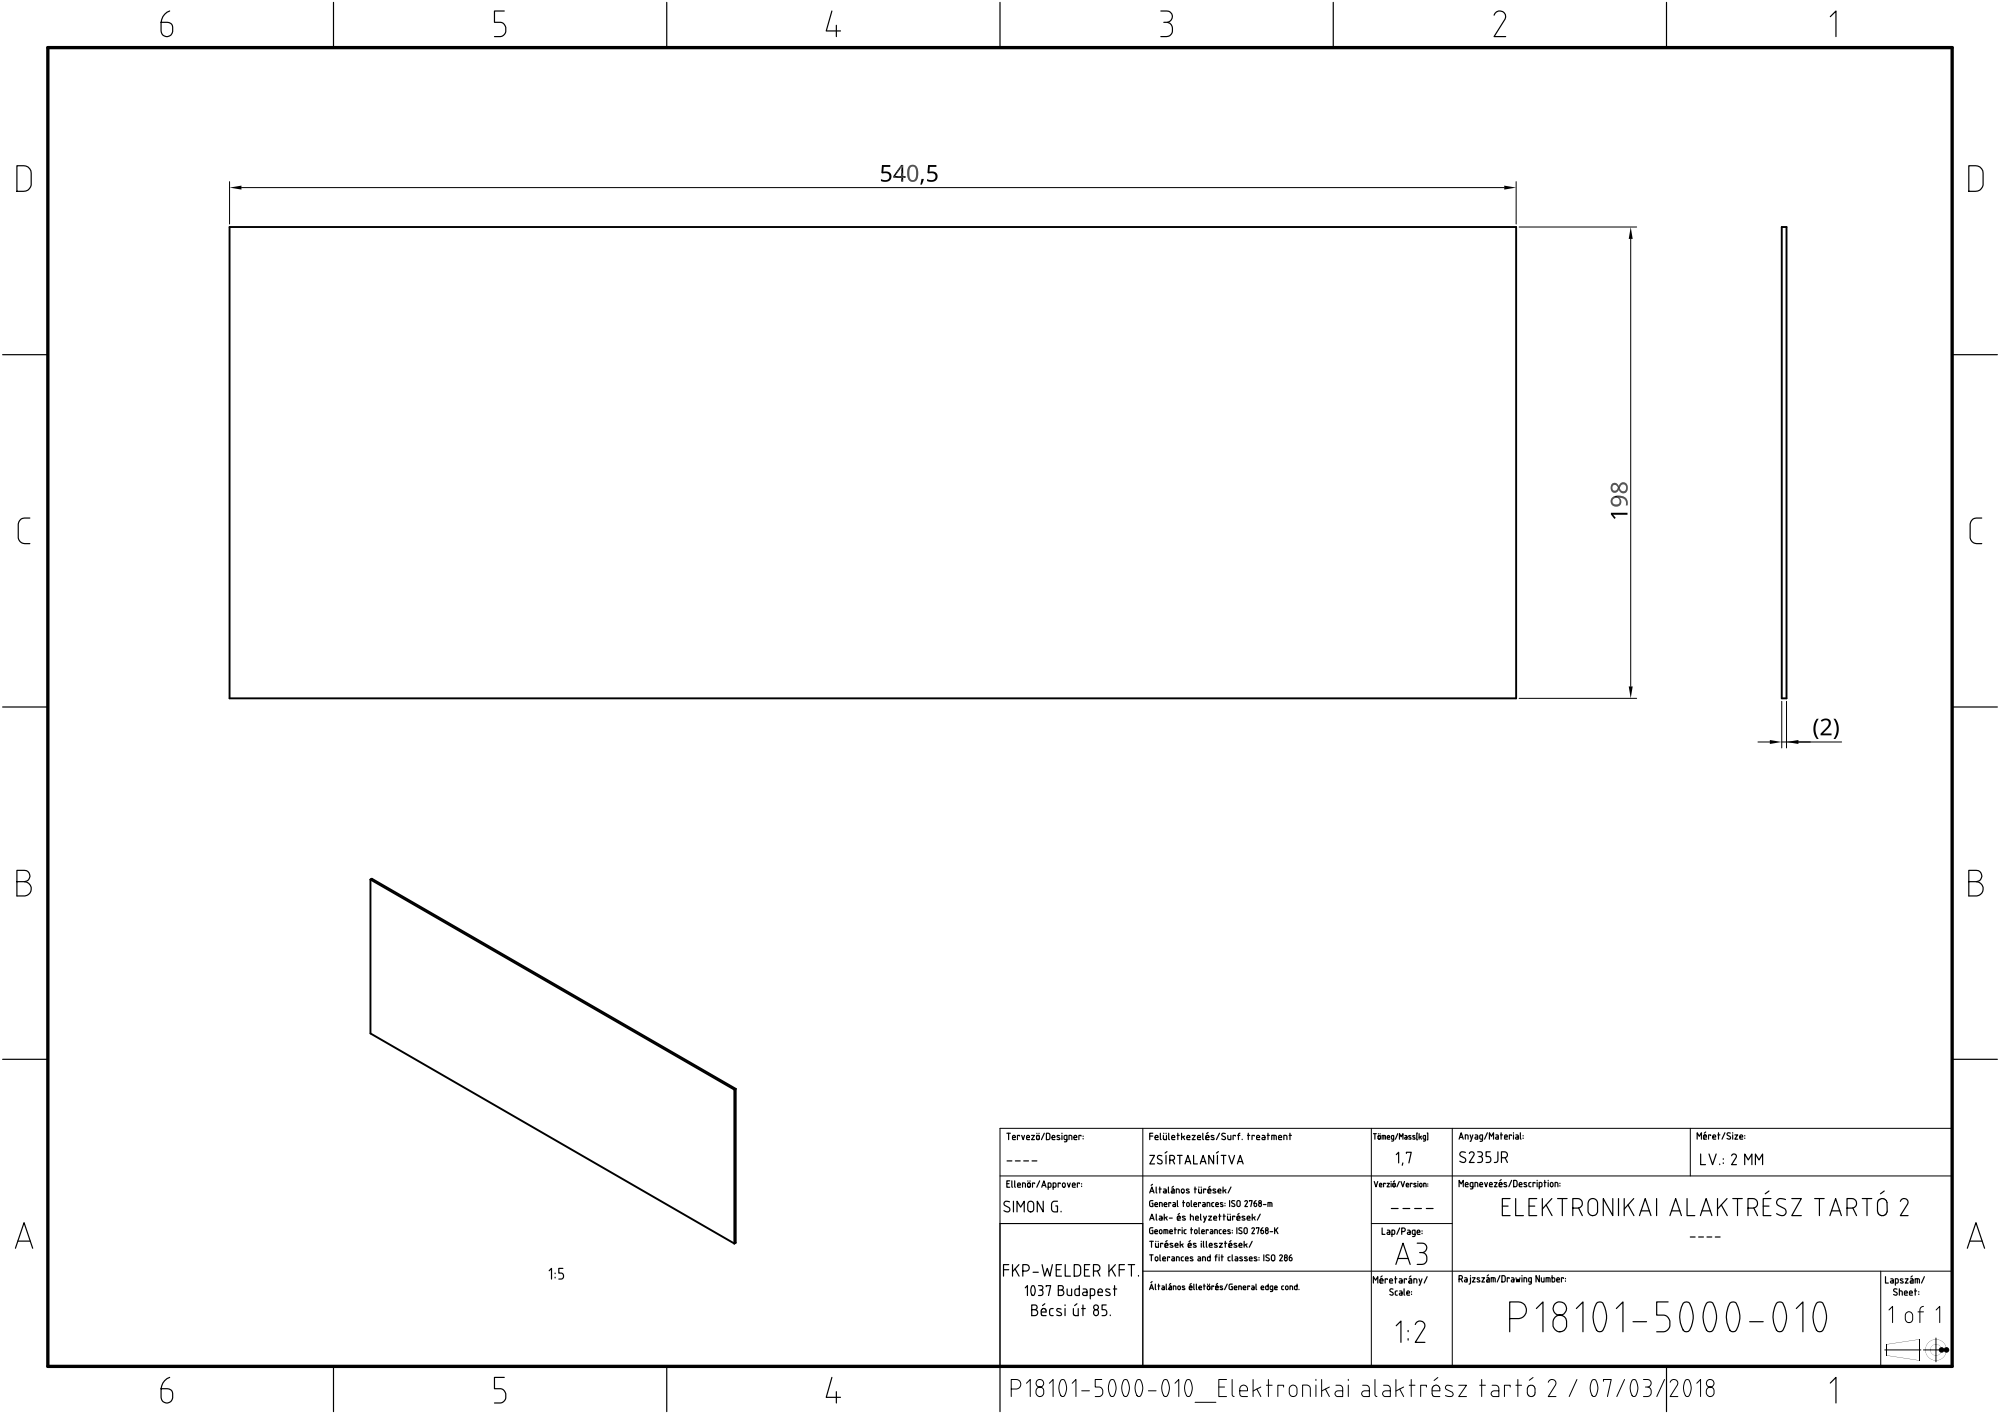
[picture p73: page 1]
