coderlazar/Metta-Pet/Tervrajzok/5000 - váz/P18101-5000-010_Elektronikai alaktrész tartó 2FLAT.pdf

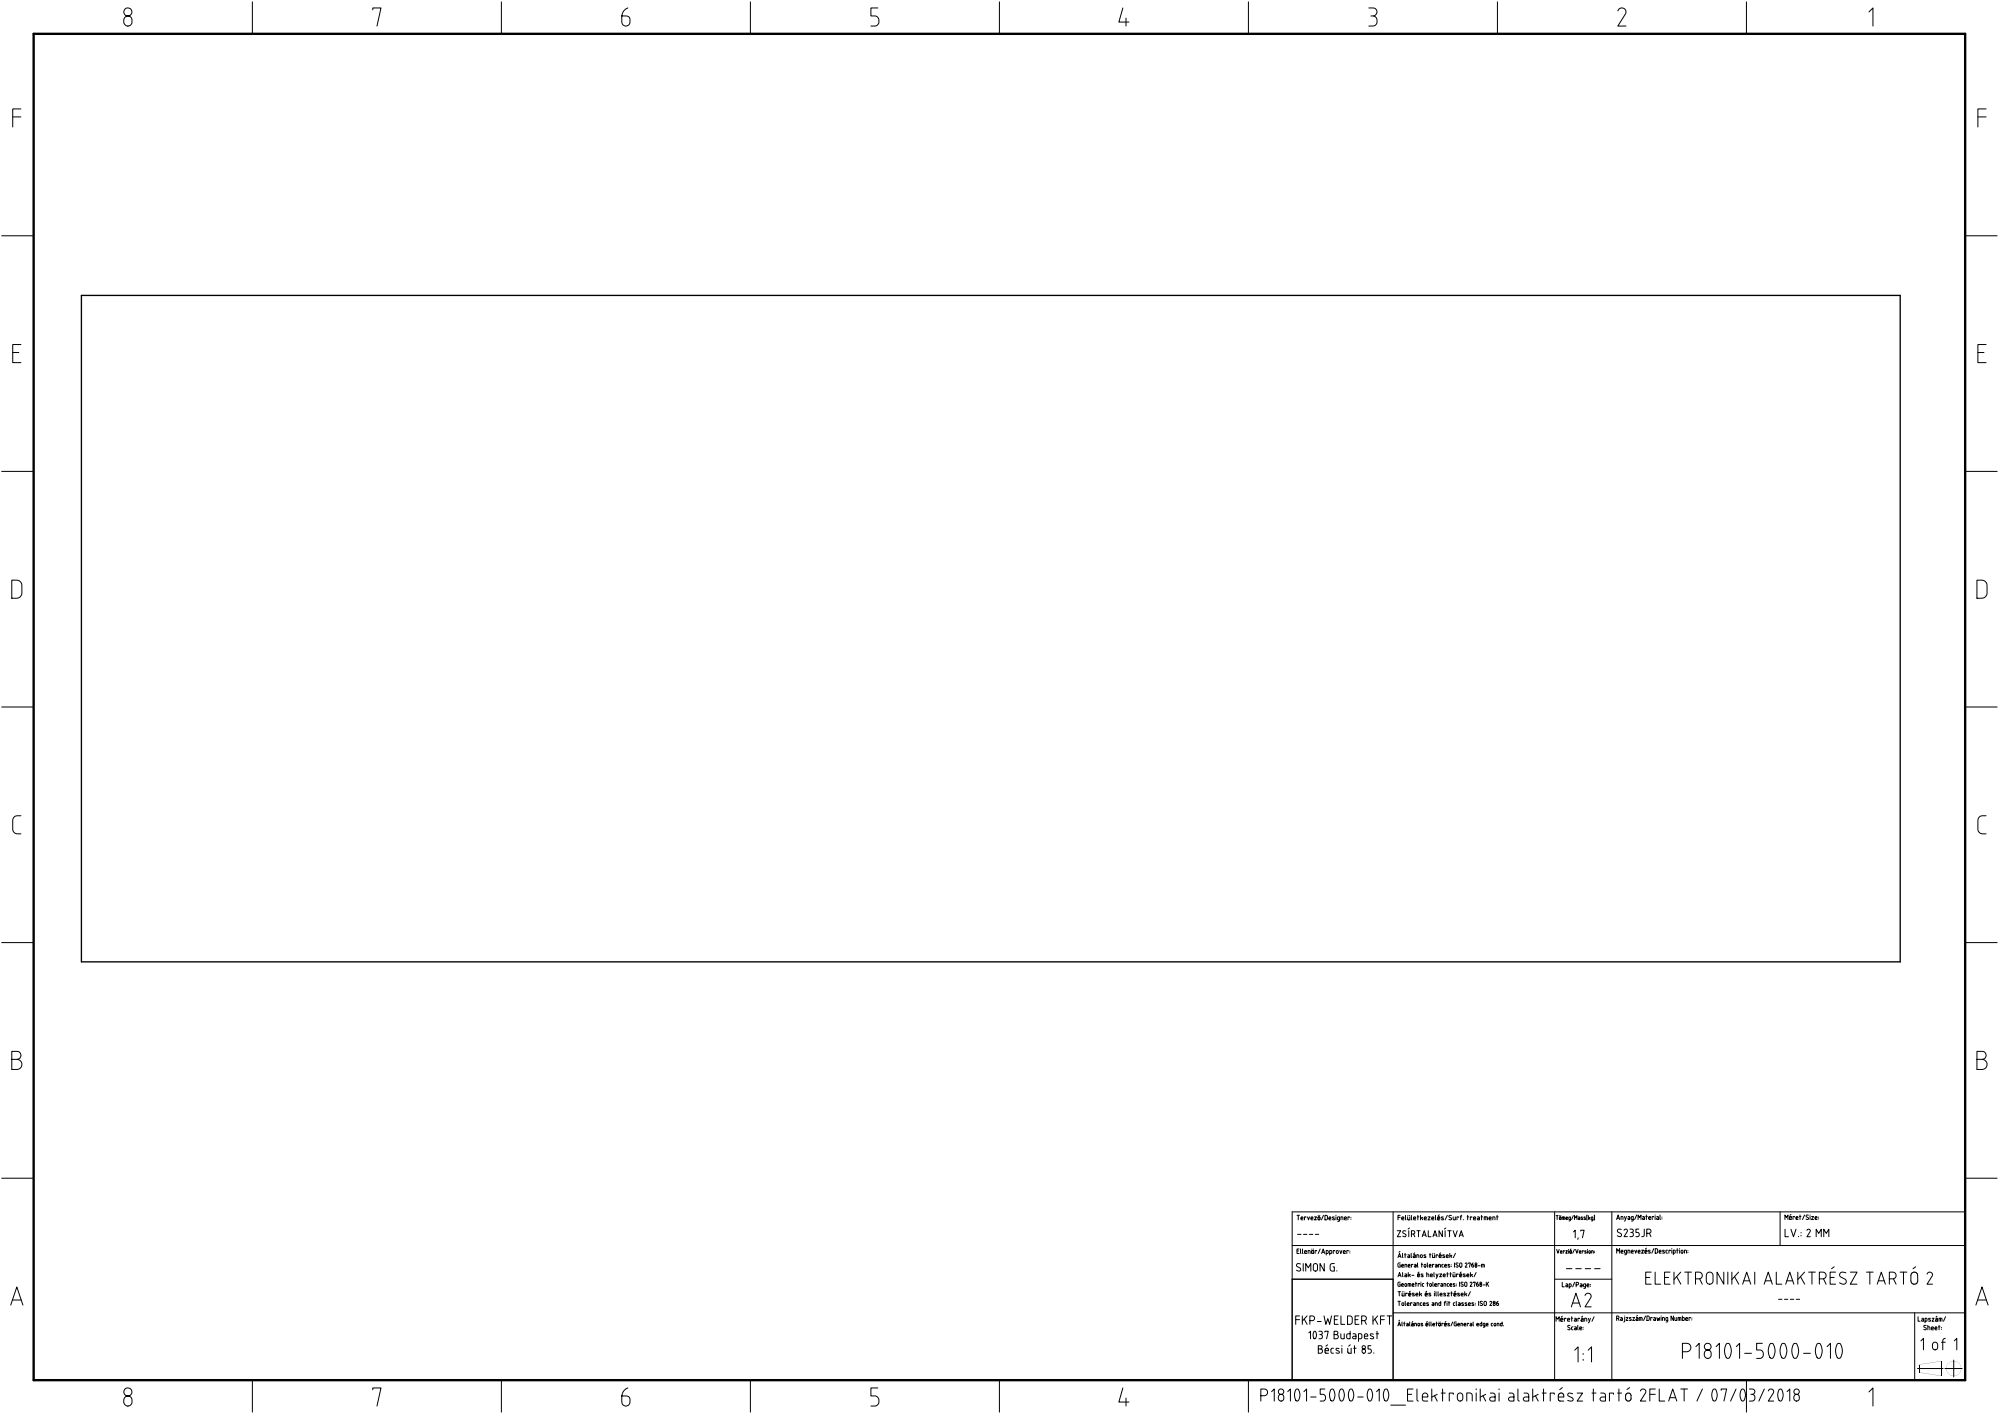
[picture p74: page 1]
