coderlazar/Metta-Pet/Tervrajzok/5000 - váz/P18101-5000-011_Ajtó tartó konzolFLAT.pdf

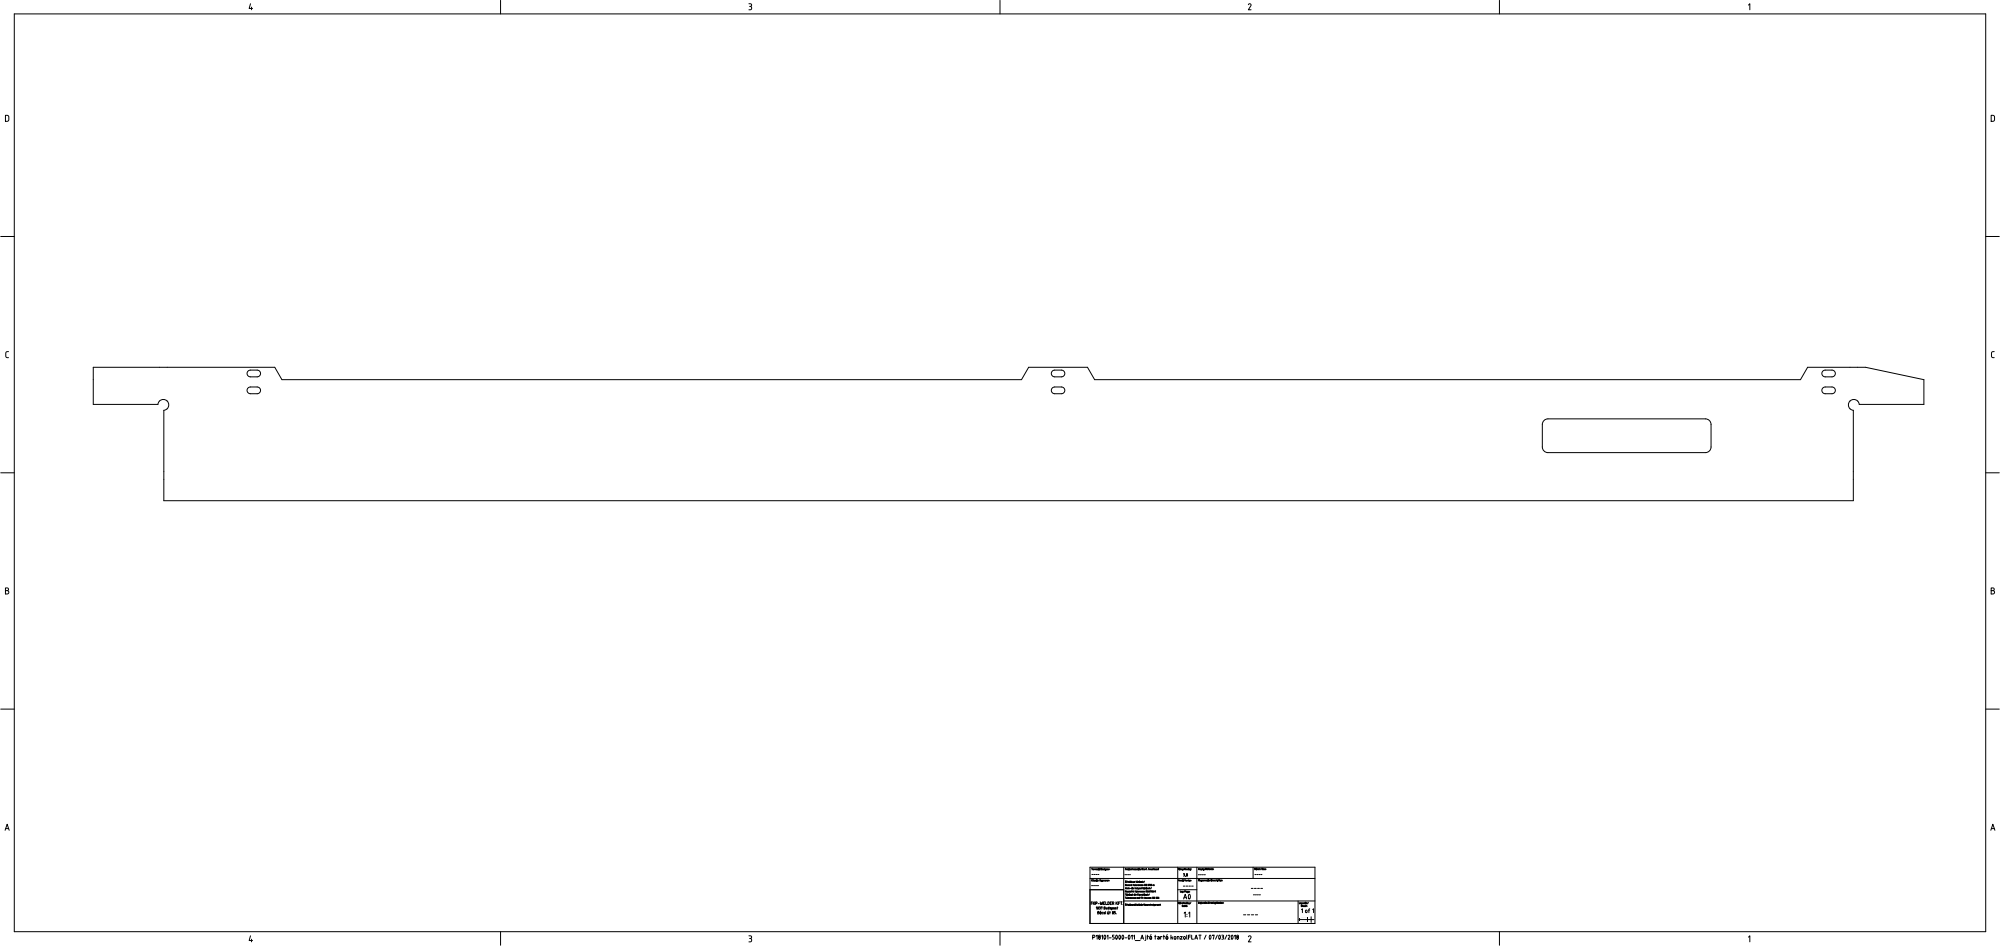
[picture p75: page 1]
