coderlazar/Metta-Pet/Tervrajzok/5000 - váz/P18101-5000-012_Ledobás terelö szoknyaFLAT.pdf

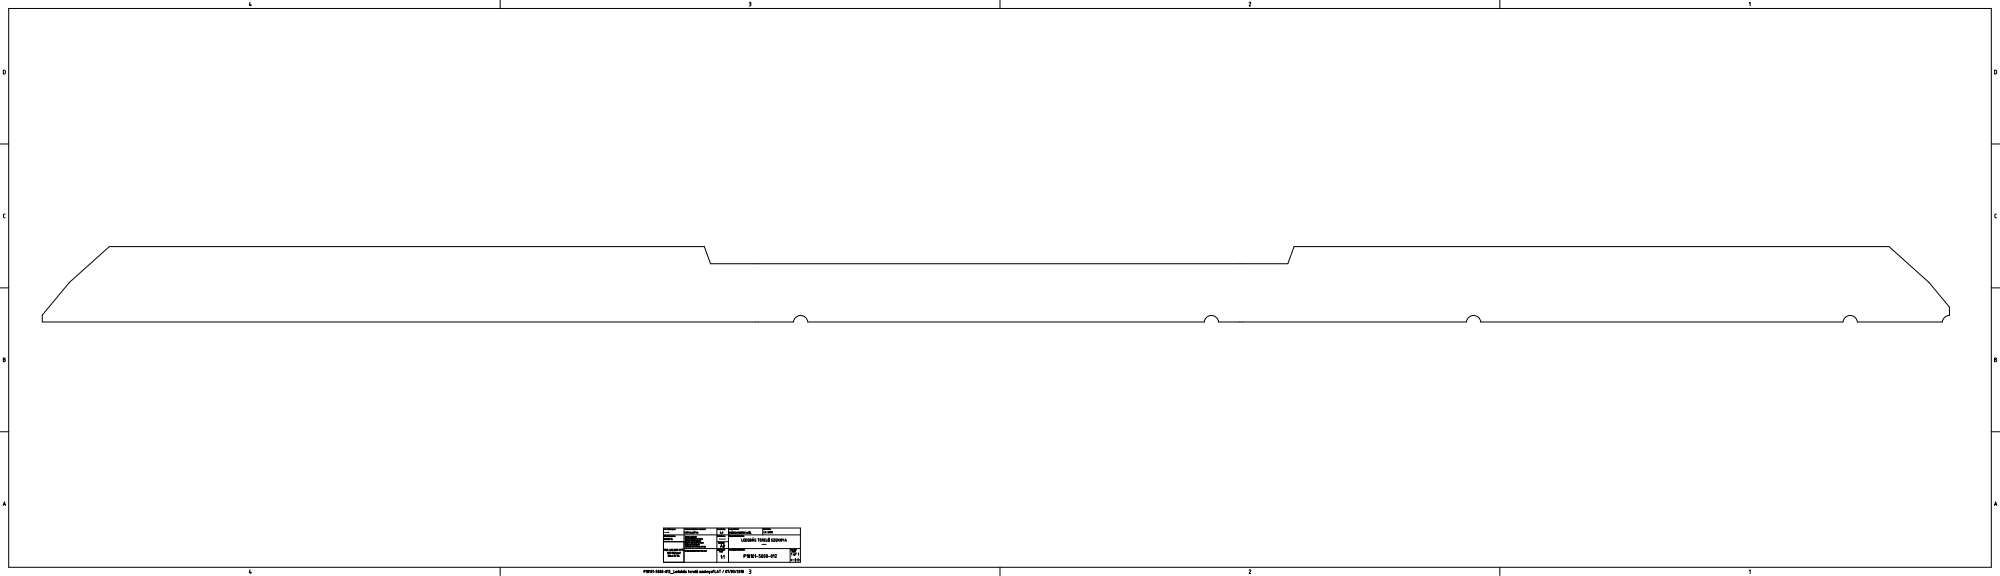
[picture p76: page 1]
