coderlazar/Metta-Pet/Tervrajzok/5000 - váz/P18101-5000-013_Ledobás terelö lejtöFLAT.pdf

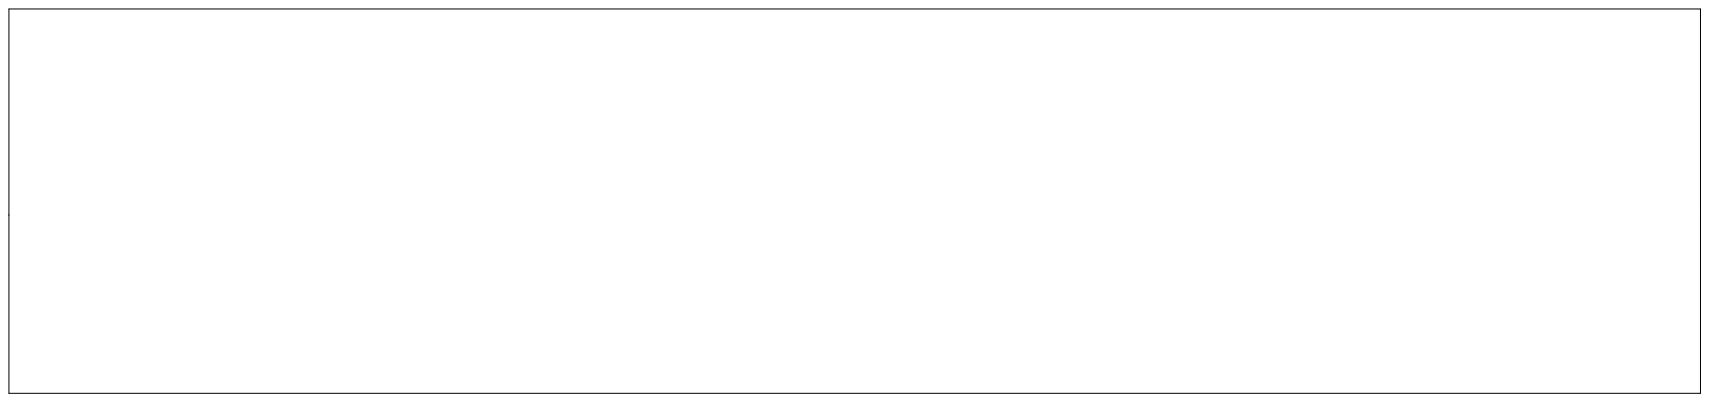
[picture p77: page 1]
