coderlazar/Metta-Pet/Tervrajzok/5000 - váz/P18101-5000-014_Aktuátor rögzítö konzolFLAT.pdf

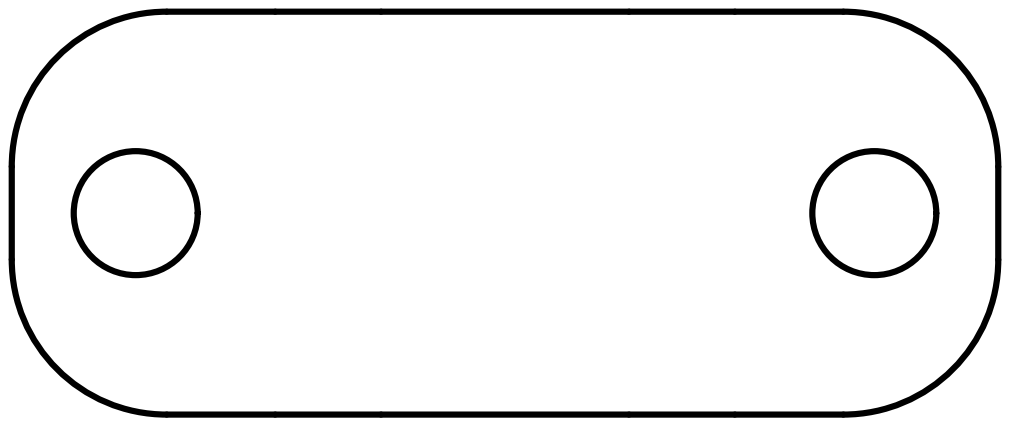
[picture p78: page 1]
