coderlazar/Metta-Pet/Tervrajzok/elhajlított alkatrészek/P18101-5000-001_Emelö papucs elsö merevitö.pdf

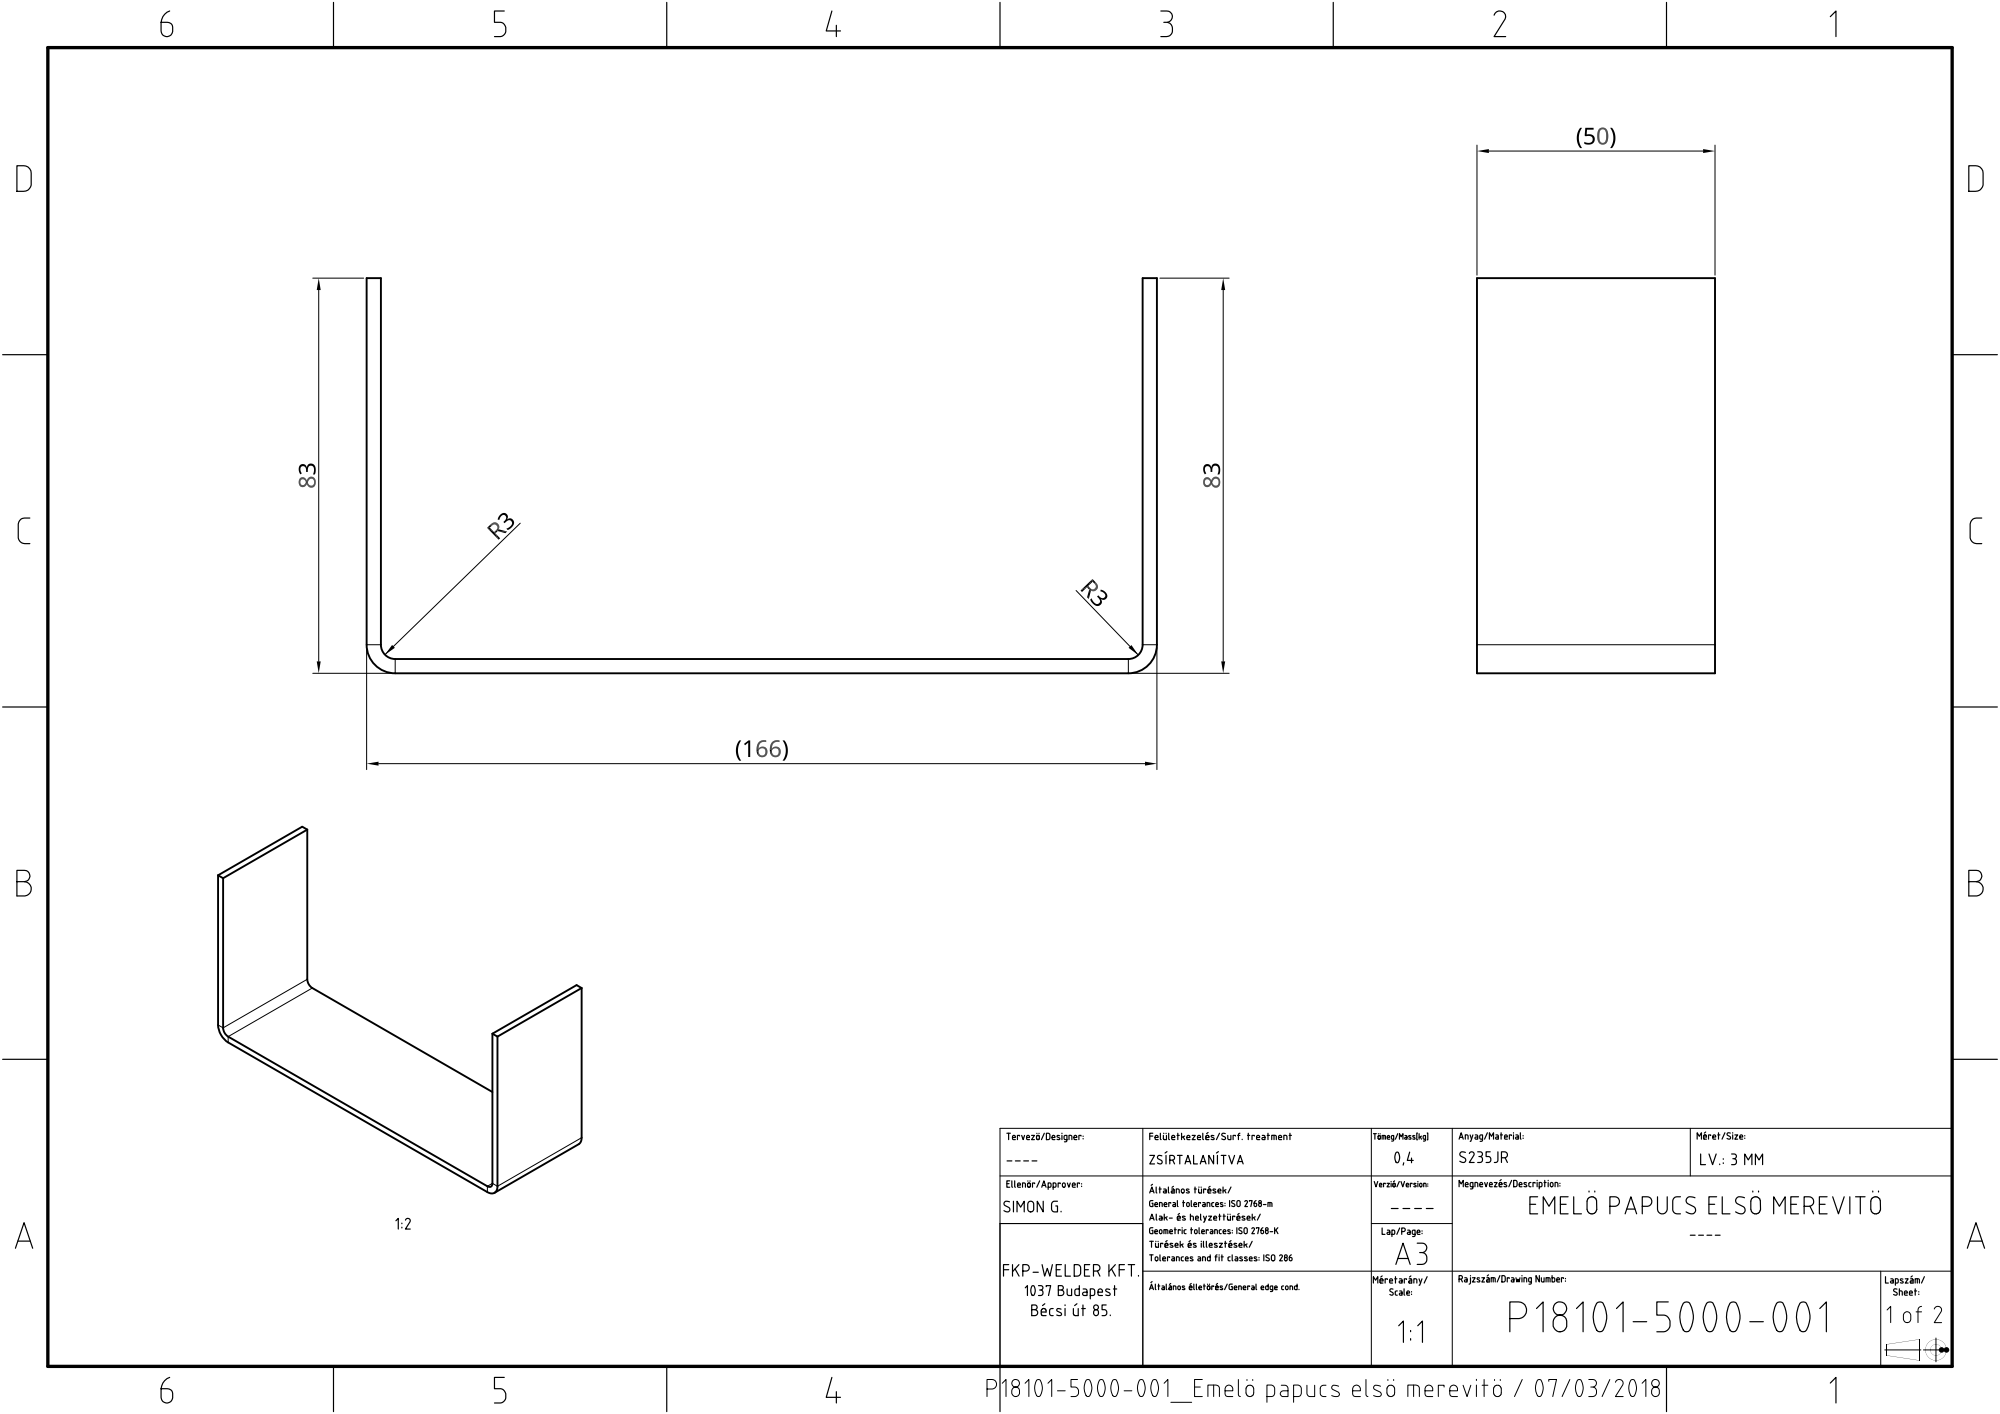
[picture p79: page 1]
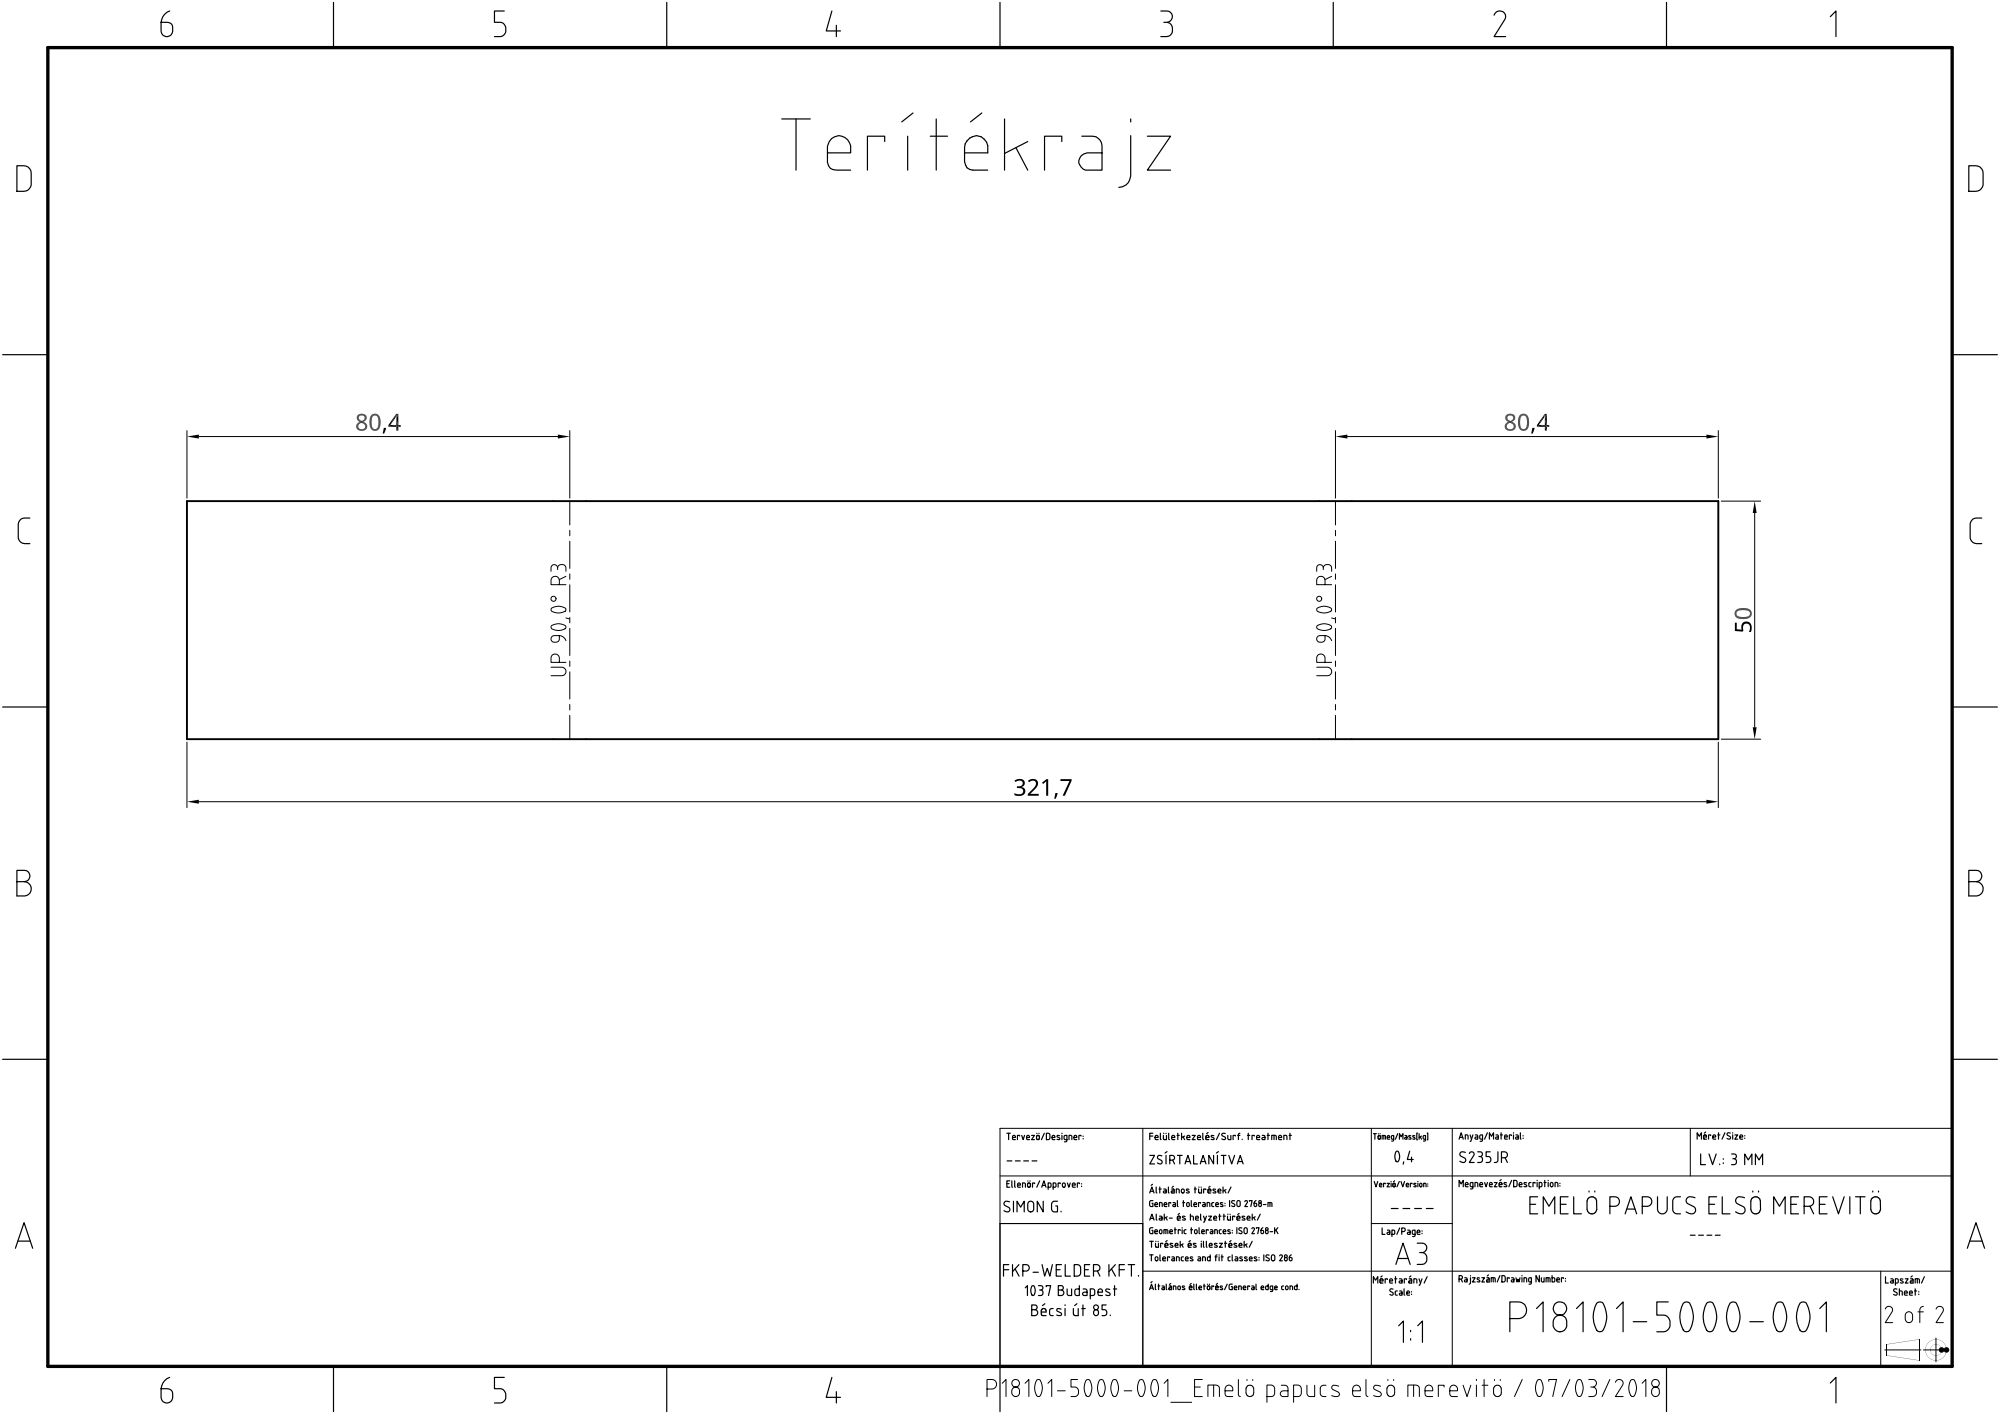
[picture p80: page 2]
