coderlazar/Metta-Pet/Tervrajzok/elhajlított alkatrészek/P18101-5000-002_Emelö papucs hátsó merevitö.pdf

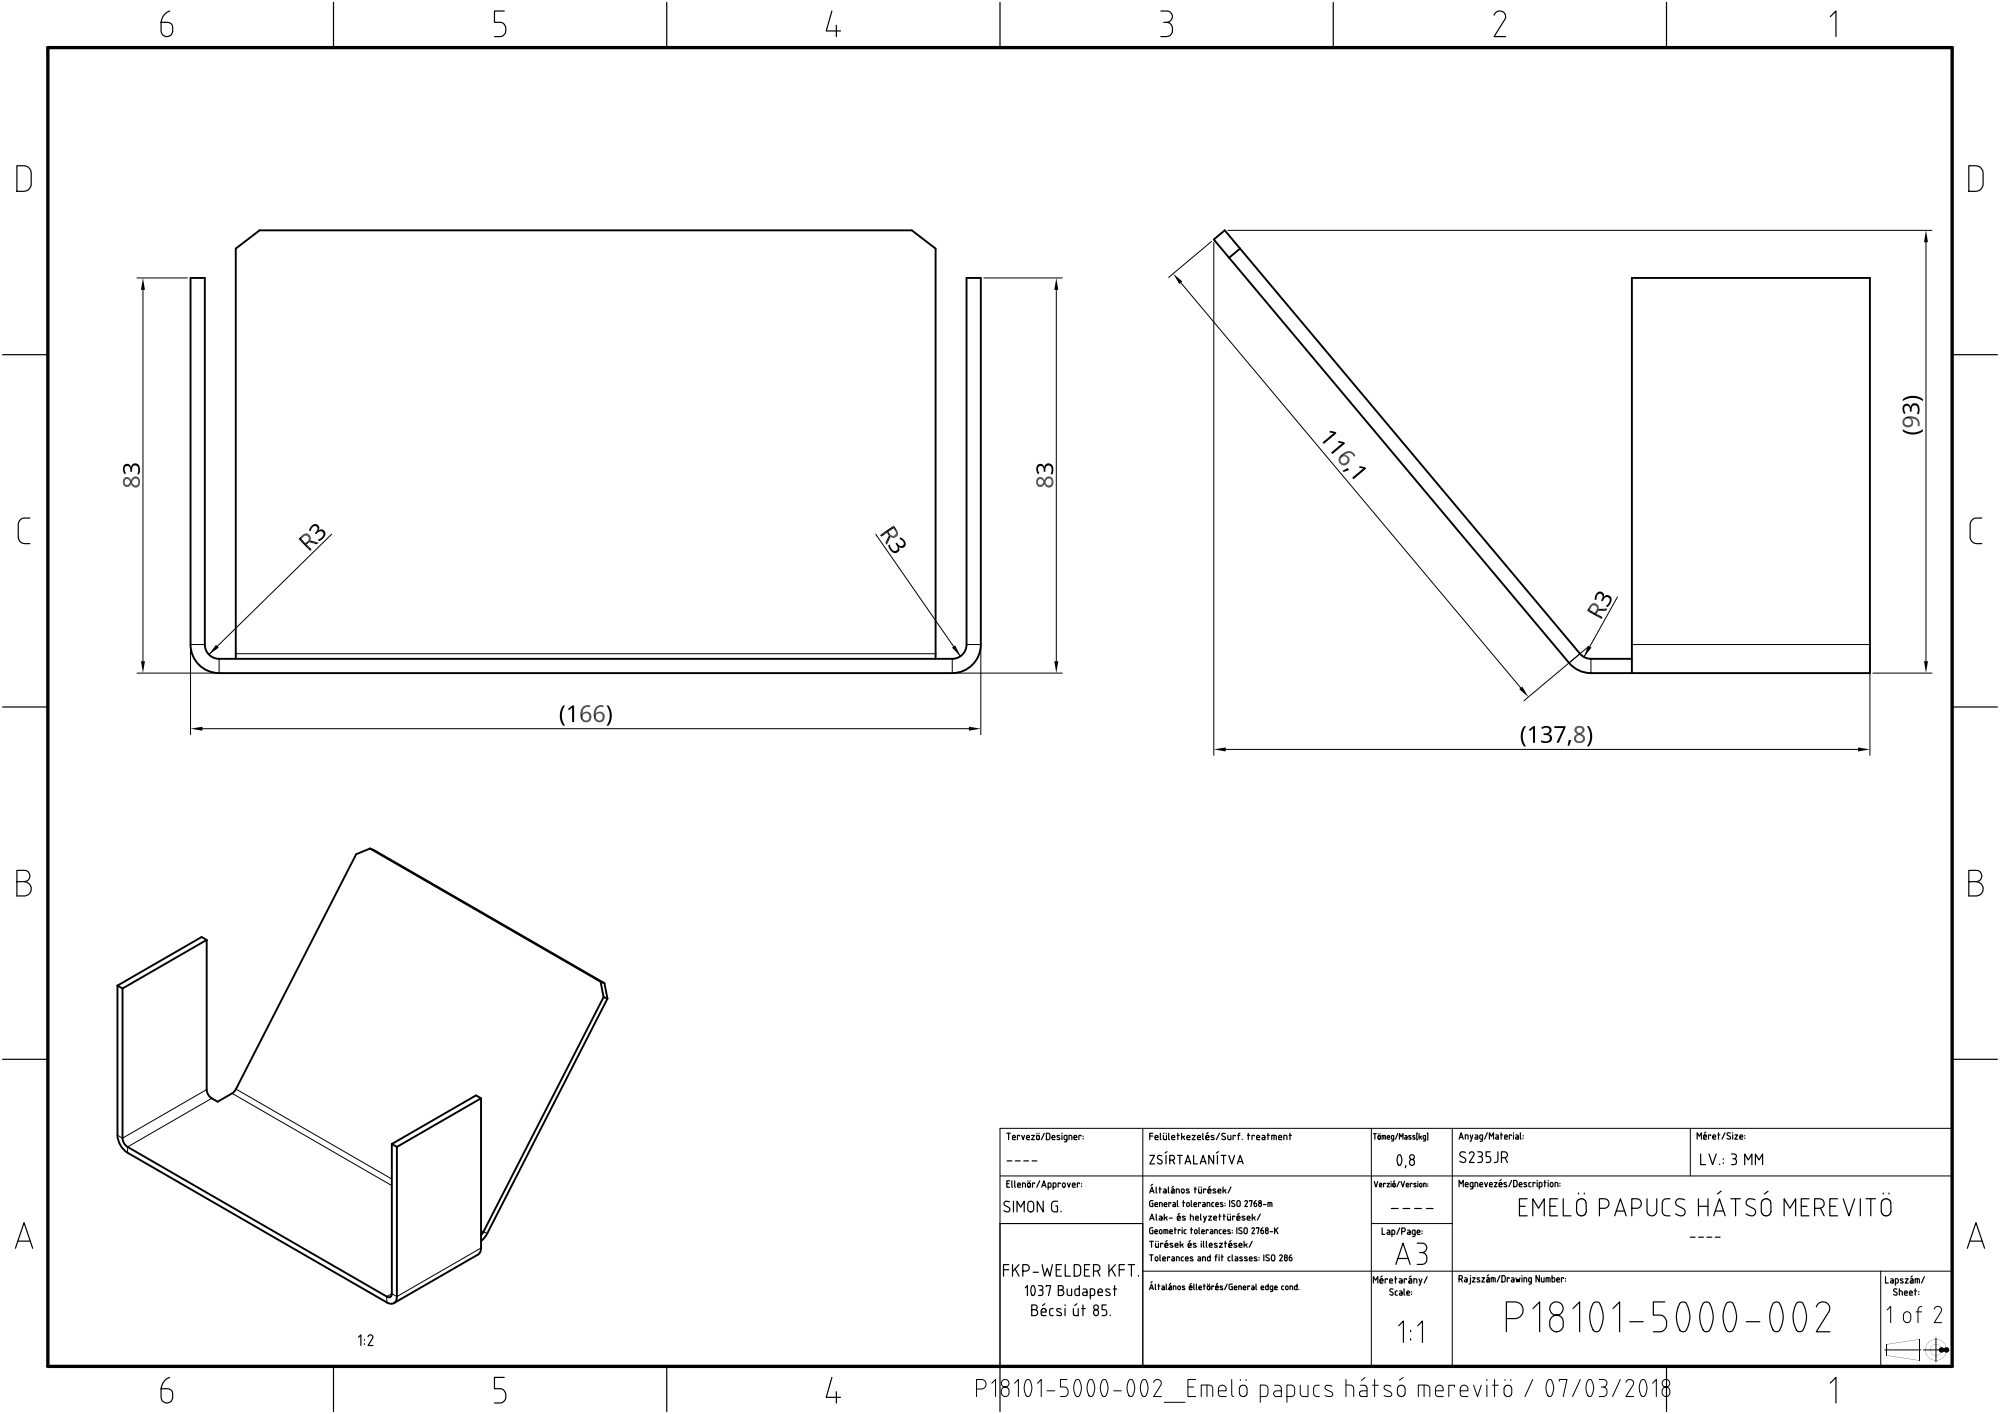
[picture p81: page 1]
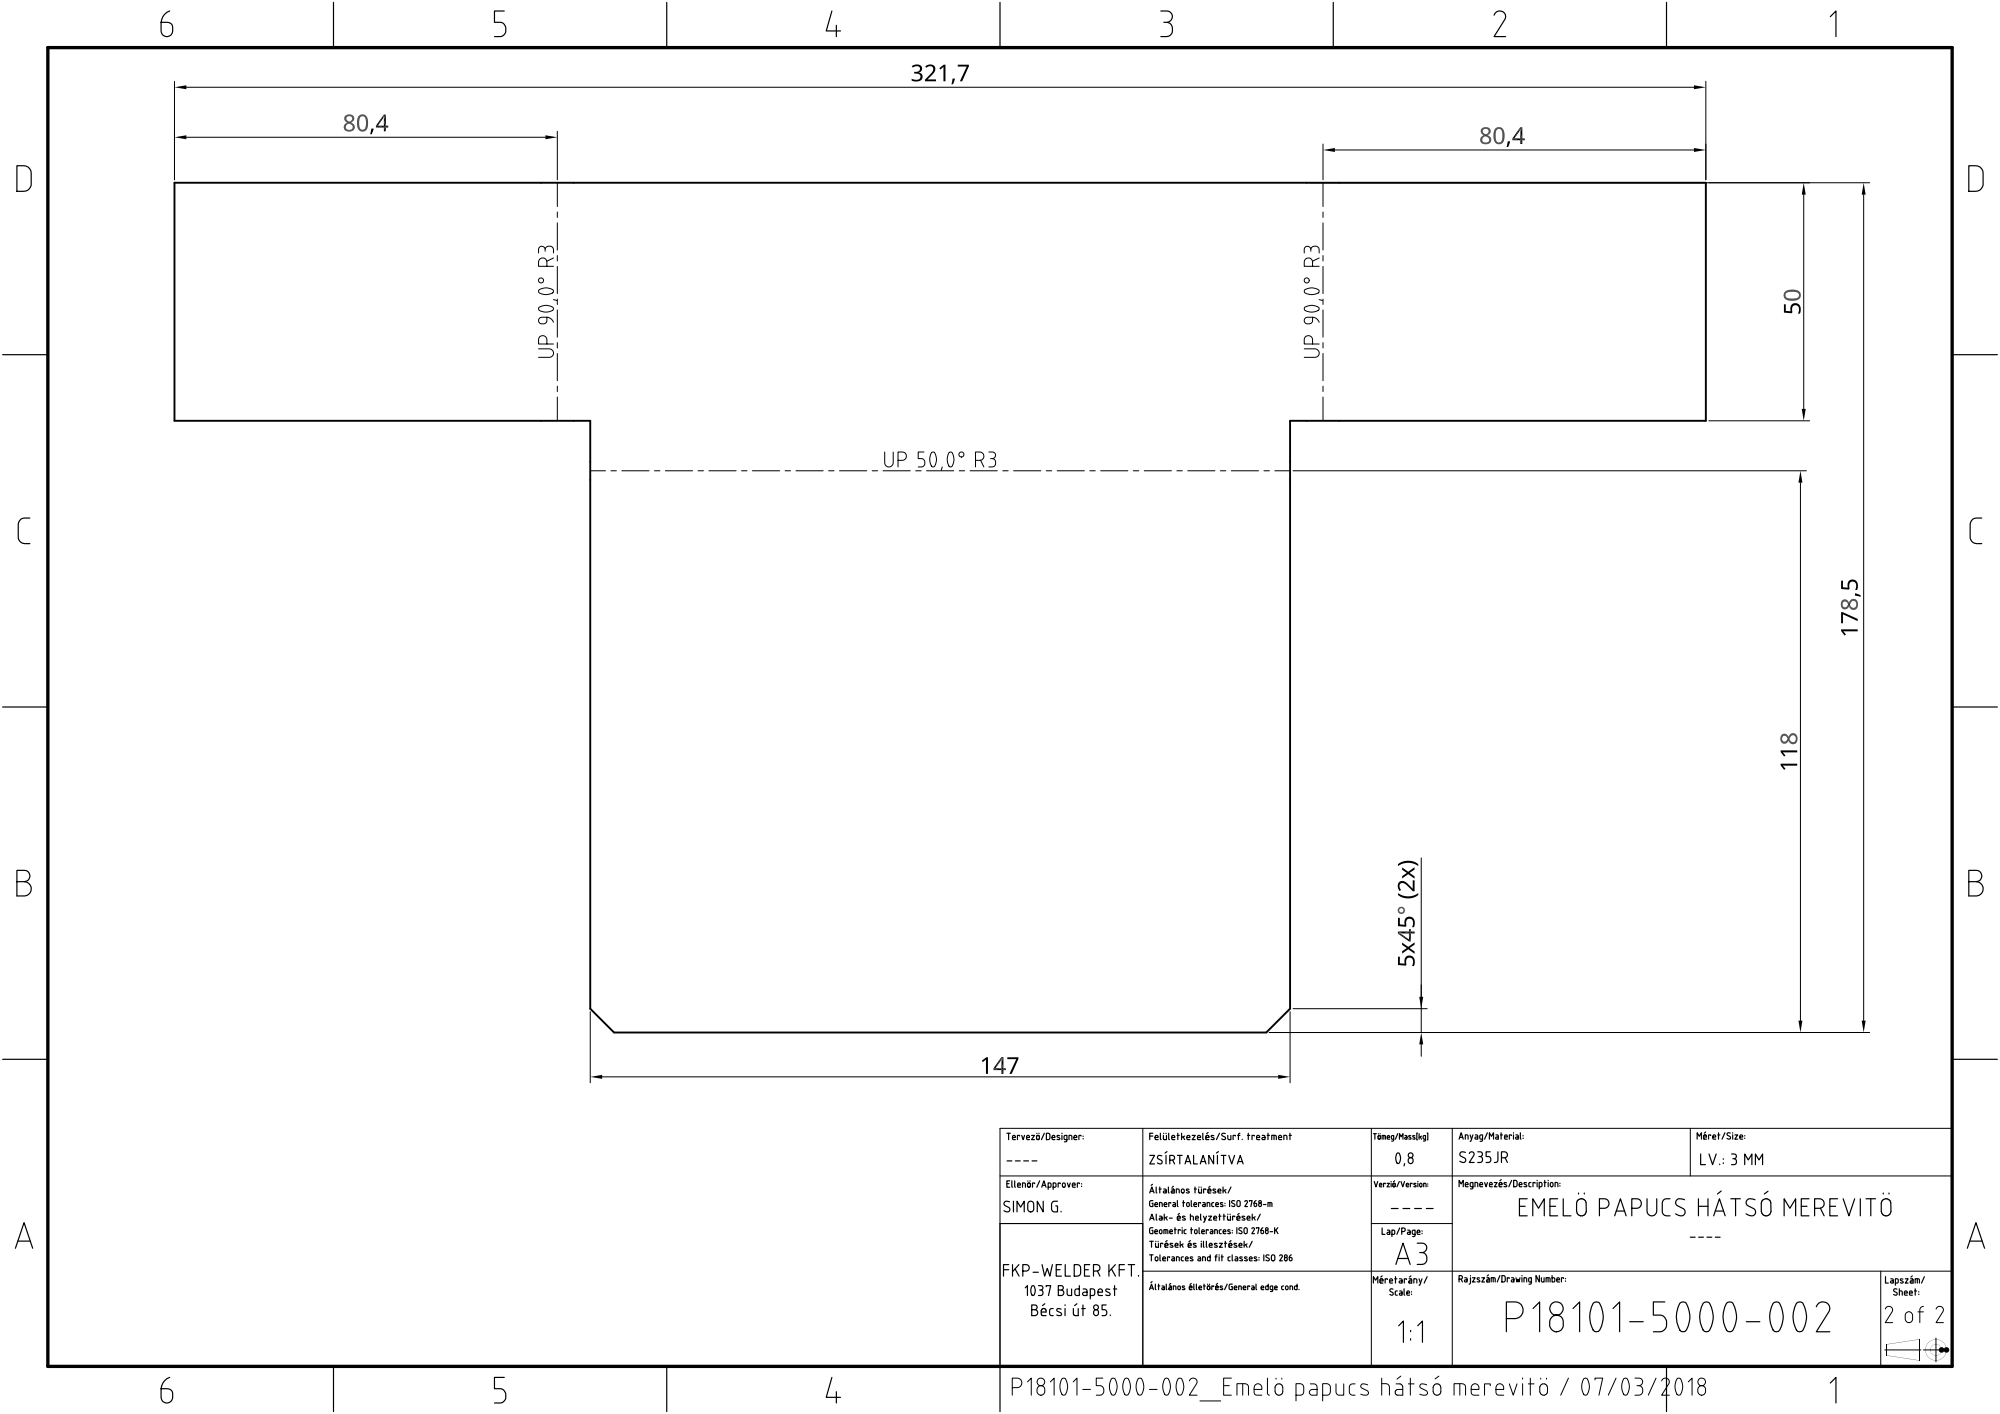
[picture p82: page 2]
