coderlazar/Metta-Pet/Tervrajzok/elhajlított alkatrészek/P18101-5000-004_Padló lemez jobb.pdf

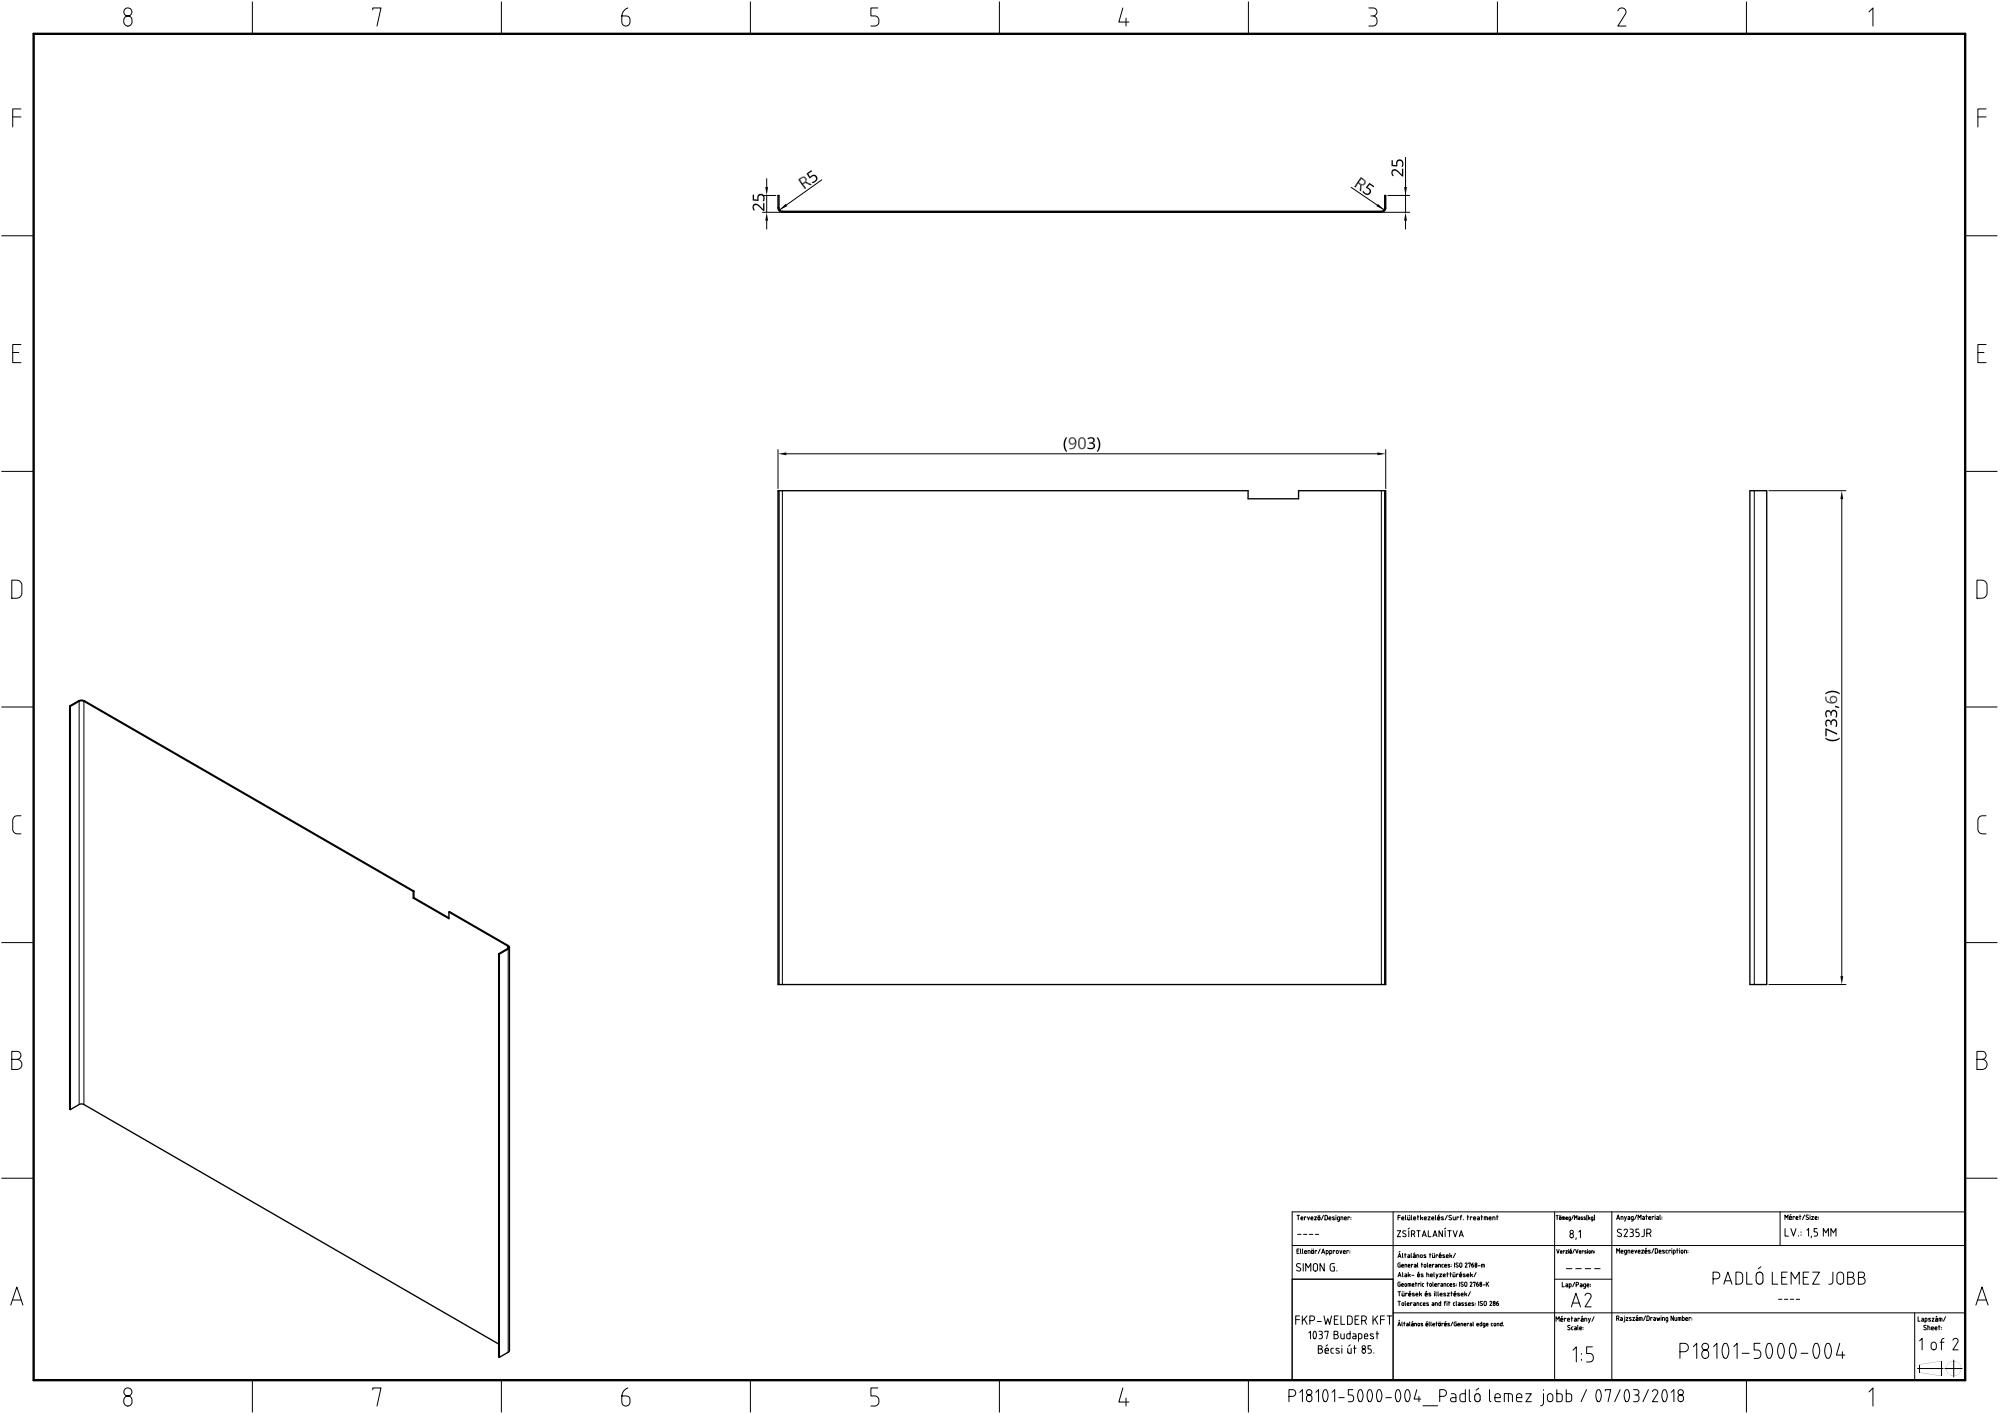
[picture p83: page 1]
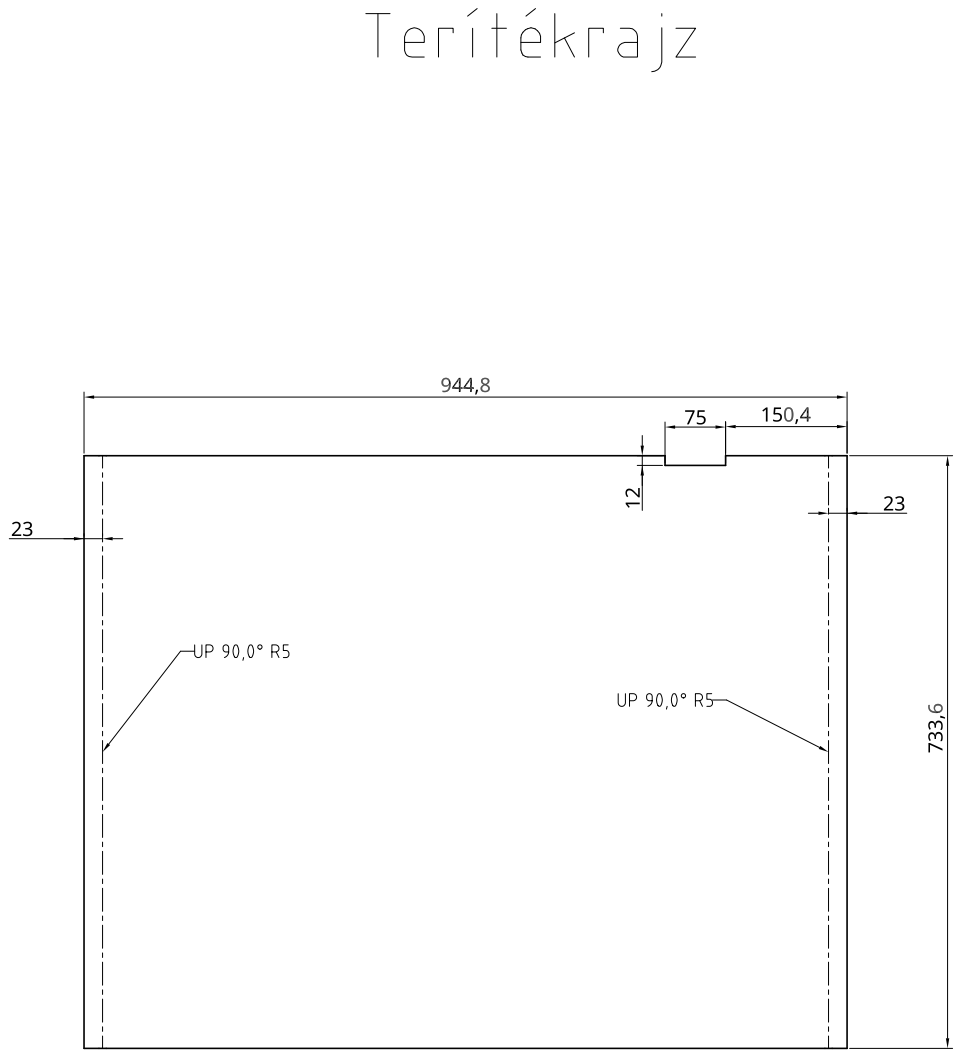
[picture p84: page 2]
