coderlazar/Metta-Pet/Tervrajzok/elhajlított alkatrészek/P18101-5000-006_Emelö papucs.pdf

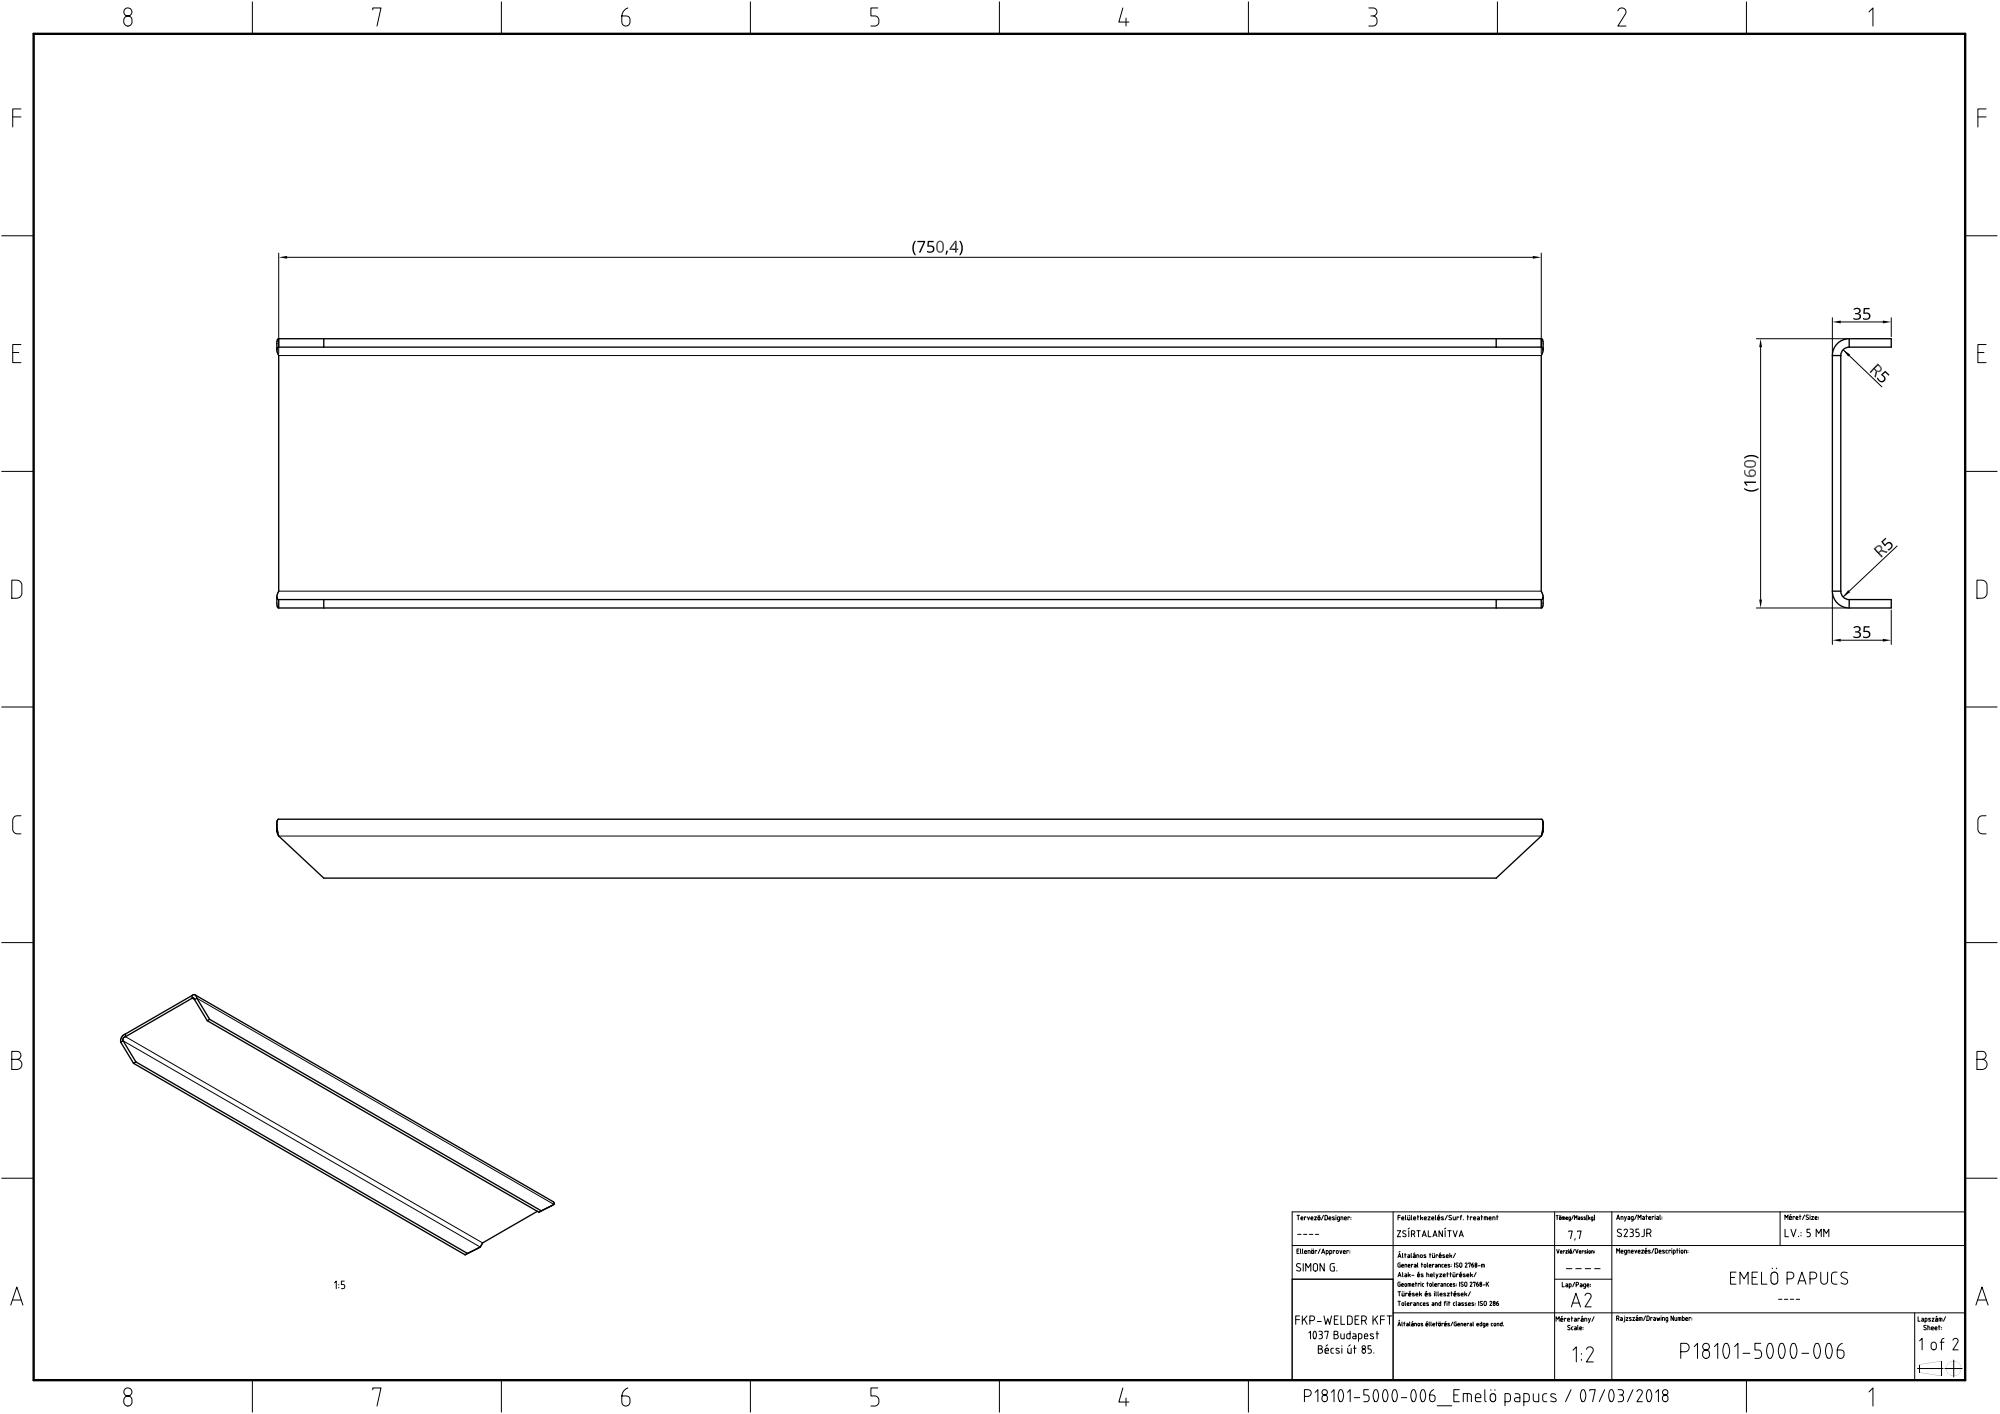
[picture p85: page 1]
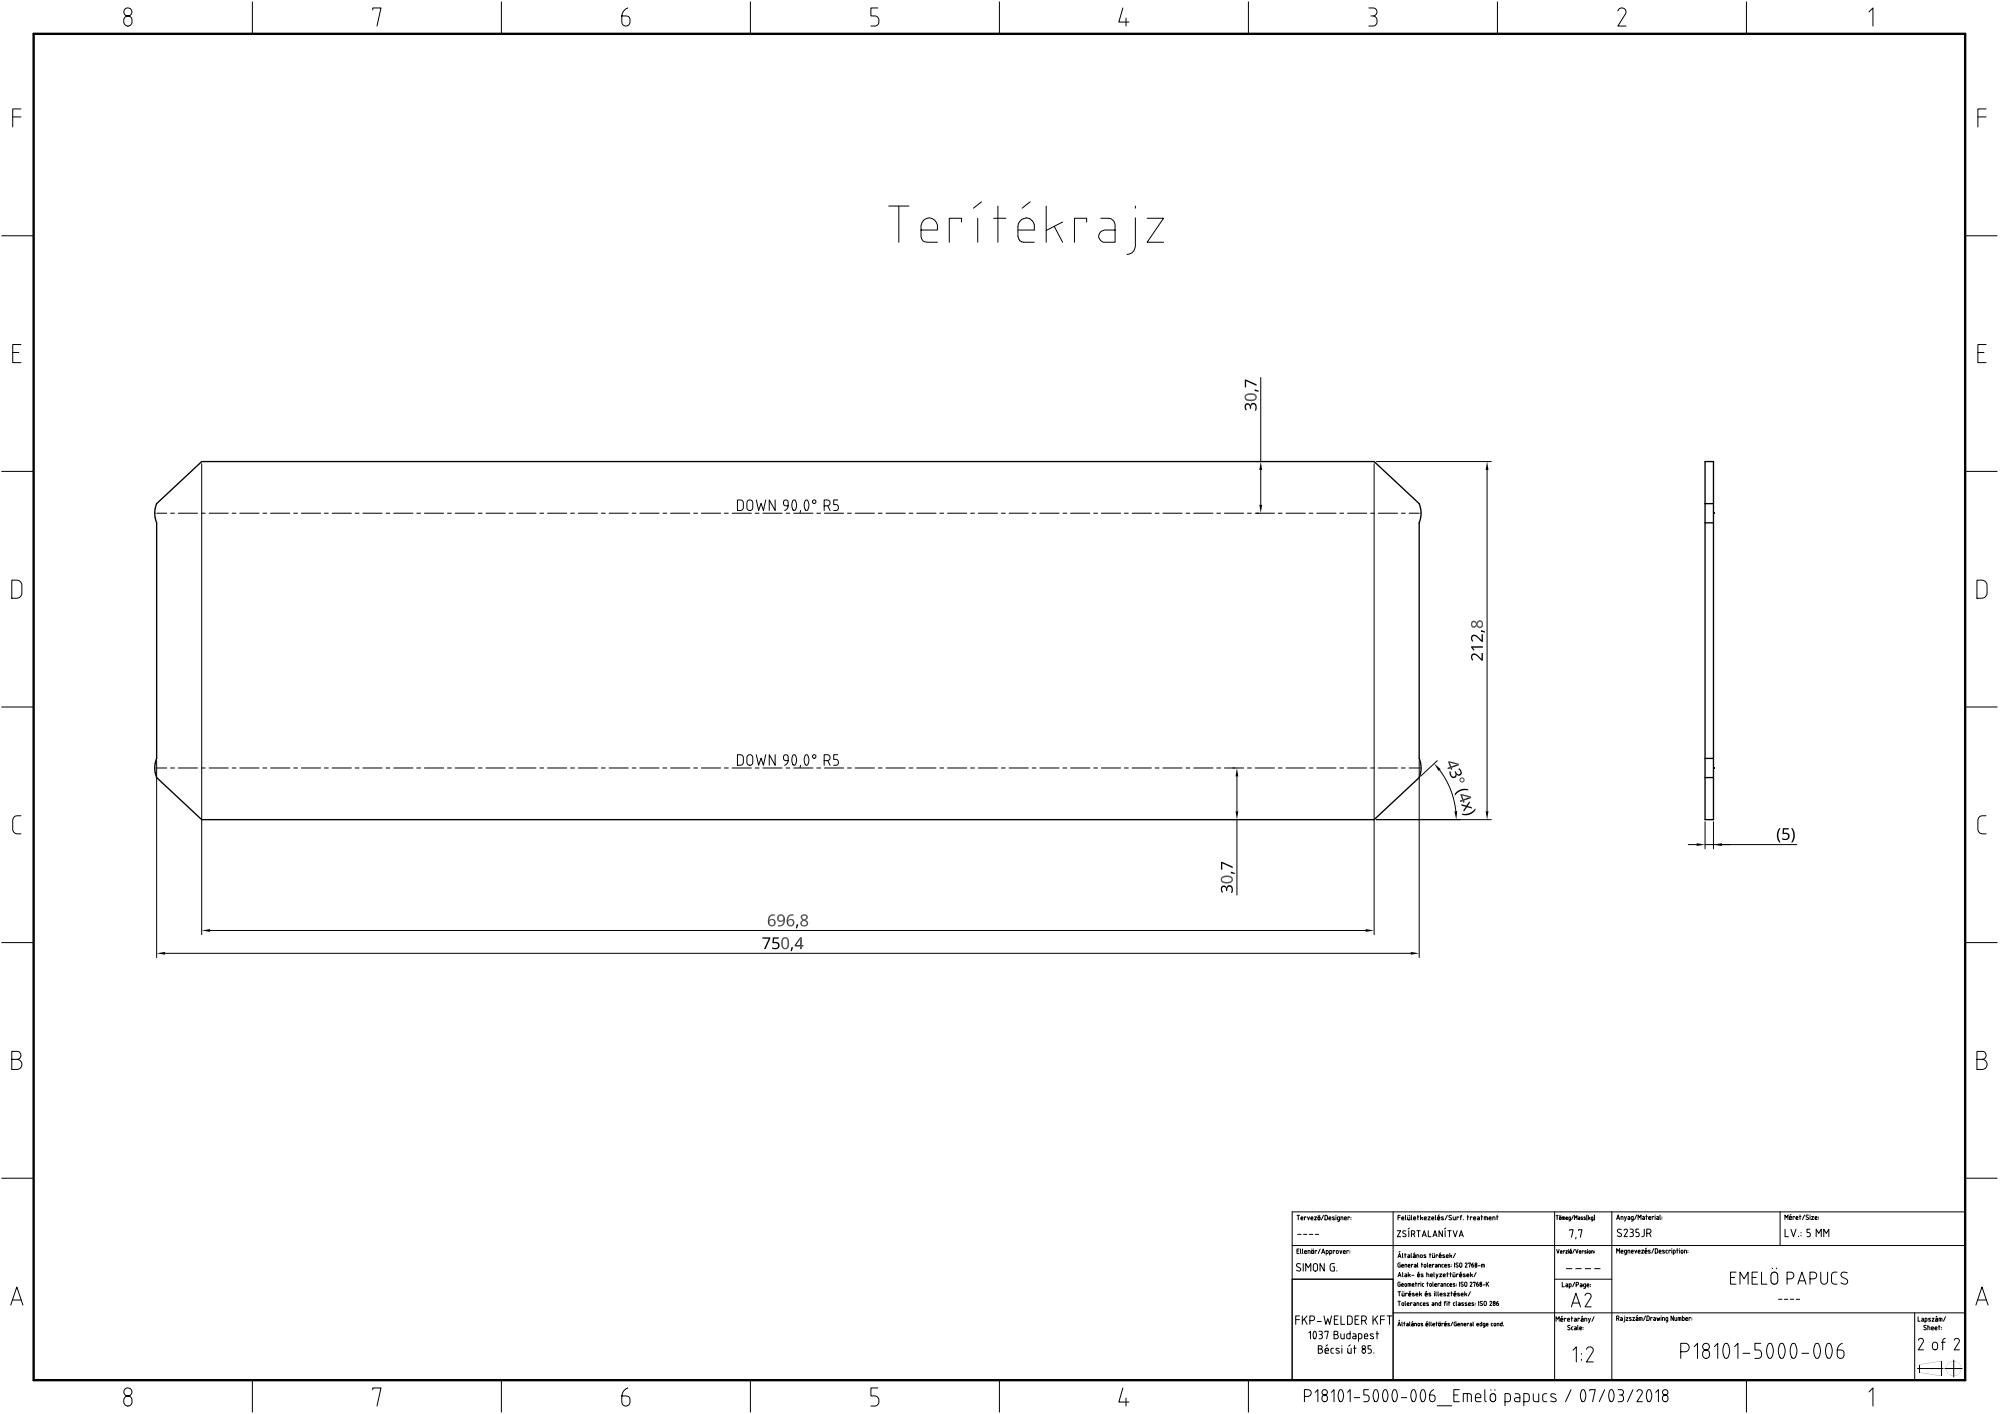
[picture p86: page 2]
