coderlazar/Metta-Pet/Tervrajzok/elhajlított alkatrészek/P18101-5000-011_Ajtó tartó konzol.pdf

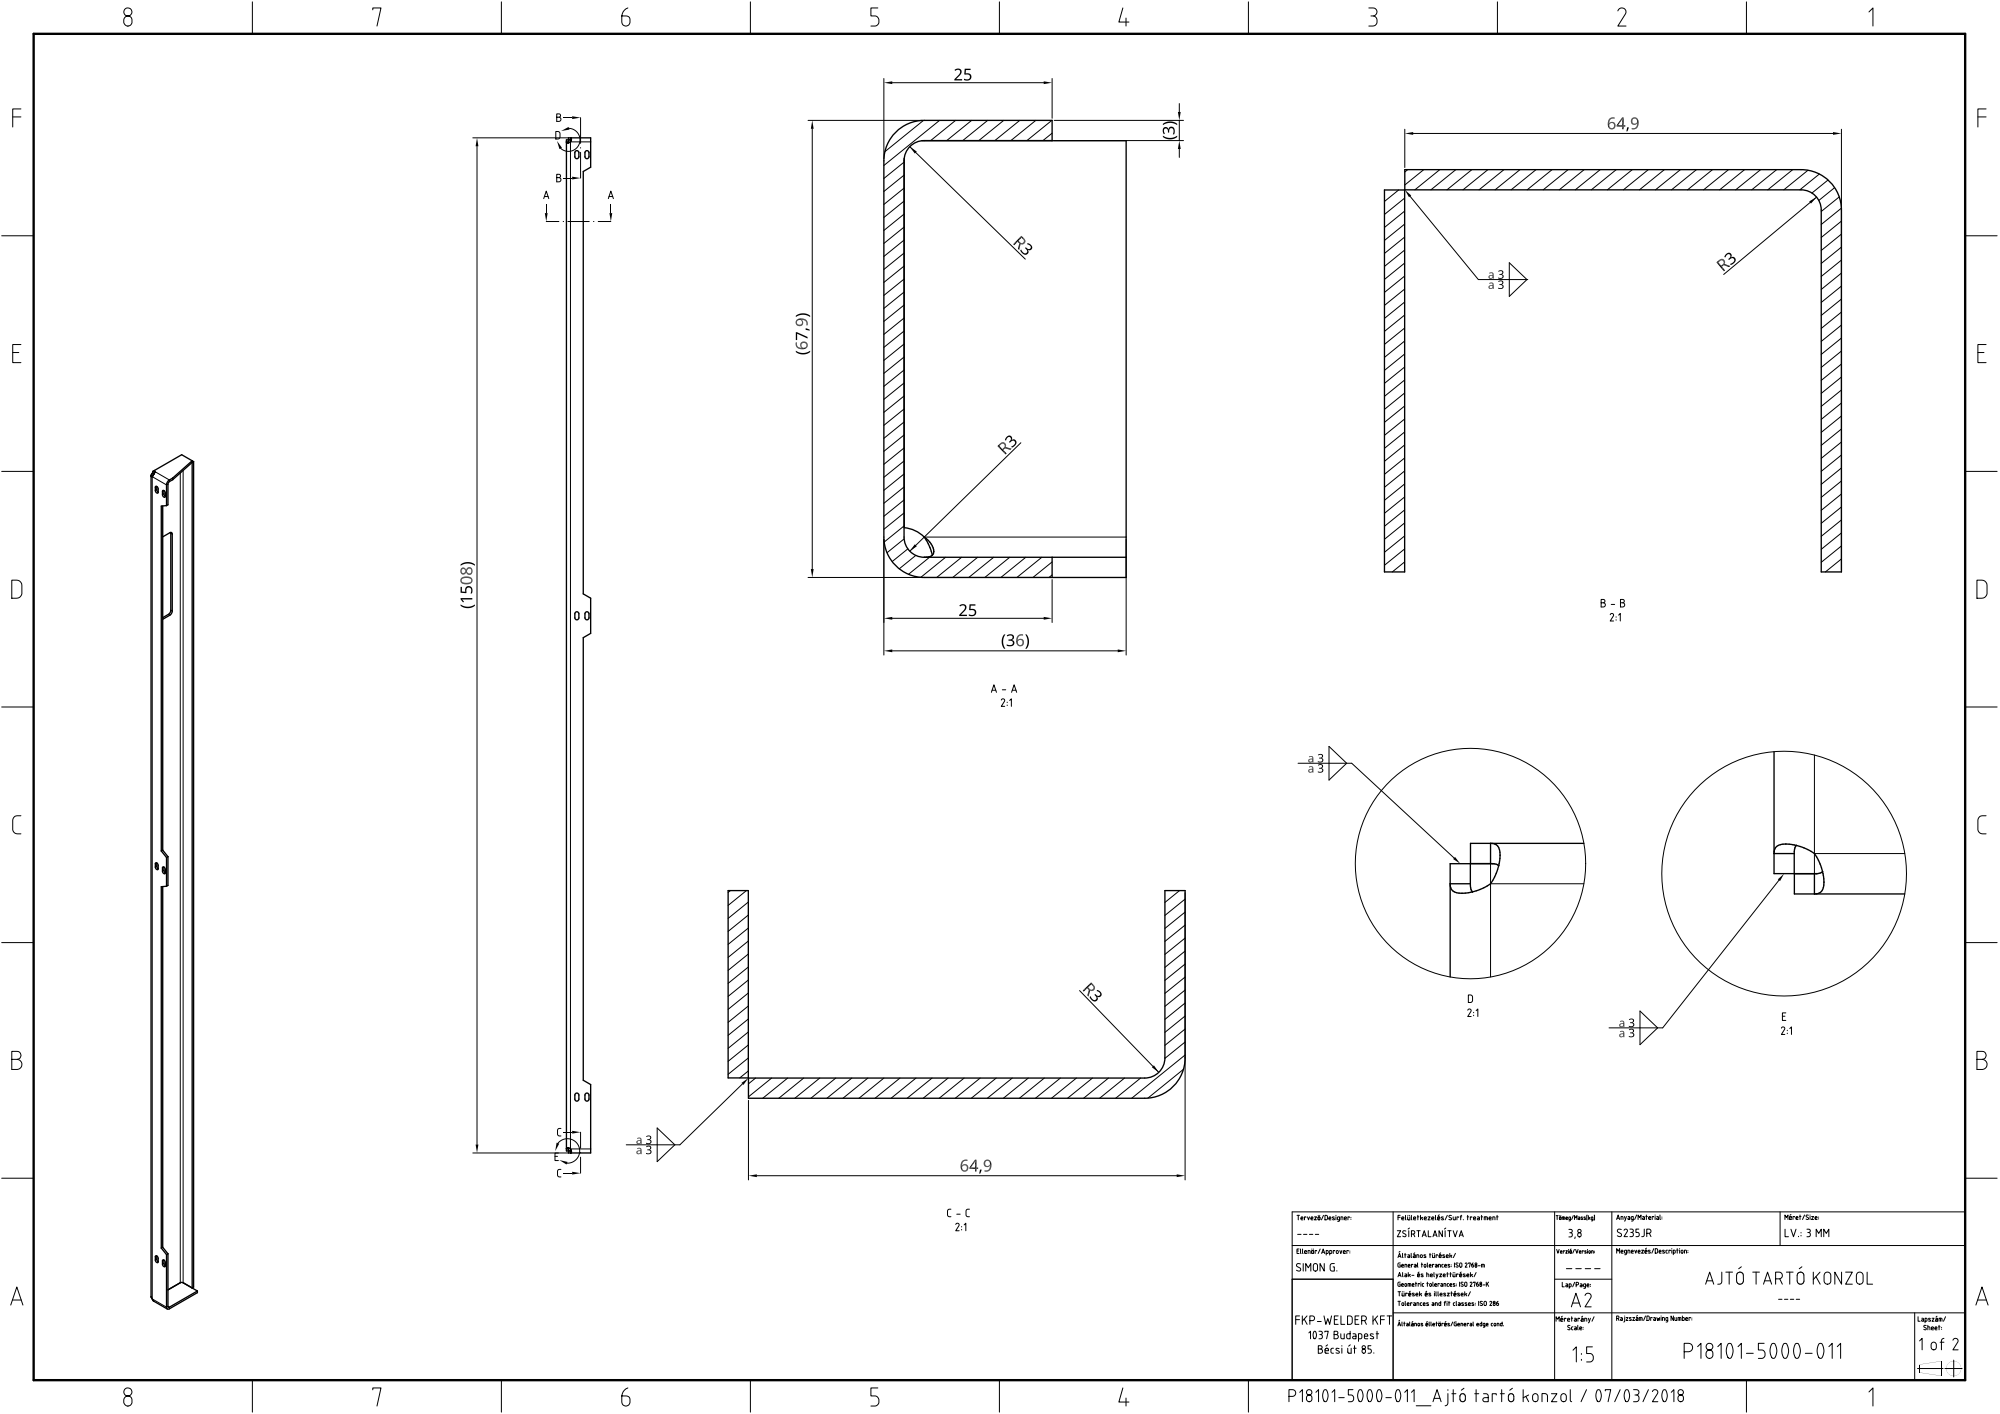
[picture p87: page 1]
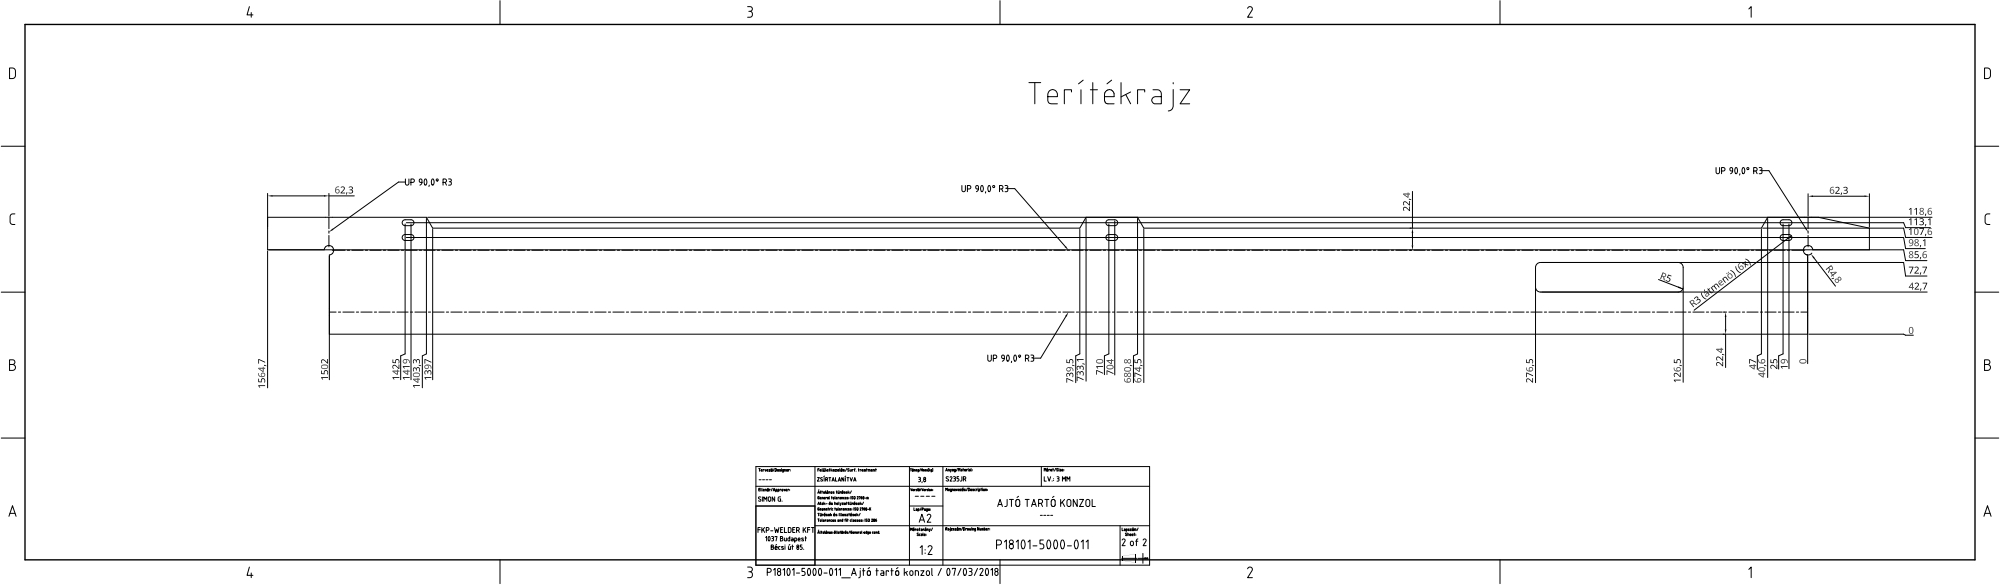
[picture p88: page 2]
