coderlazar/Metta-Pet/Tervrajzok/elhajlított alkatrészek/P18101-5000-012_Ledobás terelö szoknya.pdf

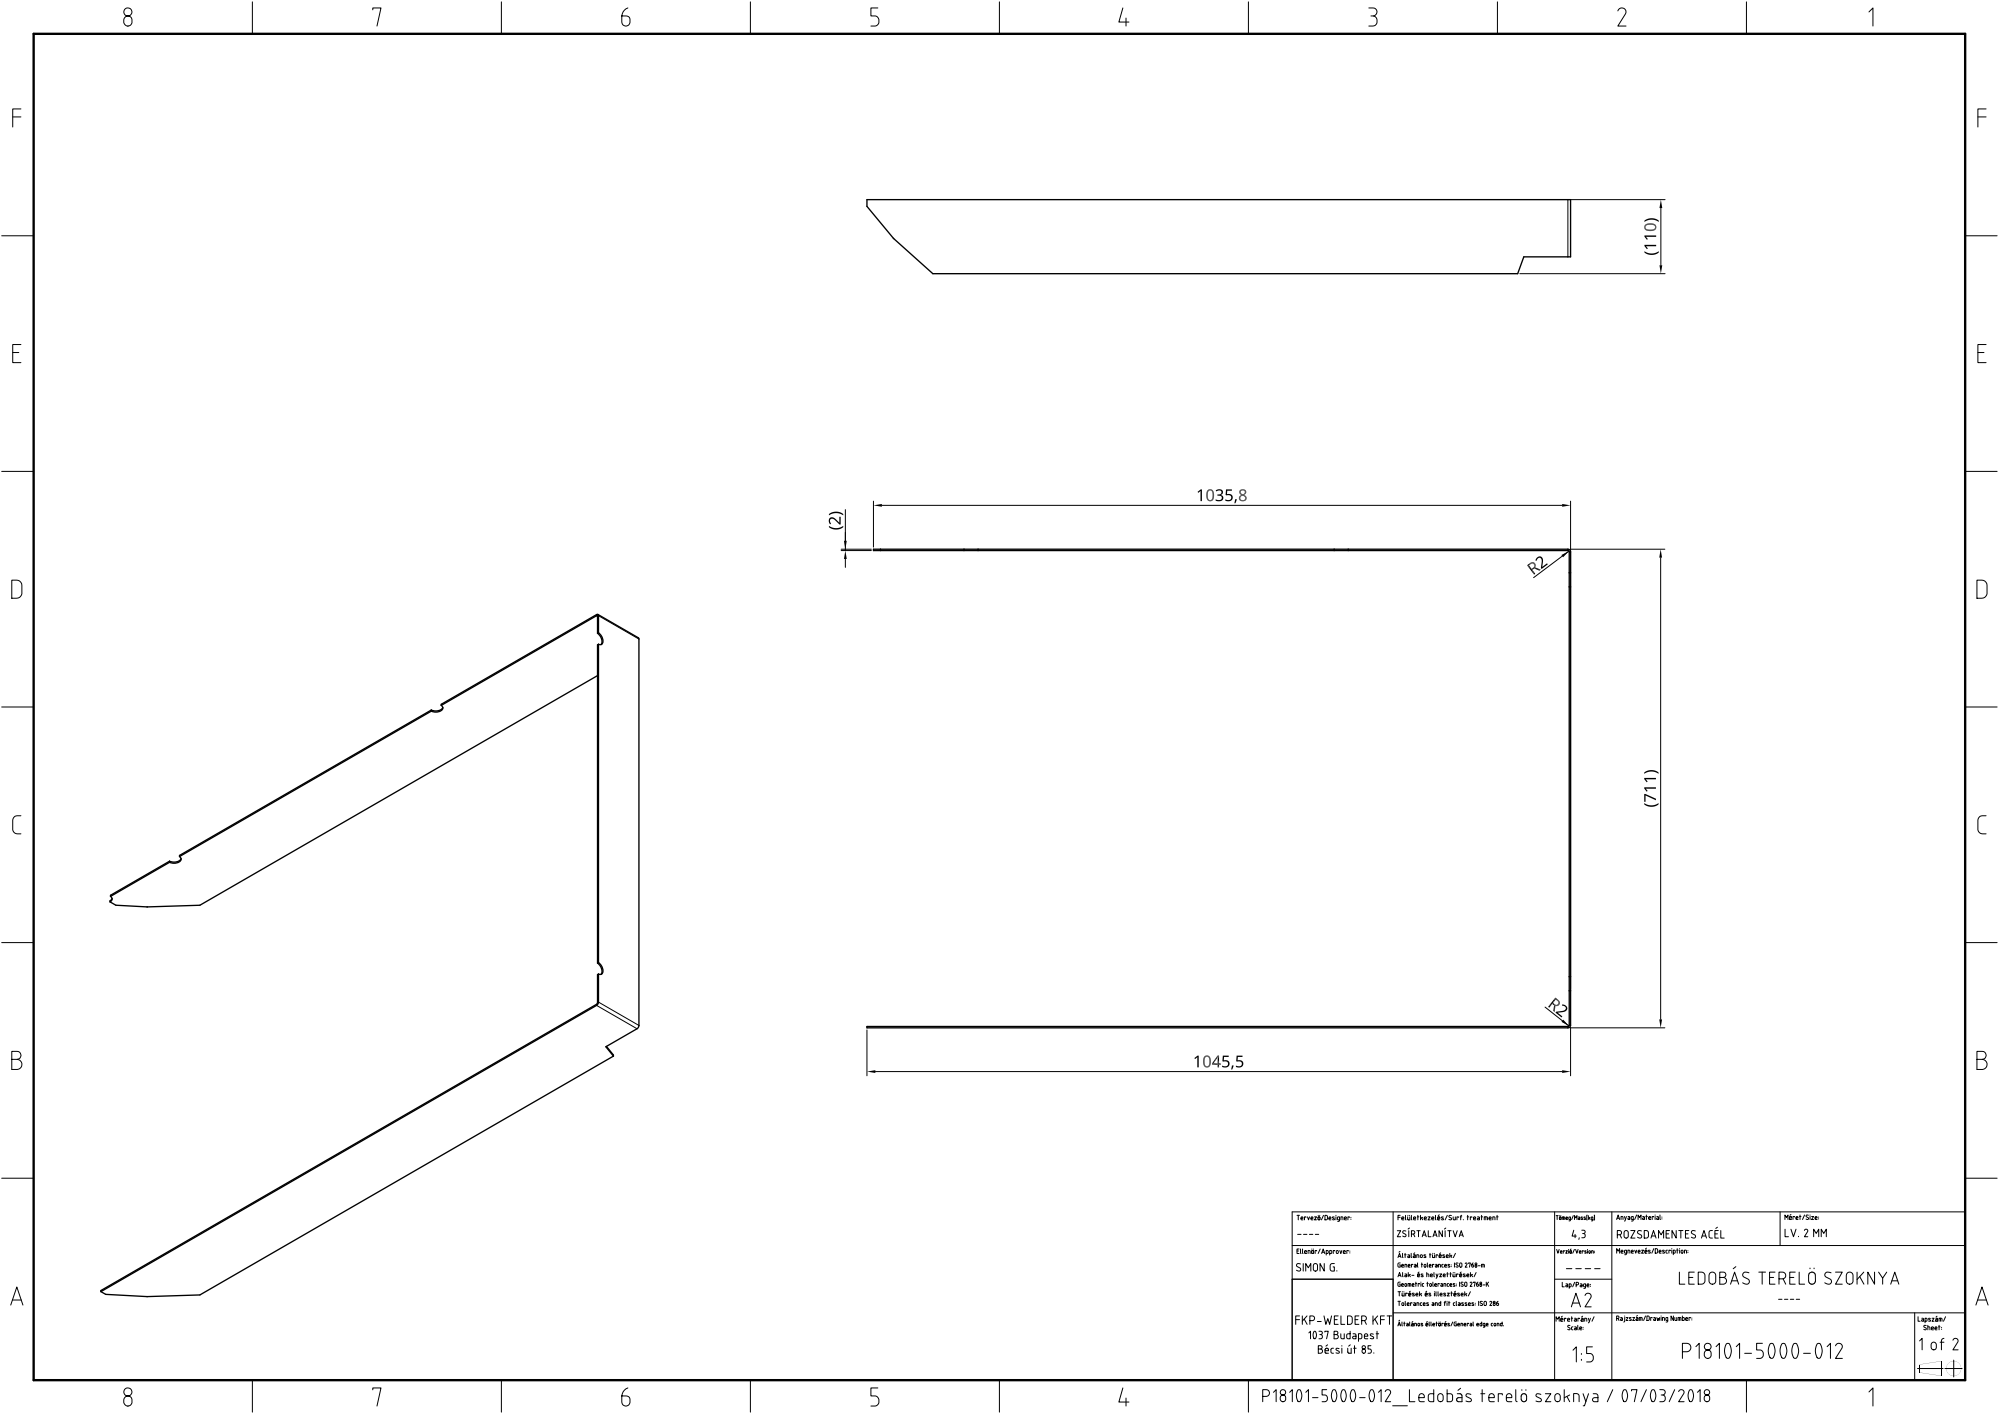
[picture p89: page 1]
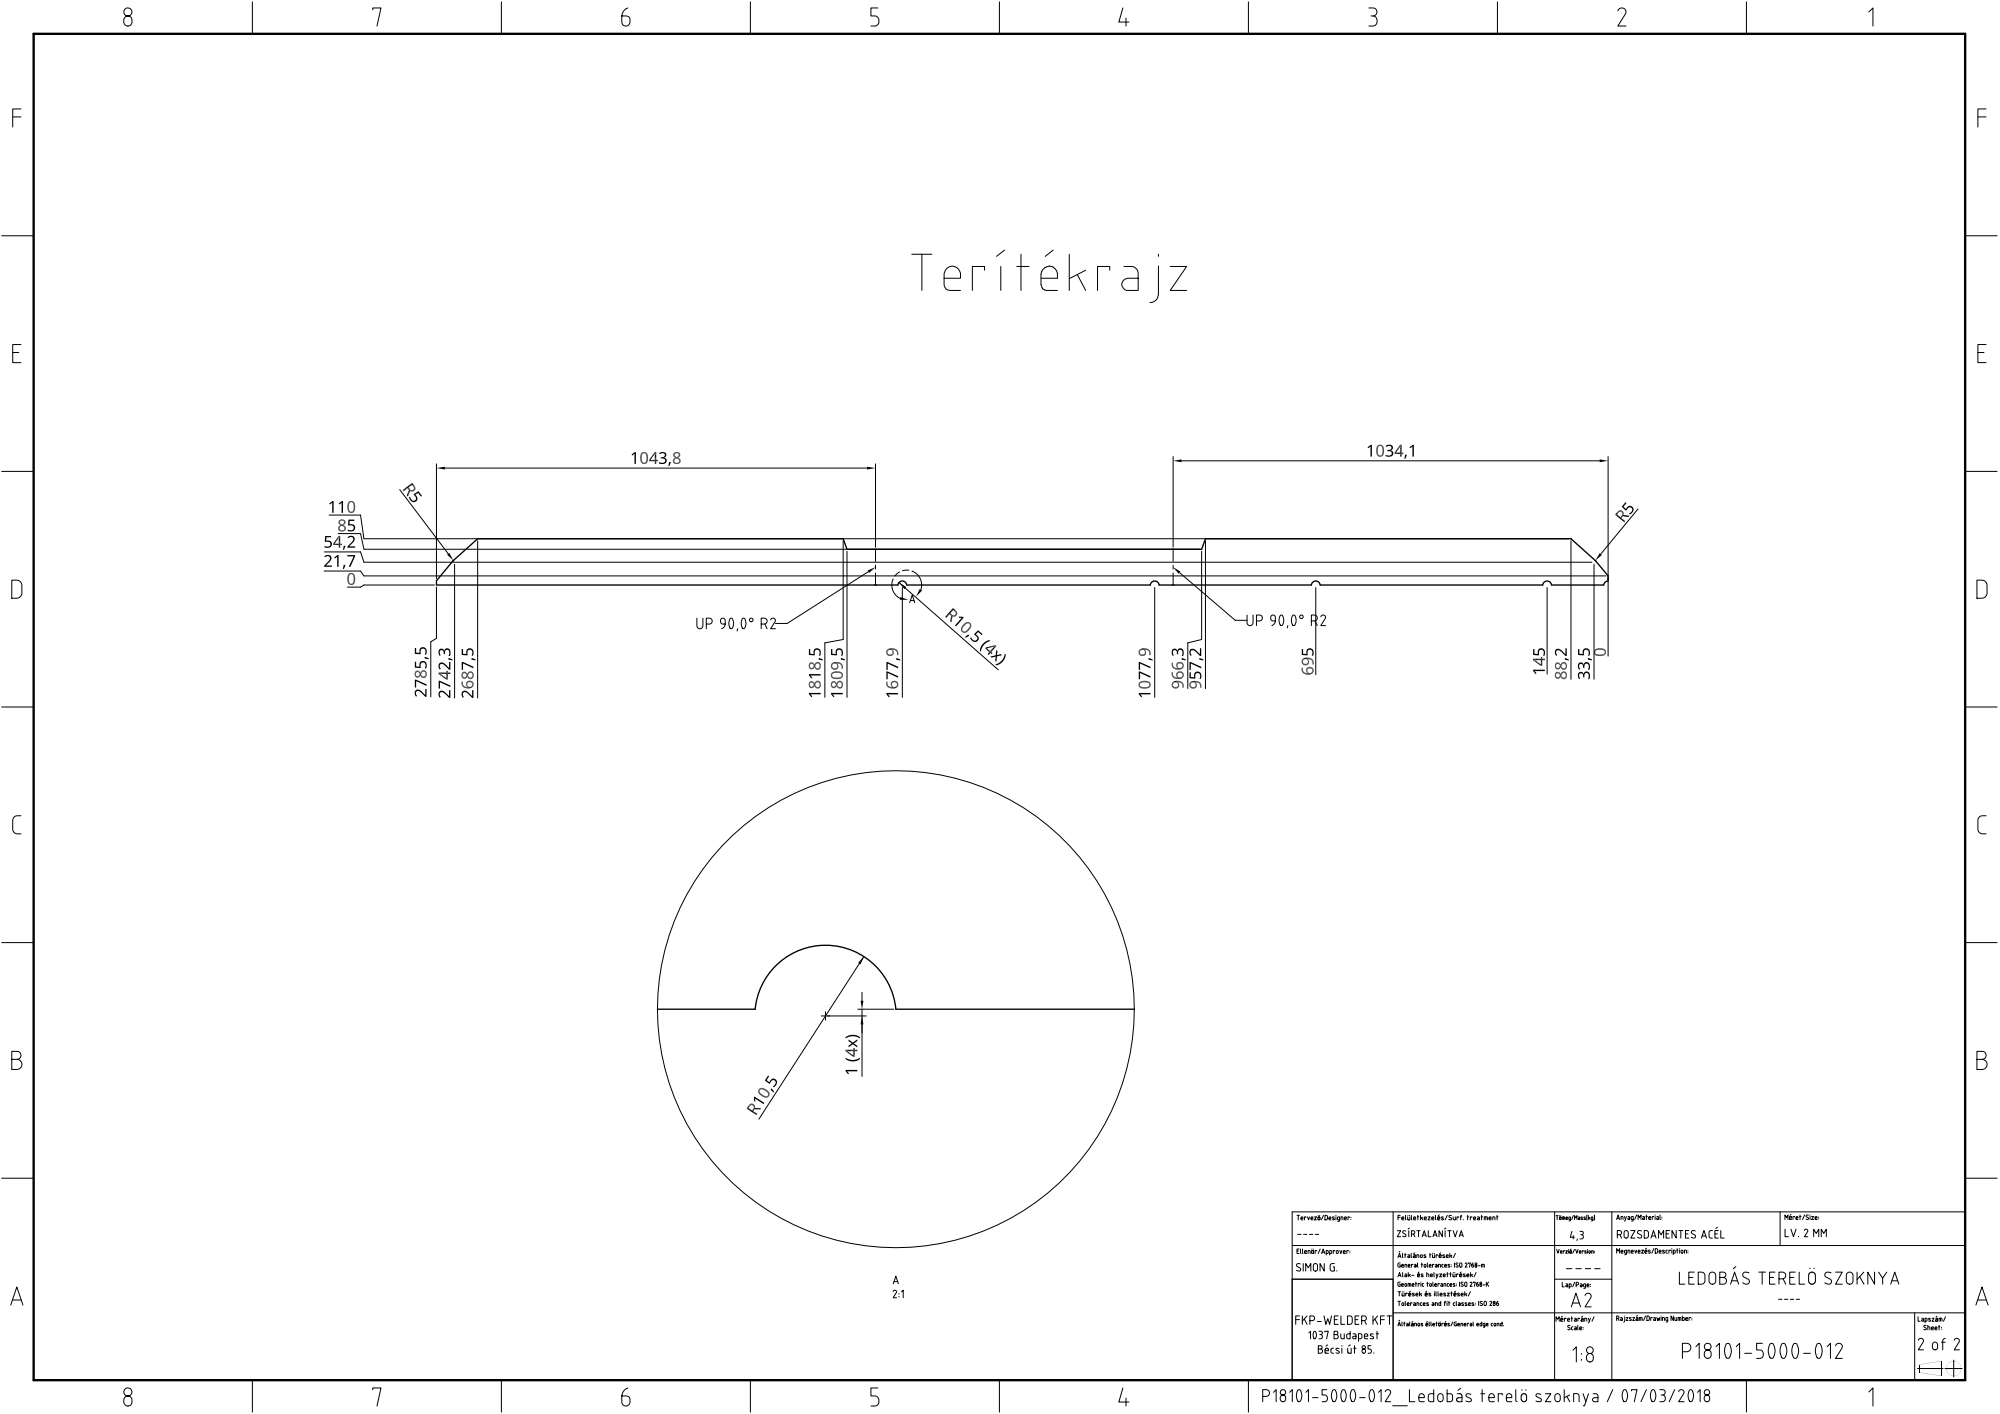
[picture p90: page 2]
