coderlazar/Metta-Pet/Tervrajzok/elhajlított alkatrészek/P18101-5000-014_Aktuátor rögzítö konzol.pdf

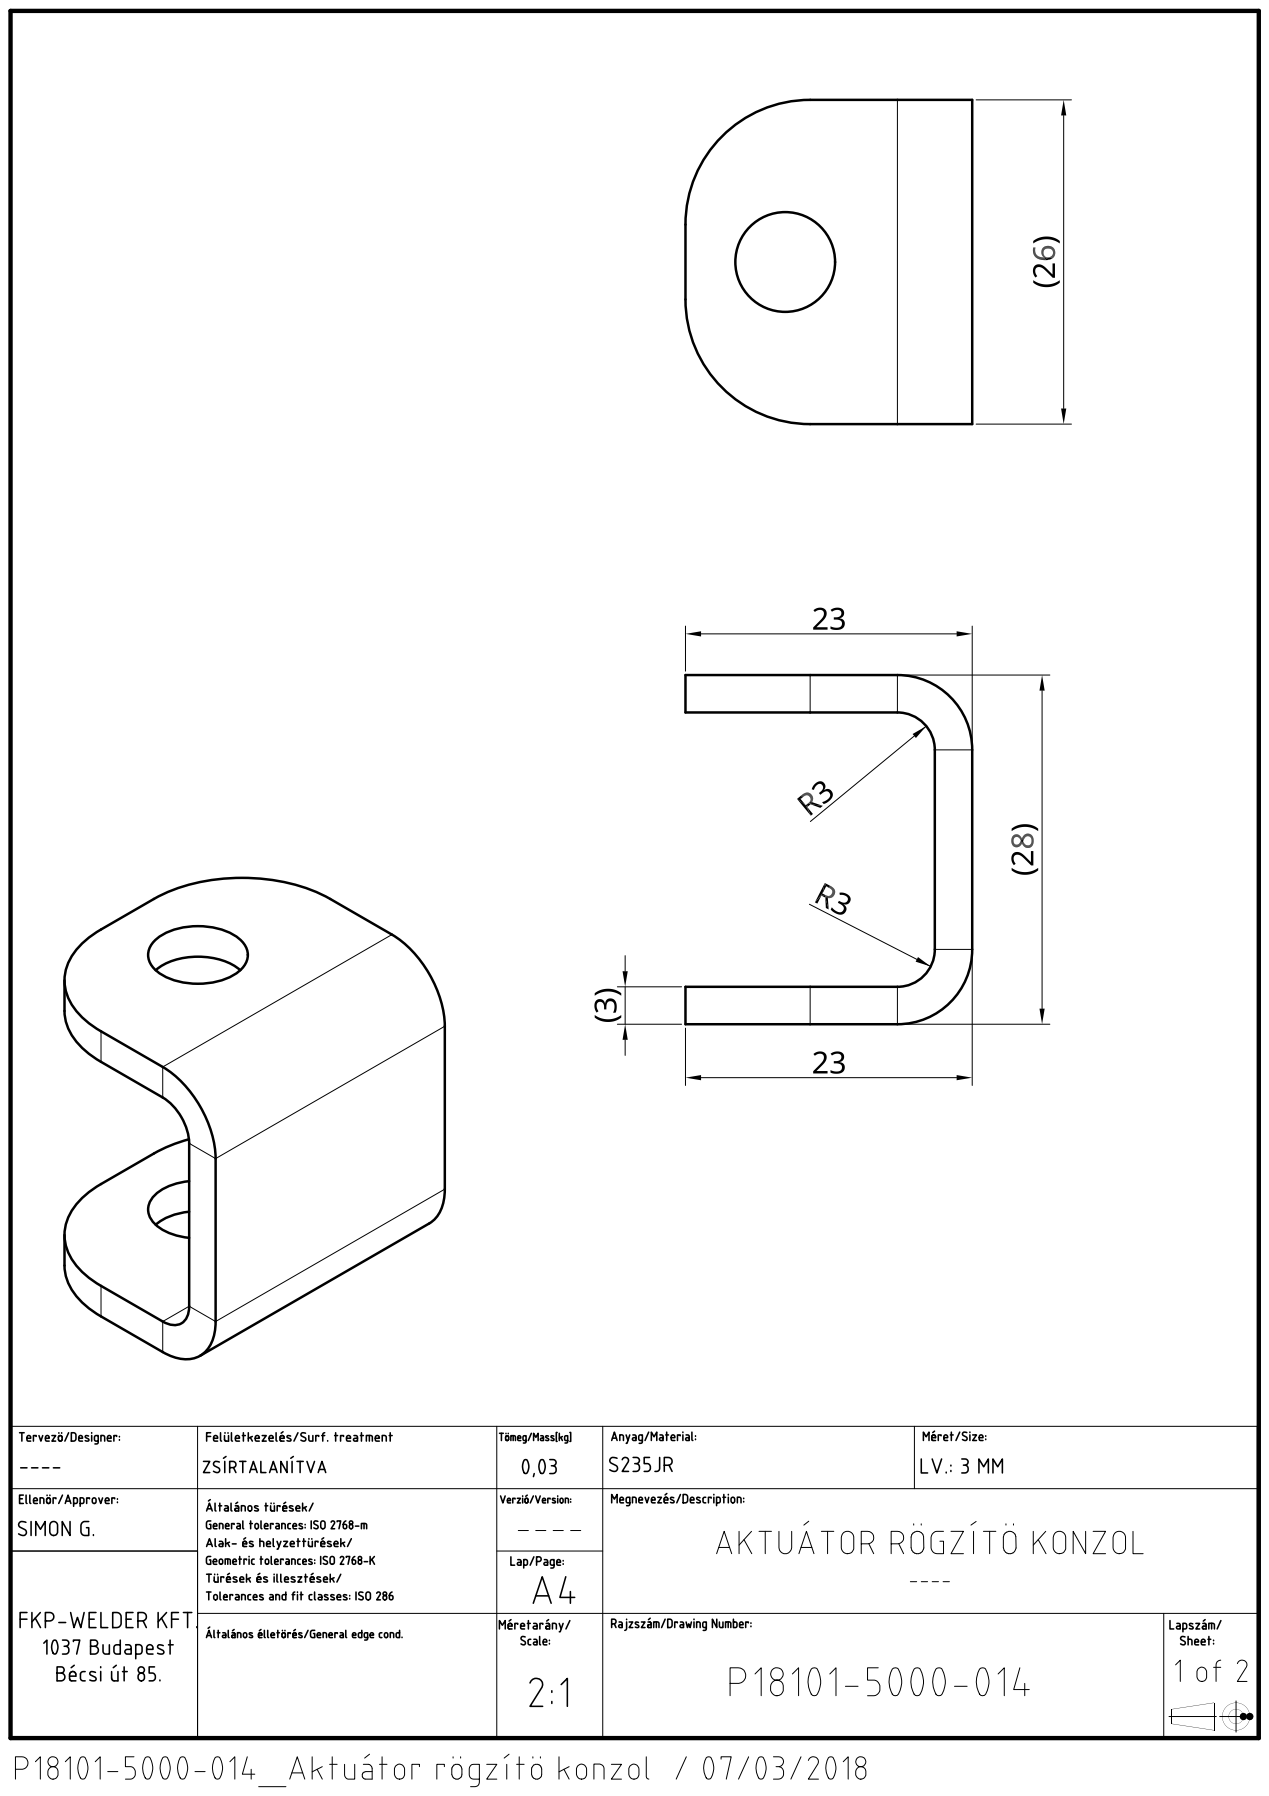
[picture p91: page 1]
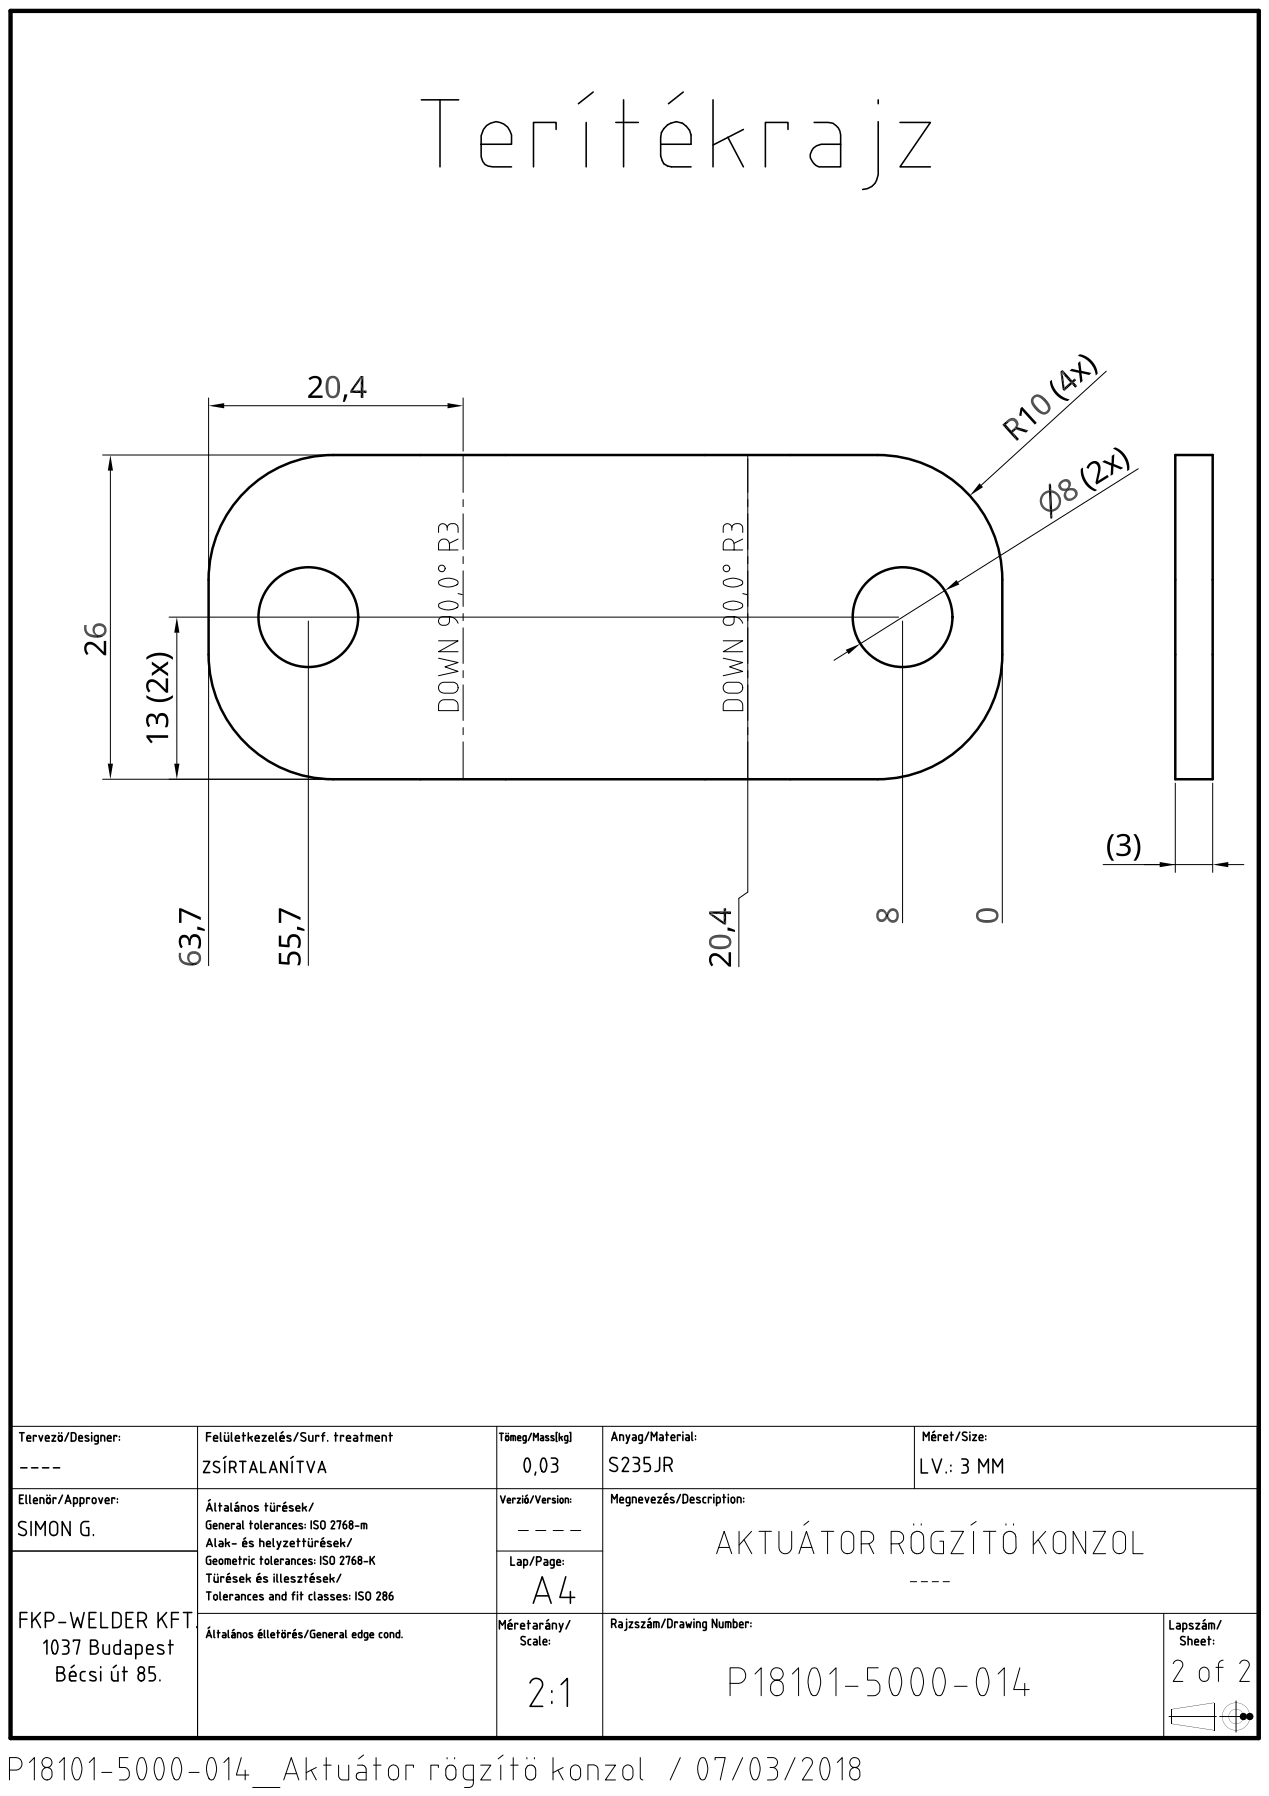
[picture p92: page 2]
