coderlazar/Metta-Pet/Tervrajzok/forgácsolt alkatrészek/P18101-5000-005_Láb persely M16.pdf

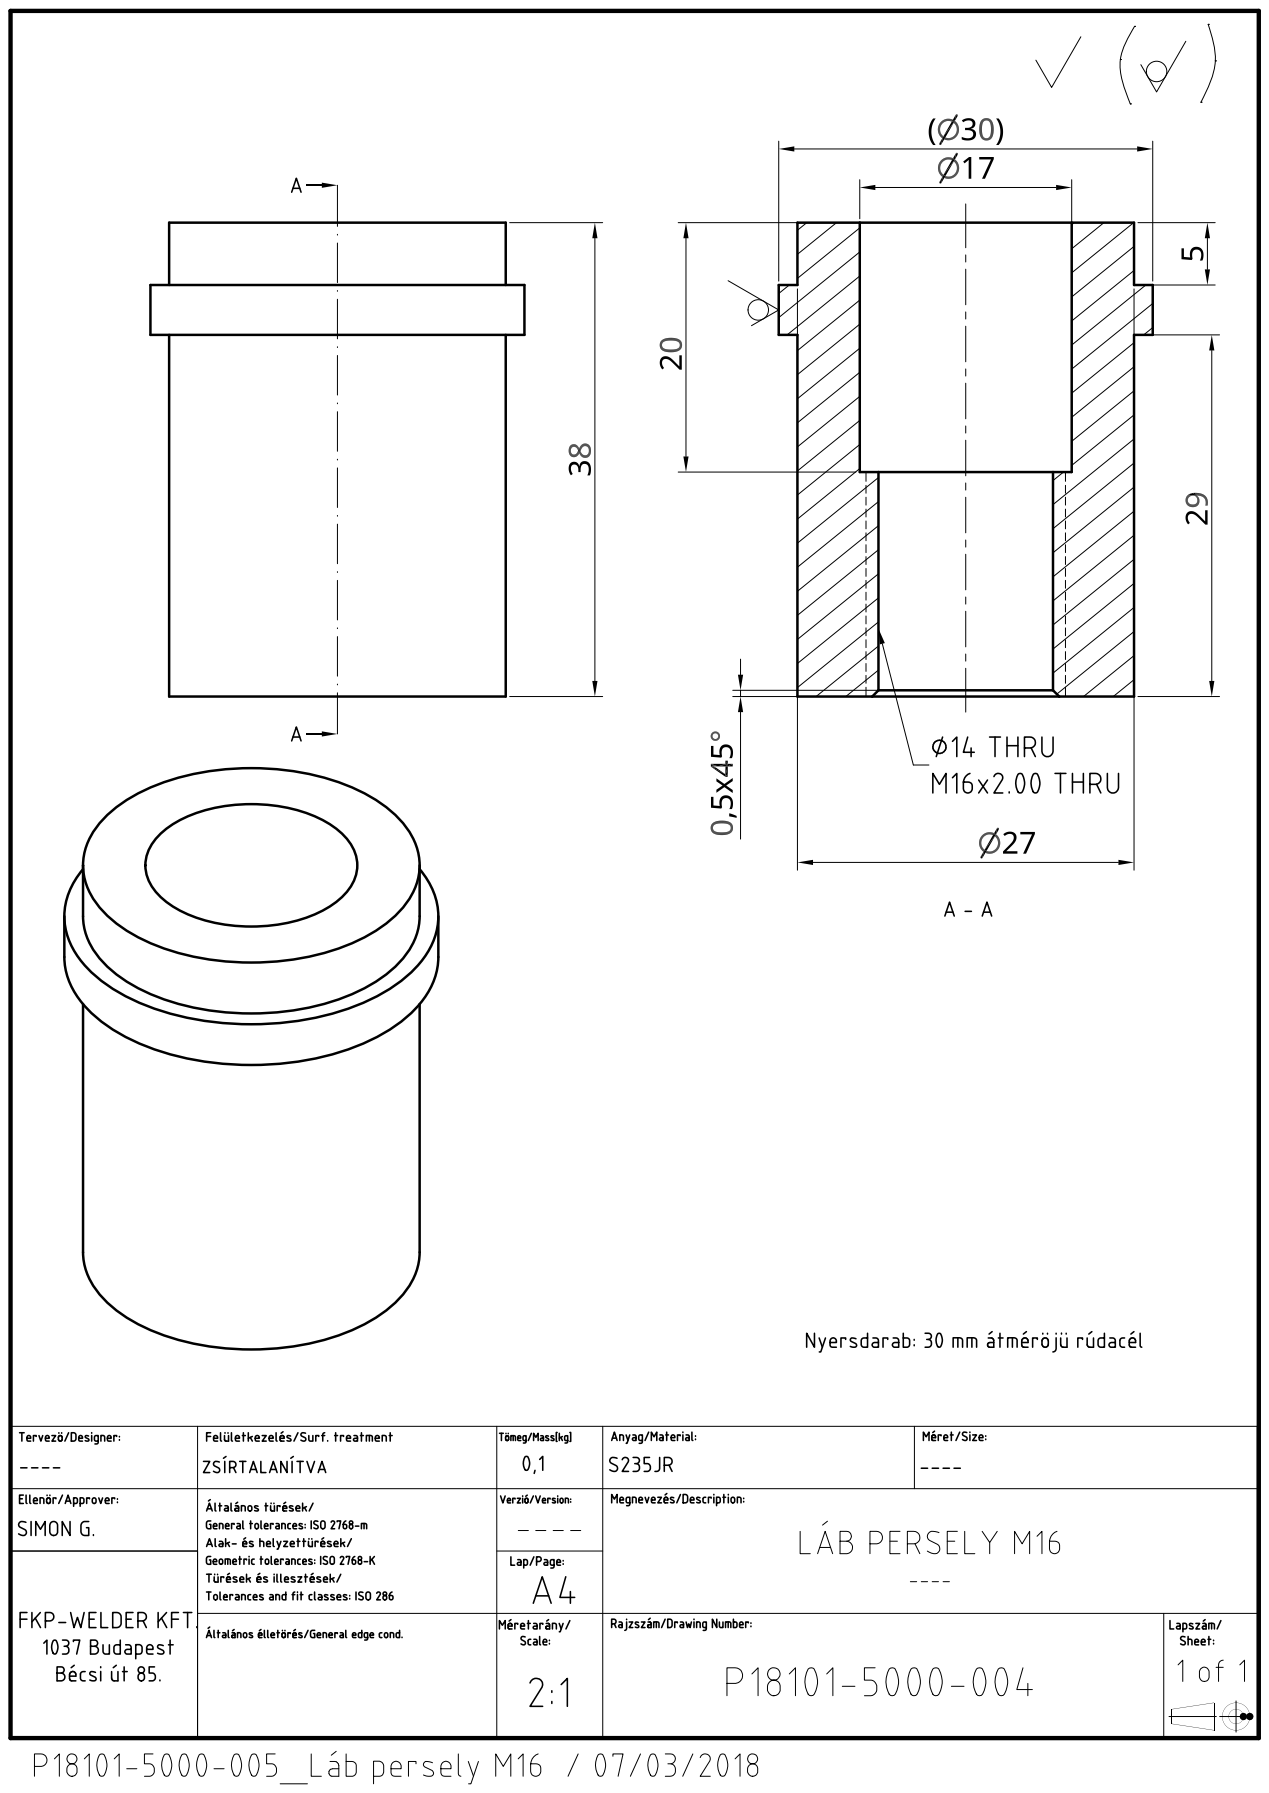
[picture p93: page 1]
