coderlazar/Metta-Pet/Tervrajzok/forgácsolt alkatrészek/P18101-5000-015_Ledobó kar rögzítö pont.pdf

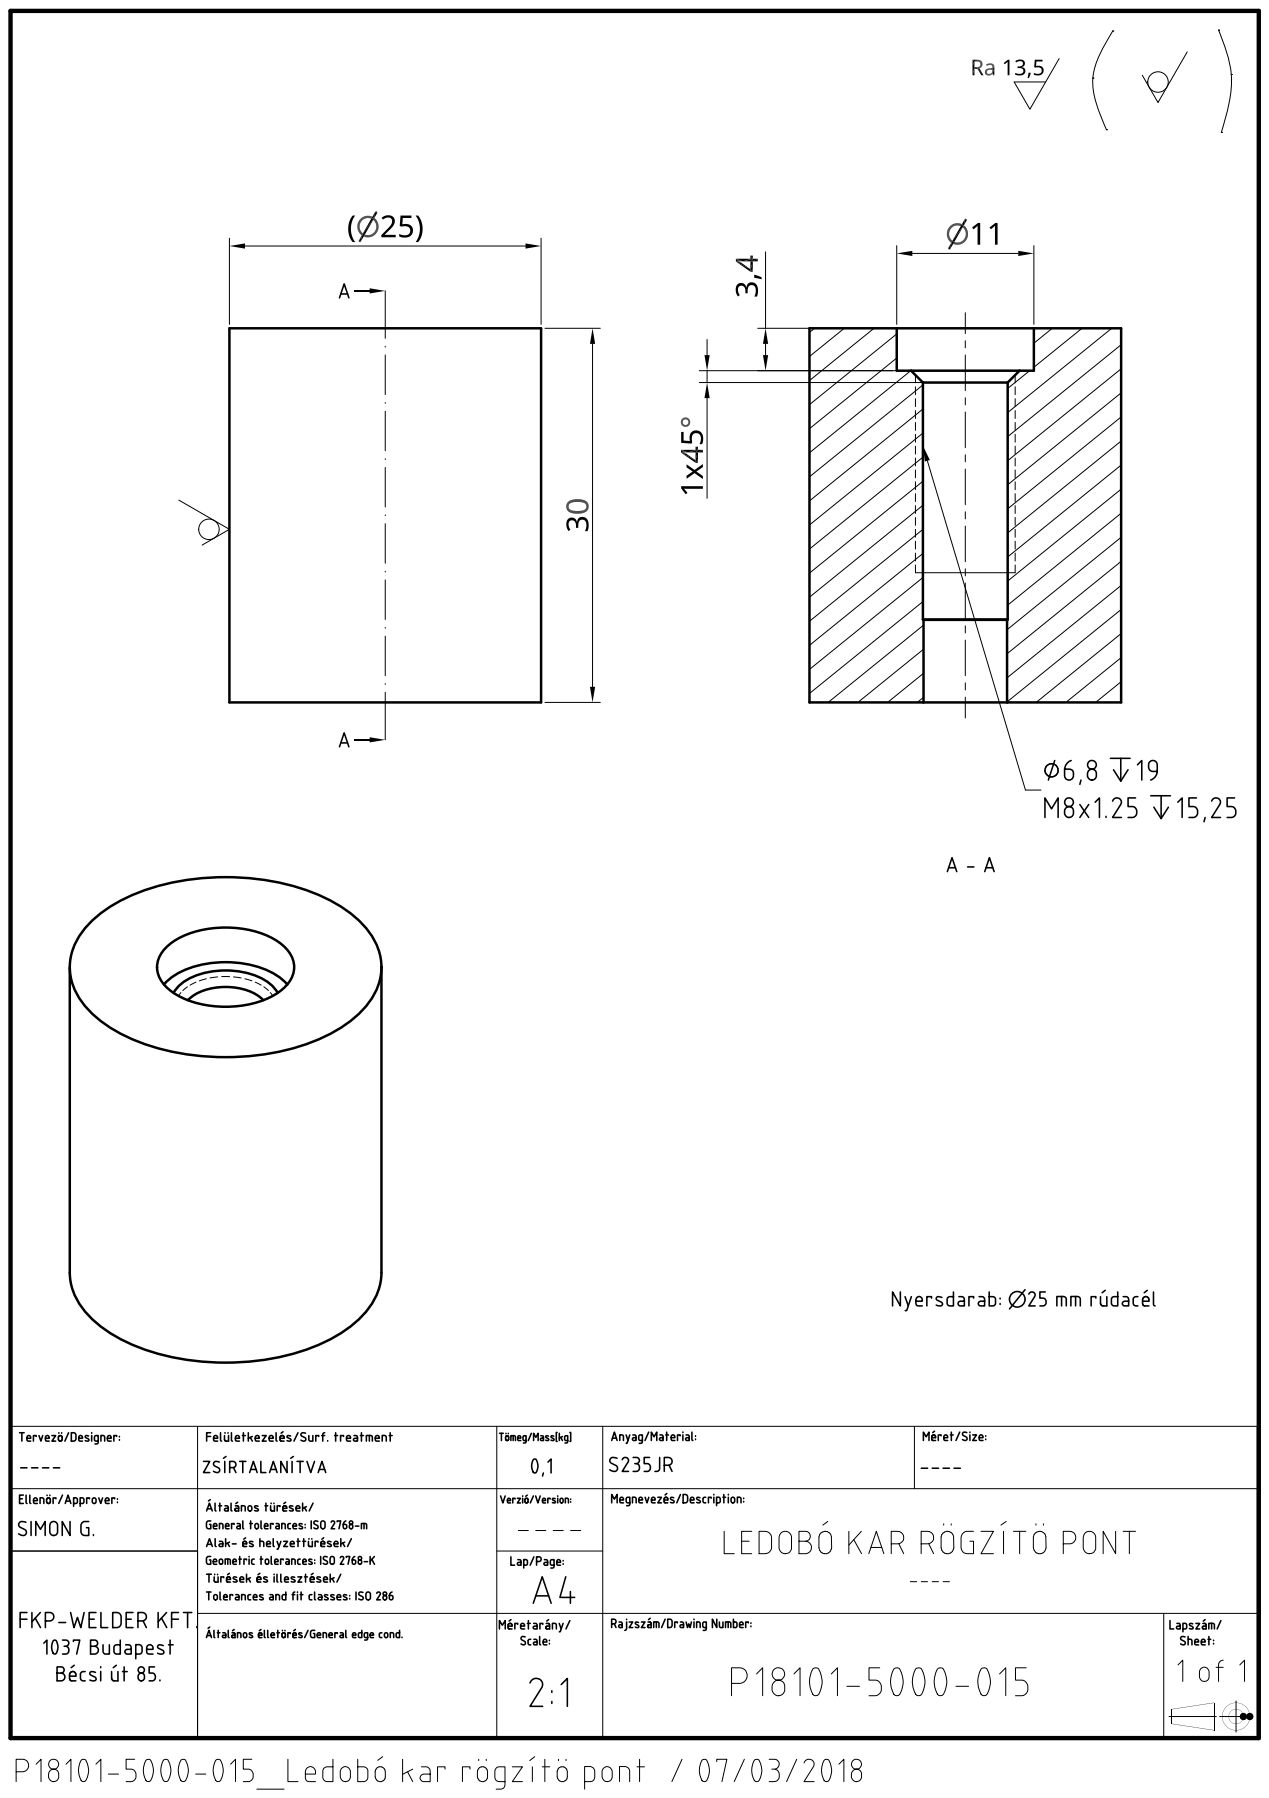
[picture p94: page 1]
