coderlazar/Metta-Pet/Tervrajzok/3000 - préselő egység/P18101-3000-000 préselőegység.pdf

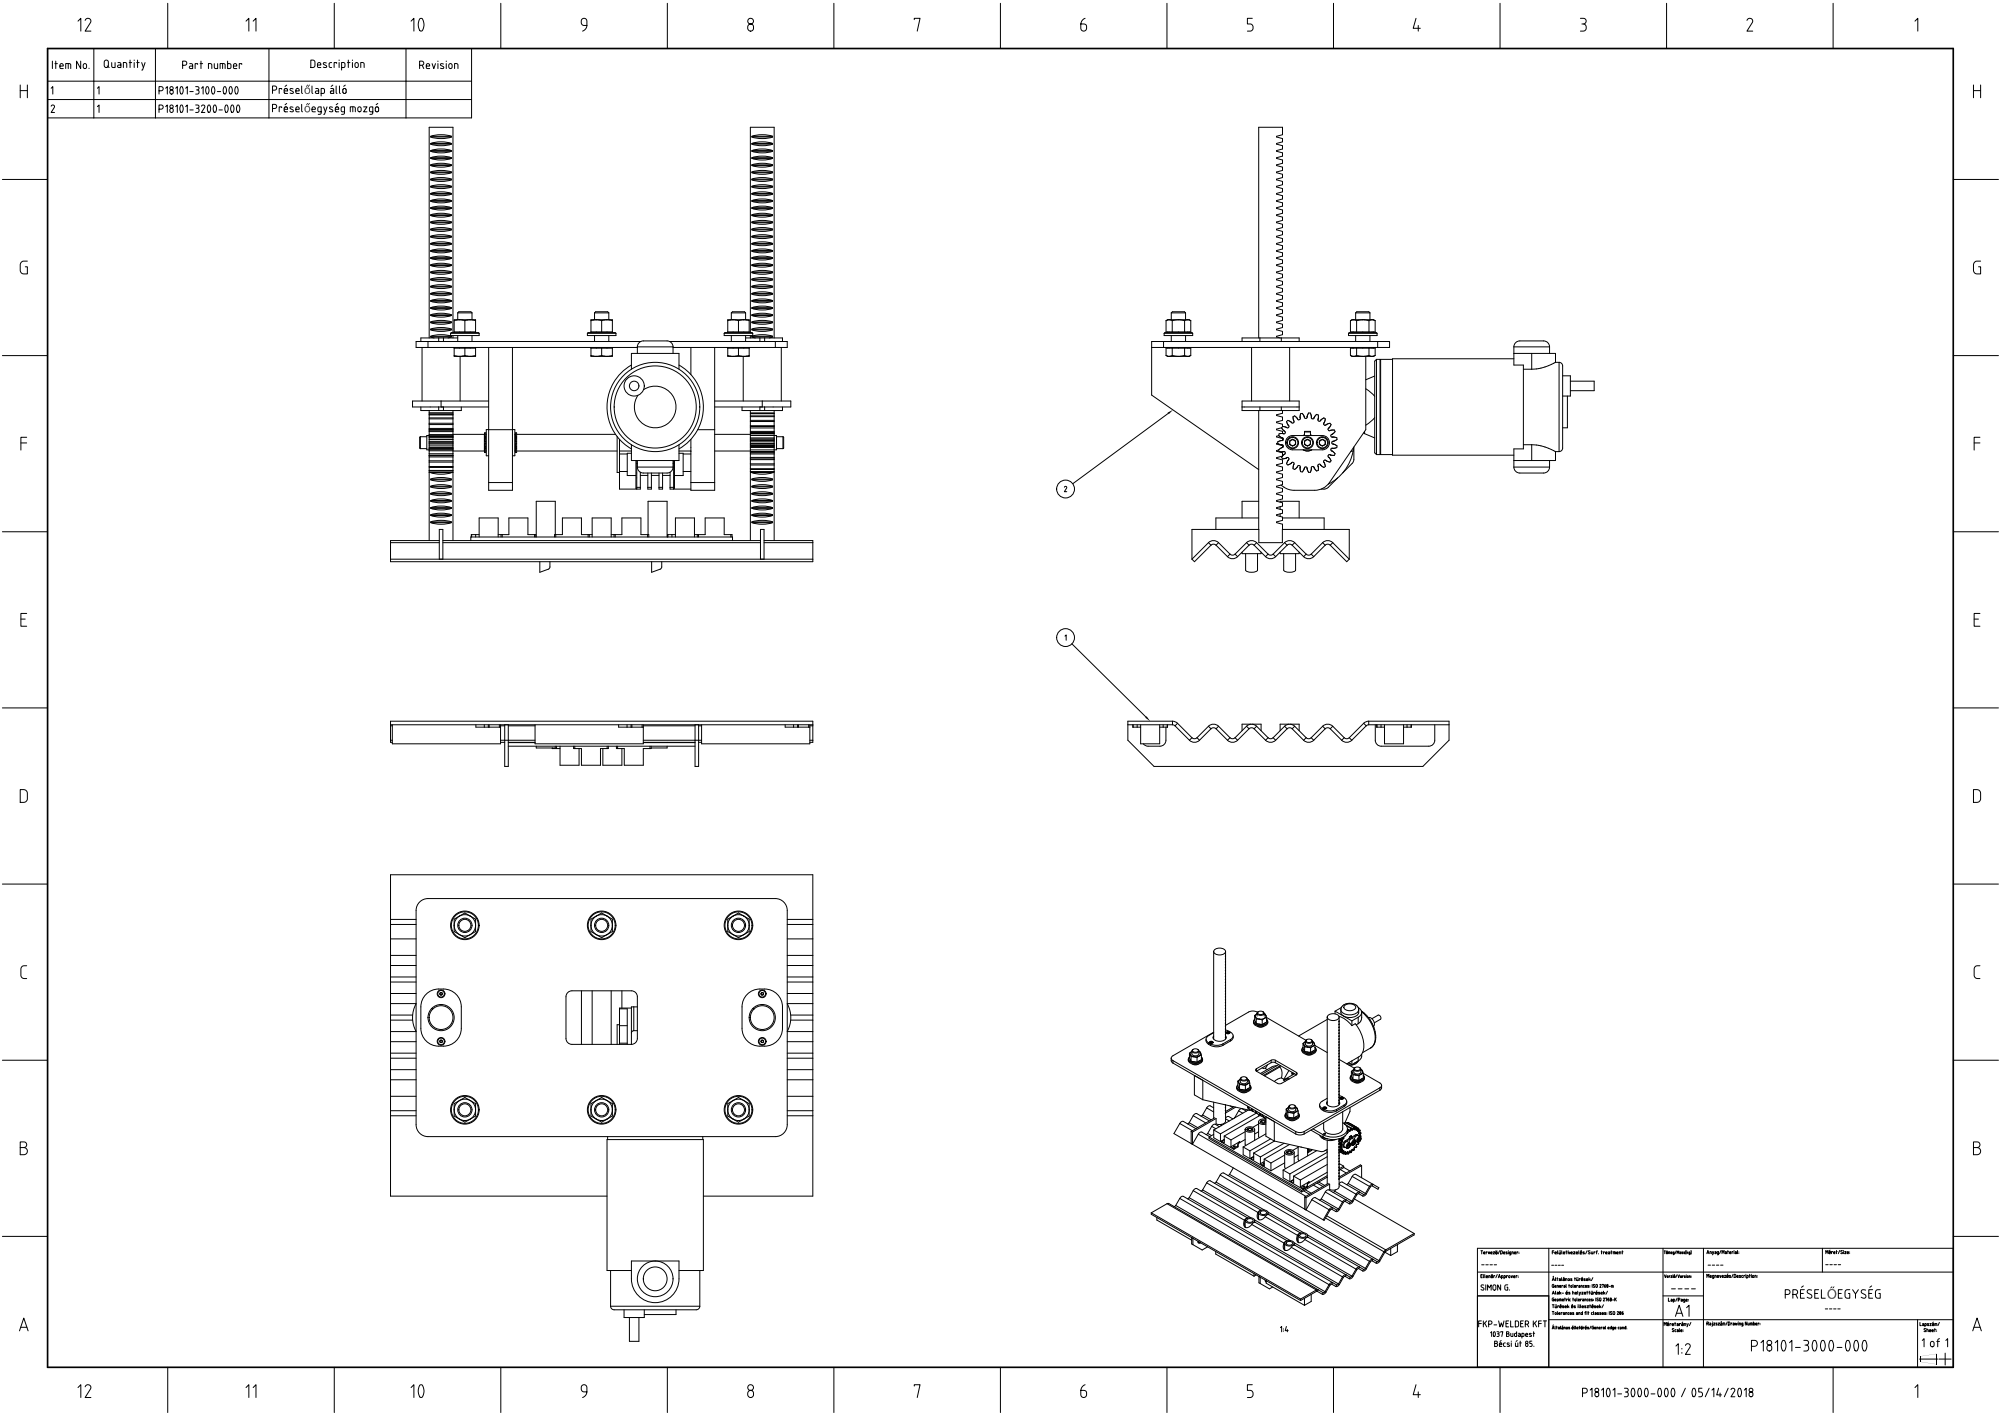
[picture p95: page 1]
