coderlazar/Metta-Pet/Tervrajzok/3000 - préselő egység/P18101-3000-030 konzol.pdf

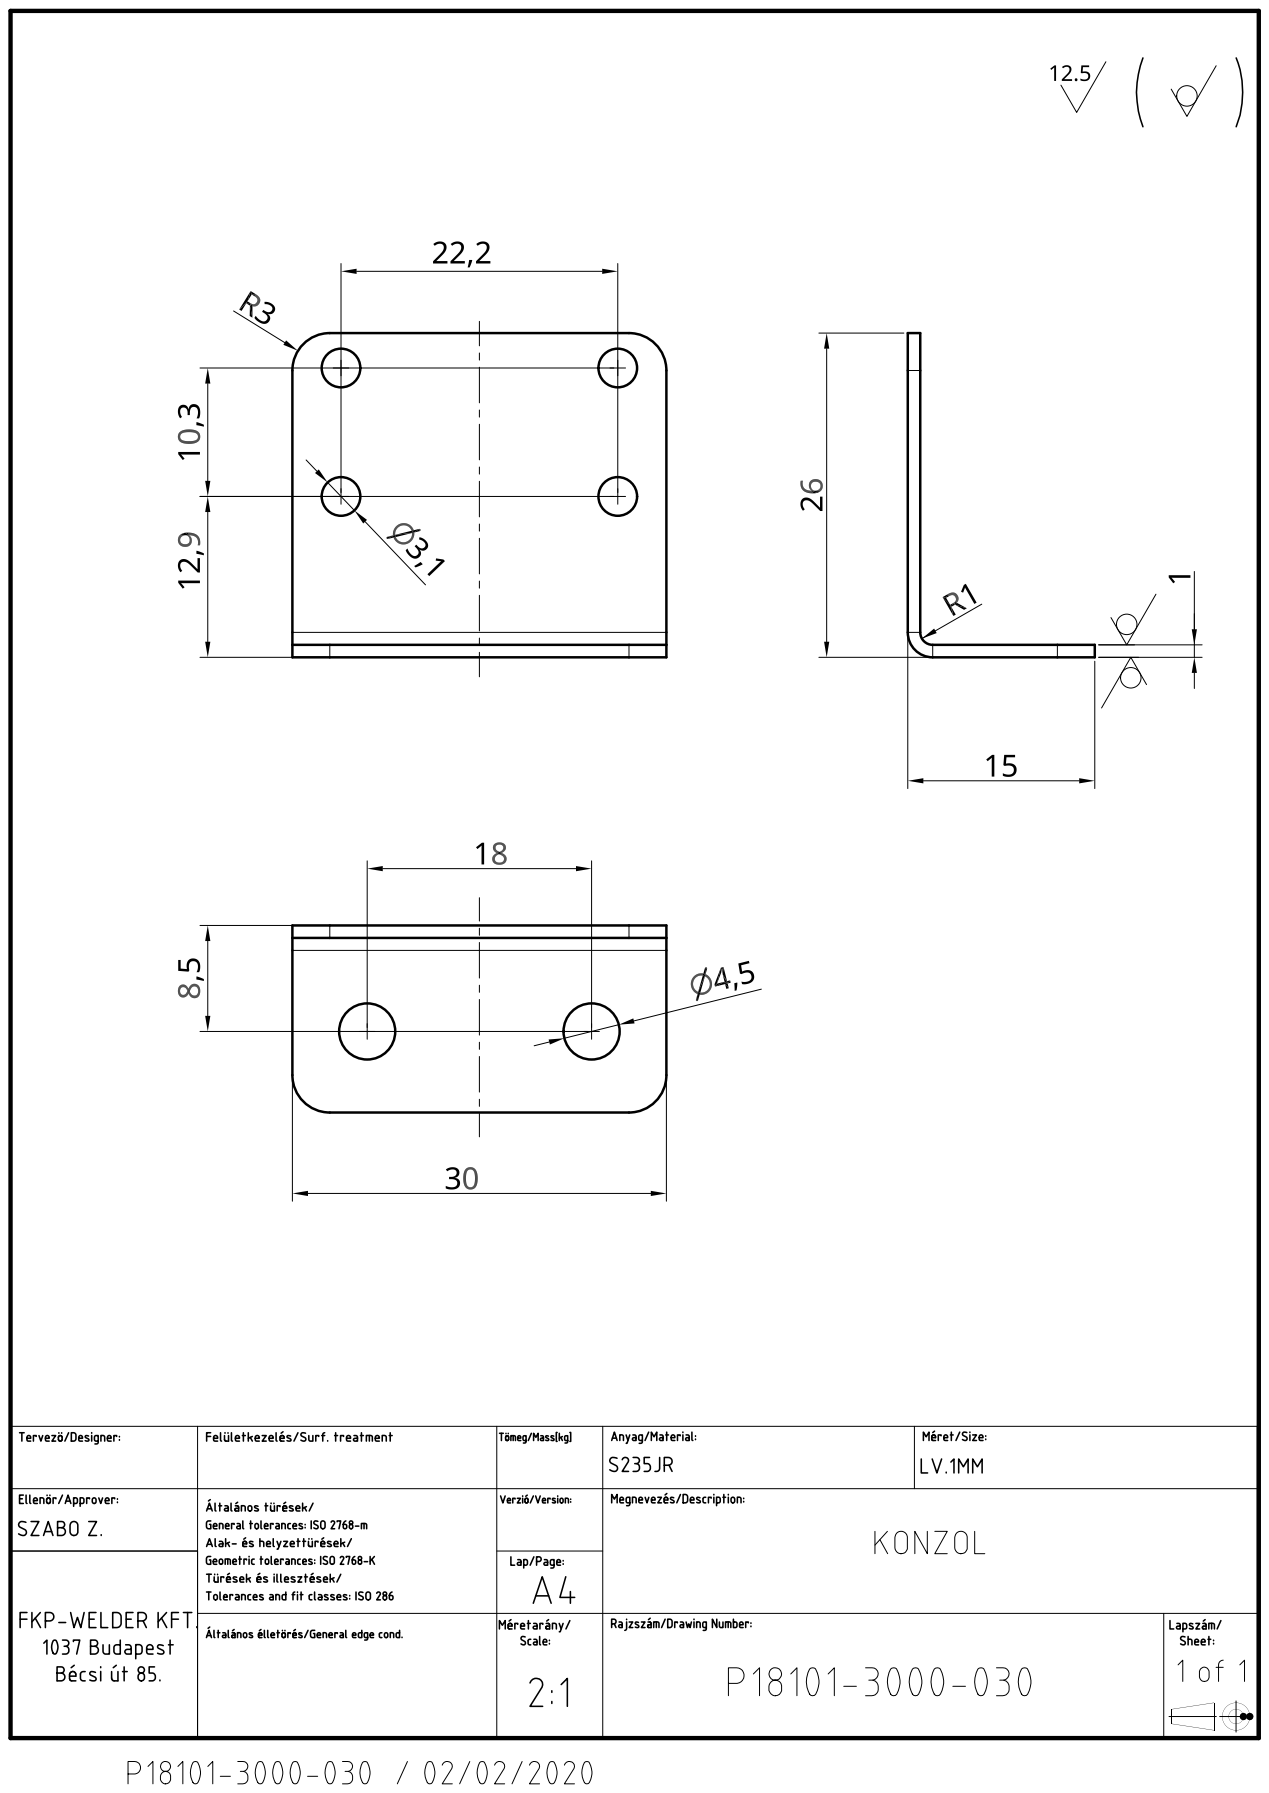
[picture p96: page 1]
