coderlazar/Metta-Pet/Tervrajzok/3000 - préselő egység/P18101-3100-000 préselőlap álló.pdf

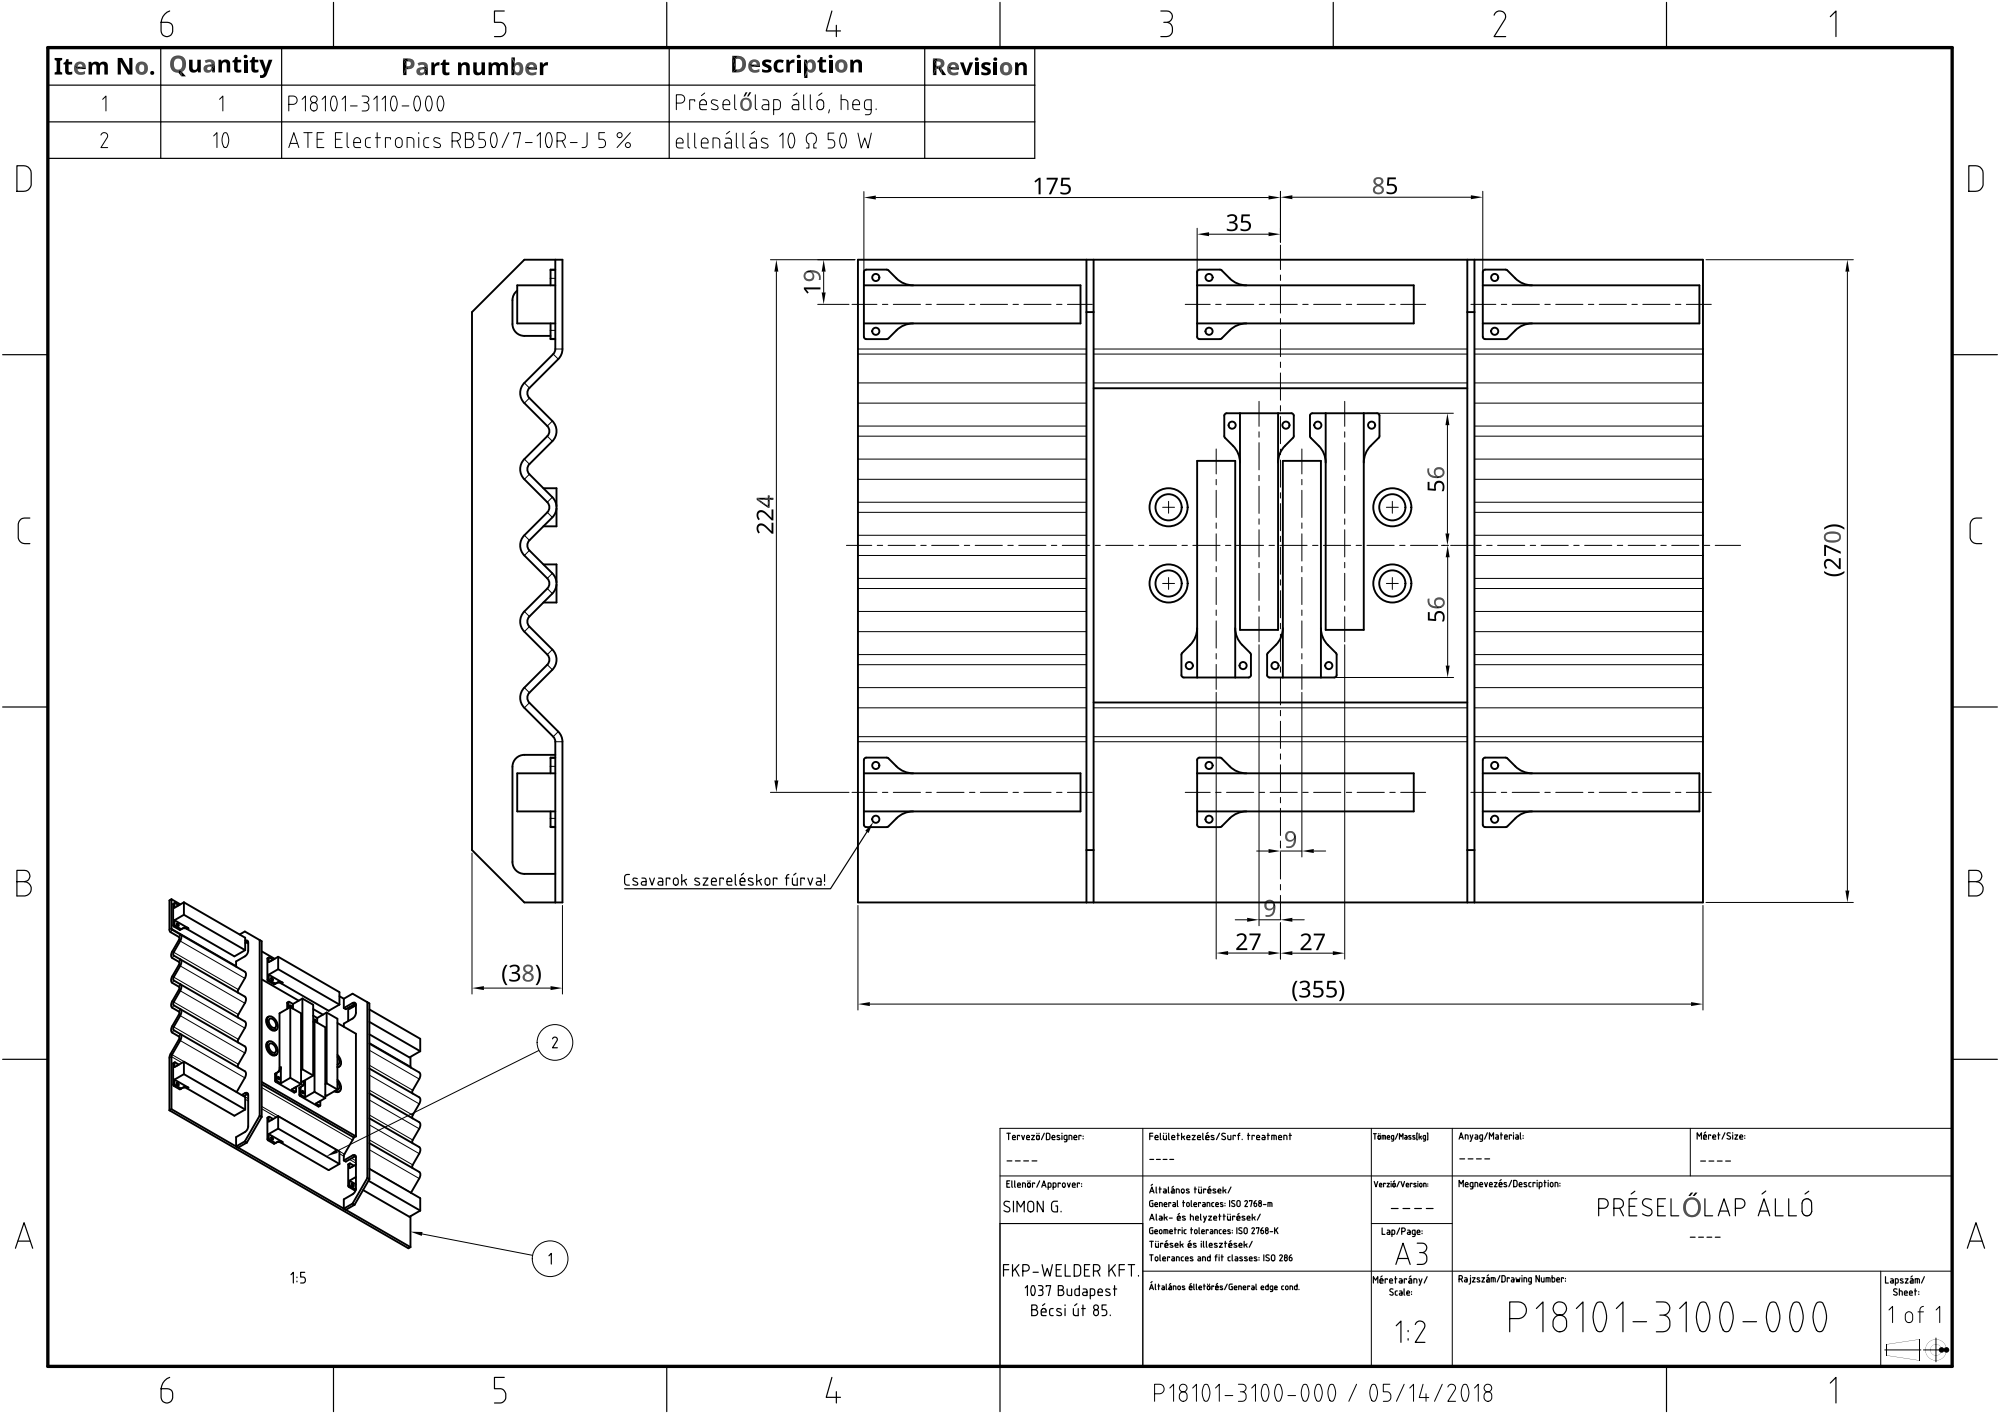
[picture p97: page 1]
