coderlazar/Metta-Pet/Tervrajzok/3000 - préselő egység/P18101-3110-000 préselőlap álló heg.pdf

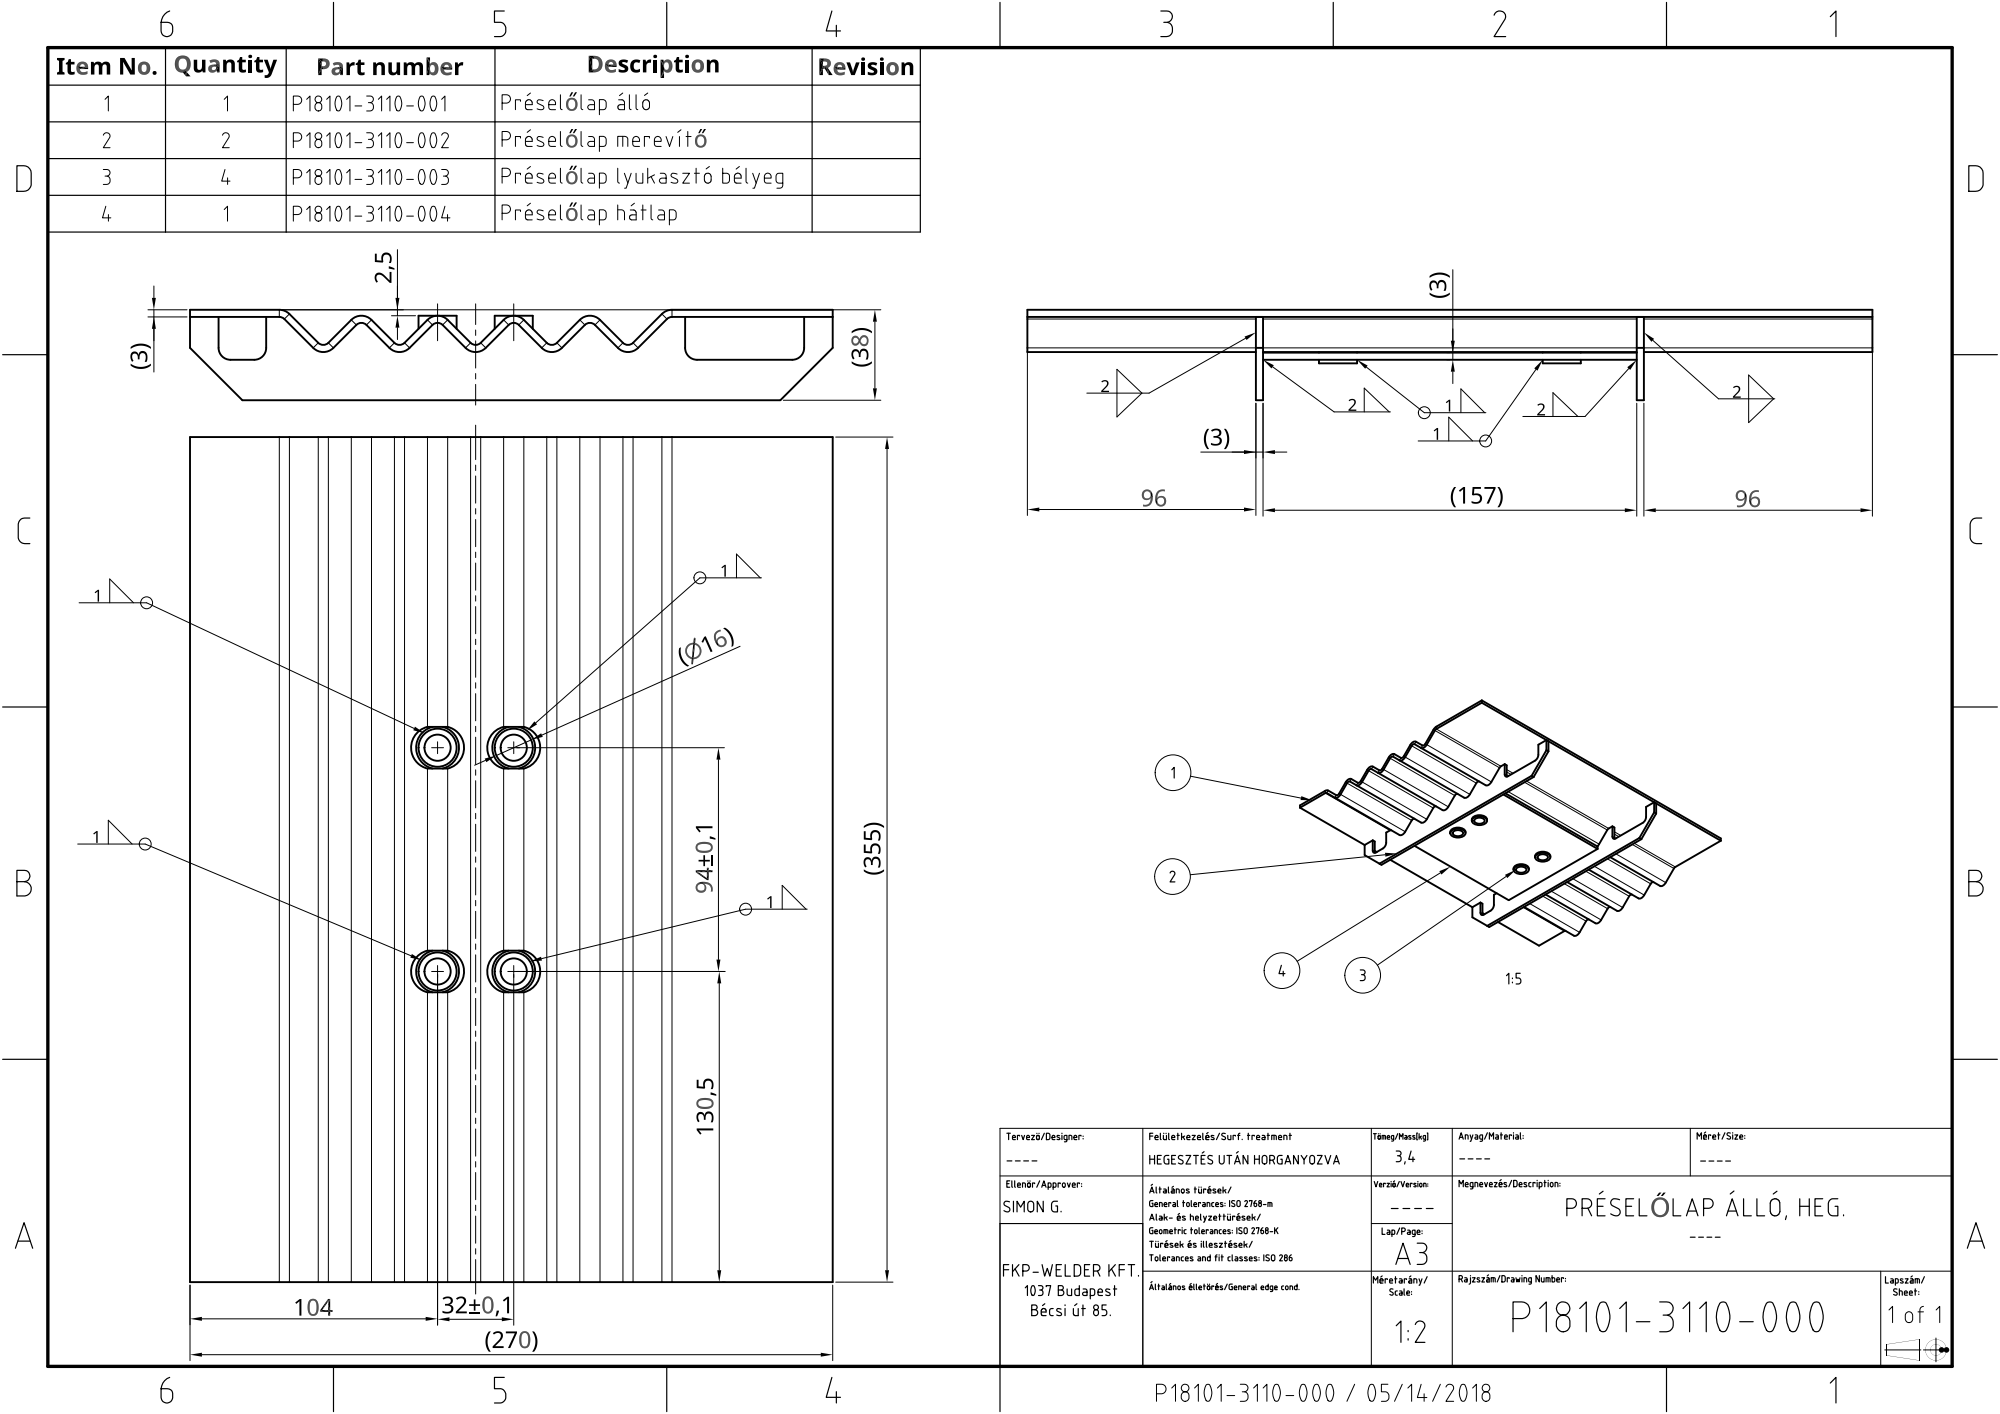
[picture p98: page 1]
