coderlazar/Metta-Pet/Tervrajzok/3000 - préselő egység/P18101-3110-002 préselő lap merevítő.pdf

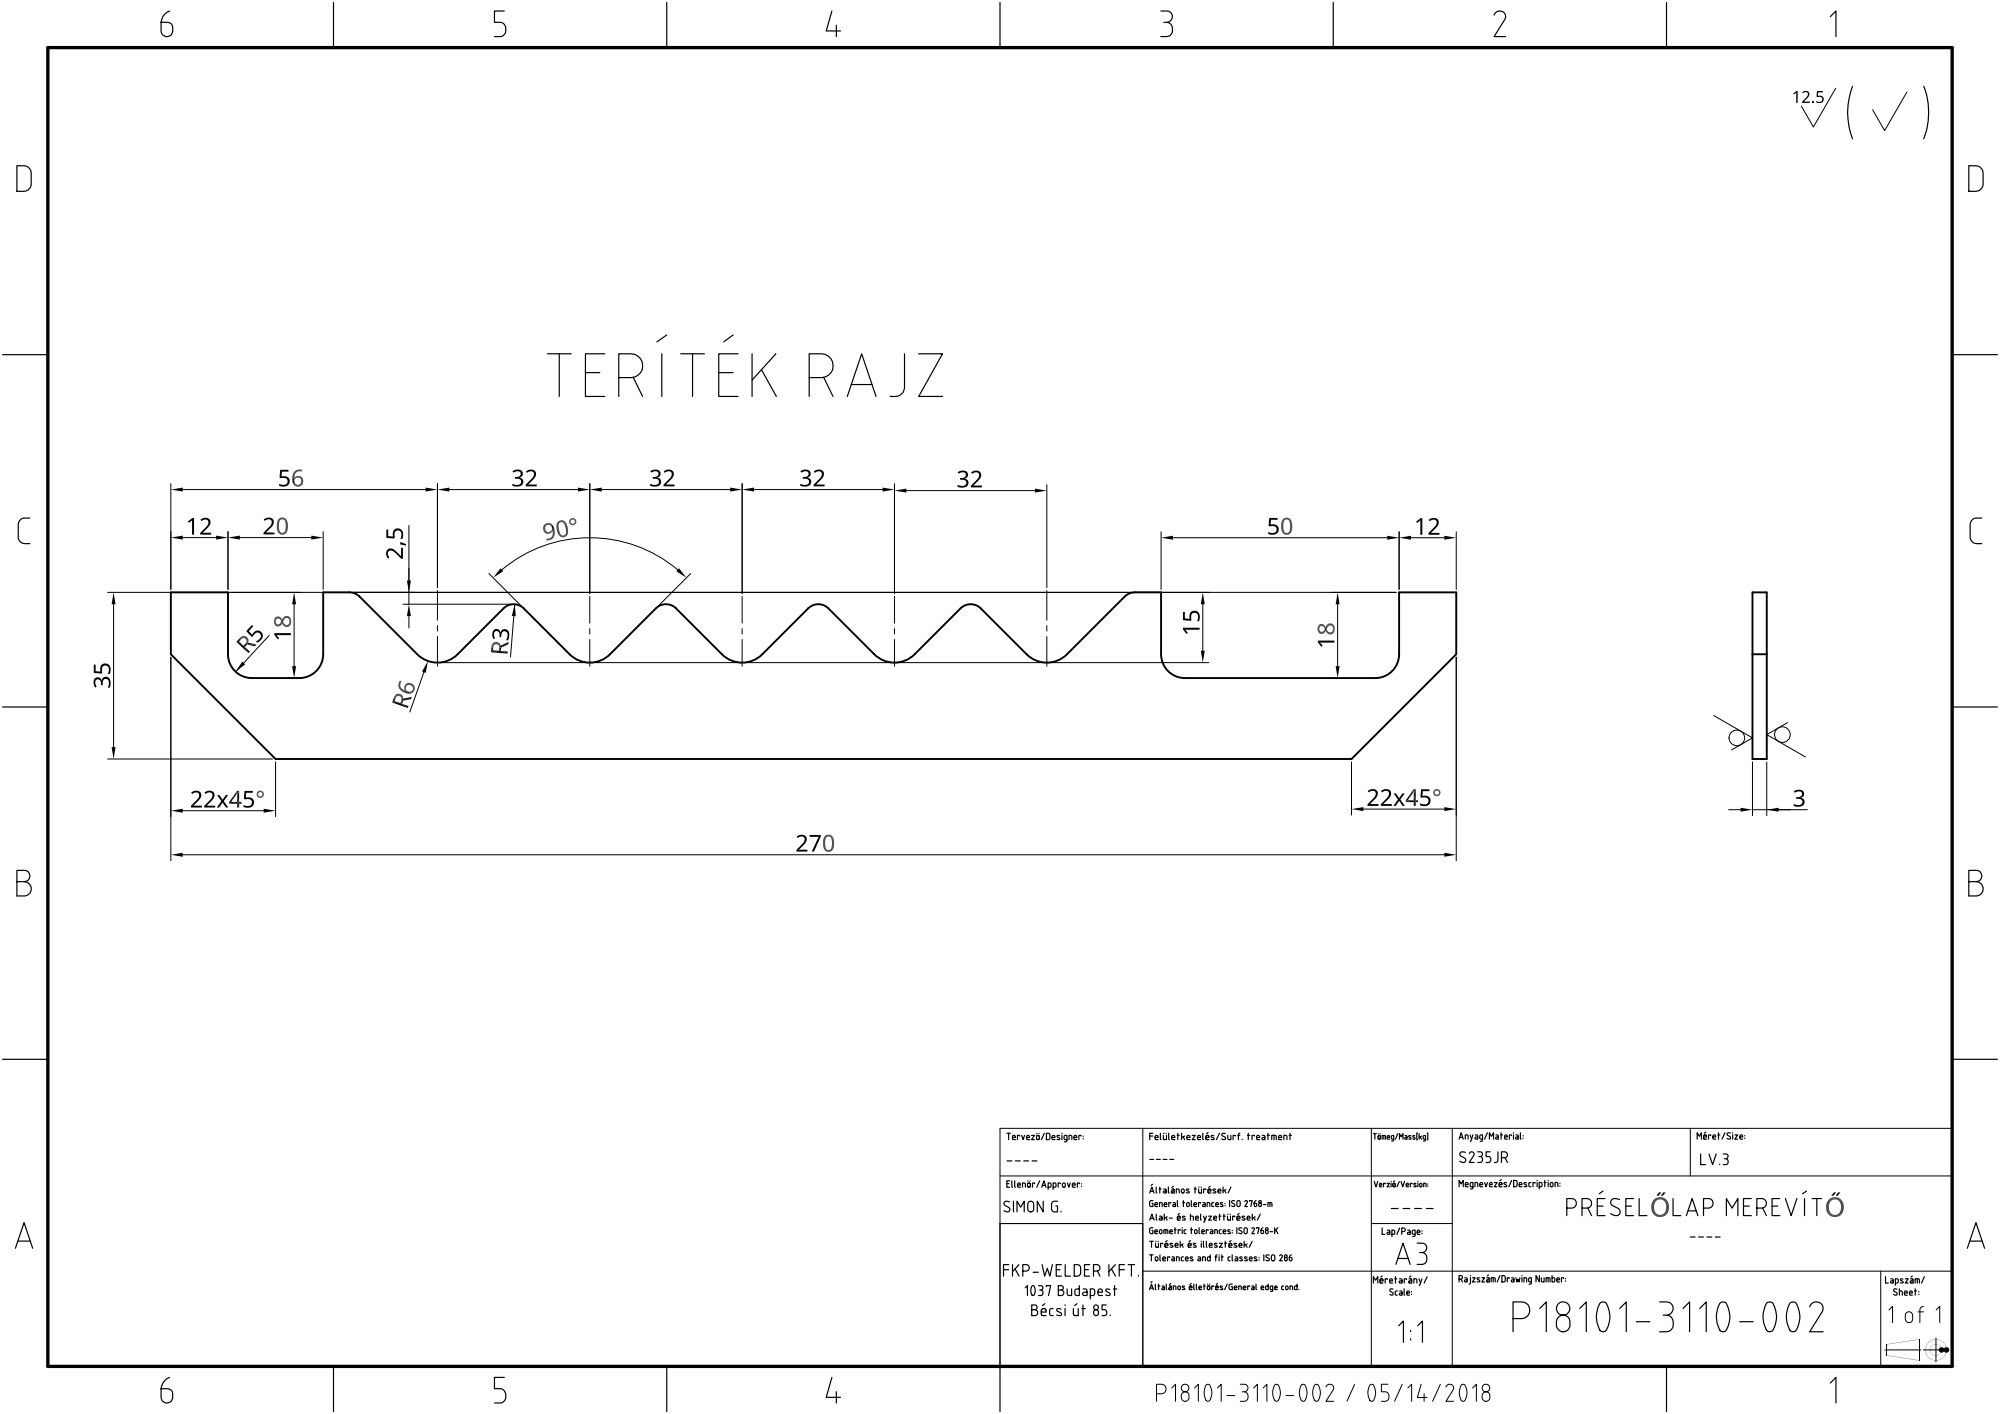
[picture p99: page 1]
