coderlazar/Metta-Pet/Tervrajzok/3000 - préselő egység/P18101-3110-004 préselőlap hátlap.pdf

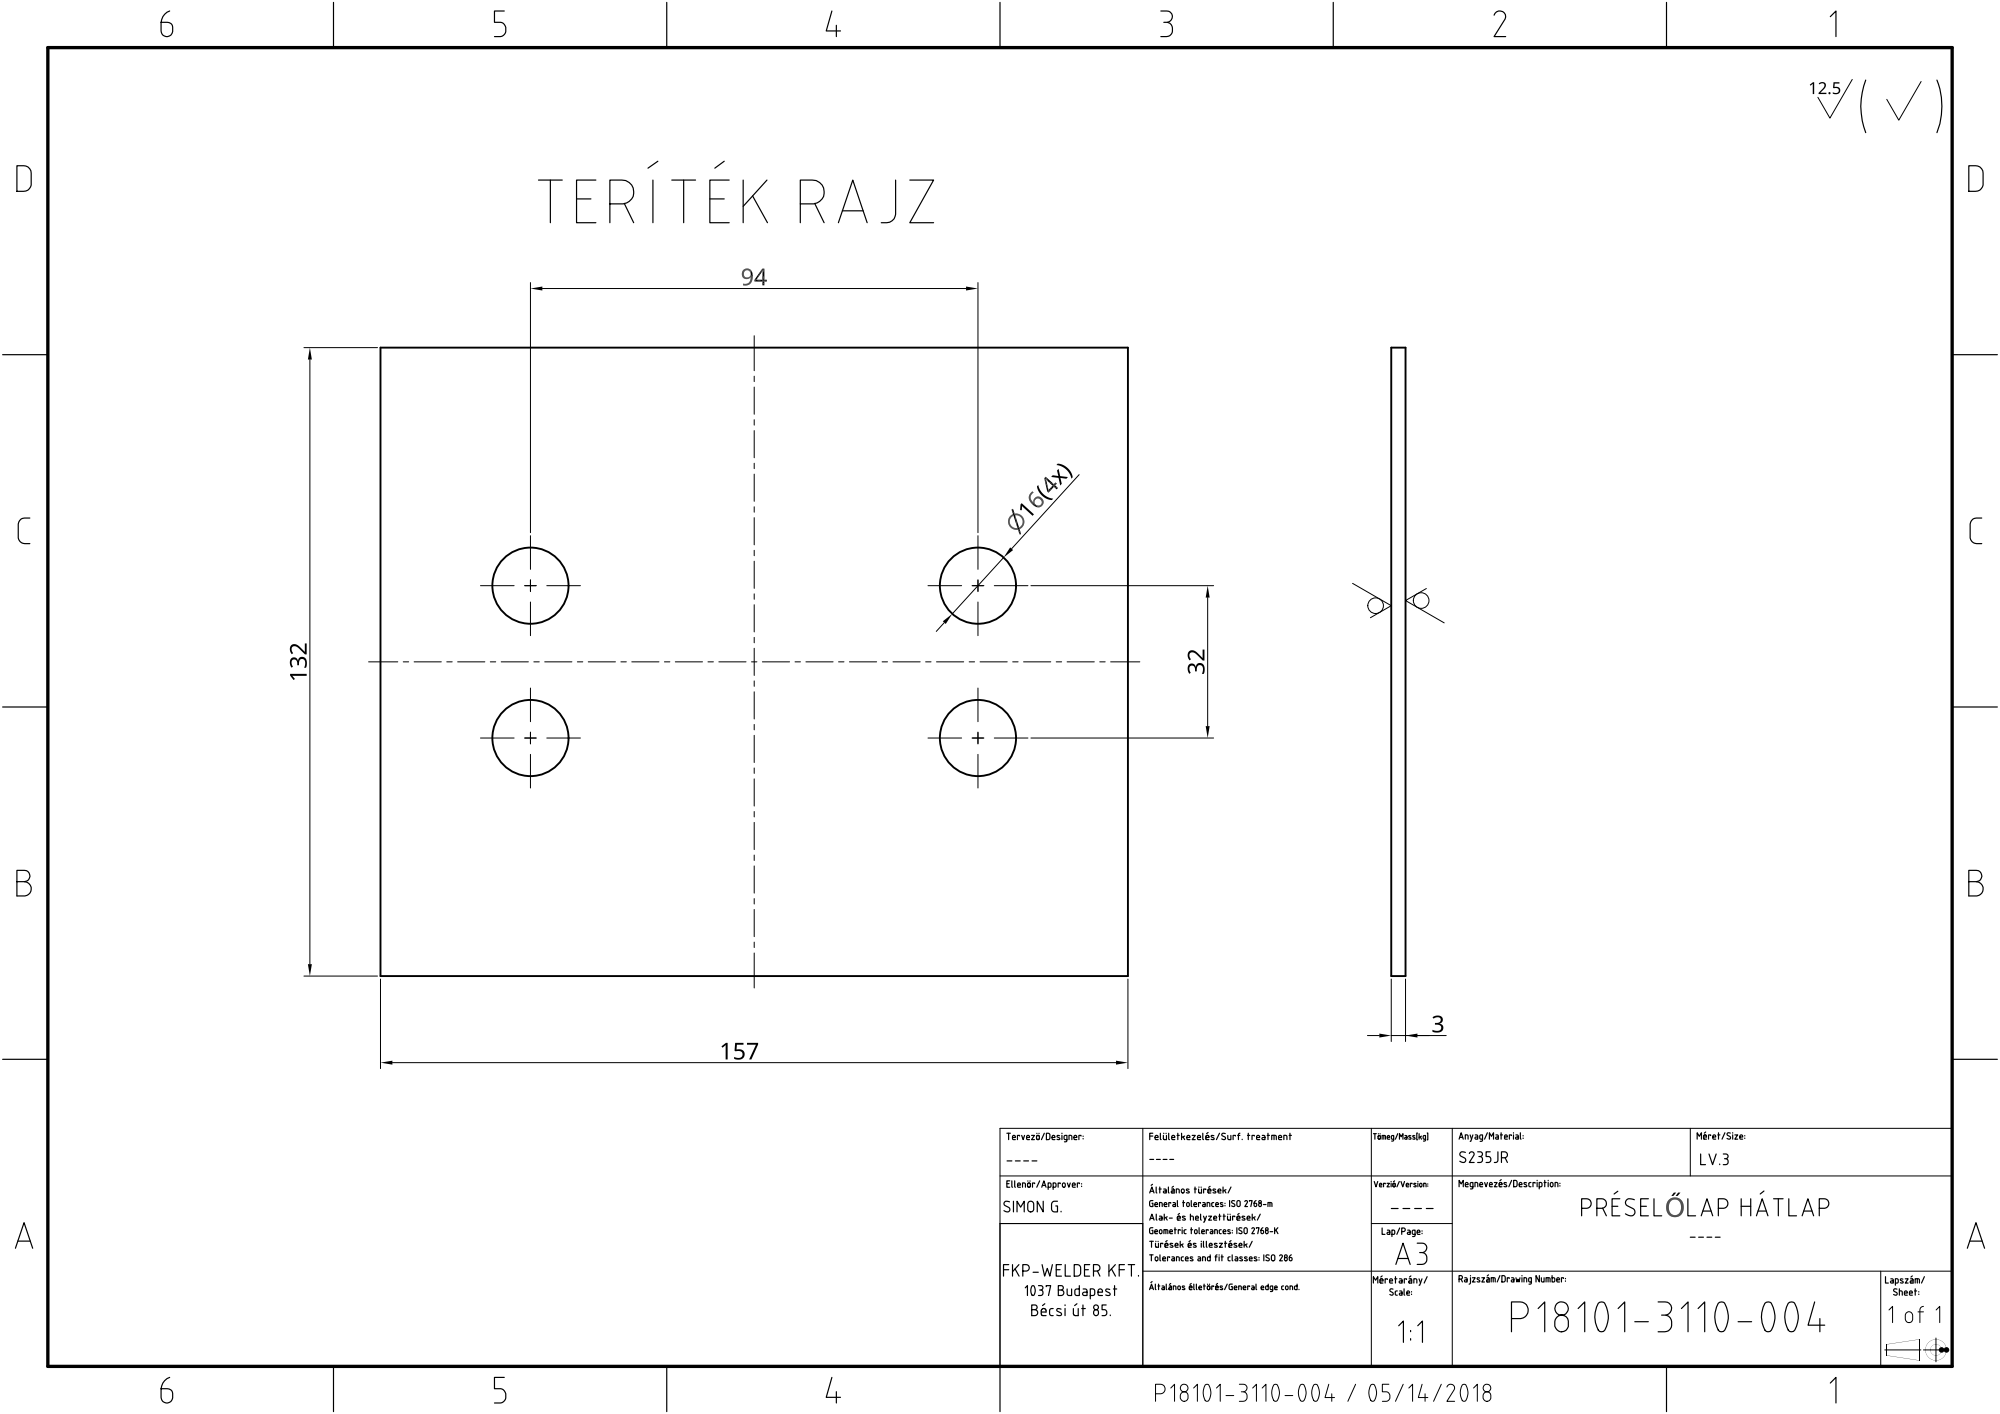
[picture p100: page 1]
