coderlazar/Metta-Pet/Tervrajzok/3000 - préselő egység/P18101-3200-000 préselőbélyeg mozgó.pdf

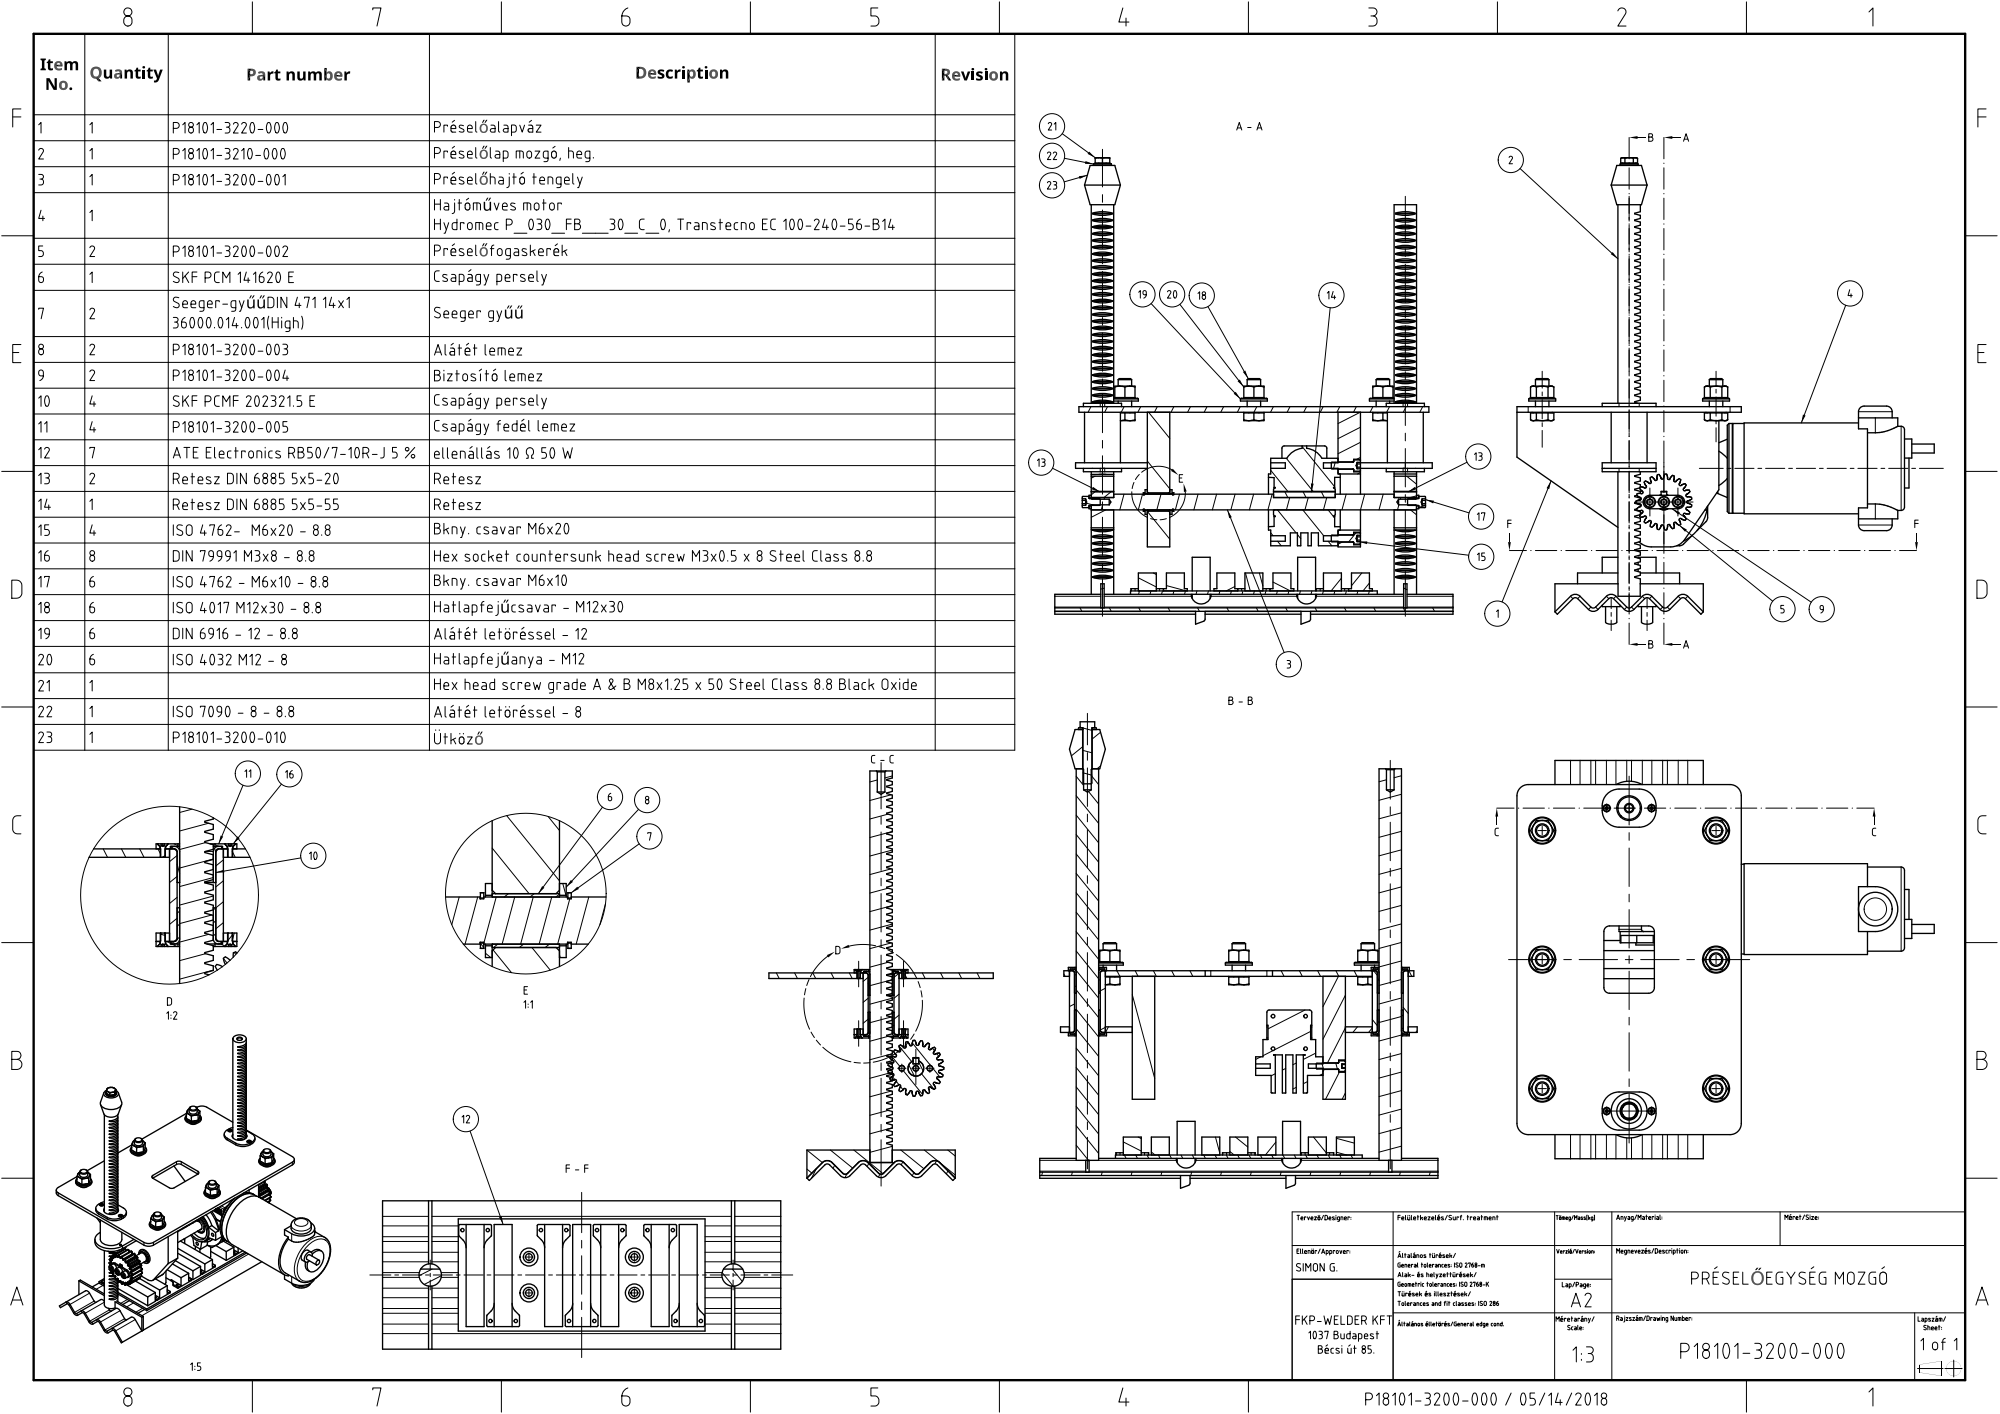
[picture p101: page 1]
