coderlazar/Metta-Pet/Tervrajzok/3000 - préselő egység/P18101-3200-003 persely és csap.pdf

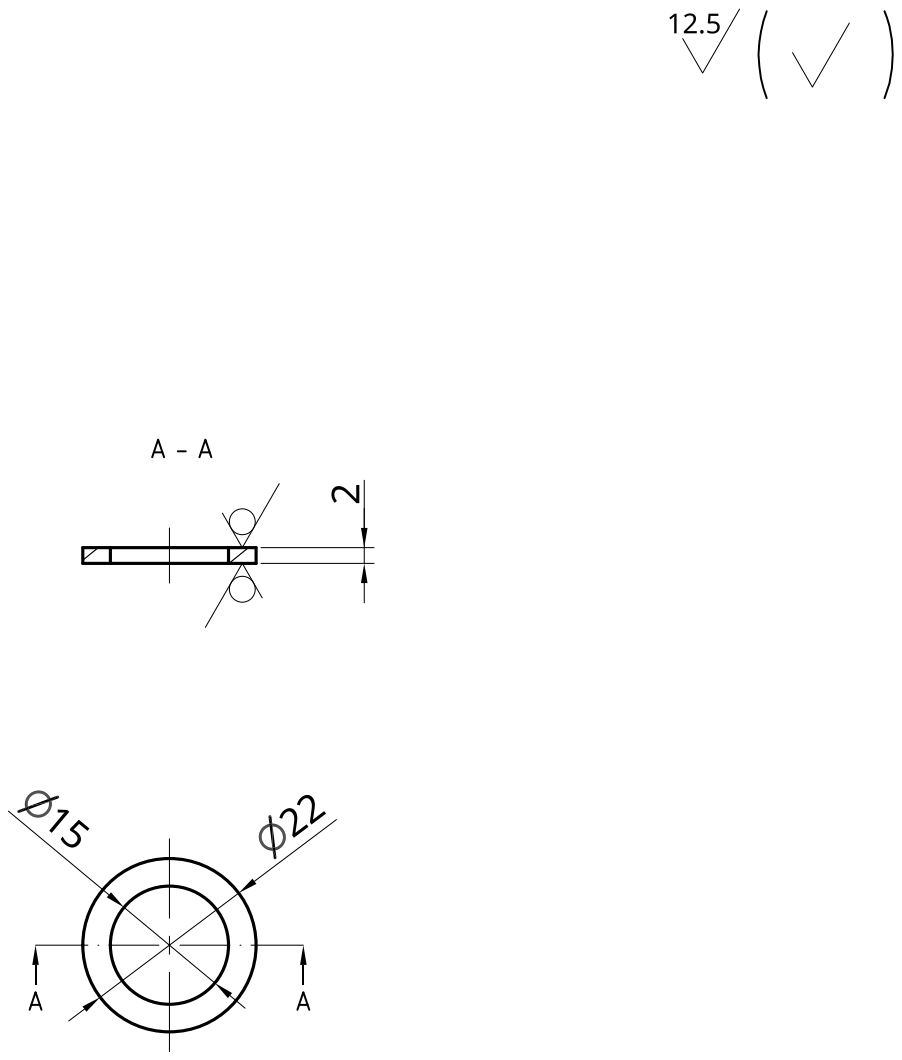
[picture p102: page 1]
