coderlazar/Metta-Pet/Tervrajzok/3000 - préselő egység/P18101-3200-004.pdf

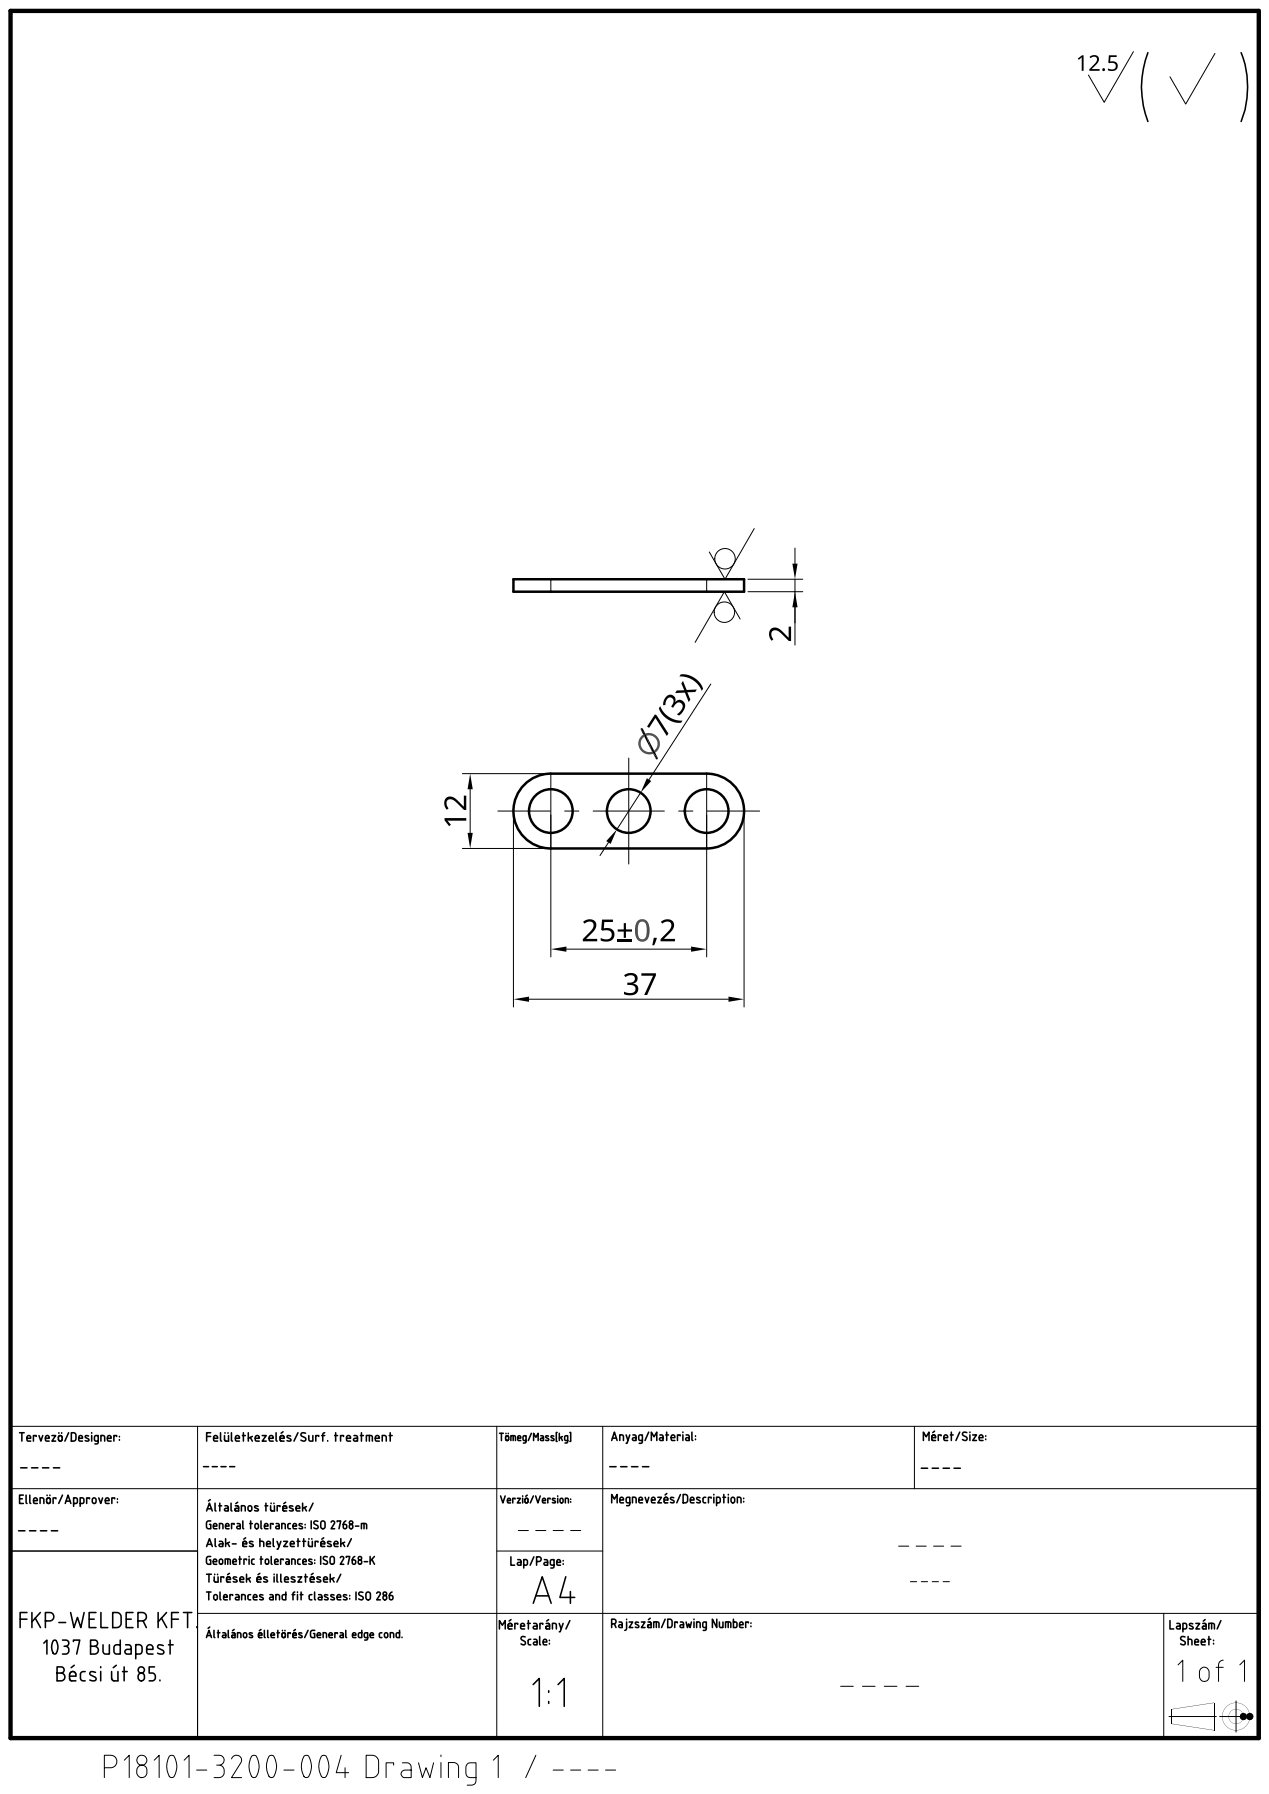
[picture p103: page 1]
