coderlazar/Metta-Pet/Tervrajzok/3000 - préselő egység/P18101-3200-005.pdf

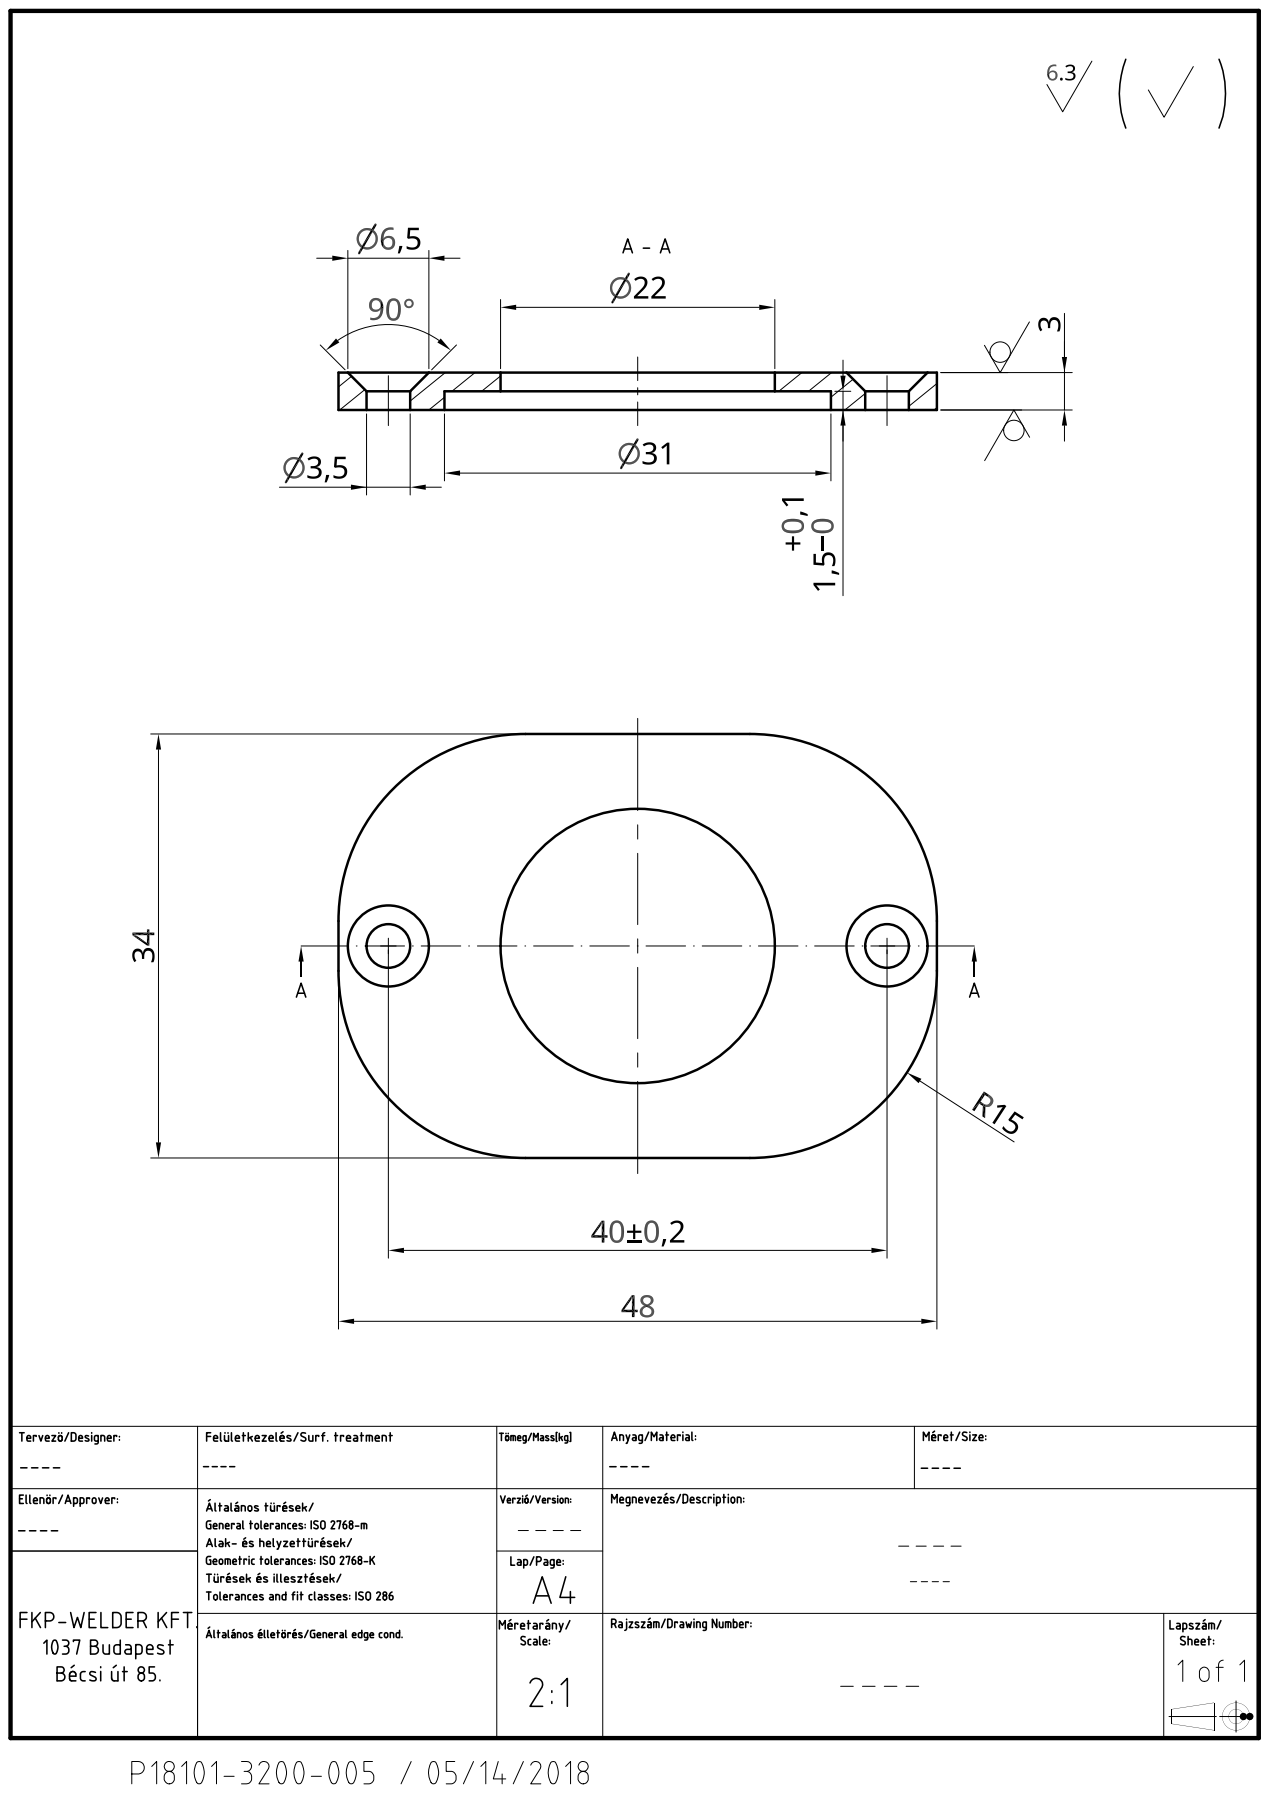
[picture p104: page 1]
