coderlazar/Metta-Pet/Tervrajzok/3000 - préselő egység/P18101-3200-010 ütköző.pdf

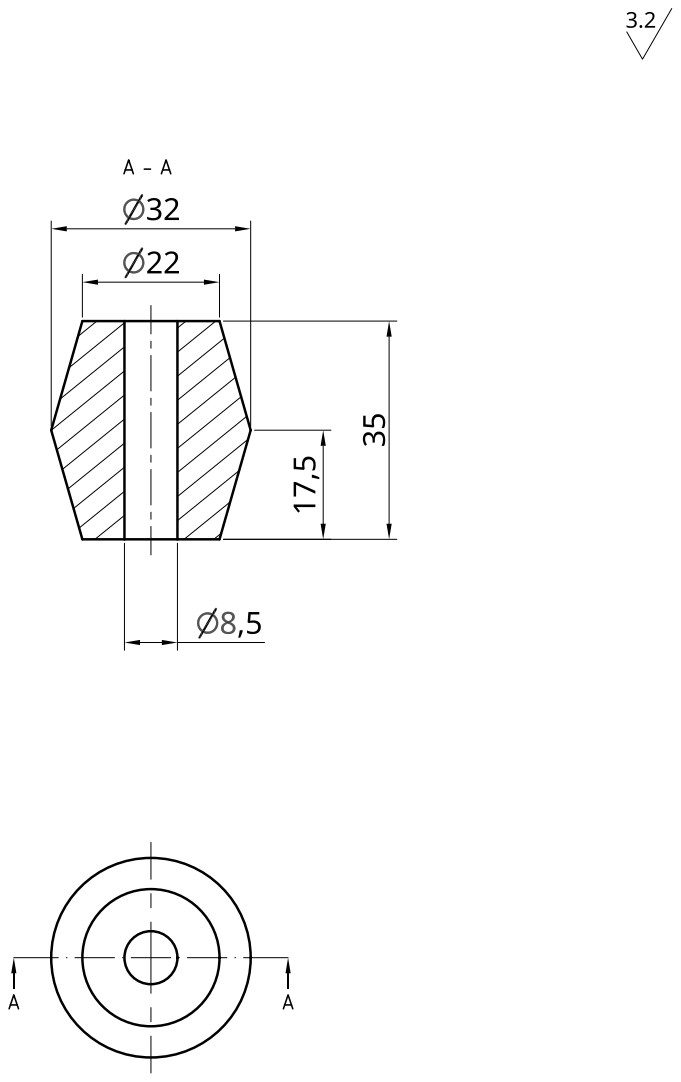
[picture p105: page 1]
