coderlazar/Metta-Pet/Tervrajzok/3000 - préselő egység/P18101-3210-000 préselőlap mozgó heg..pdf

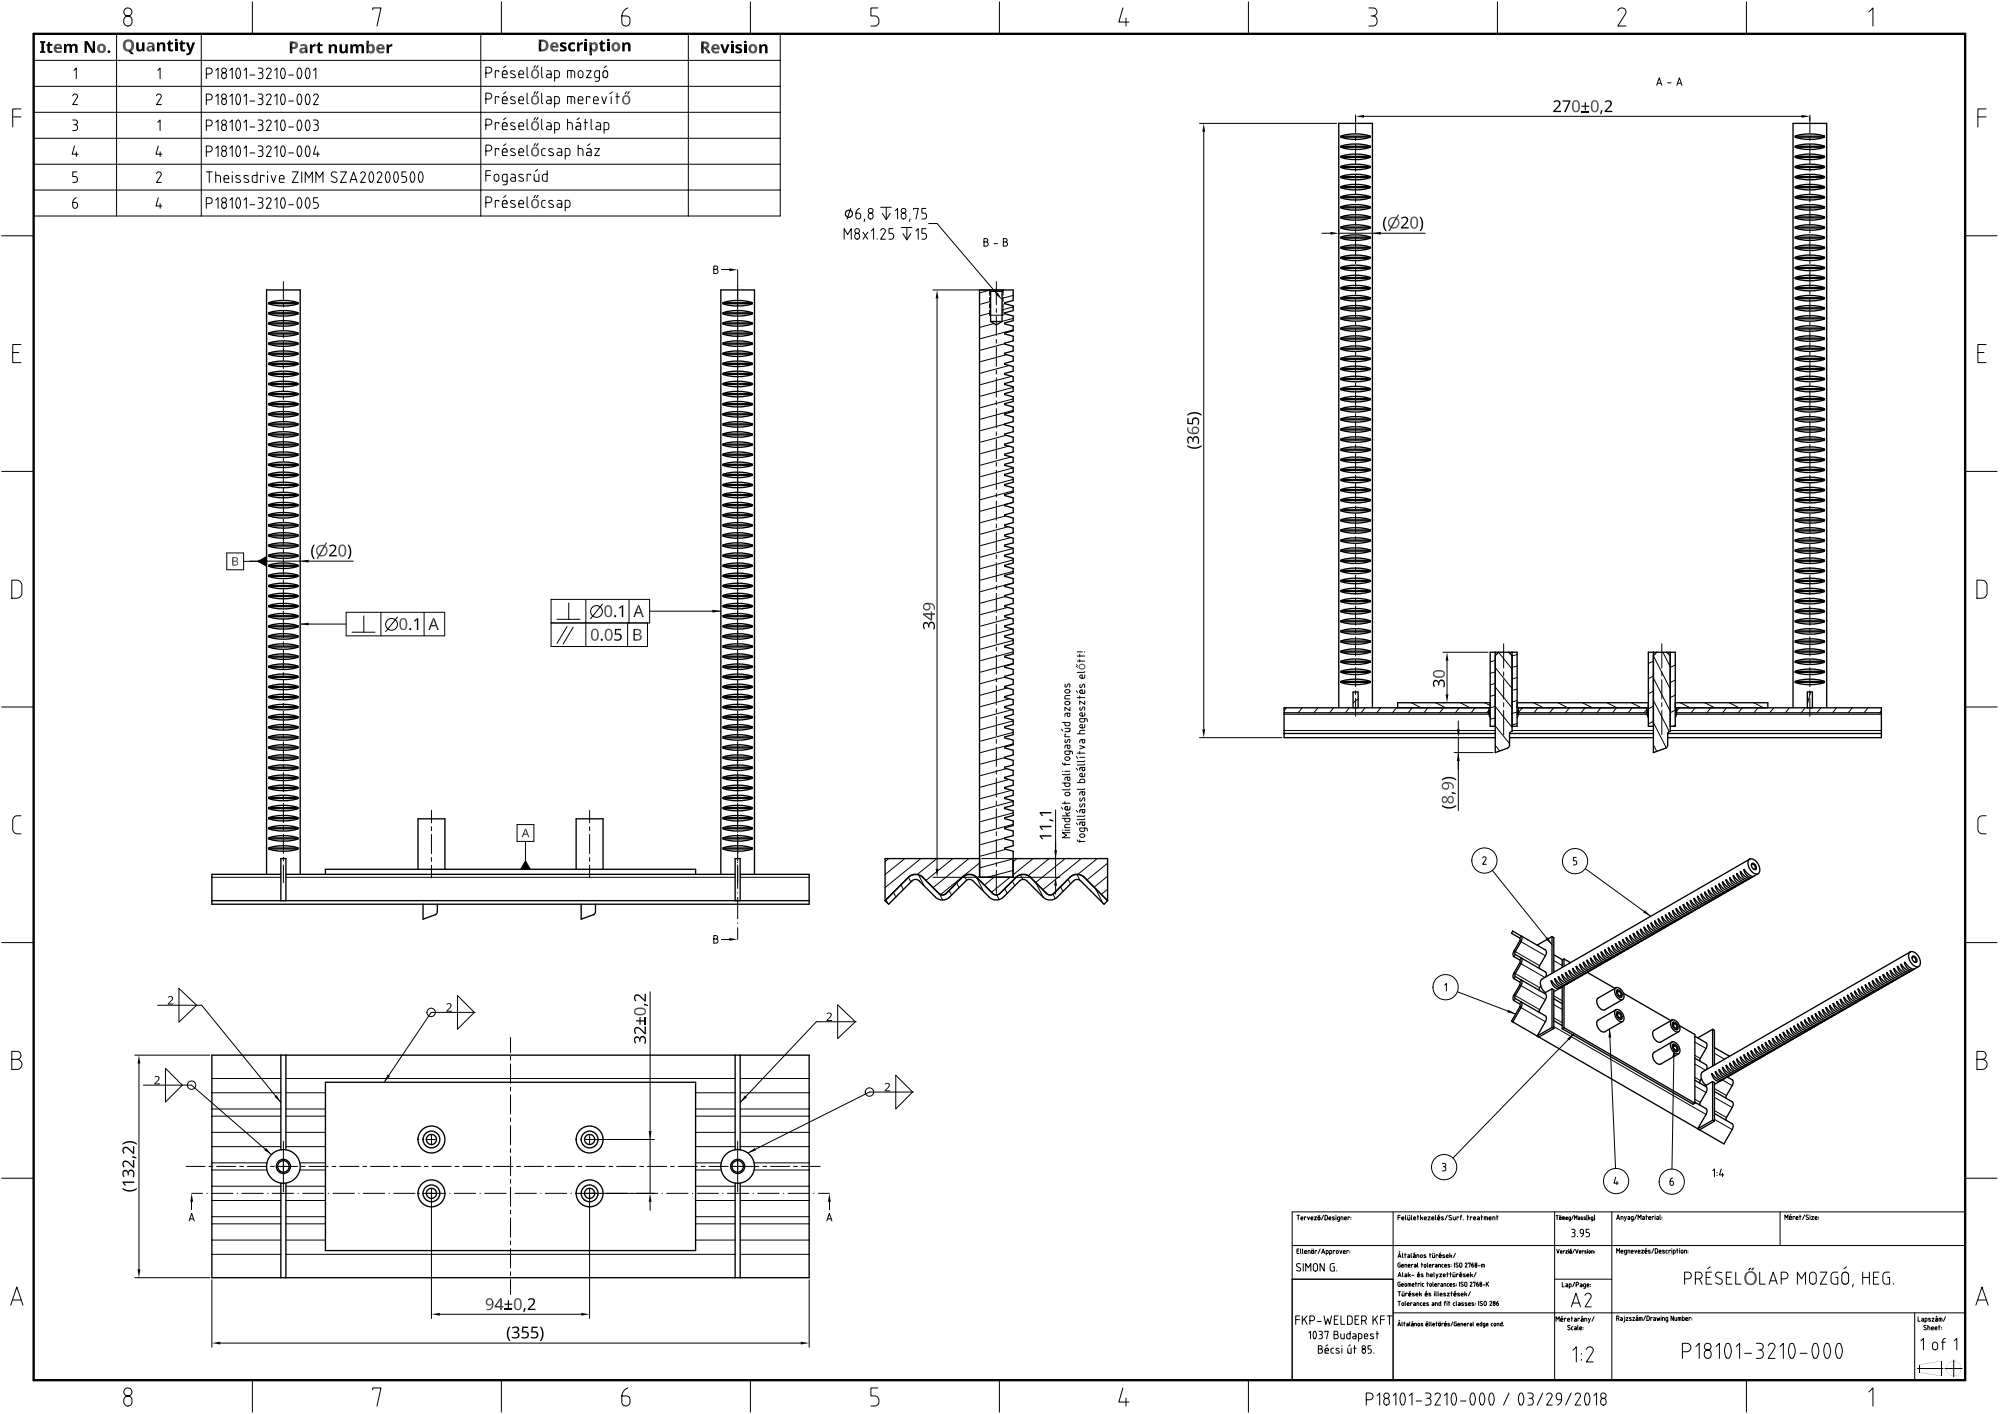
[picture p106: page 1]
