coderlazar/Metta-Pet/Tervrajzok/3000 - préselő egység/P18101-3210-002 préselőlap merevitő.pdf

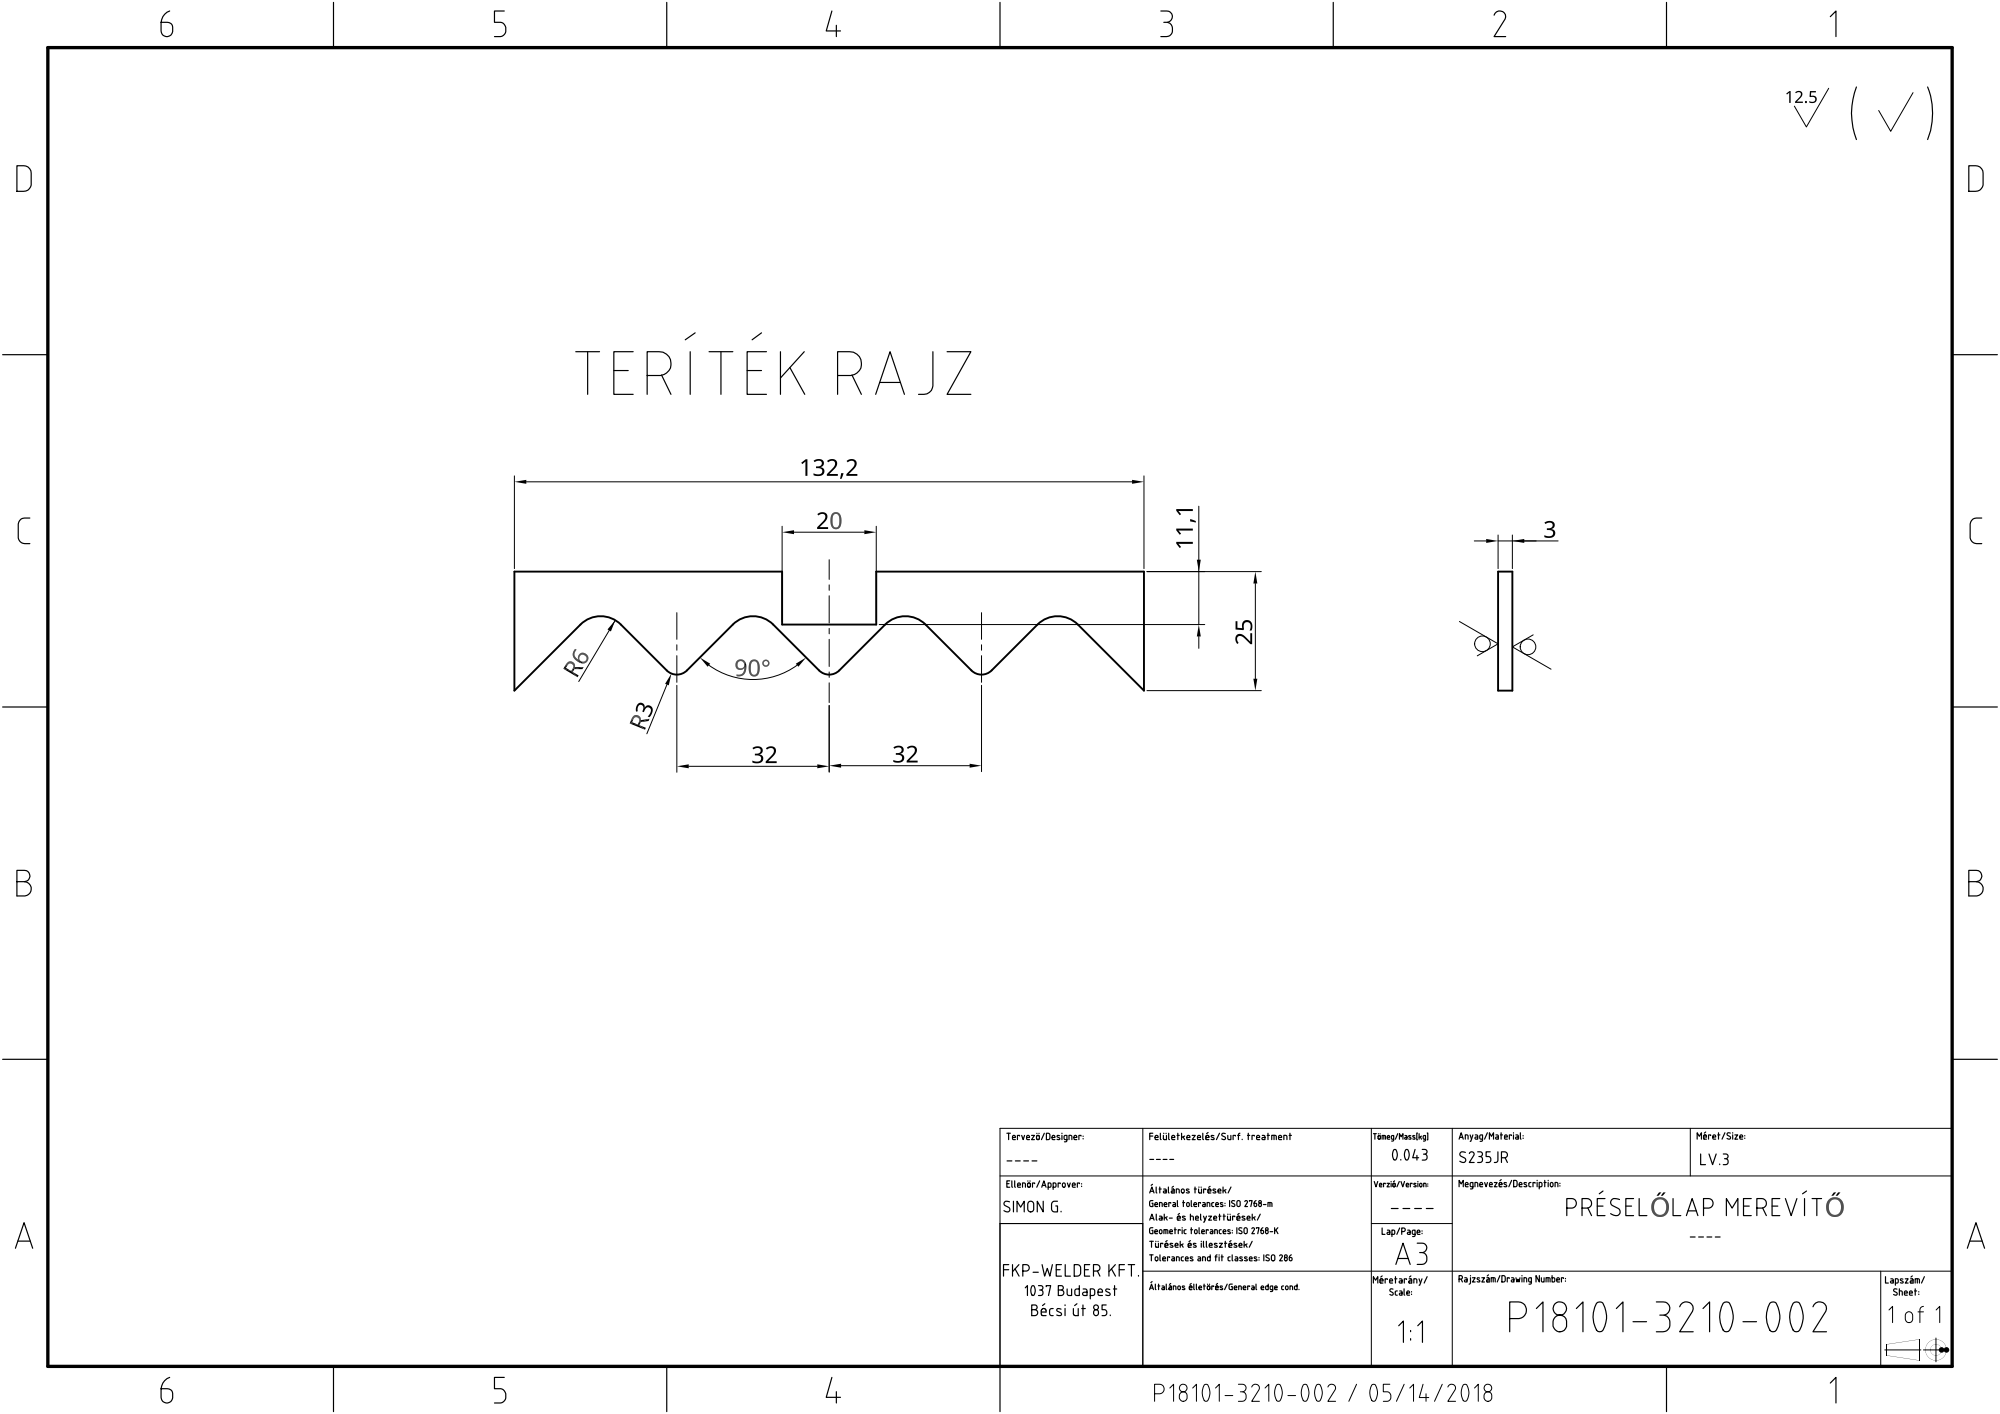
[picture p107: page 1]
