coderlazar/Metta-Pet/Tervrajzok/3000 - préselő egység/P18101-3210-003 préselőlap hátlap.pdf

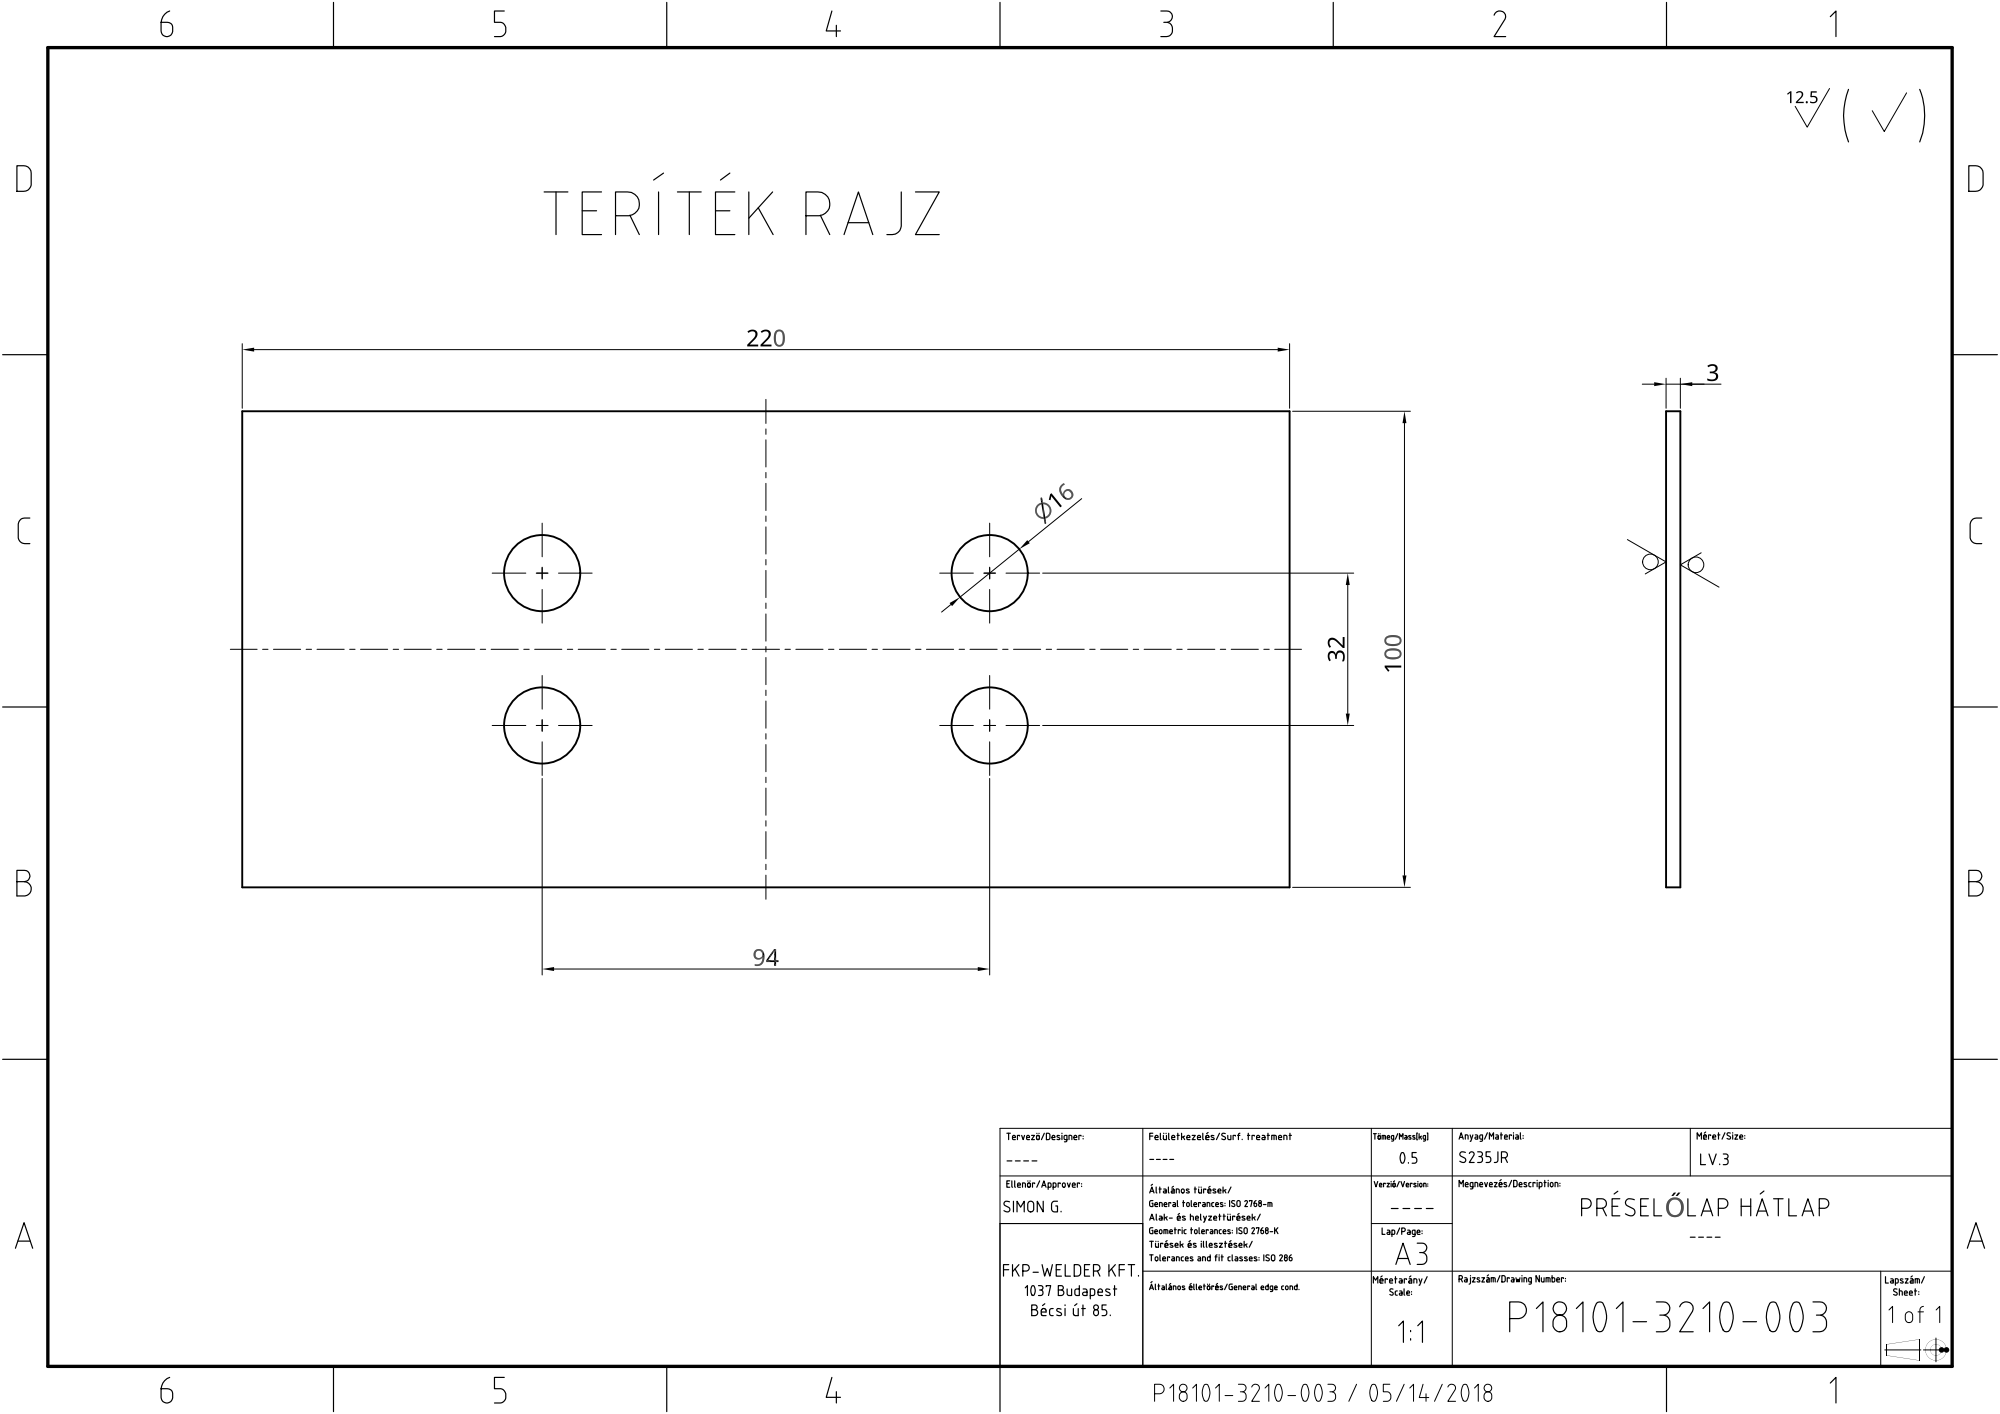
[picture p108: page 1]
