coderlazar/Metta-Pet/Tervrajzok/3000 - préselő egység/P18101-3220-000 préselőlap váz.pdf

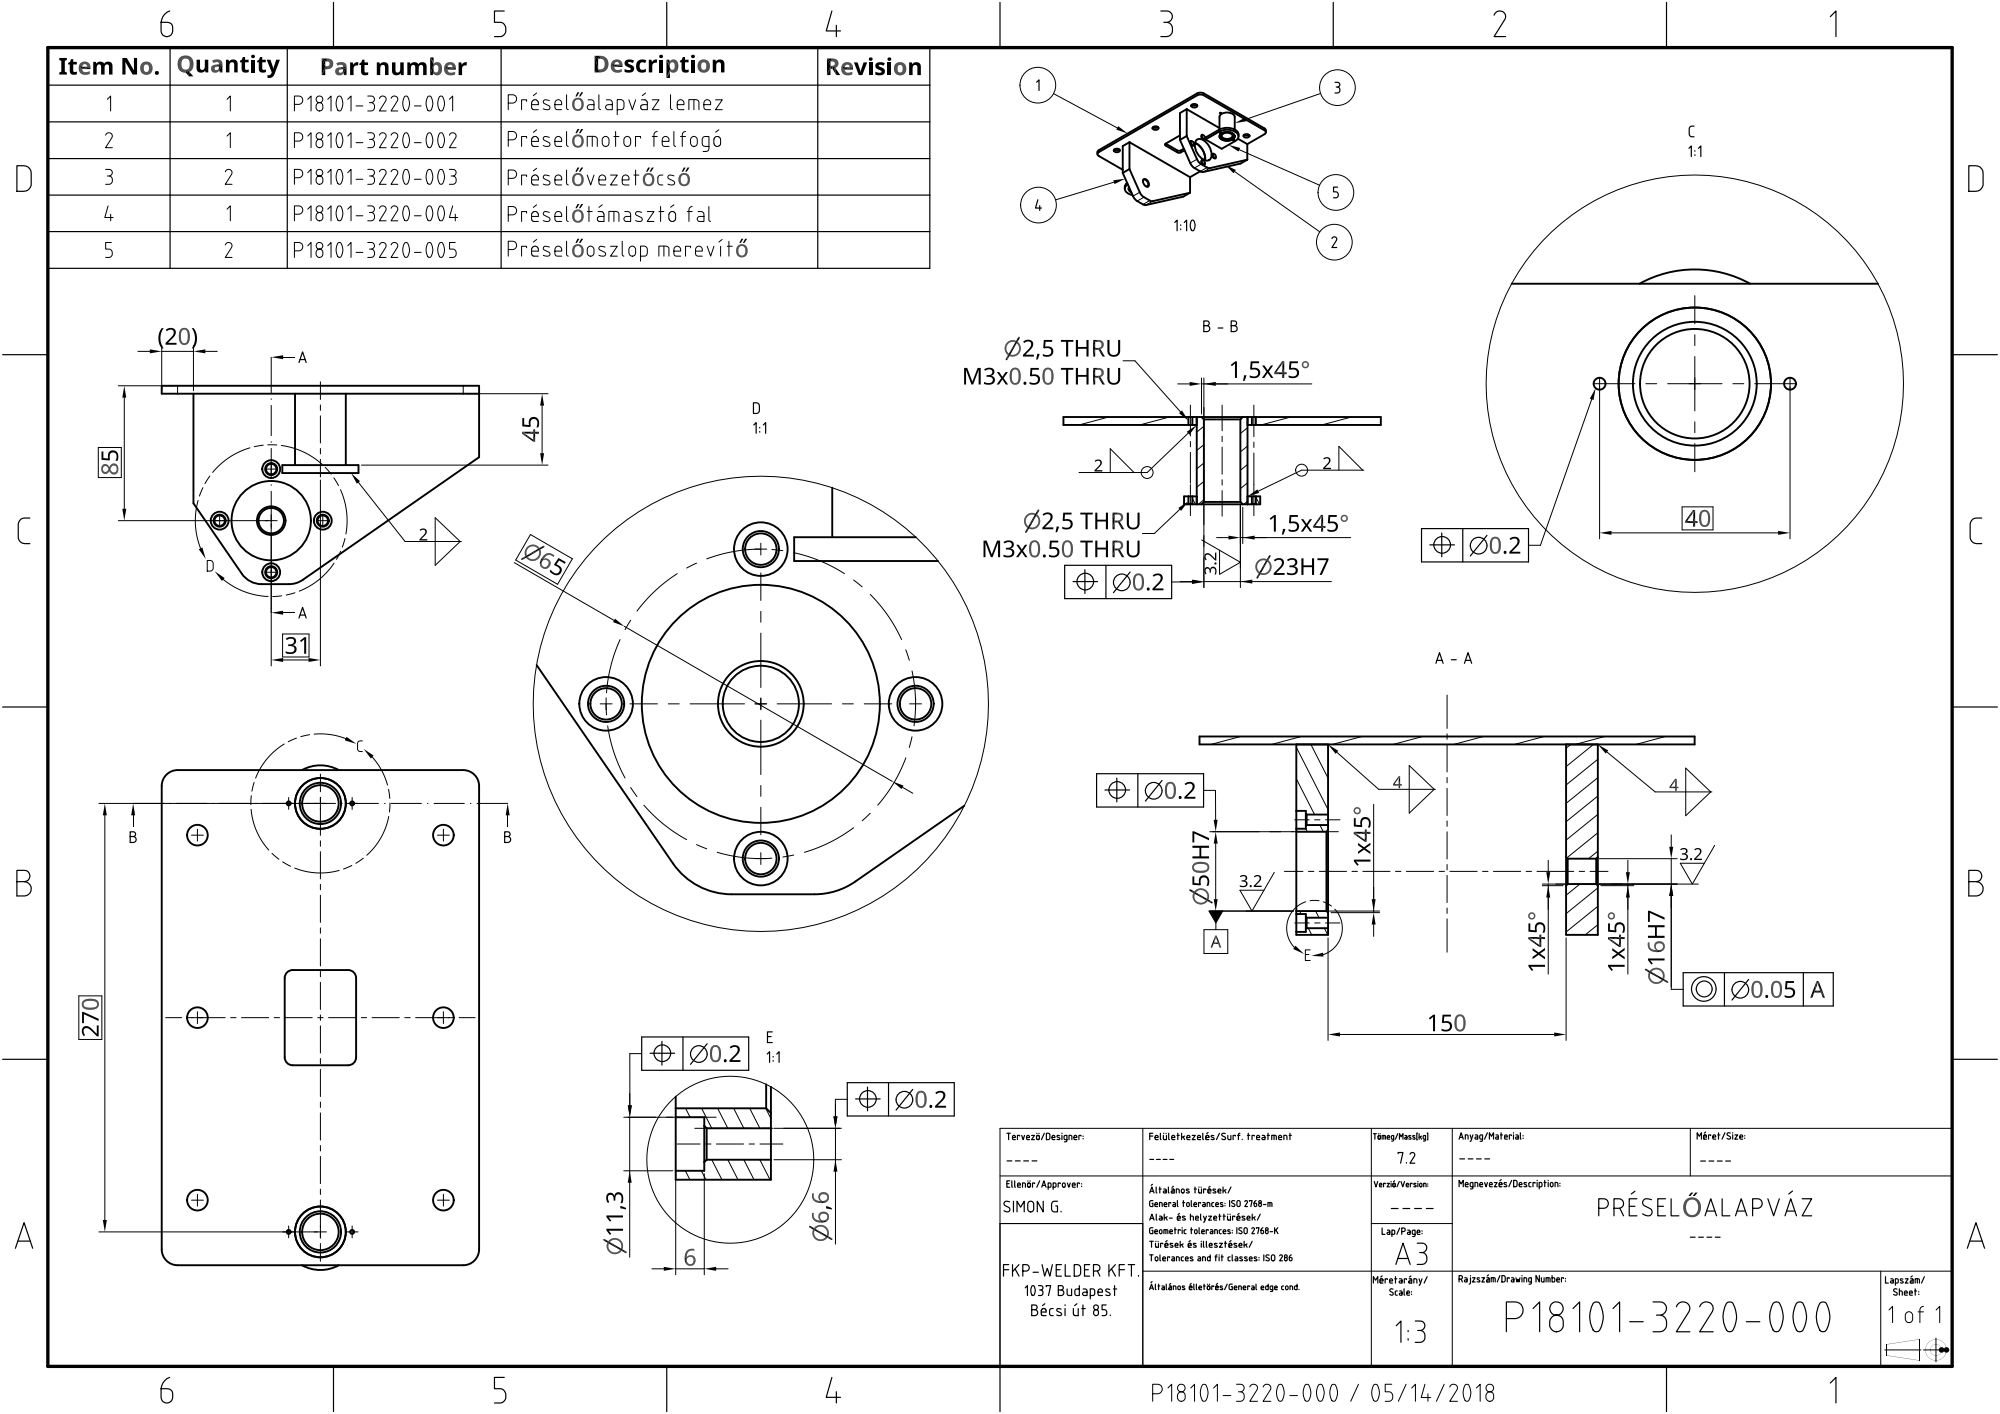
[picture p109: page 1]
