coderlazar/Metta-Pet/Tervrajzok/3000 - préselő egység/P18101-3220-001 préselőlapváz lemez.pdf

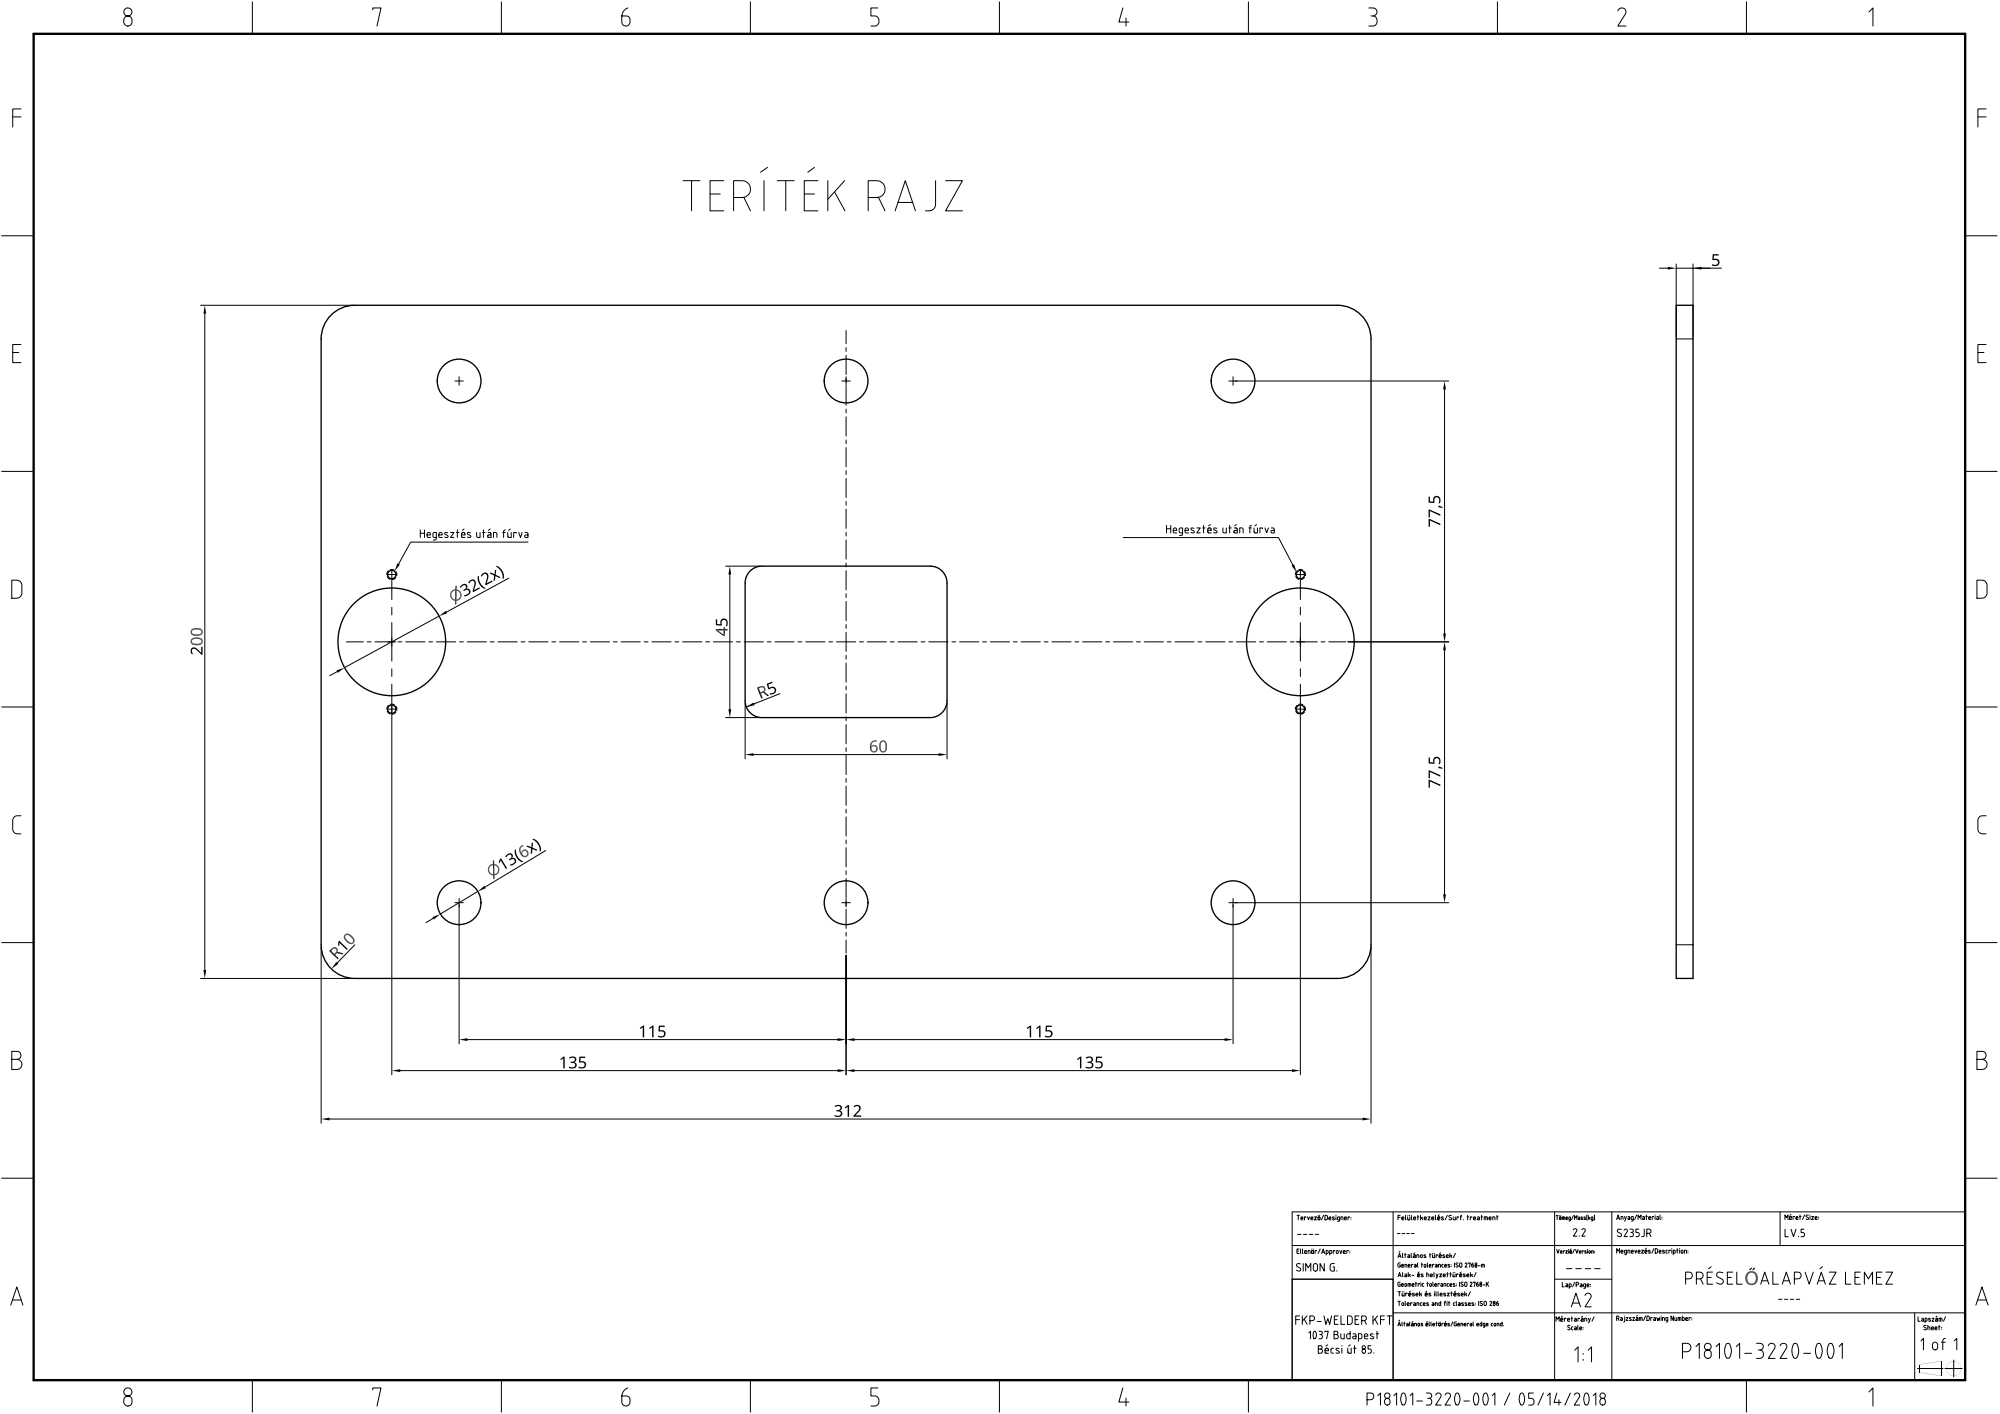
[picture p110: page 1]
