coderlazar/Metta-Pet/Tervrajzok/3000 - préselő egység/P18101-3220-002 préselőmotor felfogó.pdf

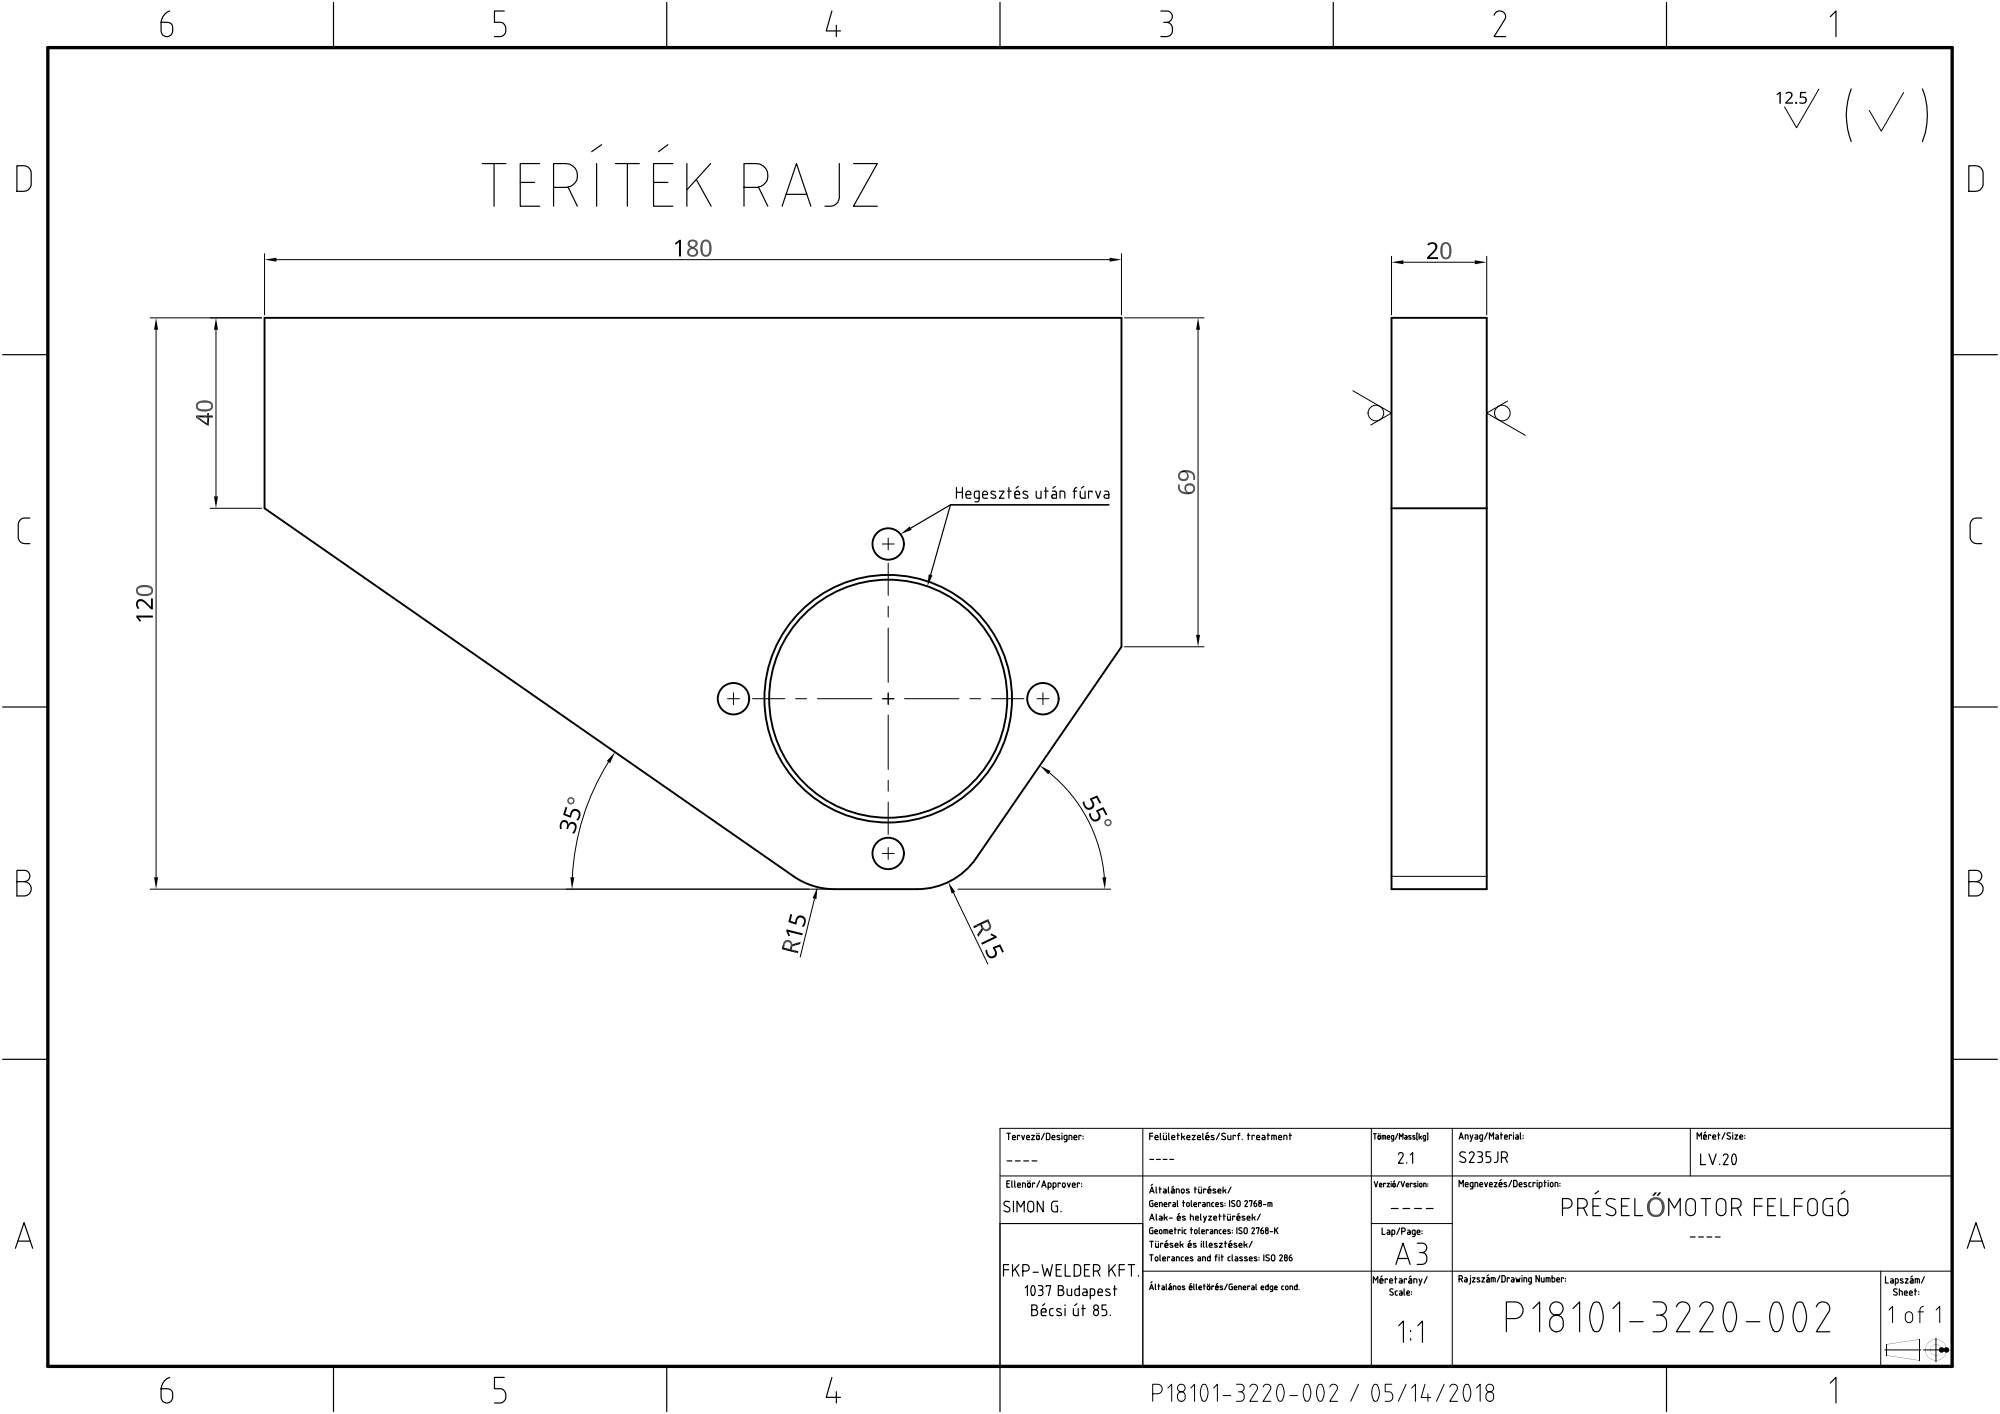
[picture p111: page 1]
