coderlazar/Metta-Pet/Tervrajzok/3000 - préselő egység/P18101-3220-004 préselőtámasztó fal.pdf

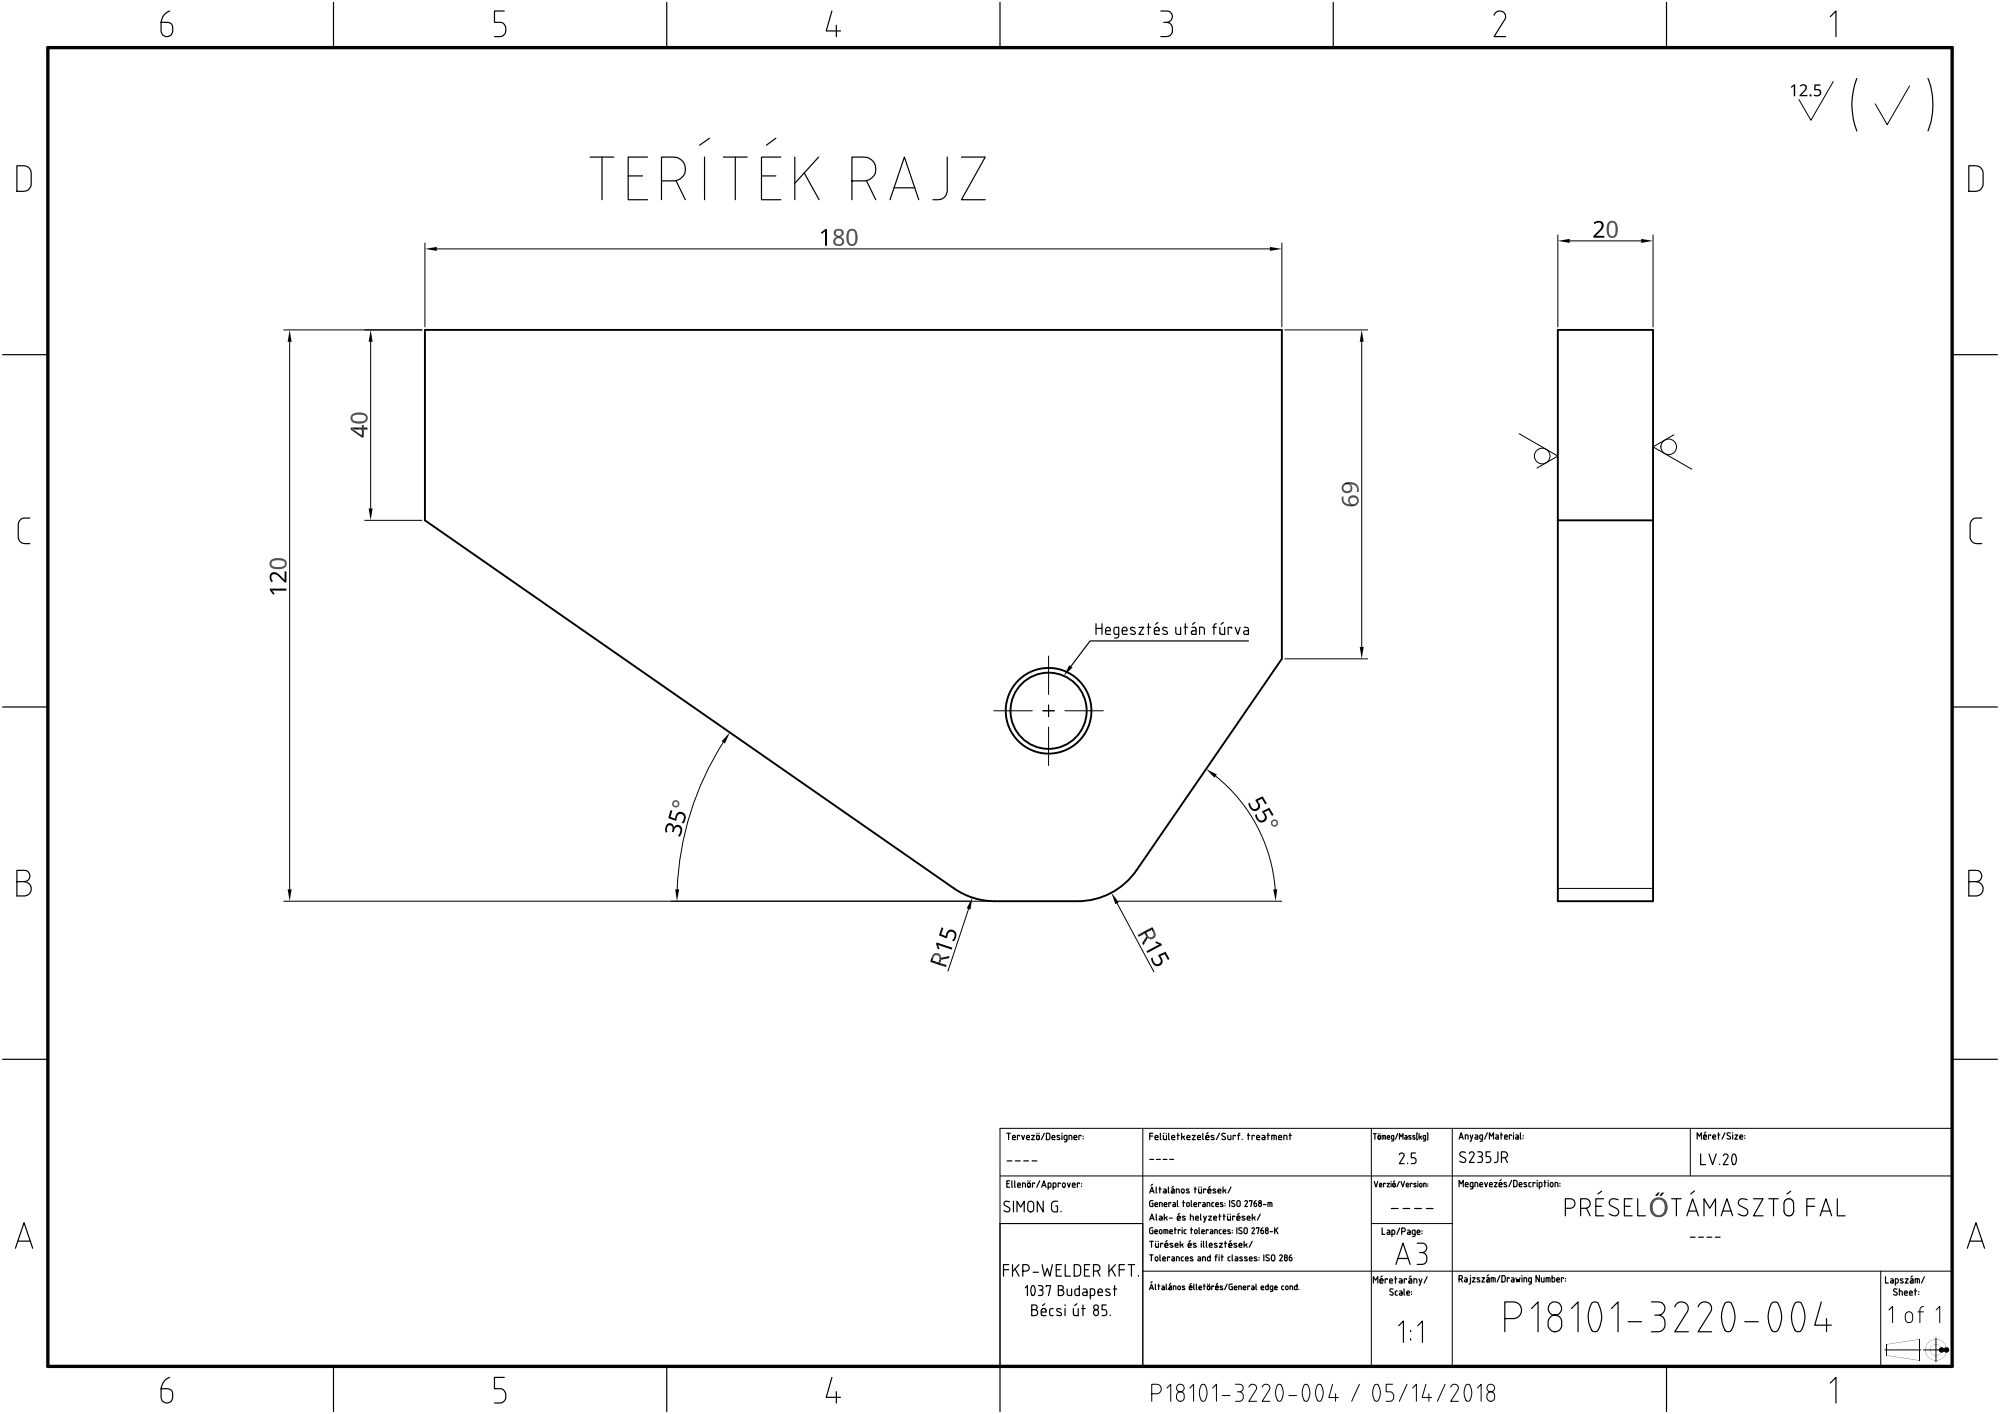
[picture p112: page 1]
