coderlazar/Metta-Pet/Tervrajzok/3000 - préselő egység/P18101-3220-005 préselőoszlop merevitő.pdf

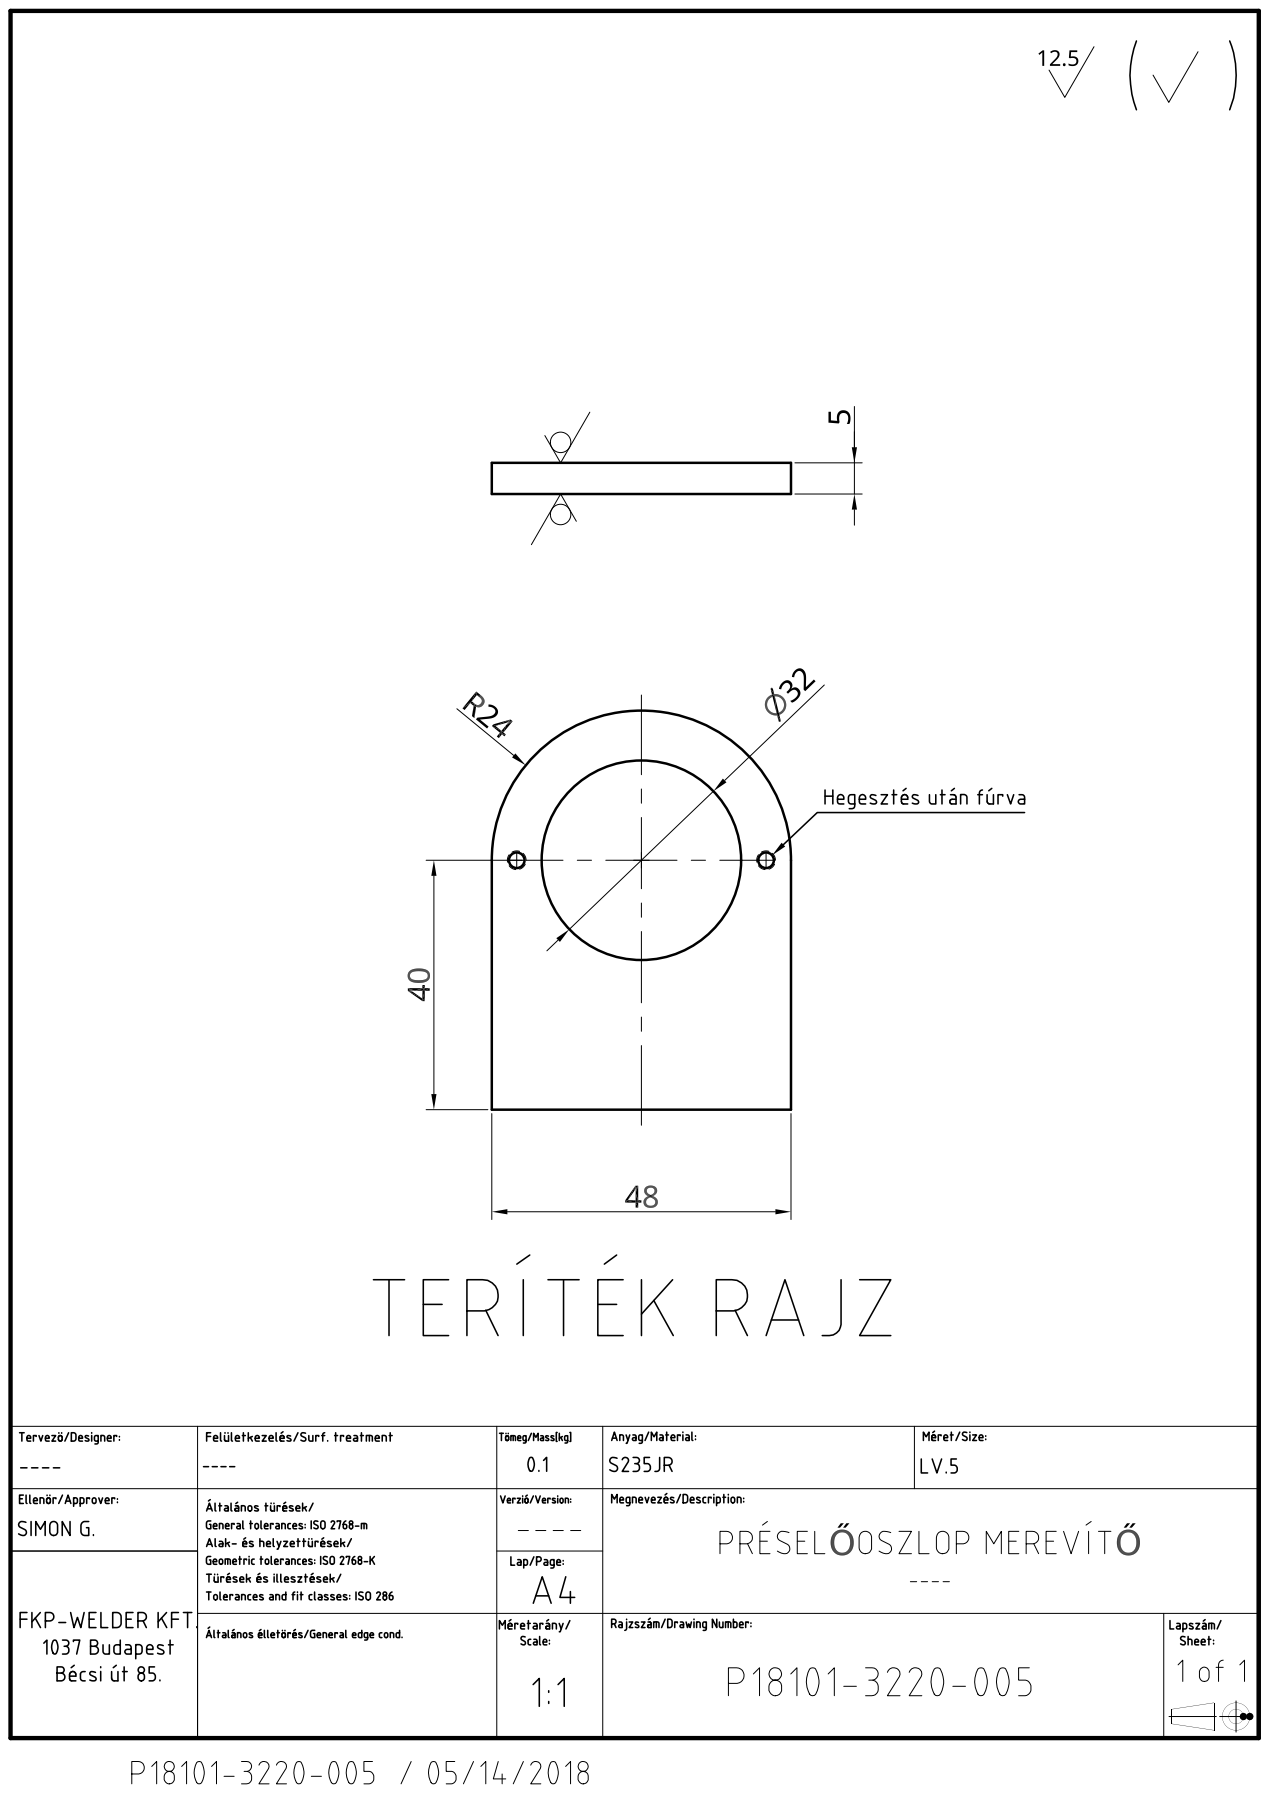
[picture p113: page 1]
