coderlazar/Metta-Pet/Tervrajzok/3200 - préselő uj dátumu rajzok/P18101-3210-000 préselő lap heg. mozgó.pdf

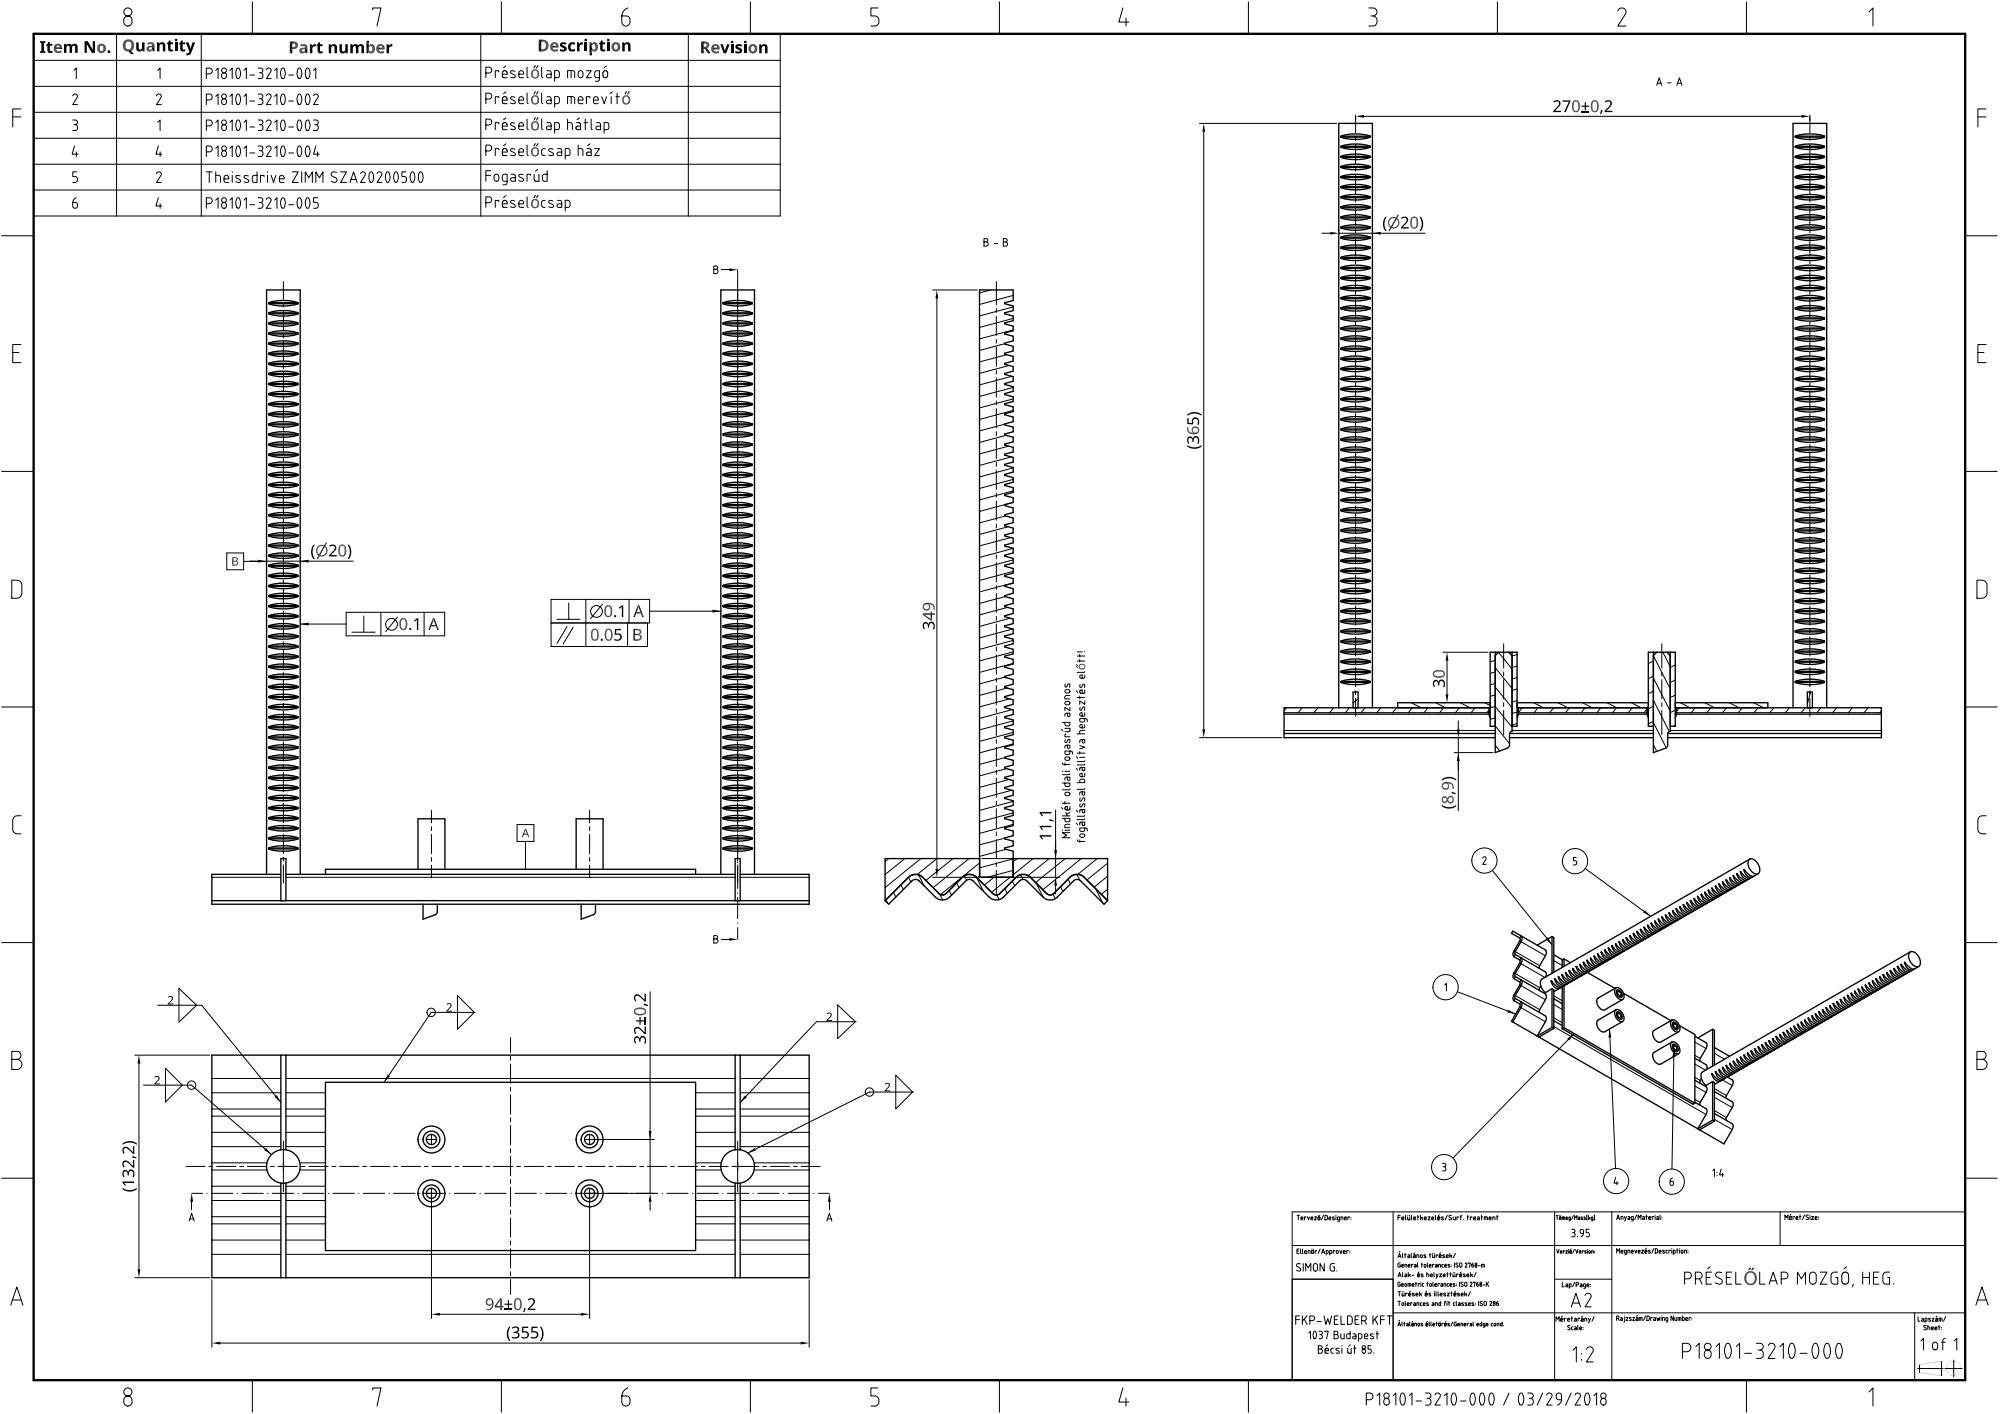
[picture p114: page 1]
