coderlazar/Metta-Pet/Tervrajzok/3200 - préselő uj dátumu rajzok/P18101-3210-001 préselő lap mozgó.pdf

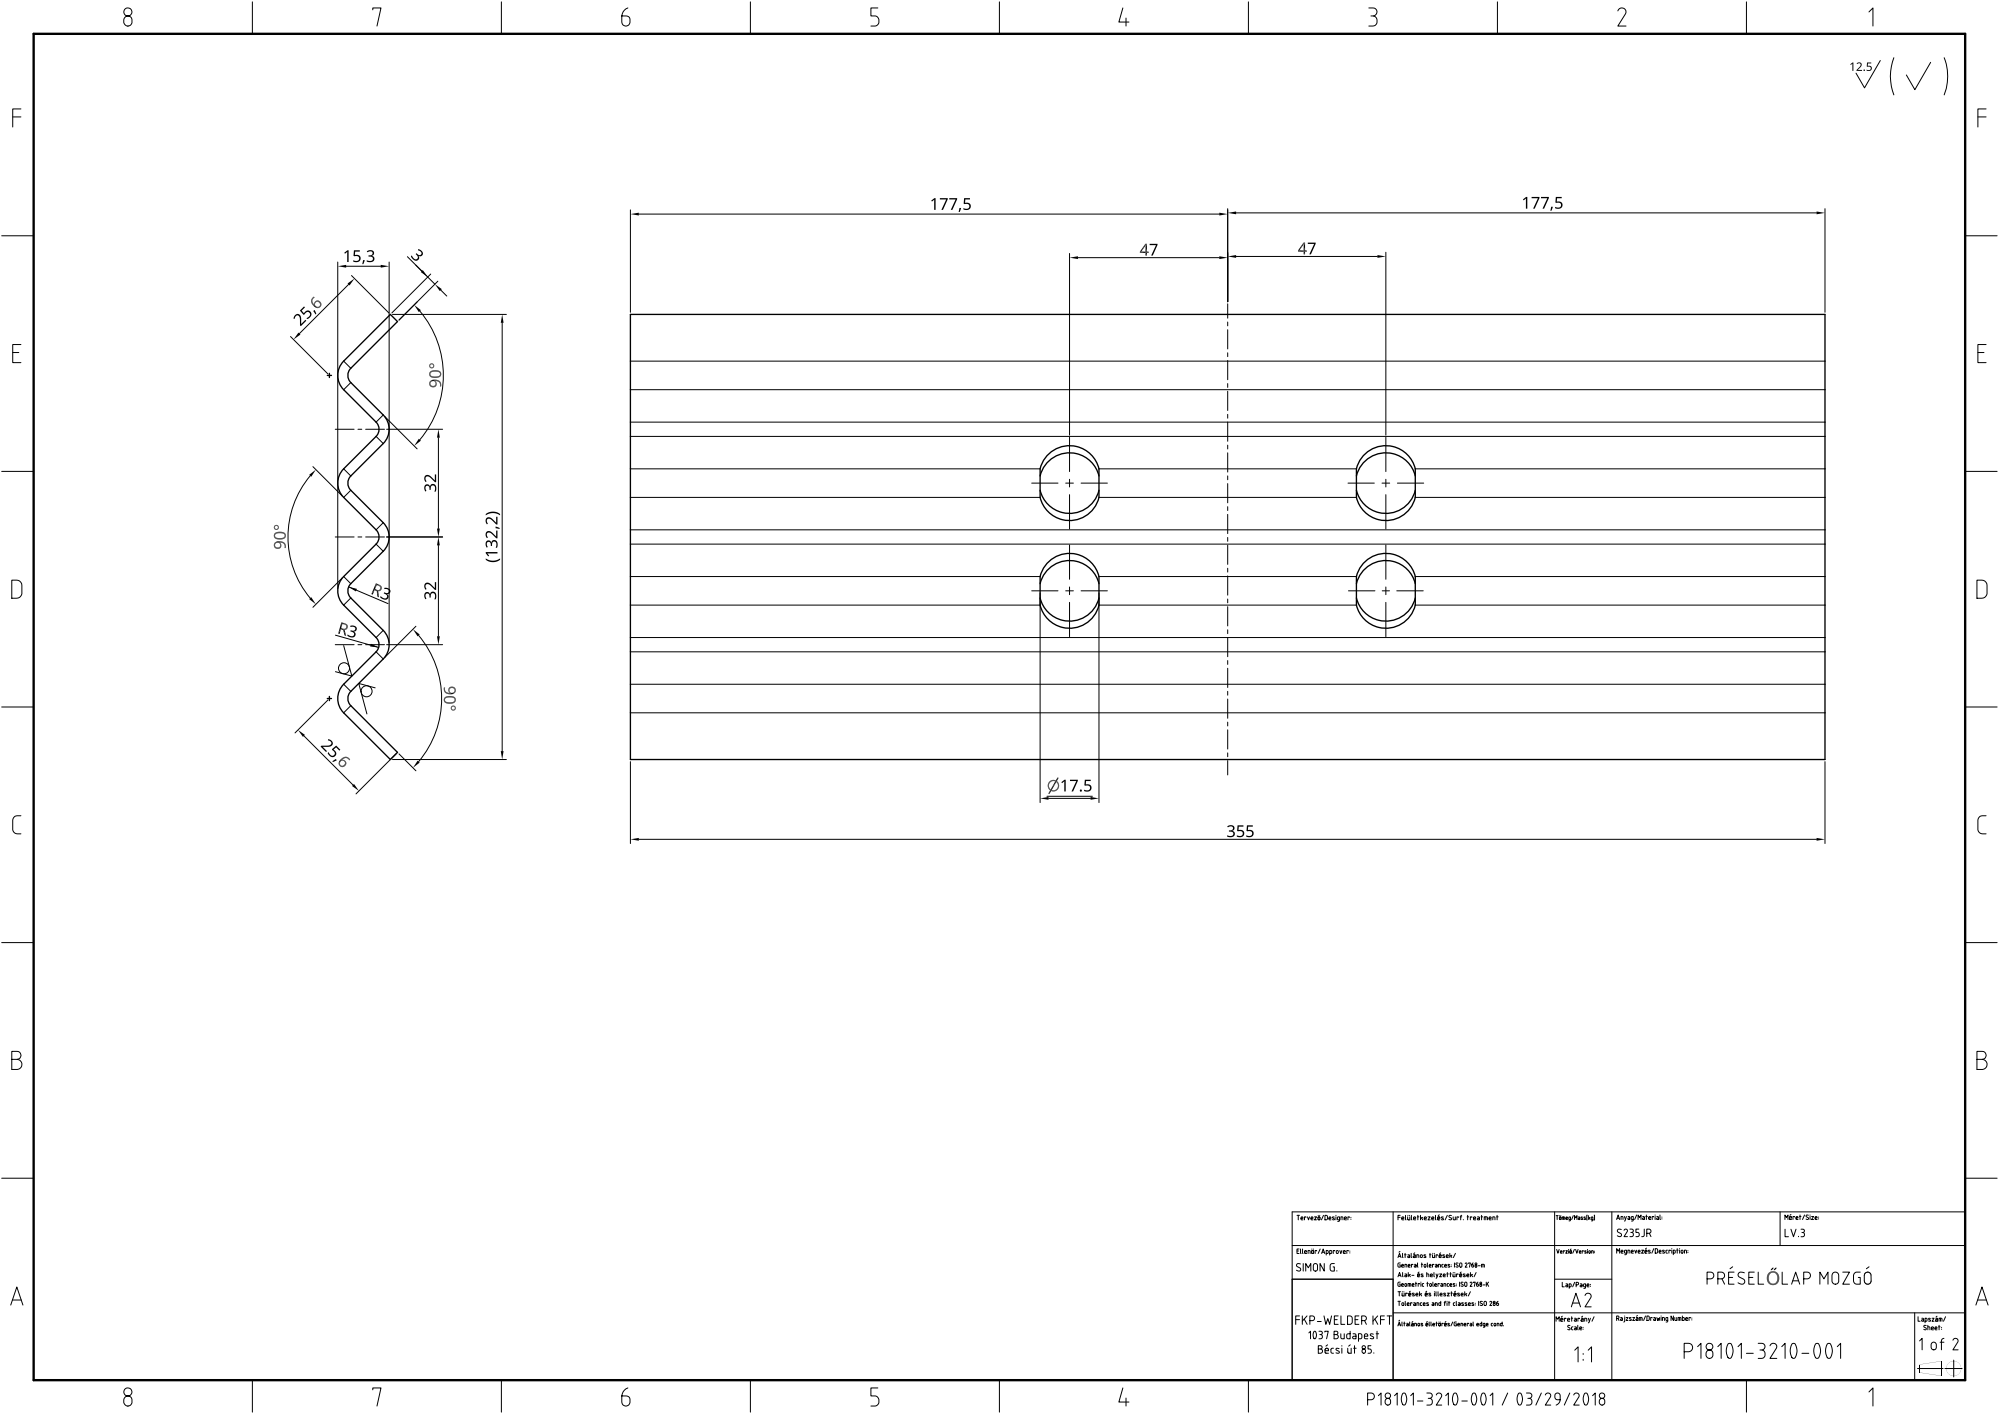
[picture p115: page 1]
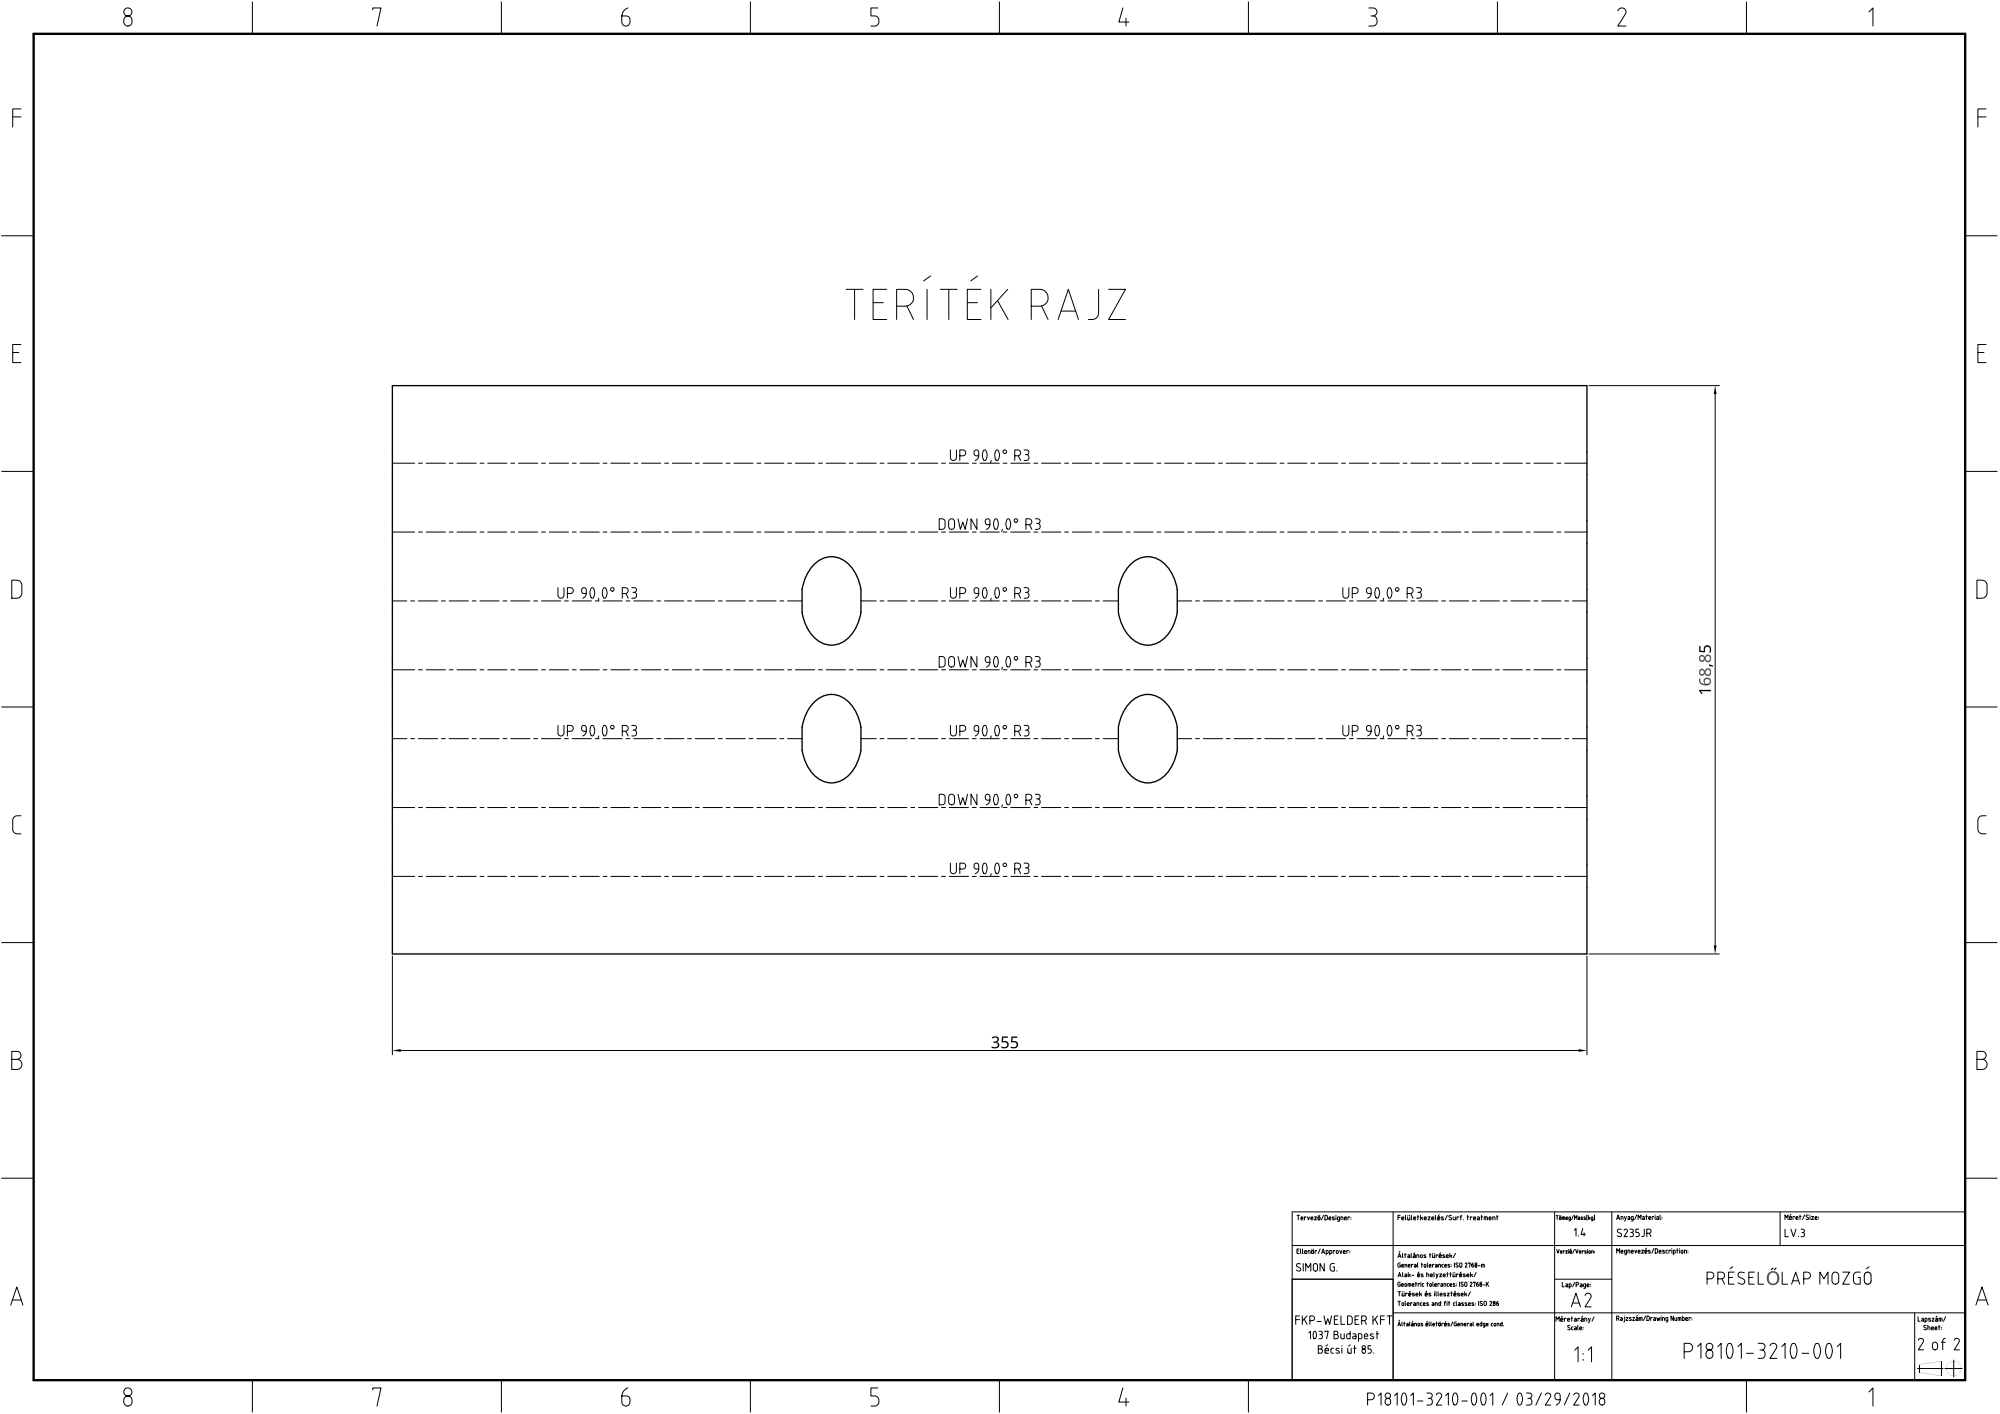
[picture p116: page 2]
