coderlazar/Metta-Pet/Tervrajzok/3200 - préselő uj dátumu rajzok/P18101-3210-003 préselő lap hátlap.pdf

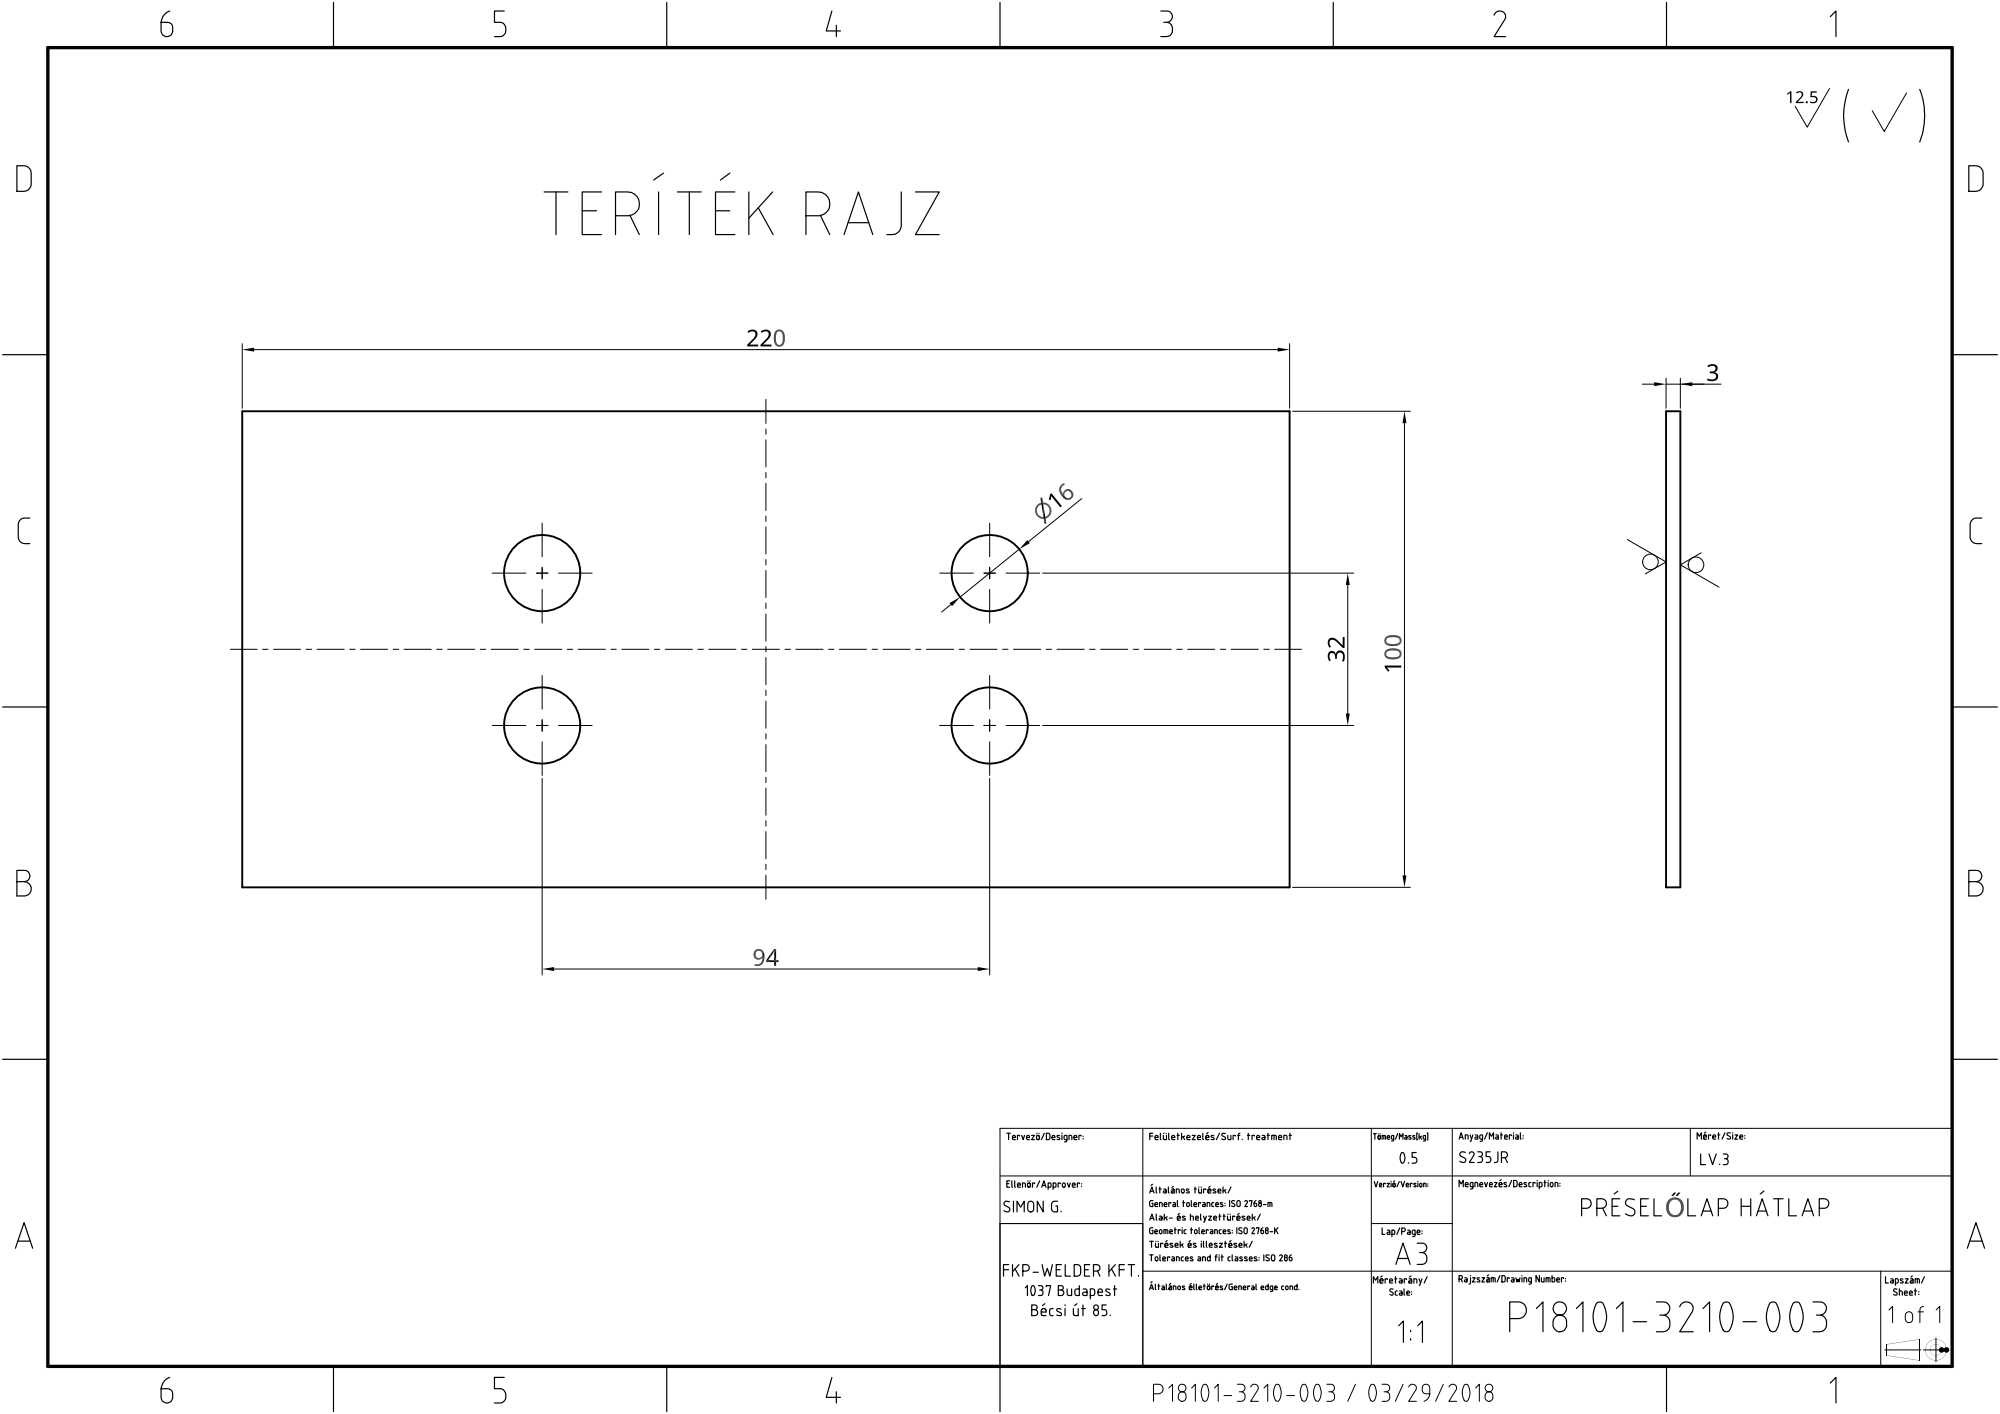
[picture p117: page 1]
