coderlazar/Metta-Pet/Tervrajzok/3200 - préselő uj dátumu rajzok/P18101-3210-004 préselő csap ház.pdf

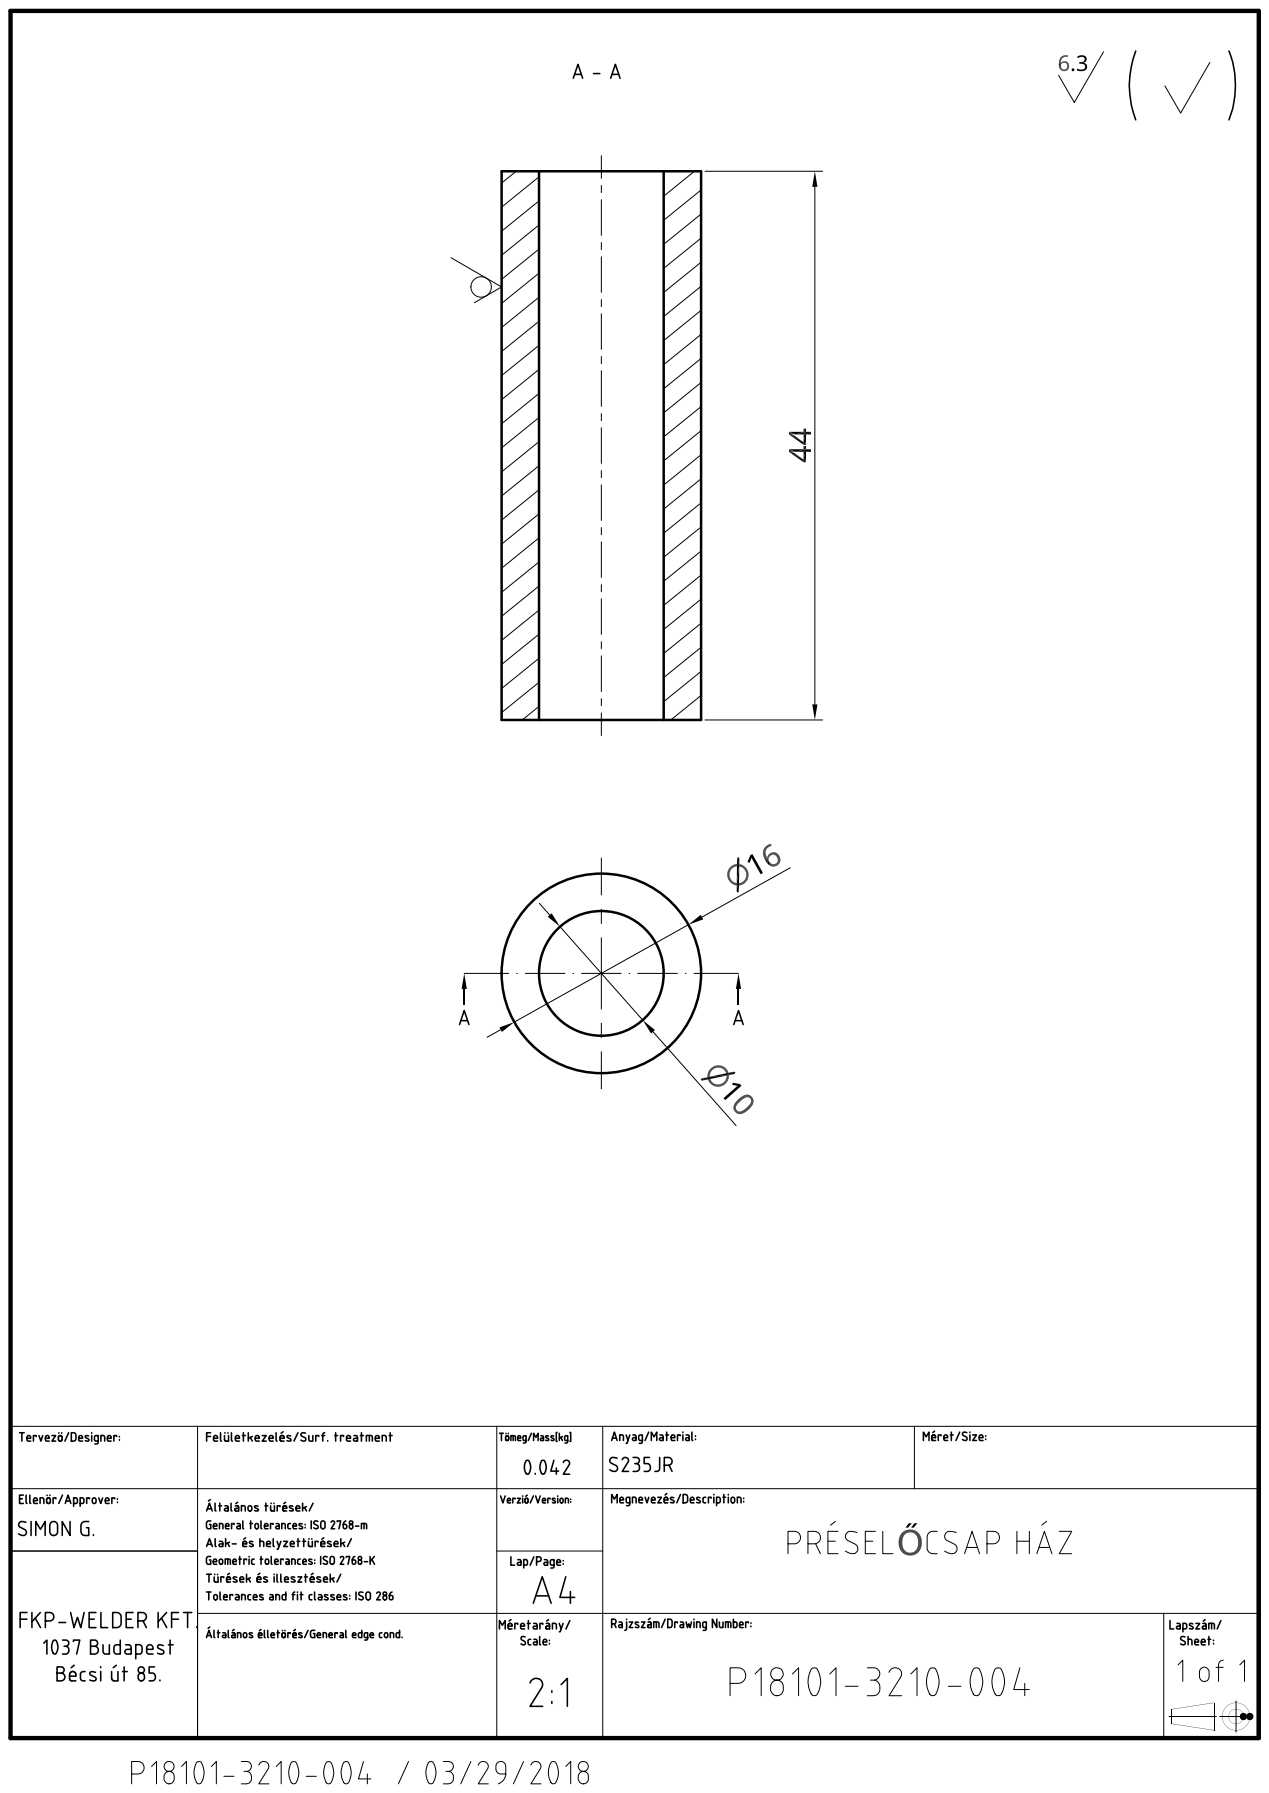
[picture p118: page 1]
