coderlazar/Metta-Pet/Tervrajzok/3200 - préselő uj dátumu rajzok/P18101-3210-005 préselő csap.pdf

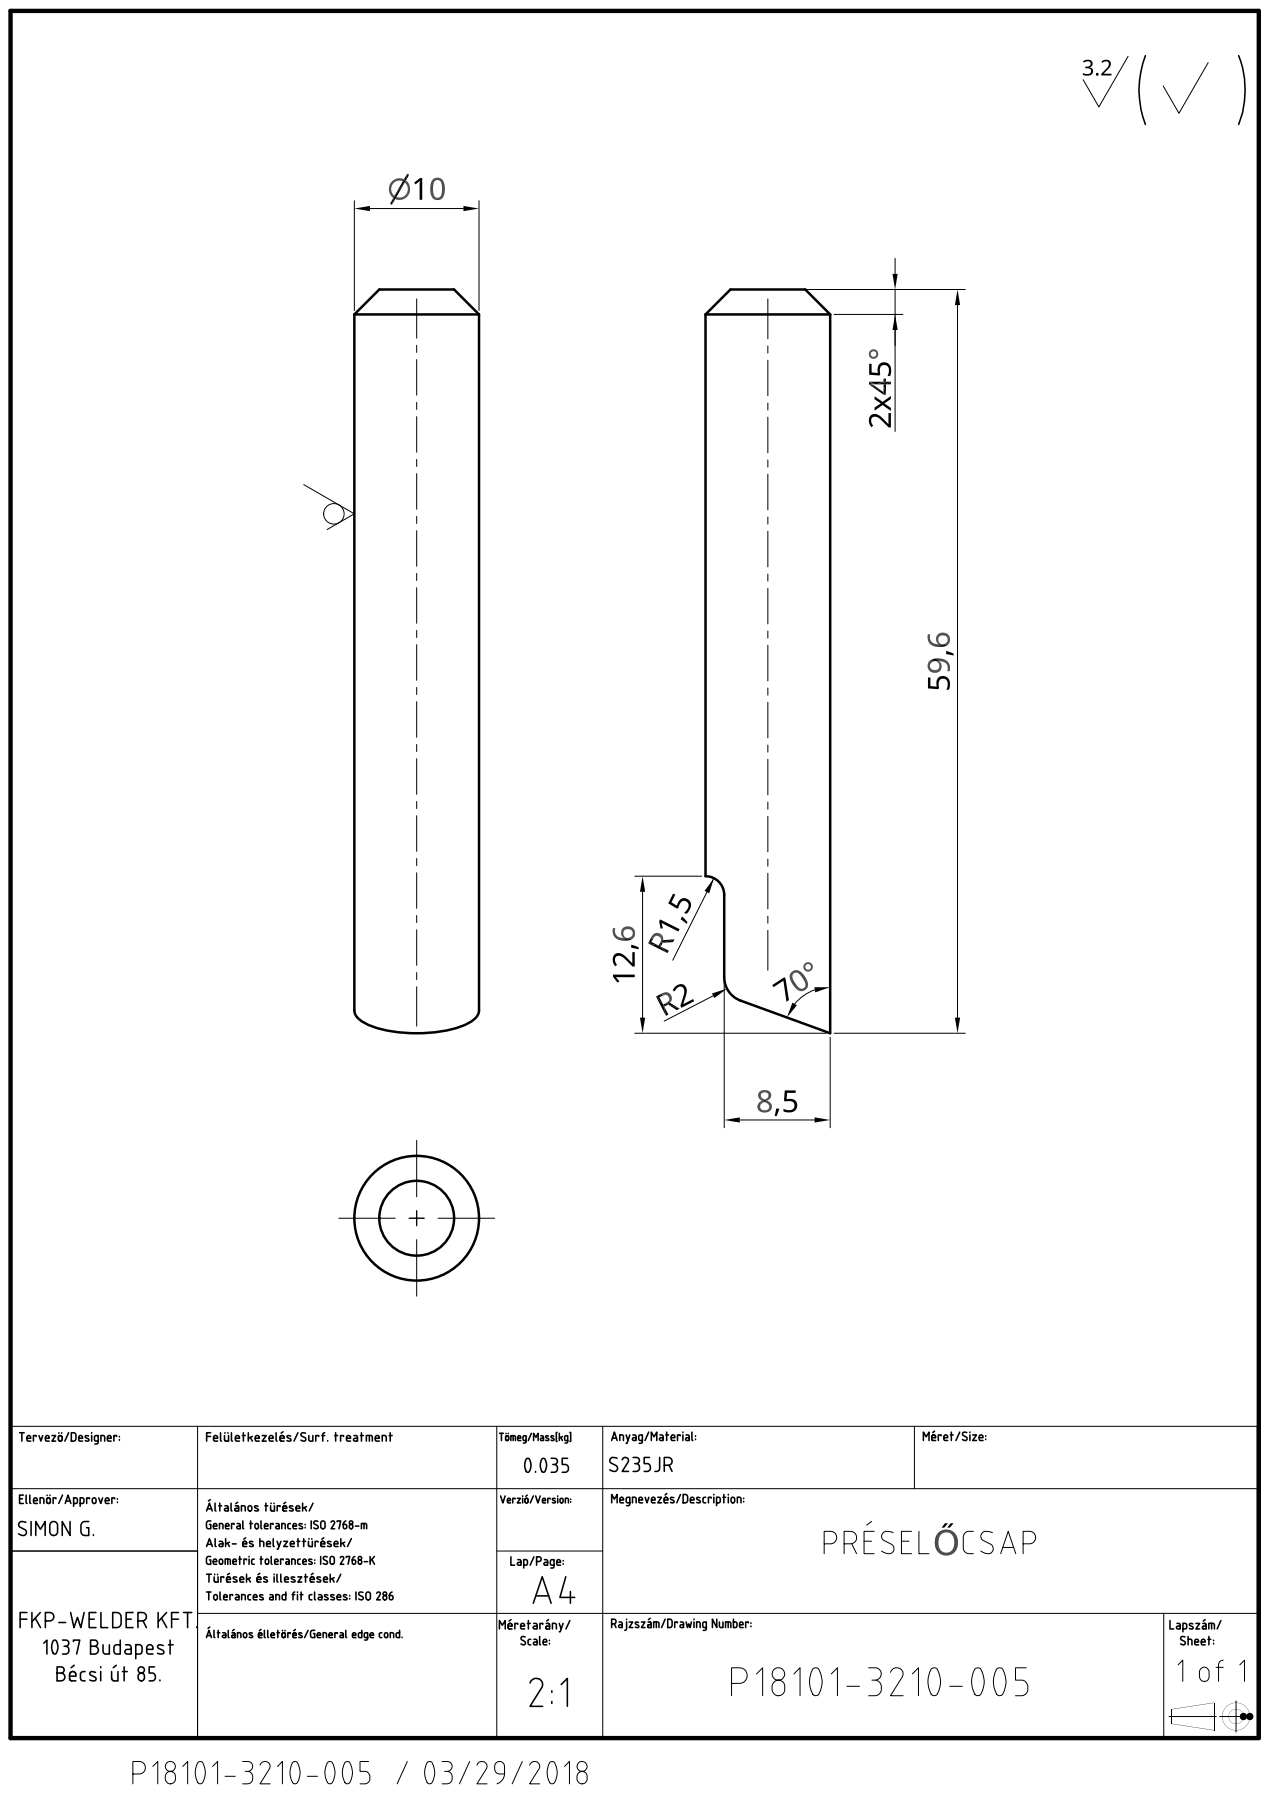
[picture p119: page 1]
