coderlazar/Metta-Pet/Tervrajzok/3200 - préselő uj dátumu rajzok/P18101-3220-000 préselő alapváz.pdf

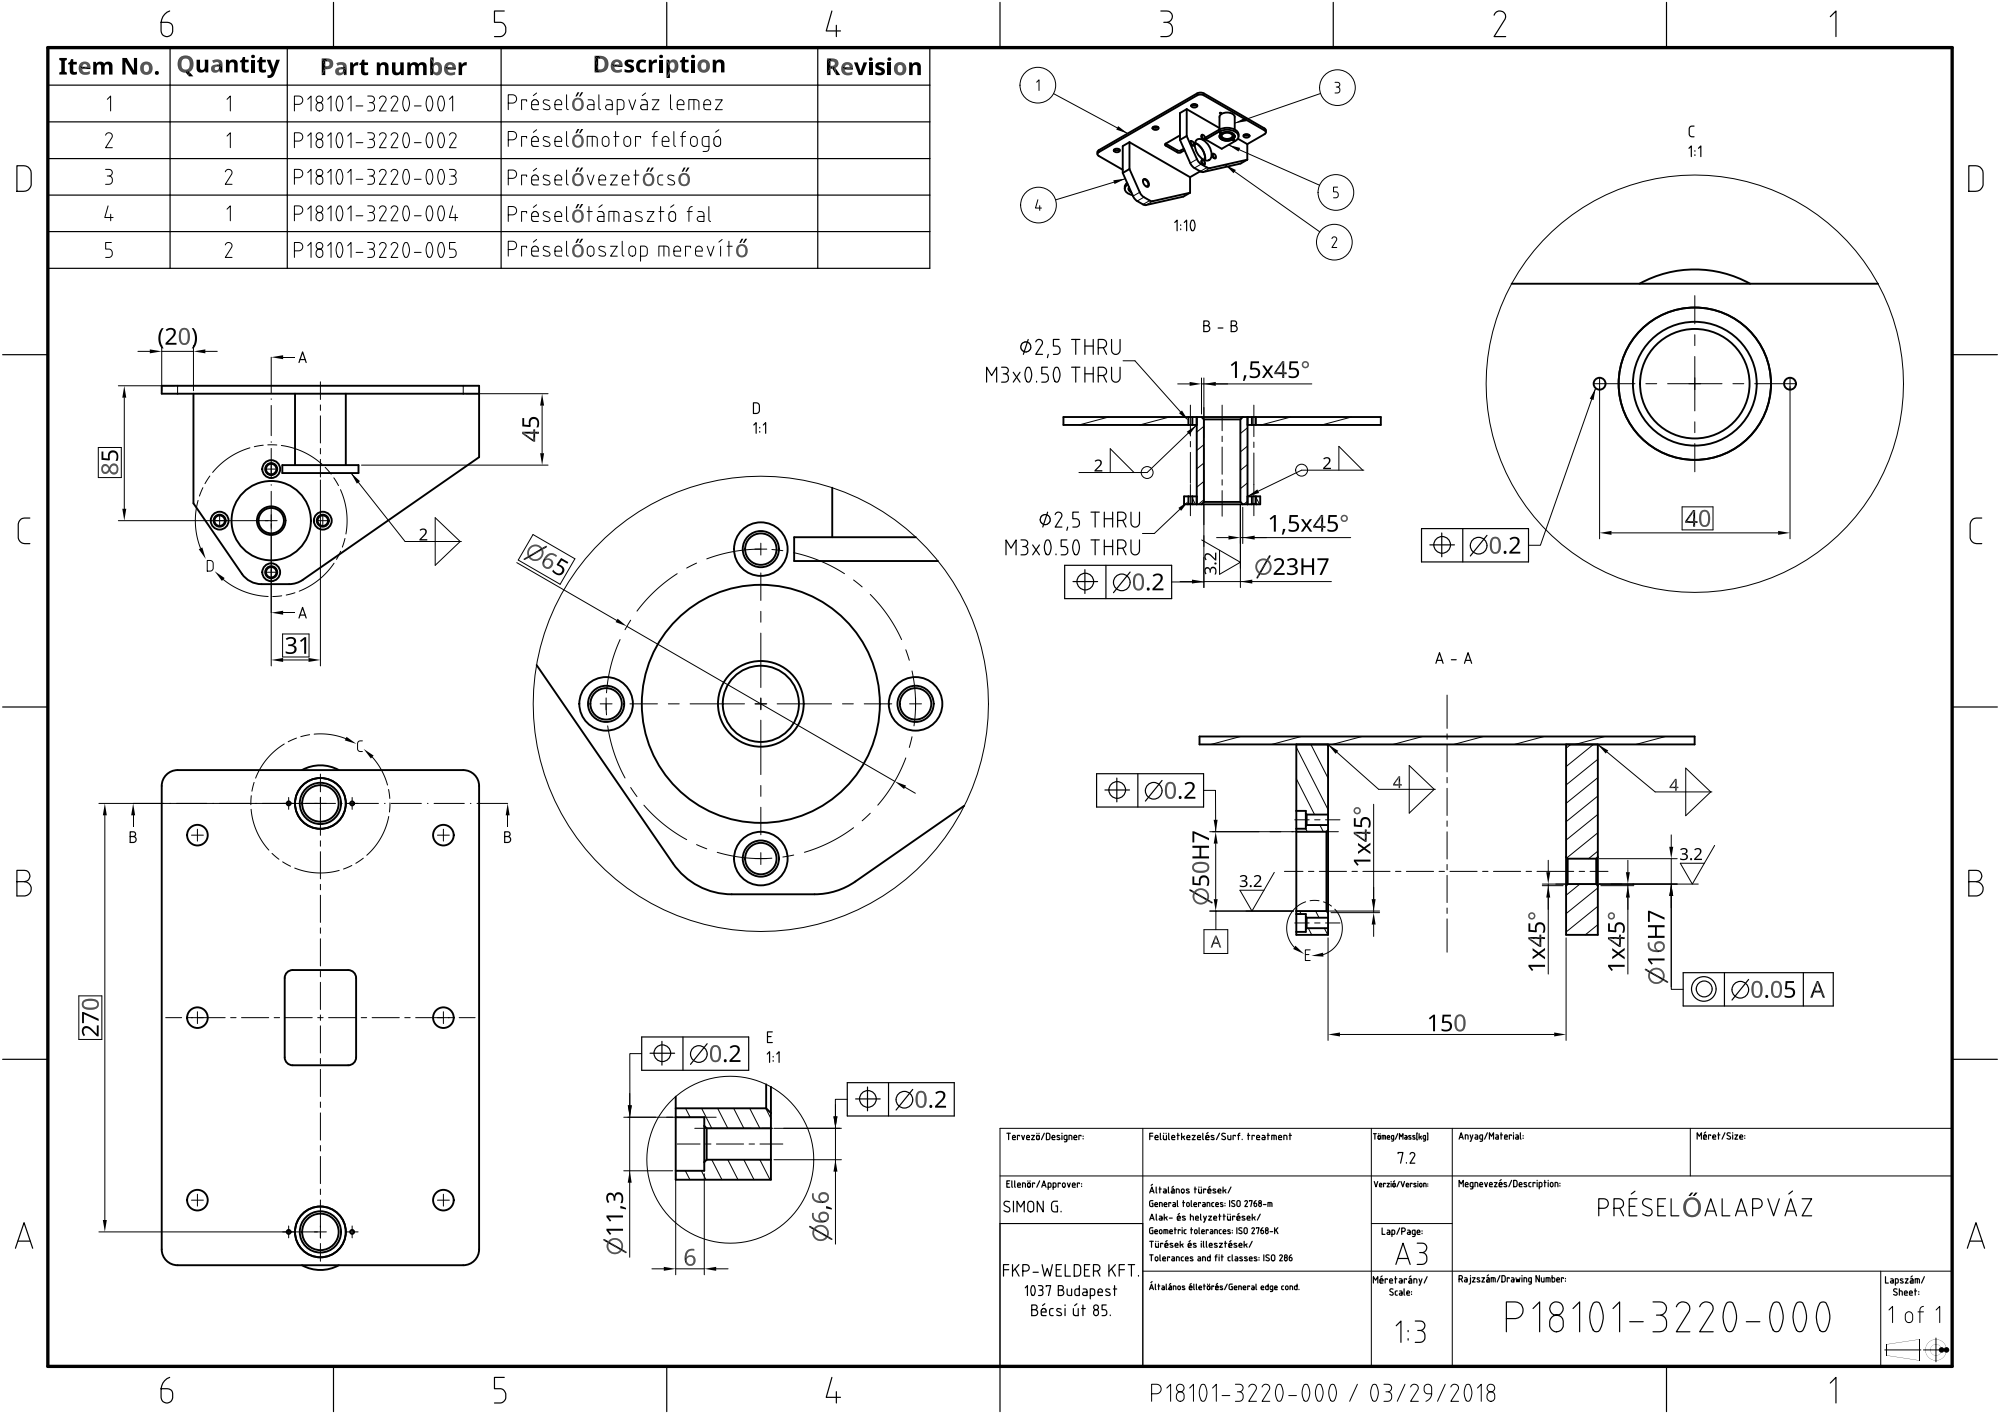
[picture p120: page 1]
