coderlazar/Metta-Pet/Tervrajzok/3200 - préselő uj dátumu rajzok/P18101-3220-001 préselő alapváz lemez.pdf

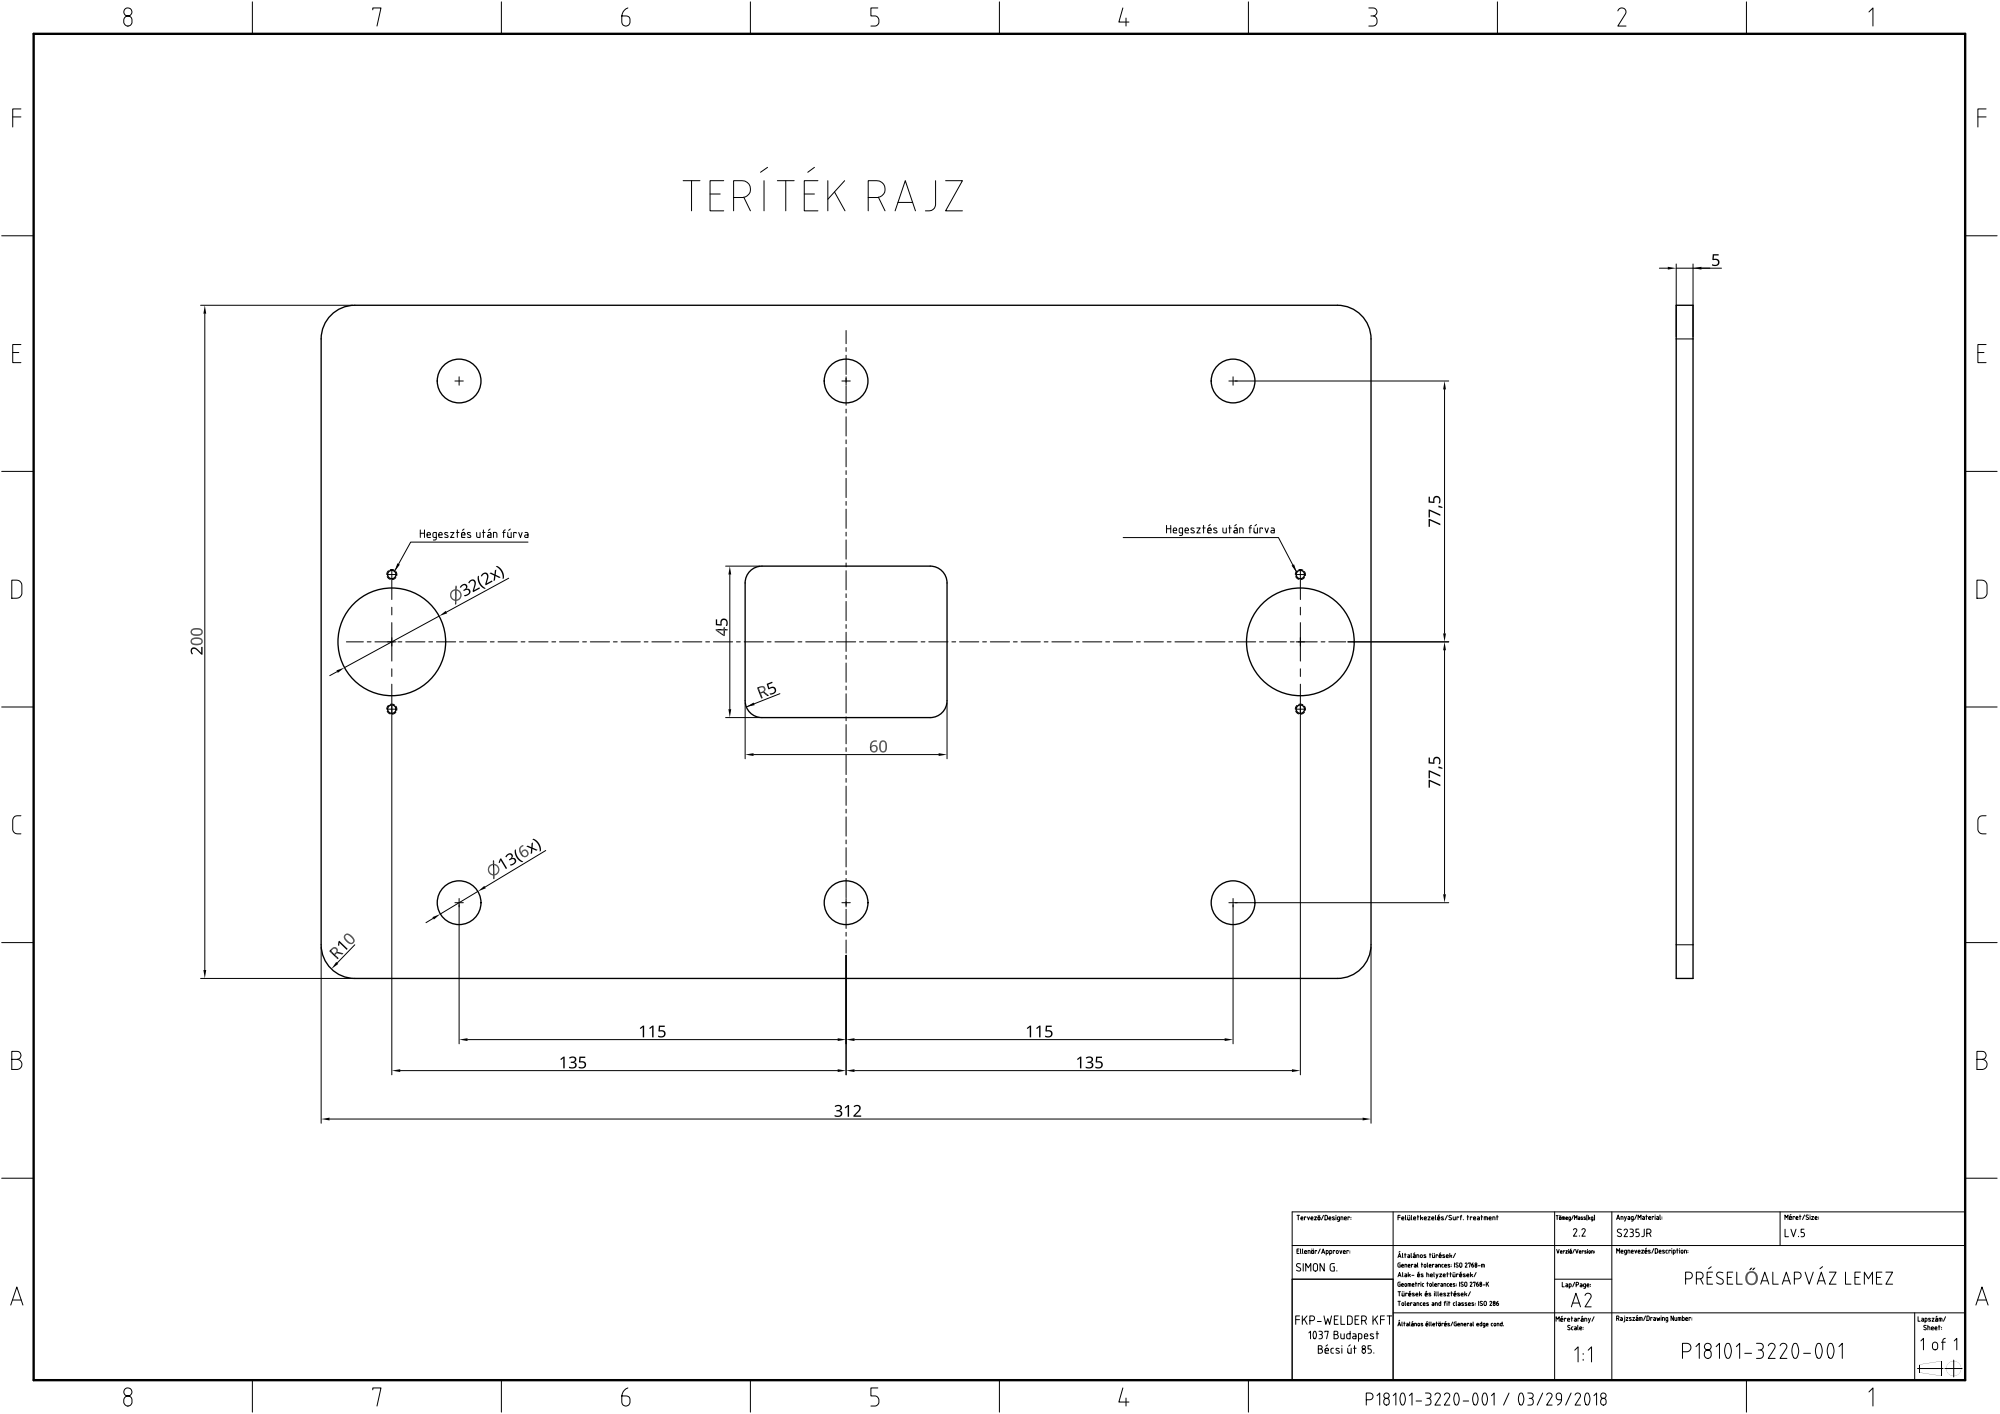
[picture p121: page 1]
