coderlazar/Metta-Pet/Tervrajzok/5000 - váz/P18101-6110-000_elsö_középsö_burkolat_ragasztott_összeállítás.step

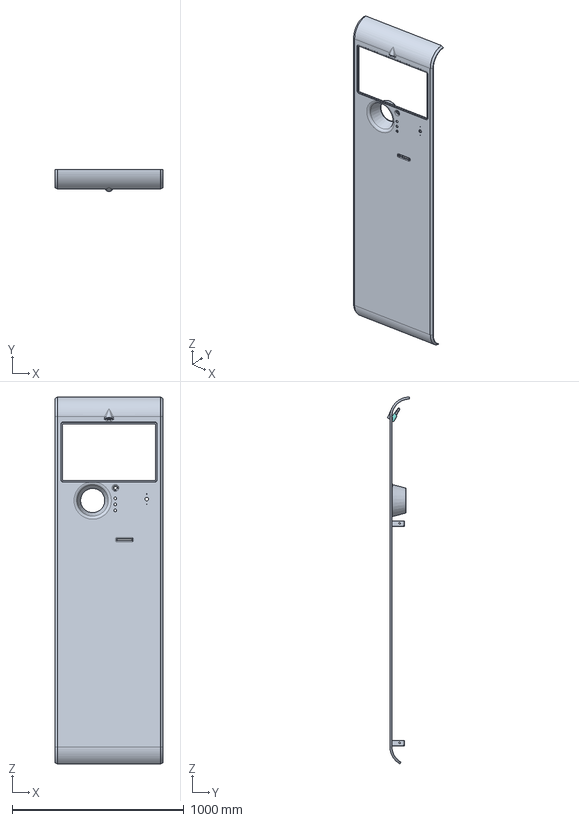
[picture p26: CAD file, 2023-06-21]
Tervrajzok/5000 - váz/P18101-6110-000_elsö_középsö_burkolat_ragasztott_összeállítás.step
630.0 x 127.6 x 2139.0 mm
P18101-6110-001_Elsö_középsö_burkolat
P18101-6110-002_Elsö_középsö_burkolat_konzol x 2
P18101-6110-007_Ragasztott_csavarozási_pont_2 x 4
P18101-6110-004_Kamera_ragasztott_konzol
P18101-6110-005_Nyomtató_konzol
P18101-6110-006_RFID_olvasó_konzol
P18101-6110-008_Mozgásérzékelö szenzor konzol
