coderlazar/Metta-Pet/Tervrajzok/1000 - palack azonositó/P18101-1210-003_merleg_rogzitolapFLAT.dxf

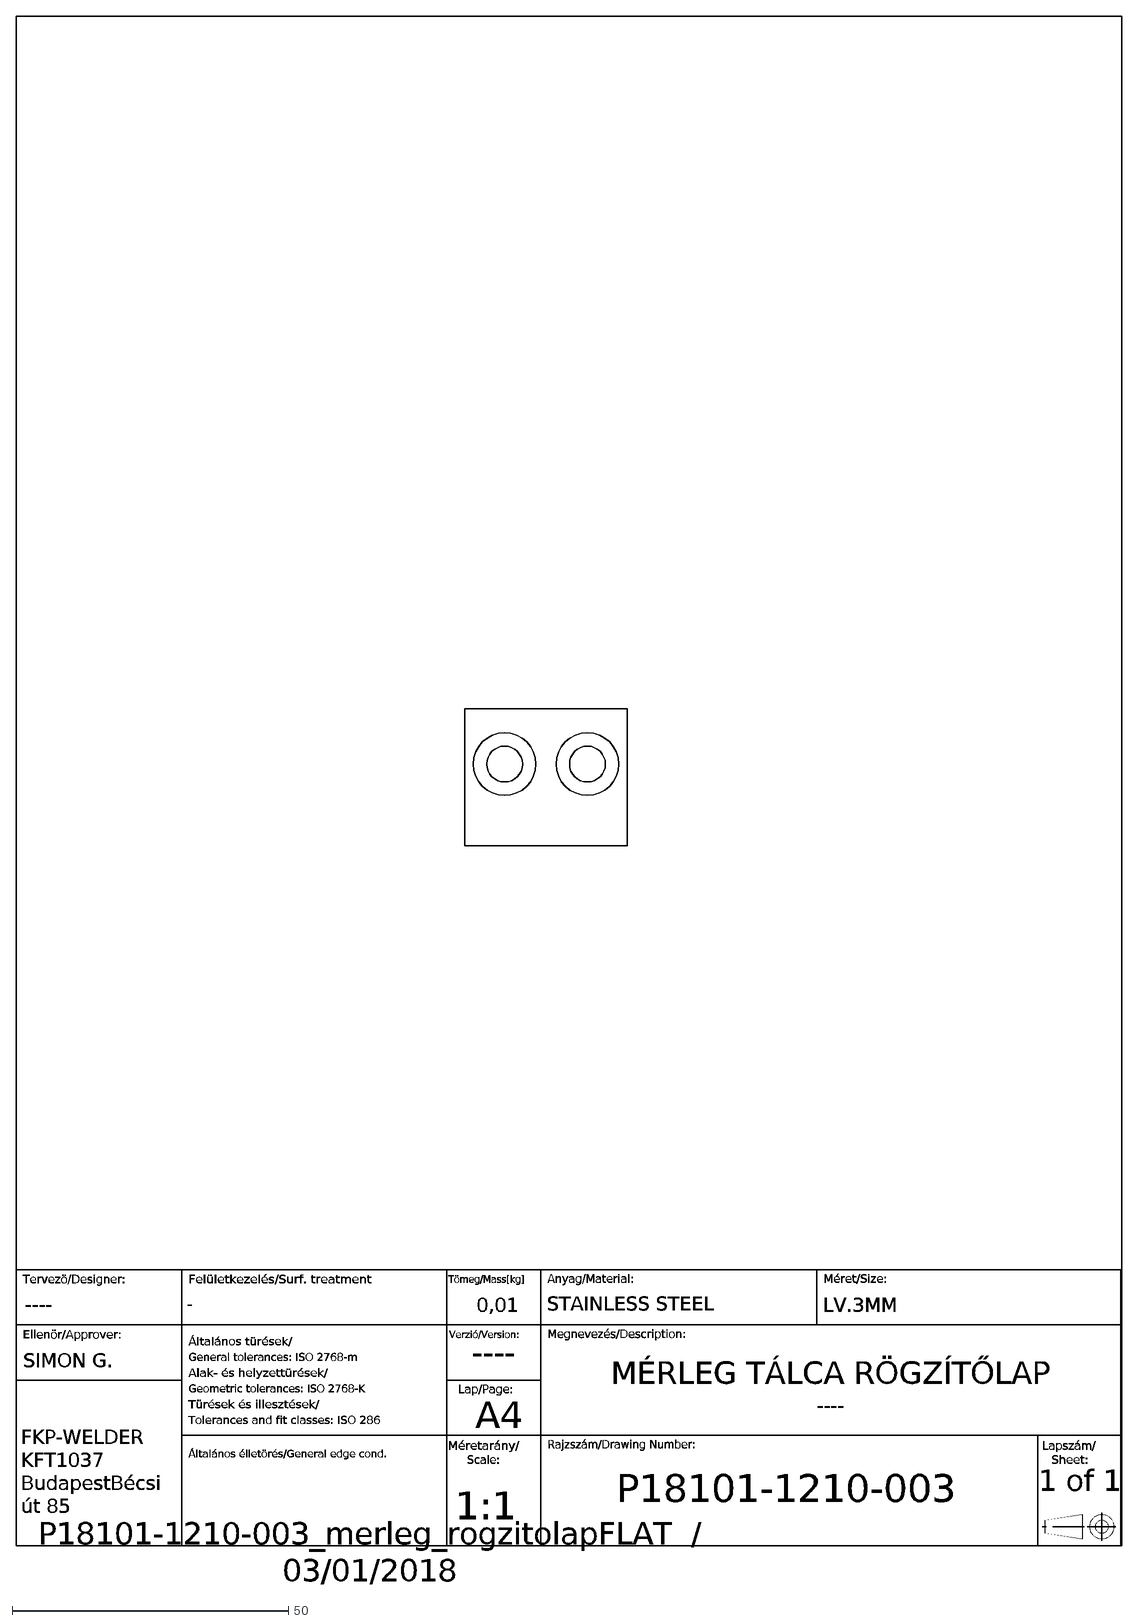
[picture p27: CAD file, 2023-06-21]
Tervrajzok/1000 - palack azonositó/P18101-1210-003_merleg_rogzitolapFLAT.dxf
Általános élletörés/General edge cond.
Méretarány/
Scale:
Lapszám/
Sheet:
Rajzszám/Drawing Number:
Általános türések/
General tolerances: ISO 2768-m
Alak- és helyzettürések/
Geometric tolerances: ISO 2768-K
Türések és illesztések/
Tolerances and fit classes: ISO 286
Lap/Page:
Ellenör/Approver:
Verzió/Version:
Megnevezés/Description:
Tervezö/Designer:
Felületkezelés/Surf. treatment
Tömeg/Mass[kg]
Anyag/Material:
Méret/Size:
A4
----
MÉRLEG TÁLCA RÖGZÍTŐLAP ----
P18101-1210-003
1 of 1
P18101-1210-003_merleg_rogzitolapFLAT / 03/01/2018
SIMON G.
-
STAINLESS STEEL
LV.3MM
1:1
0,01
FKP-WELDER KFT 1037 Budapest Bécsi út 85
