coderlazar/Metta-Pet/(list of files, cad)

Other CAD files:
Tervrajzok/1000 - palack azonositó/archív/P18101-1110-002_hossz_ellenorzo_veglapFLAT.dxf
Tervrajzok/1000 - palack azonositó/P18101-1300-004_fenykapu_plexiFLAT.dxf
Tervrajzok/5000 - váz/P18101-5000-013_Ledobás terelö lejtöFLAT.dxf
Tervrajzok/lézervágott alkatrészek nyomtatni/P18101-1100-001_hossz_ellenorzo_szenzor_konzolFLAT.dxf
Tervrajzok/1000 - palack azonositó/P18101-1300-006_beado_nyilas_ajto_szorito_lemezFLAT.dxf
Tervrajzok/5000 - váz/P18101-5000-008_Préselö egység tartóFLAT.dxf
Tervrajzok/1000 - palack azonositó/P18101-1300-002_beado_nyilas_ajtoFLAT.dxf
Tervrajzok/5000 - váz/P18101-5000-002_Emelö papucs hátsó merevitöFLAT.dxf
Tervrajzok/1000 - palack azonositó/P18101-1120-001_hossz_ellenorzo_konzol_lemezFLAT.dxf
Tervrajzok/1000 - palack azonositó/P18101-1200-001_merleg_alaplemezFLAT.dxf
Tervrajzok/5000 - váz/P18101-5000-003_Padló lemez balFLAT.dxf
Tervrajzok/1000 - palack azonositó/P18101-1210-002_talca_veglapFLAT.dxf
Tervrajzok/5000 - váz/P18101-5000-007_Padló lemez középsöFLAT.dxf
Tervrajzok/1000 - palack azonositó/P18101-1300-003_fenykapu_lemezFLAT.dxf
Tervrajzok/5000 - váz/P18101-5000-009_Elektronikai alaktrész tartó 1FLAT.dxf
Tervrajzok/5000 - váz/P18101-5000-007_Préselö egység merevítöFLAT.dxf
Tervrajzok/1000 - palack azonositó/P18101-1210-001_talca_felsoFLAT.dxf
Tervrajzok/5000 - váz/P18101-5000-001_Emelö papucs elsö merevitöFLAT.dxf
Tervrajzok/5000 - váz/P18101-5000-006_Emelö papucsFLAT.dxf
Tervrajzok/5000 - váz/P18101-5000-011_Ajtó tartó konzolFLAT.dxf
